chris01-byte/HomeMy/hardware/power-management-unit/REV_A_ASSUMPTIONS.md

# PMU Revision A assumptions and adjustable settings

`rev_a_engineering_prototype: true`  
`rev_b_production: false`  
Date: 2026-09-10. Values below are prototype choices and analytical limits. No assembled-board measurements, completed CAD checks or unrestricted power rating are asserted.

[requirements.yaml](requirements.yaml) controls scope and status. [Traceability](REQUIREMENTS_TRACEABILITY.md) maps all IDs; [bring-up](DESIGN_REVIEW_AND_BRINGUP.md) separates initial low-energy fixtures from later tests; [Revision-B validation](REV_B_VALIDATION.md) identifies production decisions. Numerical details and primary sources remain in the [power](rev-a/design/POWER_STAGE.md), [wake](rev-a/design/WAKE_IO.md) and [chopper](rev-a/design/CHOPPER_MECHANICS.md) design records.

## Settings, adjustment and probe access

| ID / requirements | Initial choice and explicit limitation | Adjustment / probe access / follow-up |
| --- | --- | --- |
| A01 — BAT-001/002, SW-001 | Source contract 27.5–42 V, 50 A maximum continuous; 45 A normal software ceiling. Advertised 150 A/1–3 s is a survival case. Initial main fixture is ≤1 A, 20–30 °C, ≤42 V and ≤100 µF directly switched SYS capacitance, motion OFF. | Probe BATT_SENSED_P, SYS_BUS_P and both true Kelvin pairs. Raise limits only after lower-energy captures are reviewed; B01/B07. |
| A02 — MAIN-003 | Main UV is native **fast** protection, not the requested provisional 0.5 s UV delay. Falling 29.03 V nominal, 27.97–30.41 V calculation; rising 31.67 V nominal, 30.71–33.42 V. New button action still required. | Replace U1 UV divider values only after recalculating reference/leakage corners; probe MAIN_FAULT_N, AON_WAKE_EN and SYS_BUS_P. Add precision/timed UV circuitry in a later revision if the complete requested interval/delay is necessary. |
| A03 — MAIN-003, MOT-001 | Main OV is 44.52 V nominal, 43.17–46.98 V calculated, **not guaranteed 44–45 V**. Motion native OV is unused because it auto-recovers; independent chopper ~46 V comparator latches motion. U5 independent SYS UV uses 226 kΩ / 10 kΩ: 29.311 V nominal and 27.891–30.734 V static engineering envelope. It captures sustained SYS dips missed by native fault flags. | Replace voltage-divider resistors and retest edges. Probe MAIN_FAULT_N, MOTION_FLT_N, CHOP_FAULT_N and motion latch Q. U5 shallow/short pulse capture needs measurement; no universal pulse-width guarantee is claimed. |
| A04 — MAIN-003, MOT-004 | Main OC 65.09 A nominal equation has no justified guaranteed error interval; its 32.5 mV shunt level exceeds the published 6–30 mV CSA accuracy table. Motion OC 59.95 A, 57.13–64.41 A calculation. Main/motion SCP ~120/~100 A with broad corners. Two 33 µF film timers with 100 kΩ latch resistors give FLT-controlled disconnect windows 0.330–0.769 s main and 0.350–0.675 s motion, conditional on 0–60 °C and ≤1 µA combined leakage. | Replace programming resistors/film capacitors; never infer long delay by linear scaling a short example. Probe both TMR pins and controller FLTs. Verify leakage, actual delays and overlap before load escalation; B07. |
| A05 — MAIN-002, MOT-002, TOP-004 | Q1–Q10 PSMN1R0-100ASFJ hot table requires 10 V gate. Main DGATE can be only 9.2 V; 3.2 mΩ/die is a sizing assumption, not a manufacturer maximum. **Final initial motion R34 is 180 kΩ**, superseding 10 kΩ and the interim 100 kΩ; each motion gate bleed is 10 MΩ. Gate-charge slew arithmetic is not a guaranteed inrush bound. | R34 is replaceable; lower resistance requires fresh current/SOA analysis, not an assumed benefit. Probe PU, gate-to-source, BST−SRC, VDS and shunt current. D3 must disposition hot-drive proof; B01 determines final slew/no-precharge decision. |
| A06 — CHOP-002 | Two RH10010R00FE01 on separate 305 × 305 × 3.2 mm aluminum plates; 5 Ω bank. Manufacturer five-times-power/five-second overload evidence supports a bounded cold starting case, not a repetitive braking curve. After lower-energy stages pass, maximum initial test is **500 J total**, ≥60 s between pulses and both cases <40 °C before each pulse. | Integrate measured resistor voltage × current; monitor both cases and analog sensor. Increase energy/duty only with new thermal/pulse evidence; B03. The 8.6 A/370 W value at 43 V is instantaneous. |
| A07 — CHOP-003/004 | Analog 43.000 V on / 42.402 V off; independent 46.000 V motion fault. Corner ranges are 42.683–43.316, 42.072–42.733 and 45.663–46.339 V. Analog NTC trips near 84 °C with ~±4 °C electrical uncertainty plus mounting lag; open/short faults. Local board limit 70 °C; reference qualification 12–28 ms. | Replace R303 initially 1.40 kΩ within reviewed 0–3 kΩ range; feedback R305/R306/R331 initially 2.69 MΩ within 2.32–3.01 MΩ; R308 OV correction. Probe CHOP_GATE, CHOP_NTC, CHOP_FAULT_N/ACTIVE_N. Recalculate correlated hysteresis after each change. |
| A08 — CHOP-002/003, TOP-004 | C312/C313 each EKYC101ELL471MK35S, 470 µF/100 V; **940 µF populated**, initial tolerance 752–1128 µF. At 42 V, 0.829 J nominal / 0.995 J maximum stored energy. Minimum-C/minimum-hysteresis model gives ~5.36 kHz, not an imposed frequency limit. Each capacitor's 2.805 A rating after 1 kHz factor exceeds the modeled balanced 2.323 A share; real sharing/ESR remain unknown. | Do not include this bulk in the ≤100 µF main fixture: keep motion OFF. Charge the isolated motion bus from a separate current-limited fixture for first analog tests. Measure capacitance, ripple, ESR, frequency and motion inrush before joined testing. R332 22 kΩ bleed predicts ≤53.35 s from 42 to 5 V initially; always measure residual voltage. |
| A09 — PC-001/004, LOGIC-002, LIFT-003 | Exact external PC, 5 V and lift converters remain unspecified. PMU interfaces: J9 PC input, J10 logic input, J11 **regulated 5 V output back to board**, J8 lift input, J13 DNP 24 V output sample. PC planned 12 V/claimed 8–55 V input; logic 5 V/≥5 A; lift preferred 20–60 V to 24 V, 10 A label target but 4–5 A output planned. | Mechanically label and verify the actual module's terminals, polarity, voltage and isolation before connection. J8 expected input current is not its 24 V output current. Require local module documentation/bench records; B04/B05. A vendor label is not a datasheet proof. |
| A10 — PC-003, LOGIC-001 | U3 2.980 A nominal ILIM (6.04 kΩ), U4 1.980 A (9.09 kΩ), latch-off MODE, 22 nF slew. Conservative ±10% sizing envelope, but TPS26631 overload pulses can approach twice ILIM. No precise 65 W or rigid 3 A clamp is claimed. | Adjust ILIM and dVdT only after converter/harness captures. Probe PC_BUCK_IN_P and LOGIC_BUCK_IN_P with input current. Verify 65 W separately in Linux/BIOS; B05/B09. |
| A11 — CTRL-002/003 | AON nominal 3.343 V, modeled 3.193–3.499 V. 0.60 mA AON allowance is not measured OFF current. ONT ~174 ms; fixed startup grant 4.80–5.27 s model, firmware hold by 4.7 s / no-hold off by 5.4 s. Long press ~6.48 s nominal, provisional measured acceptance 4.1–9.5 s. Main FLT mask ~1–5.5 ms; native protection remains active. | Replace ONT/PDT/SET parts and repeat full button/state matrix. Probe PB, WAKE_RAW_EN, STARTUP_GRANT, WAKE_KILL, AON_WAKE_EN, SW_RESET_N. Capacitor effective value and propagation races require measurement; B10. |
| A12 — PCB-001/002/004 | Bench outline 360 × 300 mm; H1–H4 at (8, 8), (352, 8), (292, 292), (8, 292) mm, with H3 moved away from the antenna. Final CAD controls coordinates. Minimum finished copper is 70/35/35/70 µm; finished board thickness is 1.60–1.70 mm between outer copper faces, excluding masks. Exact 2 mm Cu-ETP BB1–BB7 contours, 15 BC contacts, NB1–NB8 star bridges and insulation/clamp stack are defined in [the mechanical interface](rev-a/manufacturing/busbar-pcb-interface.json) and [build drawing](rev-a/manufacturing/MECHANICAL_BUILD.md), superseding the generic 15 × 2 mm / ≤100 mm segment assumption. BB7 spans 348 mm with cutouts. | D4 compares actual layout, holes, bar contours and stackup. Split copper at shunts, opposing FET banks and bus boundaries. [via-field-counts.json](rev-a/design/via-field-counts.json) controls the generated field counts; the [filled-copper review](rev-a/evidence/filled-power-copper-review.md) uses those counts for ideal parallel-barrel calculations. Neither field totals nor the earlier 160-via example establish sharing at a local transfer. Local necks, hole constrictions, sharing, clamp coupons, temperature and resistance still require their defined acceptance; bar resistance alone does not rate the board. Final enclosure, airflow and guards remain B12. |
| A13 — PCB-003/005/006 | Würth 7461103 right-angle M5 threaded terminals for battery/arms: body 14 mm above PCB, with horizontal M5 screw/lug access. Battery 6 mm², arms 4 mm²; 25 A per arm planning envelope. Chopper J12 uses 12 A Phoenix 1776508/1777989 and 1.5 mm² wire. Bulk capacitors reach 36.5 mm maximum and film timers 24 mm. Reserve at least 42 mm from PCB top to the provisional cover and keep capacitor vents clear. | Fabricator must qualify press-fit holes/plating; use the approved insertion method, ≤2.2 Nm tightening and covers. Exact ring lugs/crimps, strain relief and final mating/keying remain assembly review. Measure terminal/wire temperatures; B06/B12. |
| A14 — CTRL-005 | J22 commissioning input is 3.3 V logic or a deenergized-open relay contact between pins 1/2, ground pin 3. Open/low/unpowered clears motion. It is a single-channel prototype permission, not an accepted final emergency stop. J20/J22 pin-header prototype connectors require retained, labelled bench harnesses. | Do not apply 24 V or fit a permanent bypass jumper for actuator operation. Probe MOTION_PERMIT and MOTION_CLEAR_N. Final fail-safe/stop architecture B14; reachable disconnect remains mandatory for authorized actuator tests. |
| A15 — CTRL-001, LOGIC-002 | U10 ESP32-S3-WROOM-1-N8; UART through U65, no supply pin. U12 3.3 V LDO: 0.5 A allowance dissipates ~0.85 W and ~53.5 °C reference-board rise. 1 A IC rating is not an assembled continuous rating. | J11 supply 4.75–5.25 V; maximum recommended LDO input 5.5 V. Measure regulator/module voltage and temperature; update copper/architecture if insufficient. |
| A16 — SW-001/002/003, CTRL-004 | Current/voltage policy remains as requirements; Linux boot deadline 120 s, shutdown grace 90 s, heartbeat 100 ms / stale 500 ms are suggested firmware parameters. TPS3431 independently removes motion on absent ESP feed in 1.36–1.84 s. LED patterns follow lifecycle contract. | These are interface settings, not deployed firmware. Feed watchdog only from supervised main loop after valid heartbeat. T7/B09 fault-injection and versioned configuration; retain development boot-target rollback. |
| A17 — MON-003/004 | INA ±163.84 mV, independent 10 Ω filters. ADC voltage divider full loaded gain 1/23; motion IMON complete-network sensitivity ~10.465 mV/A. NTC beta approximation is not high-temperature calibration. | Probe Kelvin and ADC nets; calibrate voltage/current/temperature with final loading. Shared-shunt failure independence requires D3 review, not just zero ERC errors; B02. |
| A18 — COM-001/002/003 | 1 Mbit/s classical CAN, two ends only. Local split 120.8 Ω termination DNP unless PMU is an end. TCAN1042HGVDRQ1 plus 24 V ESD TVS; continuous 42 V miswire survival is not claimed. Analytic traffic estimate does not prove ≤50% bus use. | Populate both 60.4 Ω halves and midpoint capacitor together only at an end. Measure errors, utilization, unpowered bus leakage and shield behavior; B11. |
| A19 — LOGIC-003, CHOP-005 | LED 330 Ω data / 1000 µF, 10 V bulk; no brightness-based protection. Local 24 V lift clamp remains DNP. | Full physical LED load test and 24 V lift overshoot measurement determine changes; B04/B05. |
| A20 — BAT-004 and transient coordination | External fuse/BMS curves, exact pack impedance and installed wiring inductance are not established. TVS selection uses manufacturer pulse values plus a provisional wiring model; the model does not certify all transients. | E0 before battery; B07/B08 selectivity/interrupt/transient evidence. Do not use avalanche or TVS as routine braking-energy disposal. |

## Review disposition

The configurable deviations concern provisional values, not authorization to alter locked topology. All unknown manufacturer guarantees remain explicitly unknown: main hot resistance at 9.2 V, full installed-capacitance hot SOA, shared-sense failure independence, capacitor effective/ripple sharing and repetitive resistor duty need review or evidence appropriate to the intended test. A bounded measurement fixture can proceed only within its reviewed envelope; its success does not authorize the whole battery system.

No real hardware order, assembly, battery connection or actuator test is performed by these documents. CAD completion and its own ERC/DRC reports are separate deliverables.
