chris01-byte/HomeMy/hardware/power-management-unit/rev-a/evidence/filled-power-copper-review.md

# Filled power copper review — Rev A engineering prototype

This is a read-only review of the actual saved native KiCad board, including the effects of signal routing on the filled copper. It does **not** establish a 50 A continuous rating, a 60 A pulse rating, thermal qualification or manufacturing release.

- Input PCB SHA-256: `70bb8eb588f2fc7200f718df0e11659aad3c40c7e9d5652228eb7a58d232065f`.
- PCB unchanged during the native geometry analysis: `True`.
- Evidence: `filled-power-copper-review.json`, `filled-power-polygons.json` and the PNG views generated by `render_power_review.py`.
- Reproduction: run `review_filled_power.py` with the bundled KiCad Python through `scripts/run_tool.py`, then run `render_power_review.py` and `write_power_review.py` with the workspace Python. The native script does not refill or save the PCB.

## Method and limits

The measurement unions saved filled polygons with actual same-net pad, via and track copper on each layer. It removes circular drill interiors and samples defined transects at no more than 0.02 mm intervals. Outer layers use the specified 70 µm copper; inner layers use 35 µm. Width sums can contain several separate intervals around holes and are **not** global minimum cuts. A cross-section with copper does not prove end-to-end continuity: this was demonstrated by the isolated RSH2 force-pad island found in the first routed board.

Native per-layer connection flags record local contact with copper. They do not independently prove connection to the whole net. In addition, the JSON checks whether selected endpoint pads share the same continuous copper outline on a layer. The current snapshot has 18 successful checks out of 18 tested paths. External busbars, clamp contacts, component internal conductors and the resistance of footprint net-tie bridges are not incorporated into this polygon resistance model. No finite-element current-density or thermal solution was performed.

## Measured paths

All 48 pressfit pads on J1–J6 contact copper on both outer layers in the inspected snapshot. These are solid zone connections; there is no four-spoke thermal connection credited for their current path. This verifies local PCB attachment of all eight pins per terminal. It does not replace the manufacturer's bore, plating, pressfit-force or tightening requirements.

| Transect | Board coordinates, mm | F.Cu total width, mm | B.Cu total width, mm |
|---|---|---:|---:|
| RSH1 input approach | [22, 42.9] → [22, 49] | 6.10 | 6.10 |
| RSH1 output approach | [35.5, 42.9] → [35.5, 49] | 6.10 | 6.10 |
| RSH2 input approach | [112, 42.9] → [112, 49] | 6.10 | 6.10 |
| RSH2 output approach | [126, 42.9] → [126, 49] | 6.10 | 6.10 |
| Arm positive top rail | [260, 10] → [260, 34] | 13.00 | 13.00 |
| Right positive rail at junction | [330, 17] → [330, 23] | 6.00 | 6.00 |
| Star crossed by SYS feed | [110, 108] → [110, 134] | 0.00 | 24.00 |
| Left arm return approaching NT1 | [207, 109] → [207, 132] | 12.50 | 12.50 |
| Right arm return approaching NT2 | [237, 109] → [237, 132] | 12.50 | 12.50 |
| Q40 source below bank | [290, 40] → [302, 40] | 5.00 | 8.00 |
| Q40 drain exit | [311, 29] → [311, 41] | 11.28 | 0.00 |
| Chopper drain connector neck | [345, 27] → [345, 33] | 3.00 | 0.00 |

The scan endpoints deliberately limit several widths, so a full-width result is a lower bound within that window. The two arm-return samples are 12.5 mm rather than the earlier generic 20 mm strip assumption. At 100 °C, a hypothetical 20 mm long, 12.5 mm wide pair of 70 µm copper strips would have approximately 259 µΩ resistance and dissipate 0.162 W at 25 A. That strip calculation omits the diagonal taper, holes and spreading resistance. Actual arm paths must be checked by four-wire voltage drop and temperature in the assembled board.

RSH1 and RSH2 are SMD four-terminal shunts: force pads 1 and 4 touch F.Cu; Kelvin pads 2 and 3 have separate sense nets. A wide B.Cu polygon beneath a shunt pad is not a direct second pad connection. Current must first spread in F.Cu to plated transfers. Preserve the force/sense separation at the component and include local force-pad heating in qualification. Q1–Q10 likewise enter their source and drain lands from F.Cu only. The JSON samples every source and drain bank when regenerated with the current script; bank width alone does not prove equal current sharing among the five source leads or among parallel MOSFETs.

At x = 110 mm the SYS feed completely interrupts BATT_N on F.Cu. B.Cu remains 24 mm wide there. Near J4/J6 the return copper splits around the arm-return regions and holes. The complete design therefore uses the specified BB7 bar and NB branch bridges with the documented contact shims, film and spring clamps. It must not be assessed as a uniform pair of unbroken 24 mm outer-layer strips. The local 10 × 10 mm PTH star lands and top net-tie bridges are genuine power attachment points; signal net ties NT9/NT10 are not substitutes for them.

Q40's source joins the local CHOPPER_N F.Cu area, transfers through **10 observed 0.4 mm vias** to B.Cu, and reaches the capacitor-negative trunk and the return spine. C312/C313 negative pins contact the B.Cu trunk. The approximately 9.3 A worst initial chopper-bank current gives an ideal local-array loss of 0.0100 W at 100 °C, before spreading and unequal sharing. The B.Cu return is 8 mm wide, and the sampled F.Cu drain exit is 11.28 mm wide; the drain narrows to 3 mm at J12. These geometries do not establish loop inductance, switching overshoot or closed-loop stability. Record Q40 VDS, gate voltage, bus ripple and resistor energy during staged pulse commissioning. NT10 must preserve the short source reference connection without carrying resistor current.

Connected F.Cu copper associated with Q40's drain measures **689.22 mm² (6.892 cm²)** after removing holes. The 600 mm² prototype target is geometrically met: **True**. The first routed snapshot had approximately 452 mm² and the CAD owner enlarged the pour to address that mismatch. Infineon's published 40 K/W value belongs to its separate 40 × 40 × 1.5 mm vertical still-air test board with one 70 µm, 6 cm² drain-copper layer; it is not automatically transferable to this assembly. See `chopper/ipt015n10n5-primary-source.json`.

DRIVE_N uses an 8 mm F.Cu corridor. LIFT_N uses an 8 mm corridor on each inner layer, with 3 mm terminal approaches. The first routed snapshot severed inner LIFT_N pours with signal traces; protected centerline paths and rerouting were requested. Both inner endpoint paths are restored in the current geometric check: **True**. The lower V5V and LOGIC_5V_N samples retain broad B.Cu paths, and the LED return reaches its dedicated power star rather than NT9.

## Actual via-field arithmetic

The authoritative counts are copied from `design/via-field-counts.json`, not from the earlier 160-via example. Use finished hole diameter d = 0.4 mm, minimum plating t = 0.025 mm, barrel length L = 1.6 mm and rho20 = 1.724 × 10⁻⁸ Ω·m with temperature coefficient 0.00393/K. The thin-wall conservative expression is `R = rho(T) × L / (N × pi × d × t)`. One such barrel is approximately 878 µΩ at 20 °C or 1154 µΩ at 100 °C.

Each table cell gives **20 °C / 100 °C** values. The 50 A and 60 A columns apply that entire current to an ideal parallel field solely for arithmetic comparison.

| Net field | Count | R, µΩ | Loss at 50 A, W | Loss at 60 A, W |
|---|---:|---:|---:|---:|
| BATT_SENSED_P | 116 | 7.569 / 9.949 | 0.0189 / 0.0249 | 0.0272 / 0.0358 |
| MAIN_COMMON | 104 | 8.443 / 11.097 | 0.0211 / 0.0277 | 0.0304 / 0.0399 |
| SYS_BUS_P | 189 | 4.646 / 6.106 | 0.0116 / 0.0153 | 0.0167 / 0.0220 |
| MOTION_SENSED_P | 148 | 5.933 / 7.798 | 0.0148 / 0.0195 | 0.0214 / 0.0281 |
| MOTION_COMMON | 117 | 7.504 / 9.864 | 0.0188 / 0.0247 | 0.0270 / 0.0355 |
| MOTION_BUS_P | 215 | 4.084 / 5.368 | 0.0102 / 0.0134 | 0.0147 / 0.0193 |
| BATT_N | 723 | 1.214 / 1.596 | 0.0030 / 0.0040 | 0.0044 / 0.0057 |

The smallest main positive/common field is 104 vias. These low ideal totals do not prove that all barrels participate near one SMD force pad. Contact and spreading resistance can dominate; a single nearest via can carry disproportionate current. A 1.70 mm finished board would increase barrel resistance and these losses by 6.25% with the other assumptions unchanged. Plating coupons, local thermal imaging and four-wire voltage measurements remain release gates.

## Findings and report status

The first routed board, SHA-256 `a5fda347cb9910f0fb1f6774115fe7ddc8b8b0febc5a2a40d5e64ee023662d6b`, contained an isolated RSH2.4 F.Cu force-pad island. Its x = 126 mm sample still showed 3.29 mm of copper, illustrating why width alone was misleading. This was reported to the CAD owner, who protected the force link and the LIFT_N corridors. RSH2.4 and the Q7 drain now share one continuous F.Cu outline: **True**. The endpoint checks and cross-sections must be refreshed after subsequent routing changes.

Observed `reports/drc-final.json` at `2026-09-10T20:15:43` contains 0 geometric entries, 0 unconnected entries and 0 parity entries. Its SHA-256 is `47e6f417dffc642f963677115169a3e8a9aa61b2465ca48b8aff4c284a52e4e1`.

Matching process manifest: `reports/native-checks-both.json`; its recorded board hash matches this review: **True**. Process exit code: **124**; process passed: **False**; JSON report complete: **True**.

A complete JSON report and a clean process exit are separate results. The filename alone is not a release declaration. This reviewer did not run ERC/DRC or modify the board. Final native checks, the resolved geometry review, mechanical coupon acceptance and current/temperature qualification are distinct requirements.
