chris01-byte/HomeMy/hardware/power-management-unit/rev-a/design/CHOPPER_PROCUREMENT.md

# Chopper and connector procurement review

Checked 2026-09-10. These are manufacturer lifecycle observations and substitution constraints, not stock reservations. `supplier_stock_verified: false` applies to every row below; obtain dated authorized-distributor quotations before ordering. Exact passive order codes were checked against the manufacturer's family coding/range rules, but individual passive stock was not established.

| Reference | Selected manufacturer order code | Manufacturer lifecycle evidence | Compatible candidate / restriction |
| --- | --- | --- | --- |
| U30 | TI TPS7A4001DGNR | Active / Production in current [orderable addendum](https://www.ti.com/lit/ds/symlink/tps7a4001.pdf) | TPS7A4001DGNT is the same silicon/package in a smaller reel; preserve DGN0008B footprint. No second-source silicon qualified. |
| U31 | TI REF5025IDR | Active in [family ordering table](https://www.ti.com/lit/ds/symlink/ref50.pdf) | REF5025ID is the tube-packaged high-grade SOIC part. REF5025AIDR has worse accuracy/drift and invalidates the current corner budget. |
| U32 | TI LM339BIPWR | [Exact part Active](https://www.ti.com/product/LM339B/part-details/LM339BIPWR) | LM2901BIPWR is a candidate after comparing full-temperature offset/bias/low-output bounds. Legacy LM339PW is not substituted without checking lifecycle and bounds. |
| U33 | TI UCC27511DBVR | [Family Active](https://www.ti.com/product/UCC27511) | UCC27511DBVT is the same silicon/smaller reel. UCC27511ADBVR is a newer same-pin candidate; compare UVLO, delay and negative-input protection before substitution. Its [datasheet](https://www.ti.com/lit/ds/symlink/ucc27511a.pdf) permits the10V input level, but the alternate has not been exercised in this prototype. |
| U36 | TI TPS3808G01DBVR | [Exact part Active](https://www.ti.com/product/TPS3808/part-details/TPS3808G01DBVR) | TPS3808G01DBVT is same silicon/package/smaller reel. Fixed-threshold variants do not retain the divider/timing design automatically. |
| Q40 | Infineon IPT015N10N5ATMA1 | [Exact OPN Active and preferred](https://www.infineon.com/part/IPT015N10N5) | No second-source device qualified. Match 100 V rating, hot resistance, total/Miller charge, SOA and logical1G/2S/3D footprint map before substitution. |
| U34/U35 | Vishay VOS618A-3T | Present in [current family ordering data](https://www.vishay.com/docs/83465/vos618a.pdf); exact formal lifecycle flag not established | Other CTR ranks require LED-current, saturation and propagation review. No approved second source. |
| External bank | Vishay RH10010R00FE01, quantity2 | Exact code follows current [RH100 family ordering table](https://www.vishay.com/docs/30201/rhnh.pdf); formal lifecycle flag not established | NH10010R00FE01 is the corresponding non-inductive-family candidate, requiring confirmation of exact availability and pulse/mounting equivalence. A generic100W resistor is not an approved alternate. |
| C312/C313 | Chemi-Con EKYC101ELL471MK35S | [Exact part In Production](https://www.chemi-con.co.jp/en/products/detail-condenser.php?part_number=EKYC101ELL471MK35S) | No alternate qualified. Retain100V, pair minimum752µF initial, adequate ripple at actual frequency, and5mm lead pitch. Do not replace the pair with one generic470µF capacitor. |
| J1–J6 | Würth7461103 | [Current drawing Valid](https://www.we-online.com/components/products/datasheet/7461103.pdf); exact active flag not separately established | Arm-only candidate PhoenixKDSP4/1,1714029, requires a different verified footprint and41A/4mm² derating. Not a ≥70A battery substitute. |
| J7–J15 | Phoenix1776508 / mate1777989 | Current manufacturer product listings; exact lifecycle flag not established | Same-family fixed terminals are not drop-in replacements. Preserve threaded flange, wire range and12A system rating. |
| J18 | Phoenix1776511 / mate1777992 | Current manufacturer product listings; exact lifecycle flag not established | Alternate requires a verified three-pin5.08mm flanged geometry and at least5A harness envelope. |
| J16/J17 | JST BM04B-GHS-TBT(LF)(SN) | Present in [current GH catalogue](https://www.jst-mfg.com/product/pdf/eng/eGH.pdf); formal lifecycle flag not established | Mating GHR-04V-S / SSHL-002T-P0.2. A horizontal header changes the mechanical interface. |

The exact ring lugs, qualified crimp tools, cable insulation, ferrules, strain relief and heat-spreader attachment remain assembly BOM selections. The press-fit terminal requires a qualified board-hole/plating/insertion process. These open items must remain visible in the order review; neither clean CAD checks nor a general supplier name substitutes for their evidence.
