chris01-byte/HomeMy/docs/archive/README.md

# Archive

Move superseded plans, long-form evidence, and historical transfer notes here after their current conclusion is summarized elsewhere.

Archive material remains versioned but is never part of the default agent context. Keep any sensitive raw sensor or home data outside the repository even when archiving a decision.
