chris01-byte/HomeMy/hardware/power-management-unit/rev-a/assembly/main-schematic-review.png

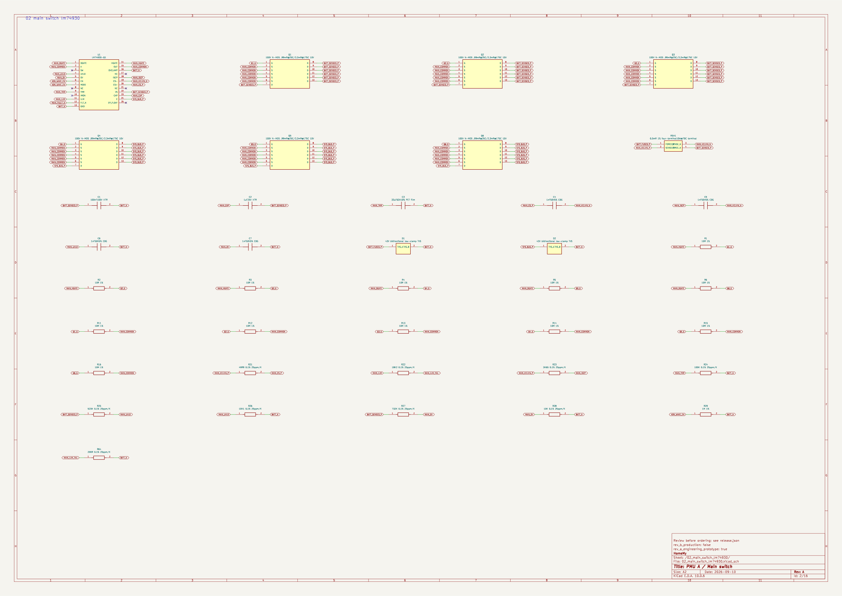
hardware/power-management-unit/rev-a/assembly/main-schematic-review.png
