chris01-byte/HomeMy/hardware/power-management-unit/rev-a/evidence/chopper/kyc-dimensions.png

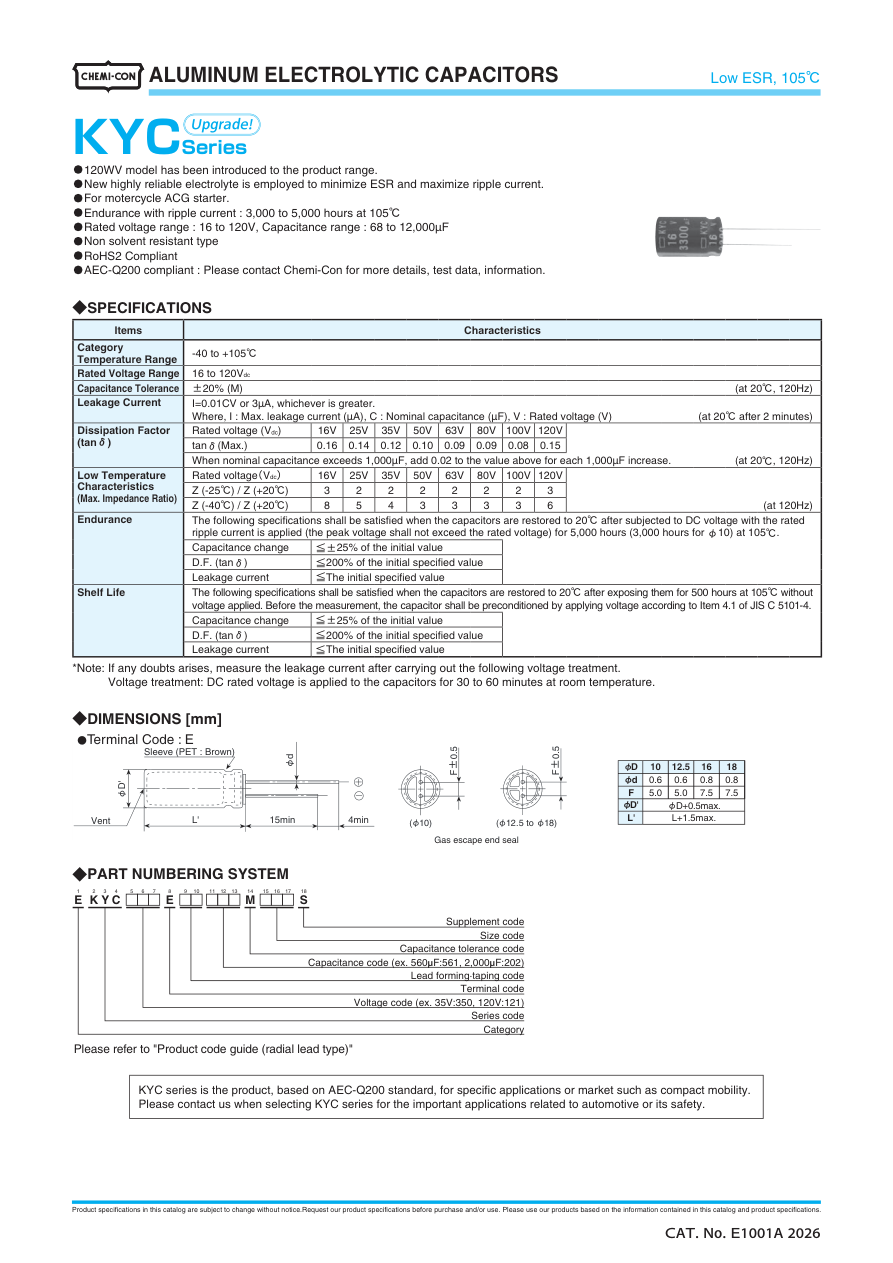
hardware/power-management-unit/rev-a/evidence/chopper/kyc-dimensions.png
