chris01-byte/HomeMy/hardware/power-management-unit/rev-a/evidence/chopper/mbr-pinout-detail.png

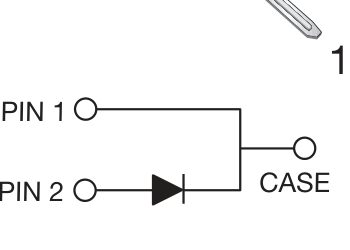
hardware/power-management-unit/rev-a/evidence/chopper/mbr-pinout-detail.png
