chris01-byte/HomeMy/hardware/power-management-unit/rev-a/evidence/chopper/mbr-pinout.png

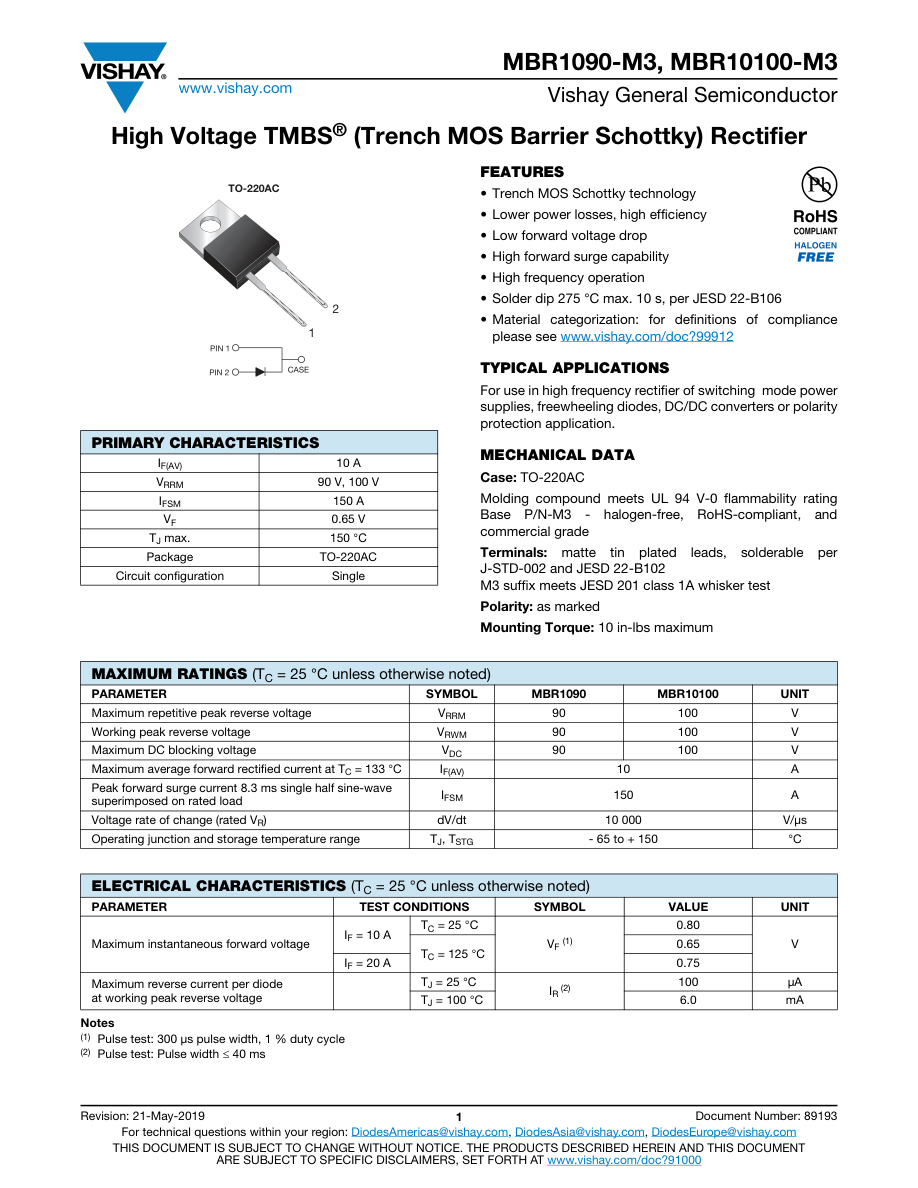
hardware/power-management-unit/rev-a/evidence/chopper/mbr-pinout.png
