chris01-byte/HomeMy/hardware/power-management-unit/rev-a/evidence/chopper/ntc-table.png

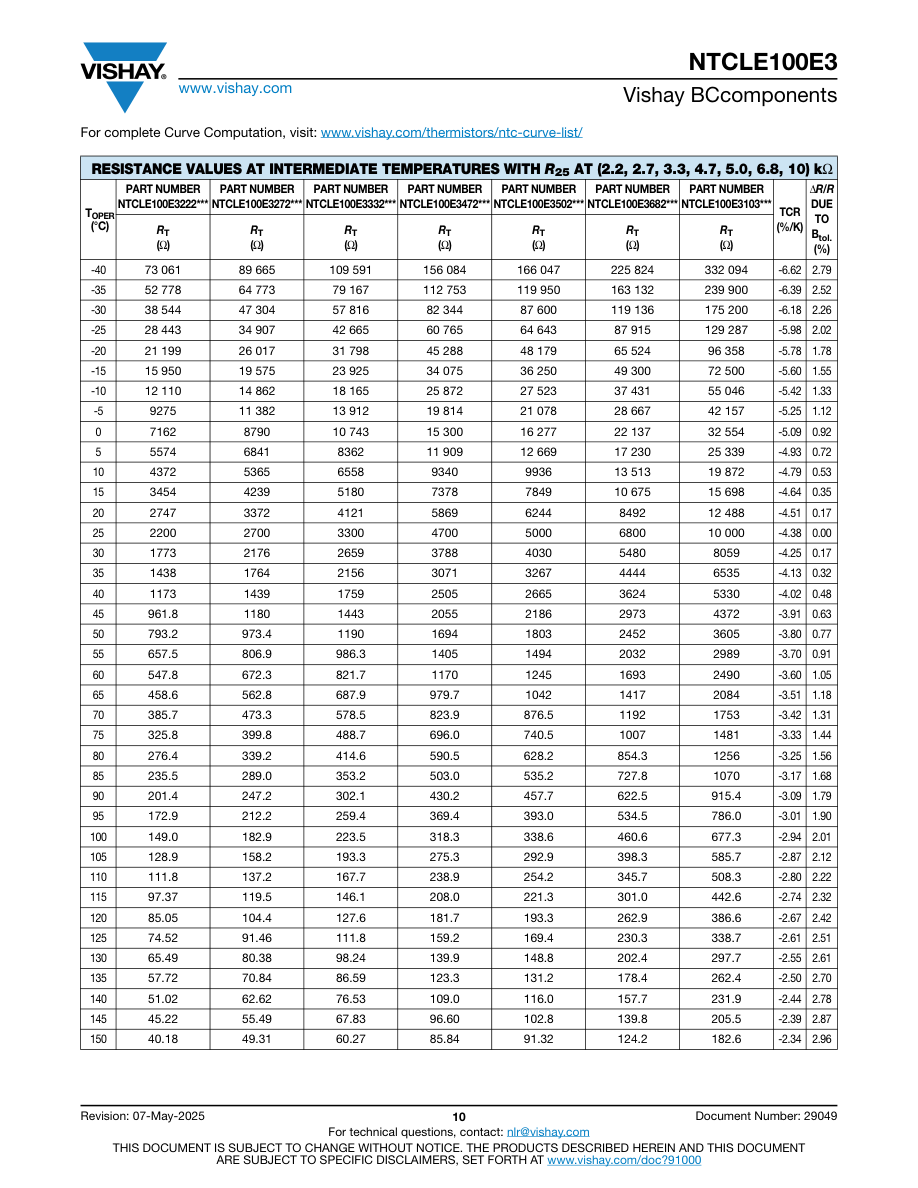
hardware/power-management-unit/rev-a/evidence/chopper/ntc-table.png
