chris01-byte/HomeMy/hardware/power-management-unit/rev-a/evidence/chopper/redcube-drill.png

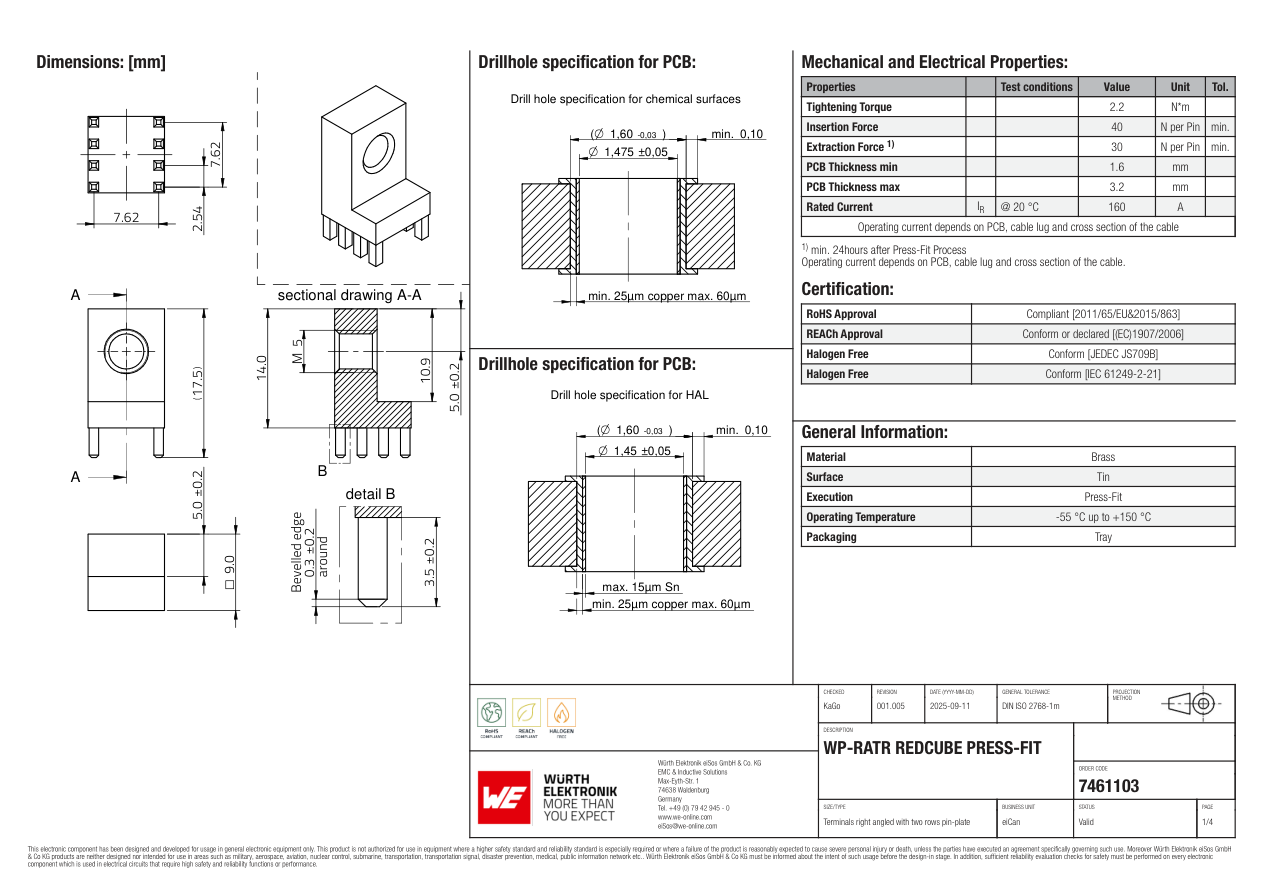
hardware/power-management-unit/rev-a/evidence/chopper/redcube-drill.png
