chris01-byte/HomeMy/hardware/power-management-unit/rev-a/evidence/ina228-land.png

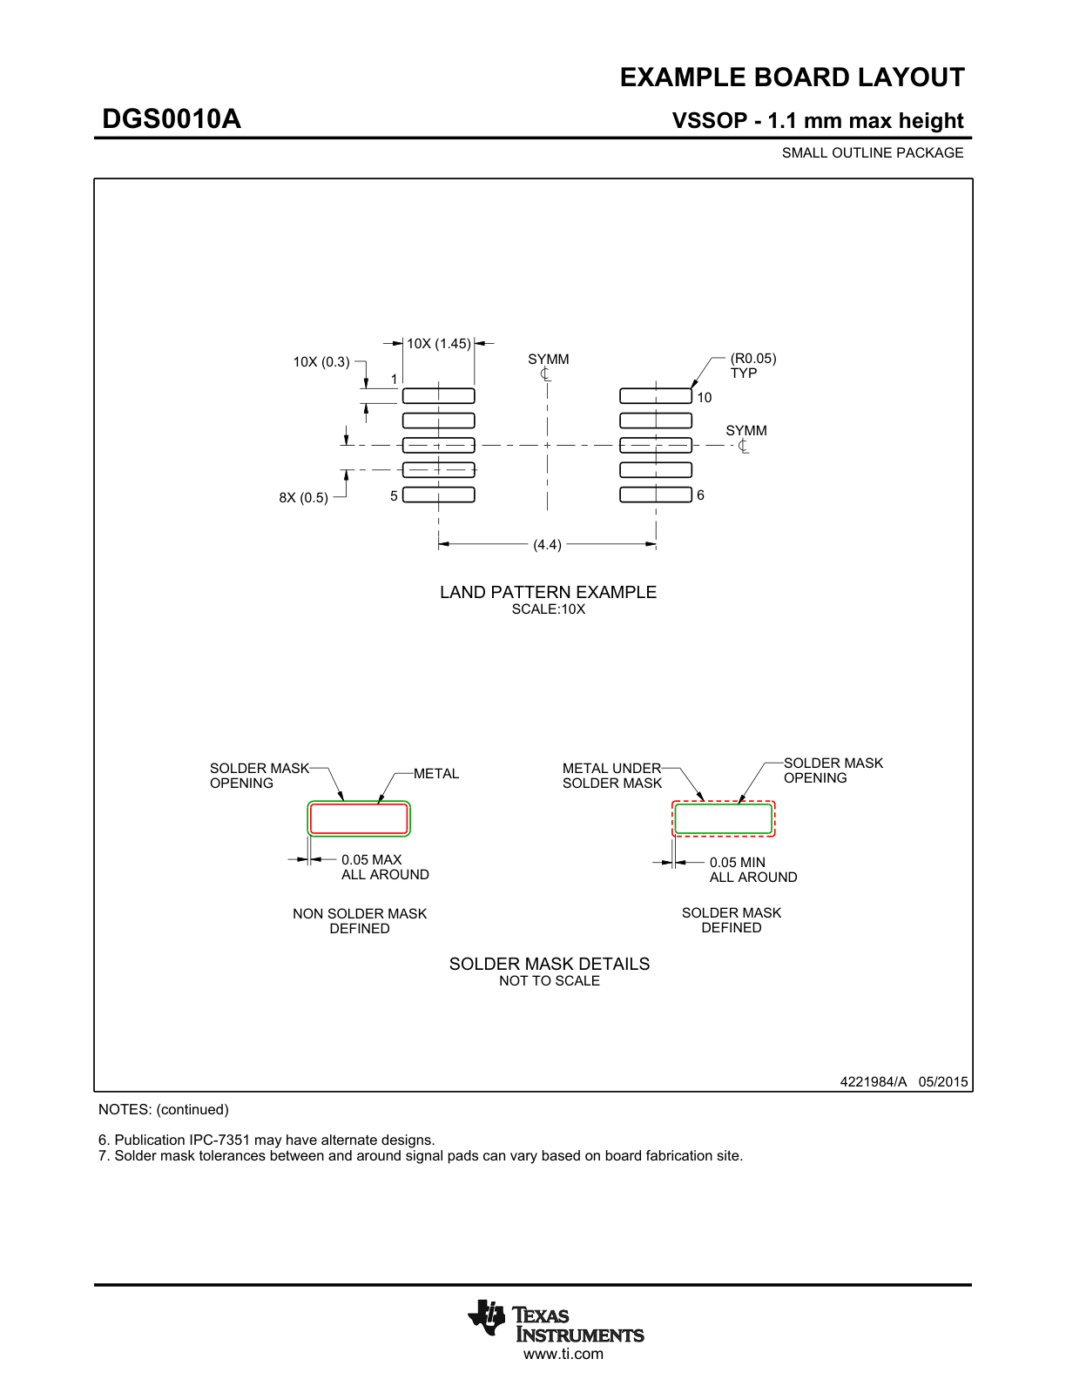
hardware/power-management-unit/rev-a/evidence/ina228-land.png
