chris01-byte/HomeMy/hardware/power-management-unit/rev-a/evidence/power-chopper-review.png

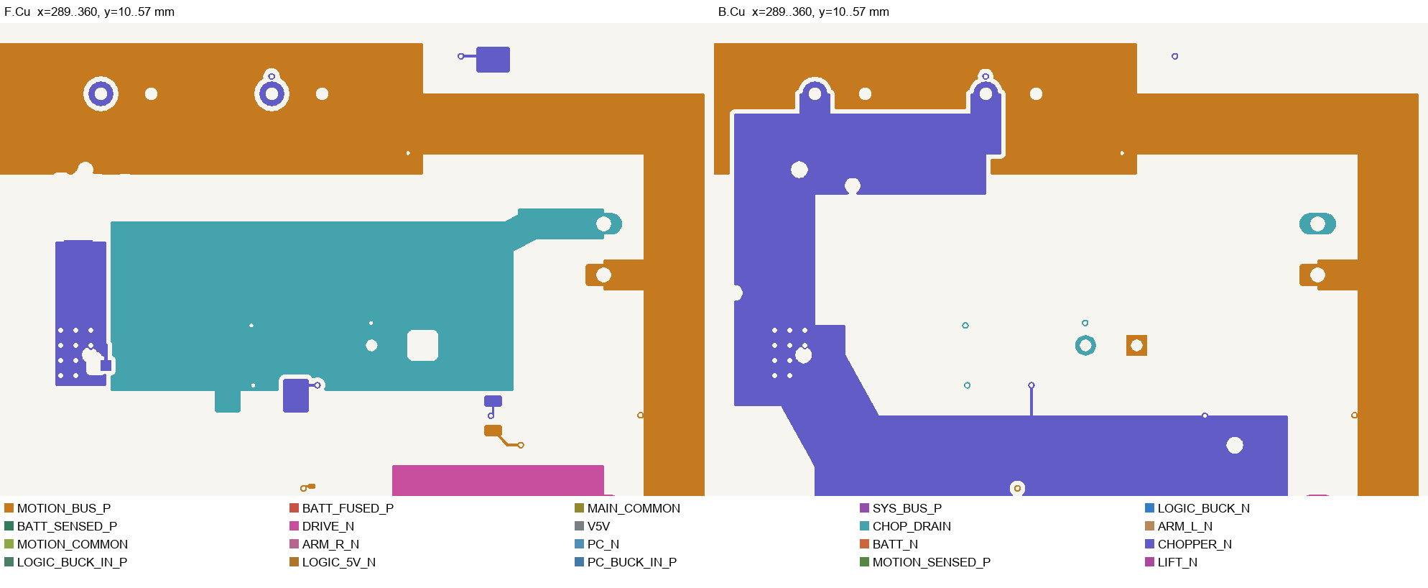
hardware/power-management-unit/rev-a/evidence/power-chopper-review.png
