chris01-byte/HomeMy/hardware/power-management-unit/rev-a/evidence/power-shunt2-review.png

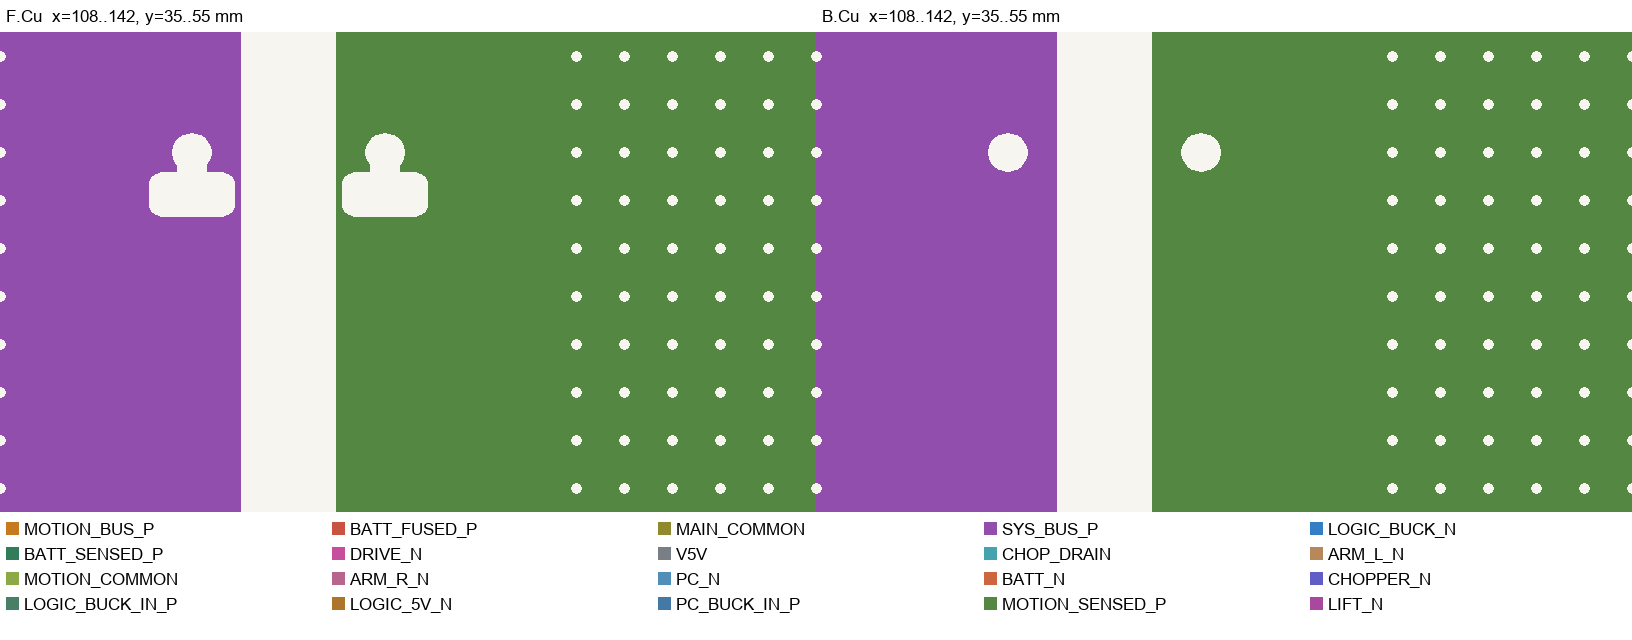
hardware/power-management-unit/rev-a/evidence/power-shunt2-review.png
