chris01-byte/HomeMy/hardware/power-management-unit/rev-a/evidence/power/C1206C475K3RACTU-2.png

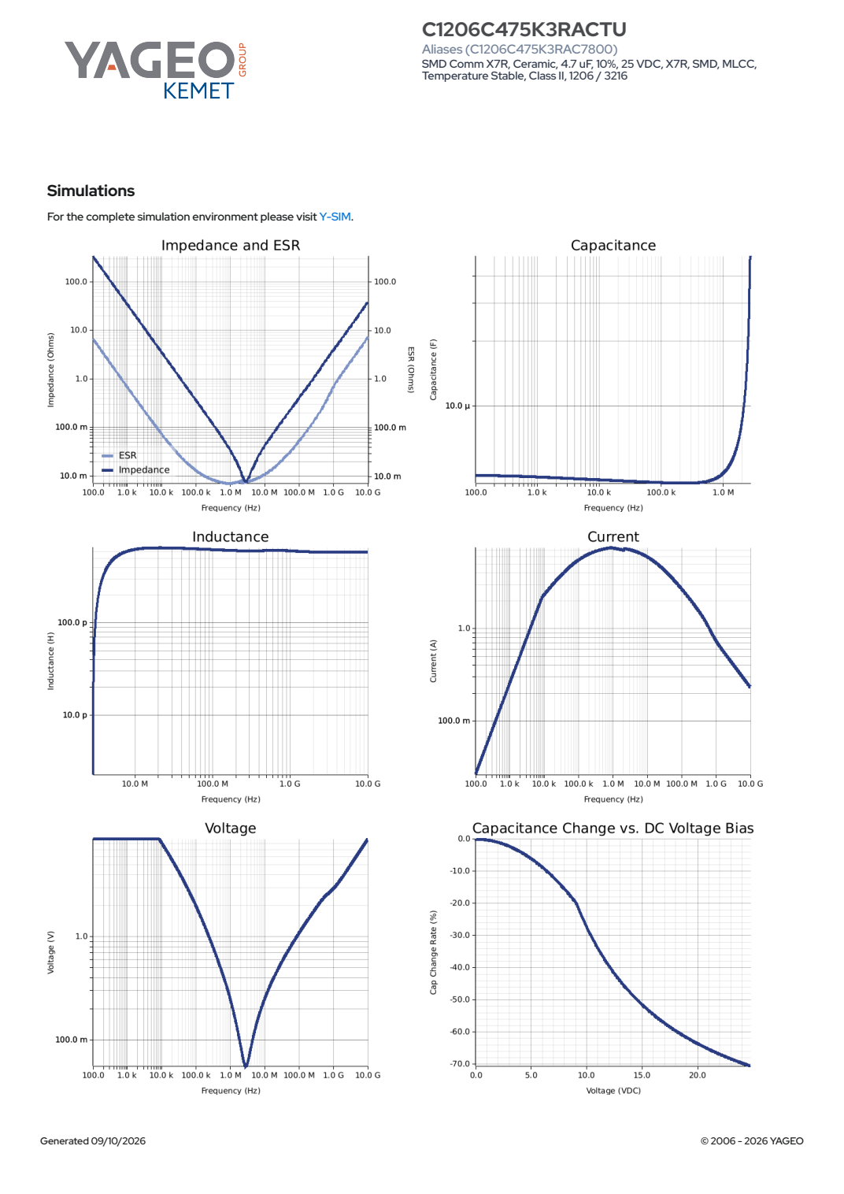
hardware/power-management-unit/rev-a/evidence/power/C1206C475K3RACTU-2.png
