chris01-byte/HomeMy/hardware/power-management-unit/rev-a/evidence/power/css4j-4026-2.png

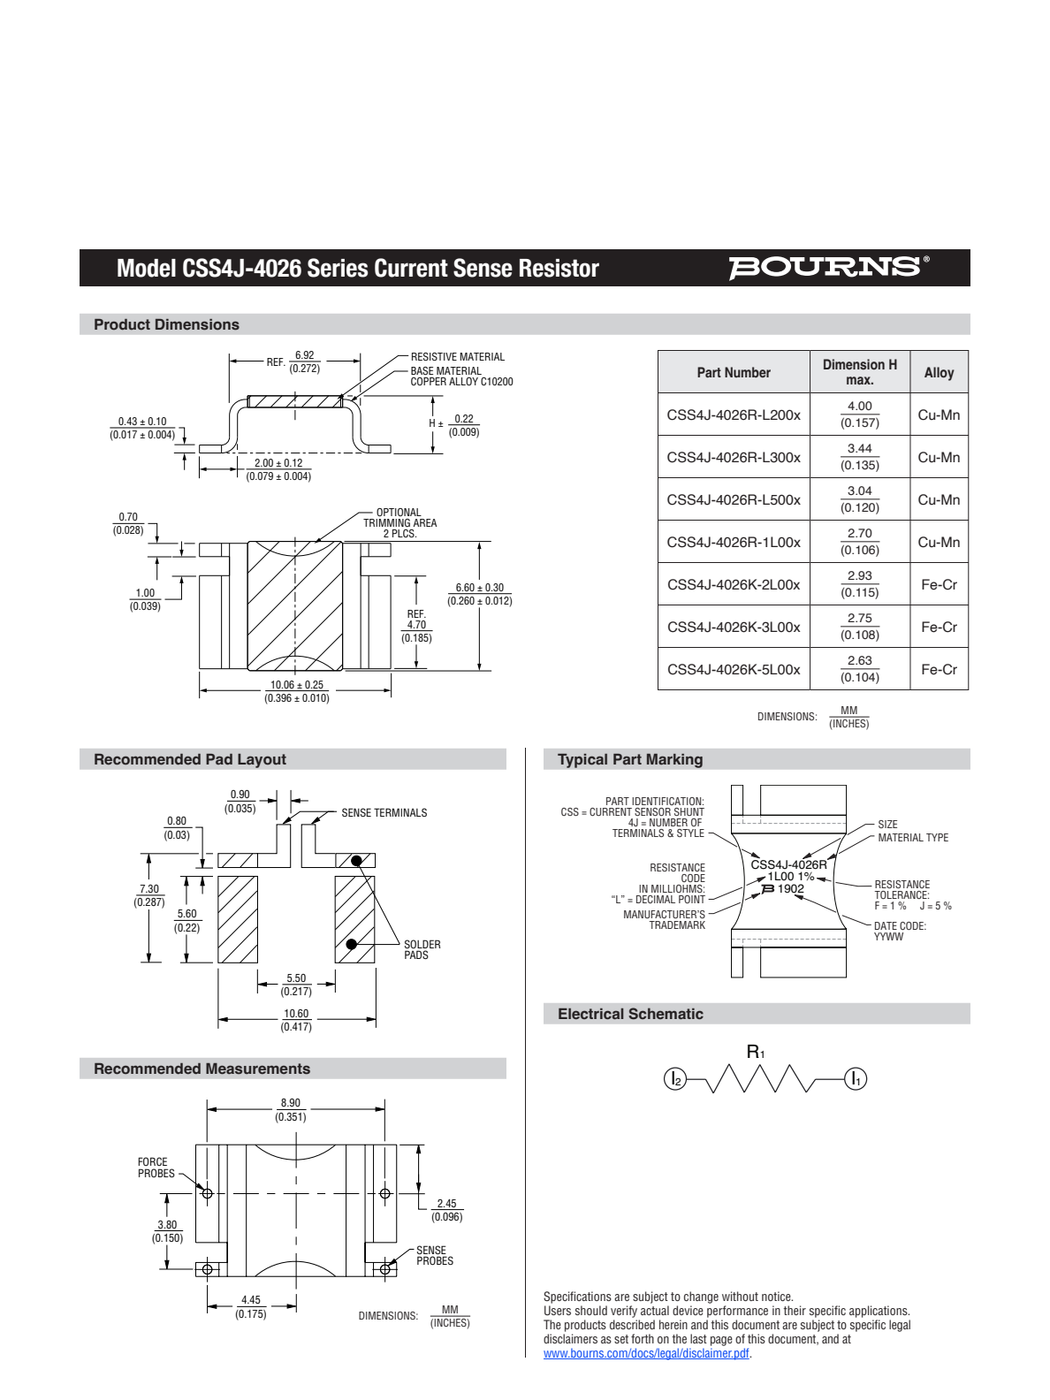
hardware/power-management-unit/rev-a/evidence/power/css4j-4026-2.png
