chris01-byte/HomeMy/hardware/power-management-unit/rev-a/evidence/power/lm74930-block.png

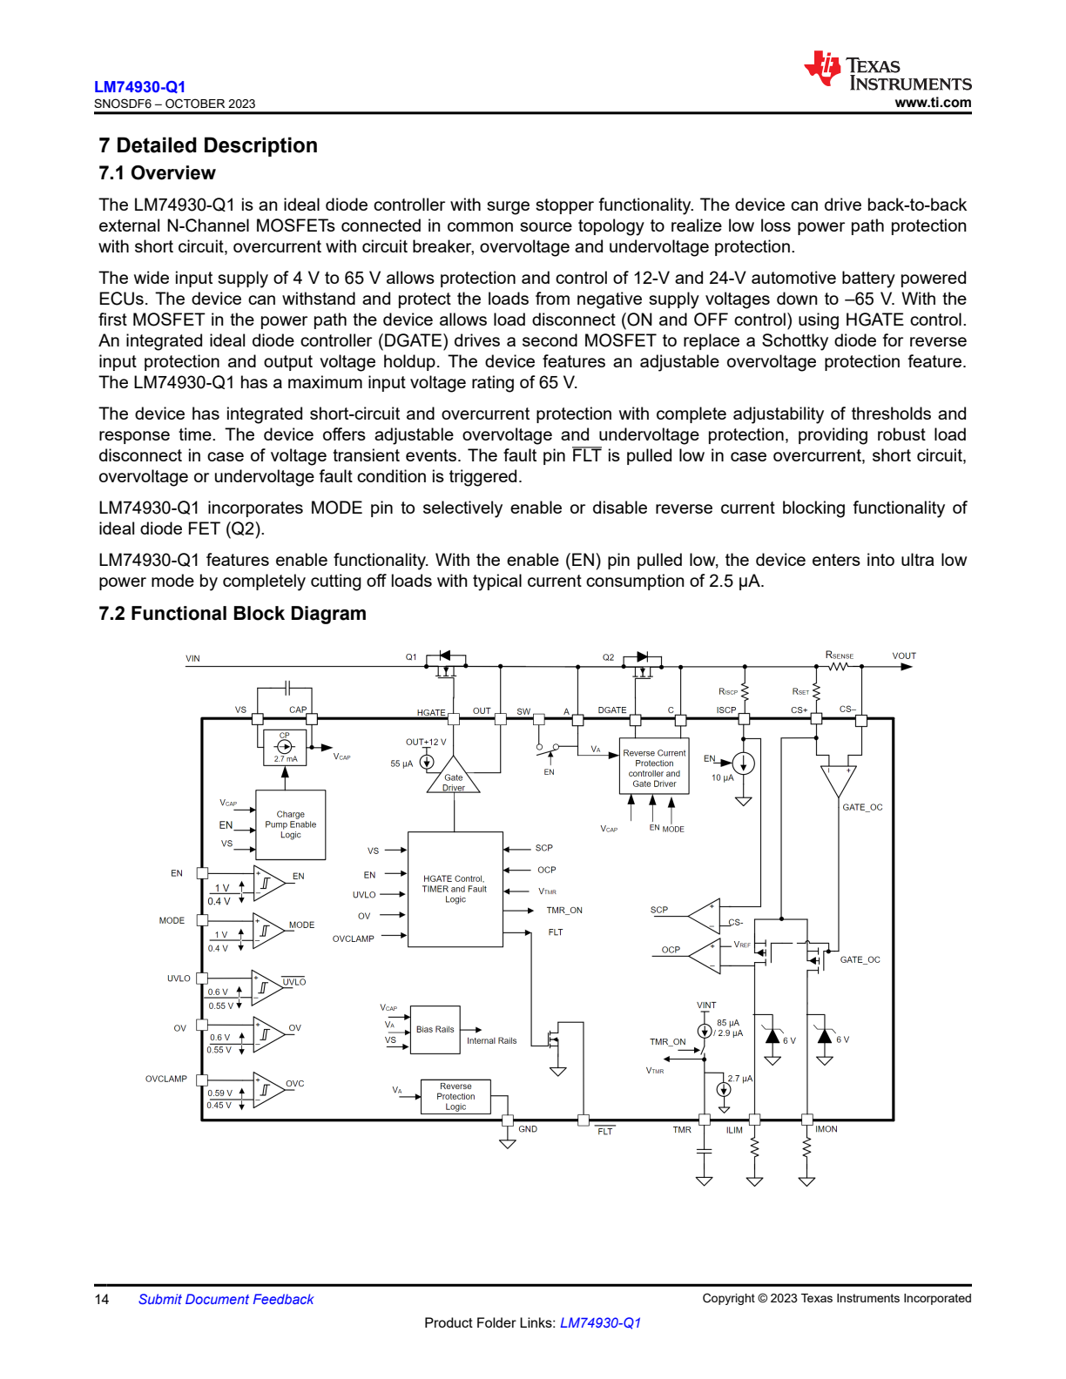
hardware/power-management-unit/rev-a/evidence/power/lm74930-block.png
