chris01-byte/HomeMy/hardware/power-management-unit/rev-a/evidence/power/lm74930-q1-26.png

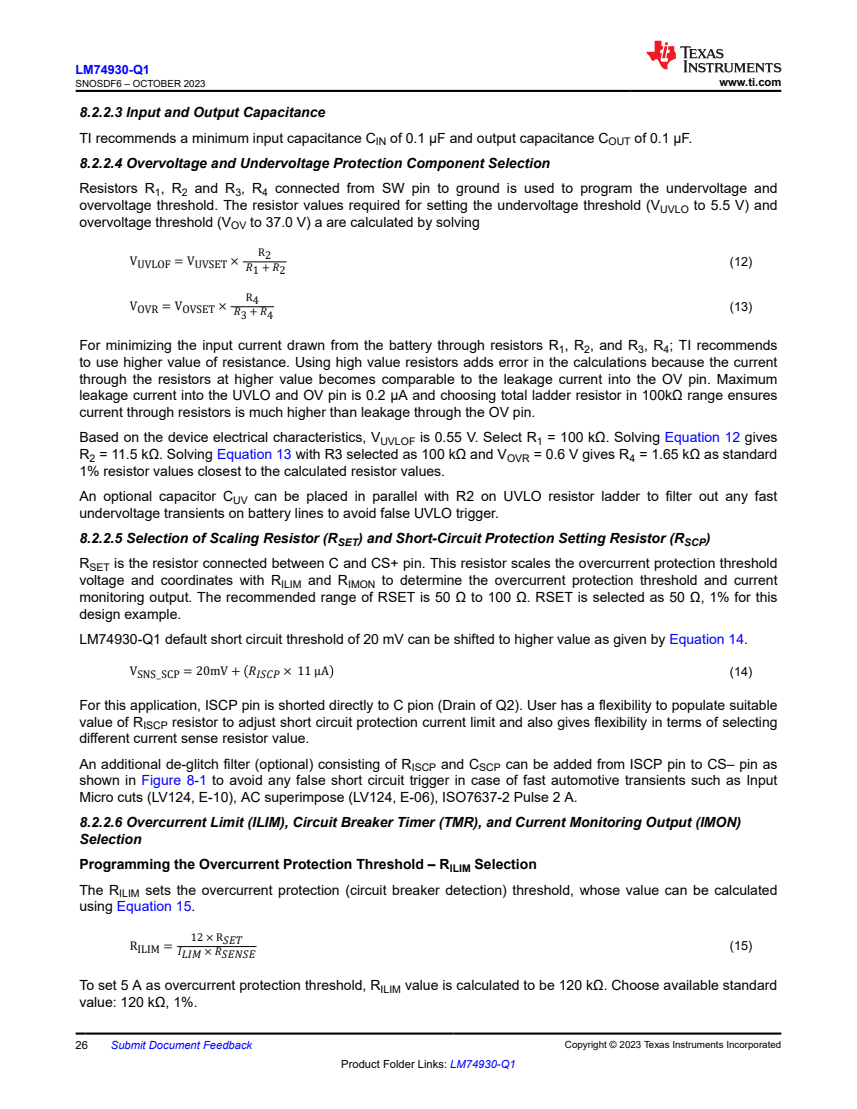
hardware/power-management-unit/rev-a/evidence/power/lm74930-q1-26.png
