chris01-byte/HomeMy/hardware/power-management-unit/rev-a/evidence/power/psmn1r0-100asf-5.png

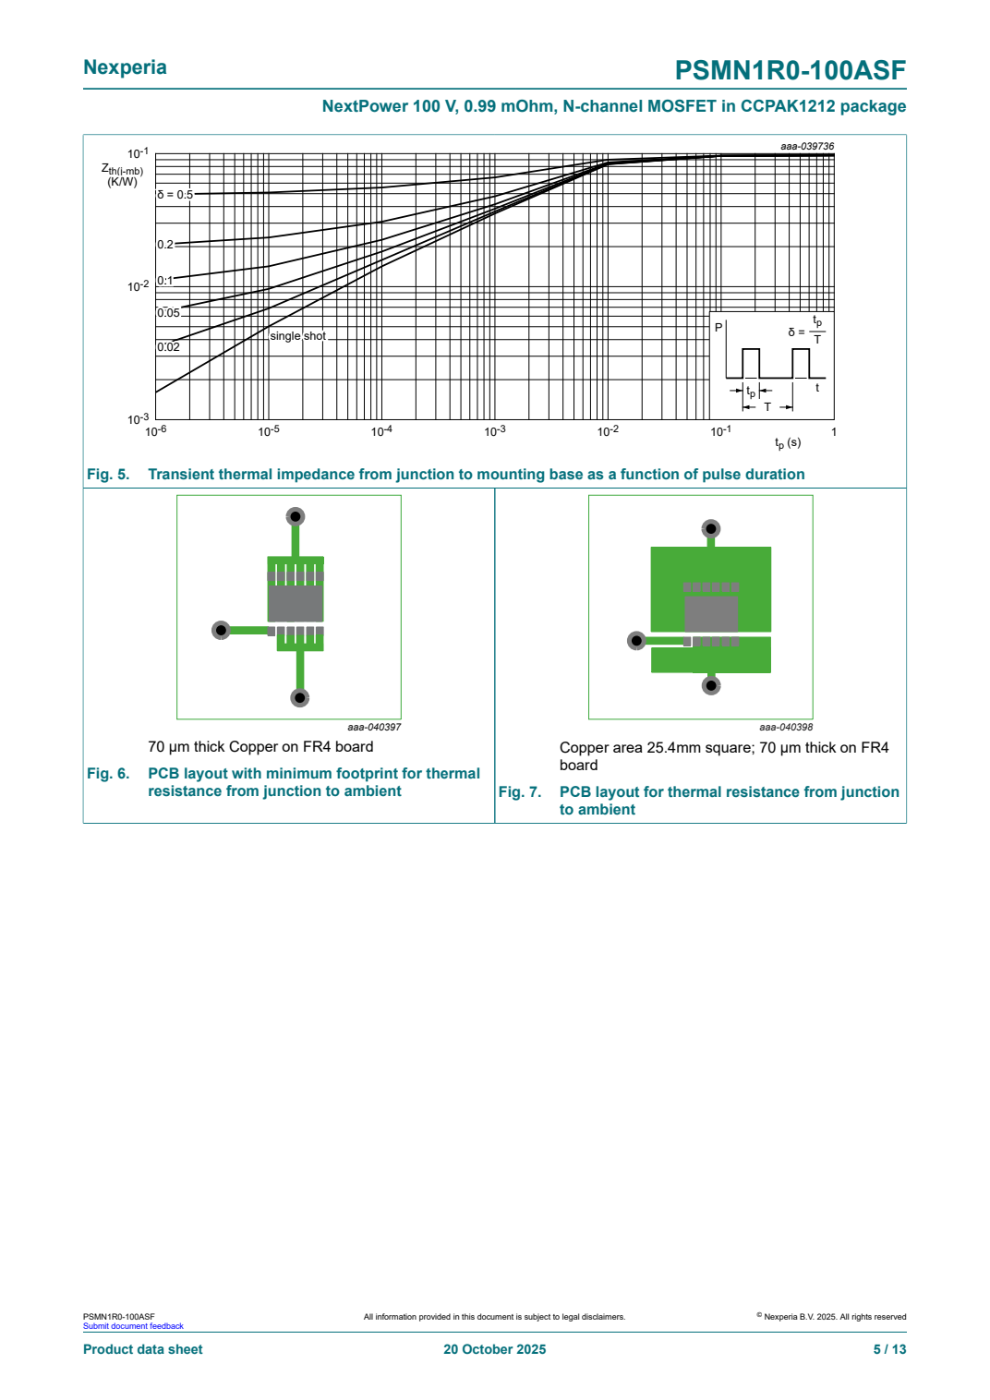
hardware/power-management-unit/rev-a/evidence/power/psmn1r0-100asf-5.png
