chris01-byte/HomeMy/hardware/power-management-unit/rev-a/evidence/power/psmn1r0-100asf-10.png

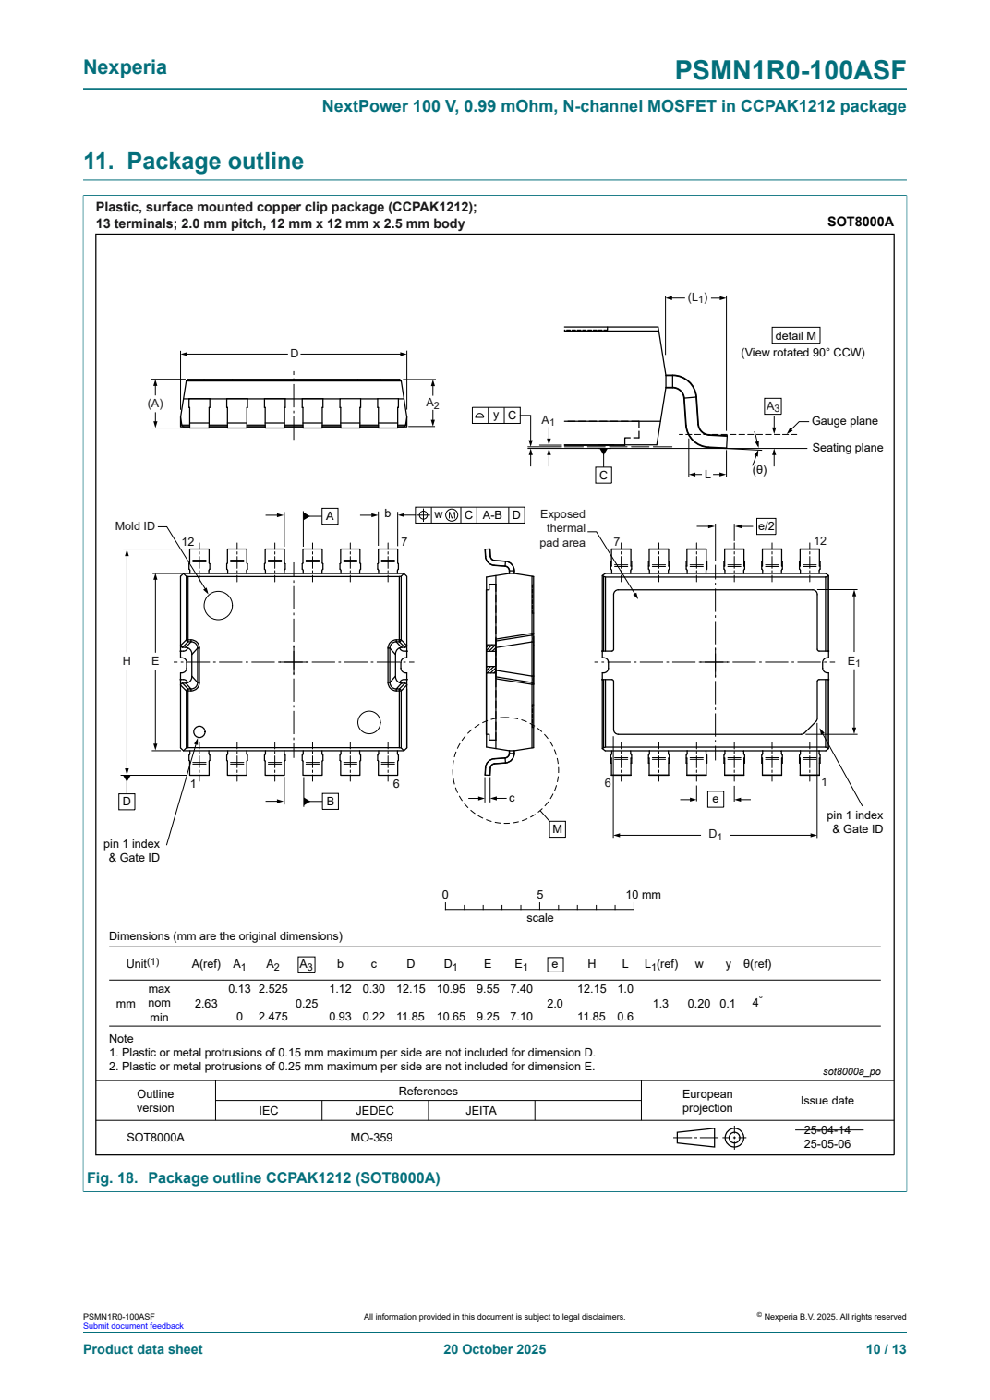
hardware/power-management-unit/rev-a/evidence/power/psmn1r0-100asf-10.png
