chris01-byte/HomeMy/hardware/power-management-unit/rev-a/evidence/power/ptvs1-4.png

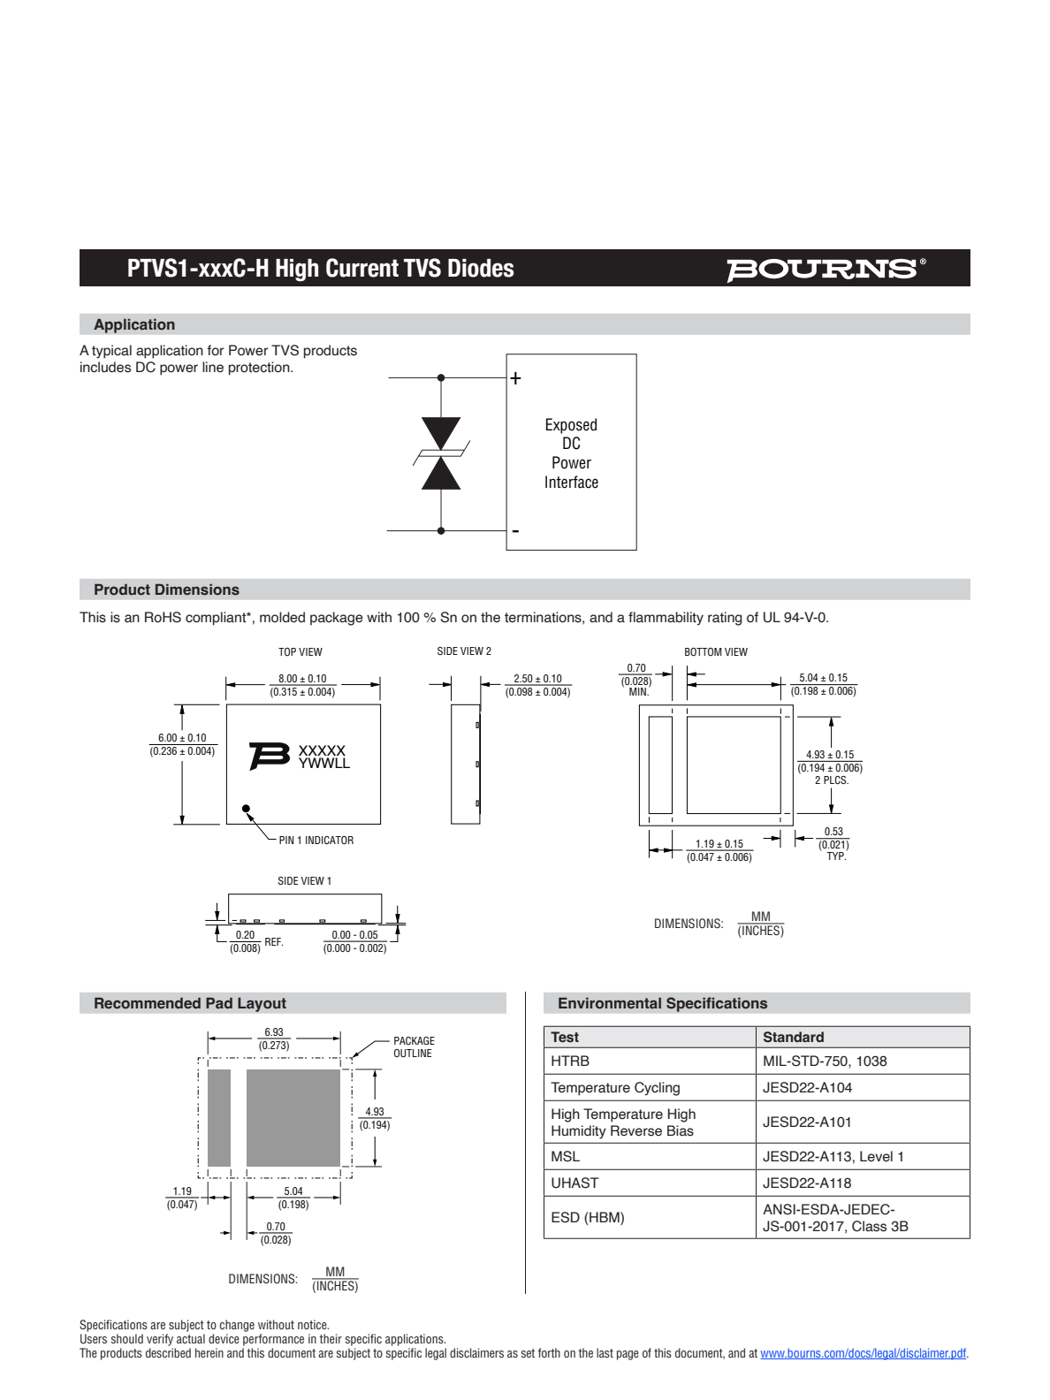
hardware/power-management-unit/rev-a/evidence/power/ptvs1-4.png
