chris01-byte/HomeMy/hardware/power-management-unit/rev-a/evidence/power/tps4811-q1-25.png

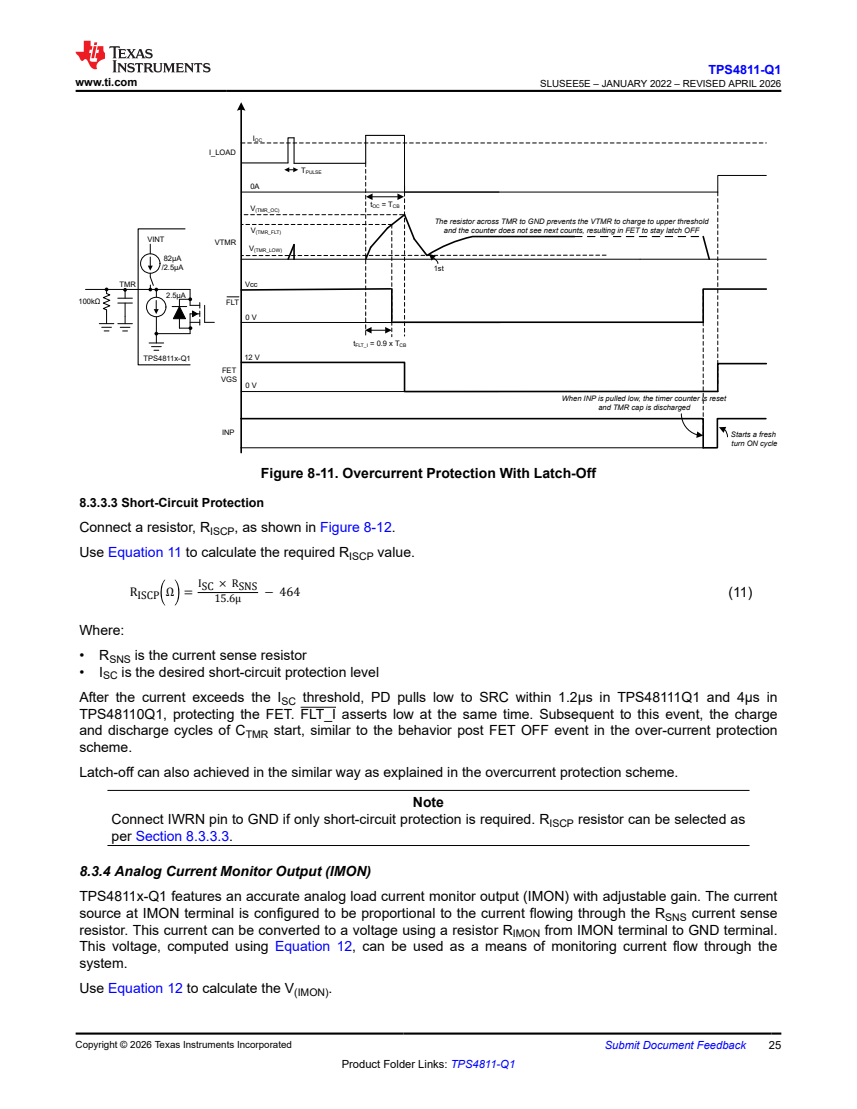
hardware/power-management-unit/rev-a/evidence/power/tps4811-q1-25.png
