chris01-byte/HomeMy/hardware/power-management-unit/rev-a/evidence/schematic-after/HomeMy_PMU_RevA-06a_aon_wake_p2-detail.png

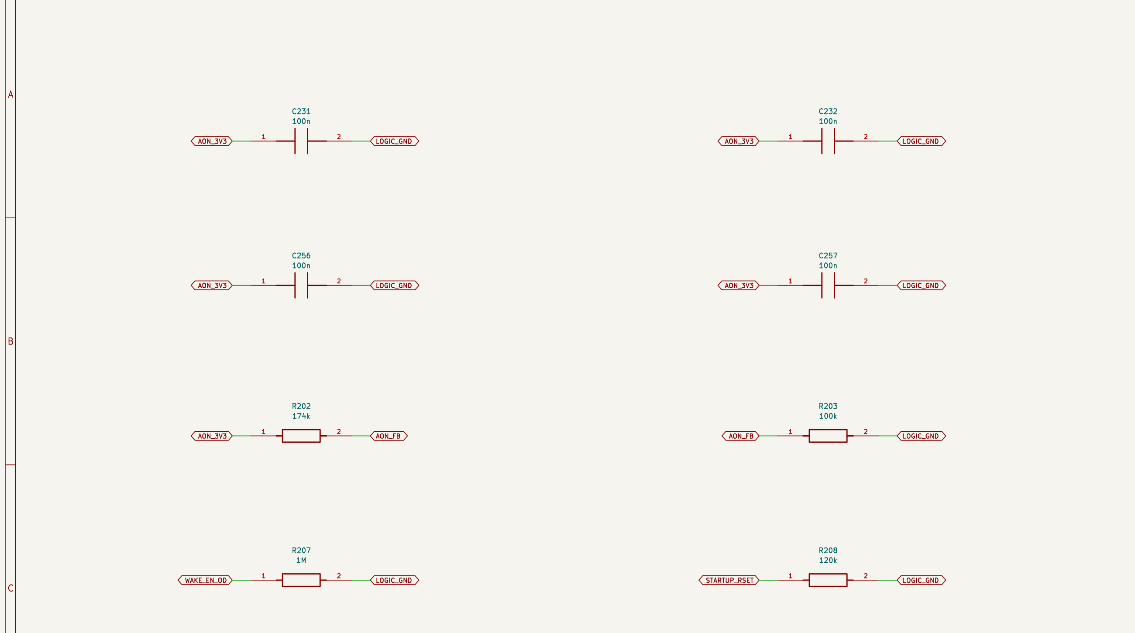
hardware/power-management-unit/rev-a/evidence/schematic-after/HomeMy_PMU_RevA-06a_aon_wake_p2-detail.png
