chris01-byte/HomeMy/hardware/power-management-unit/rev-a/evidence/schematic-after/HomeMy_PMU_RevA-06c_esp32_p1-detail.png

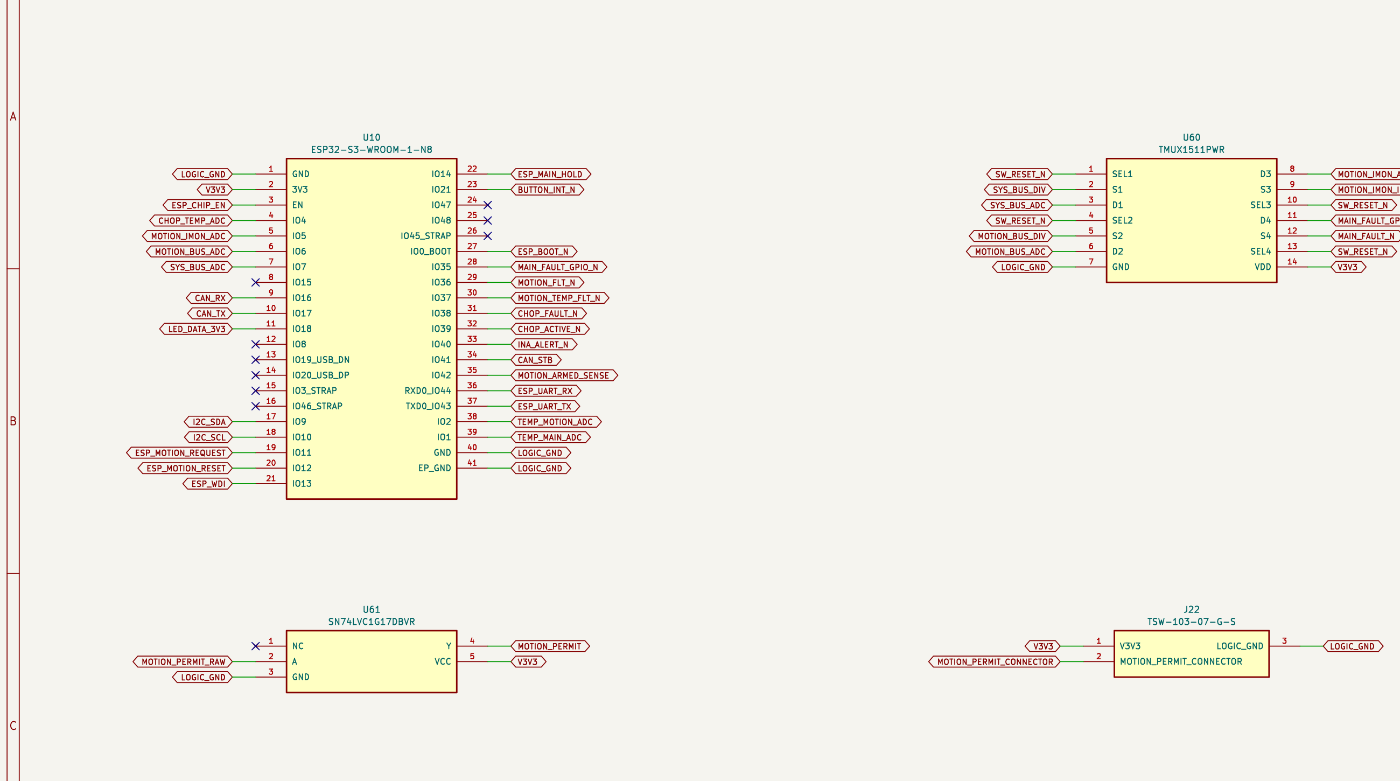
hardware/power-management-unit/rev-a/evidence/schematic-after/HomeMy_PMU_RevA-06c_esp32_p1-detail.png
