chris01-byte/HomeMy/hardware/power-management-unit/rev-a/evidence/tps3431-land.png

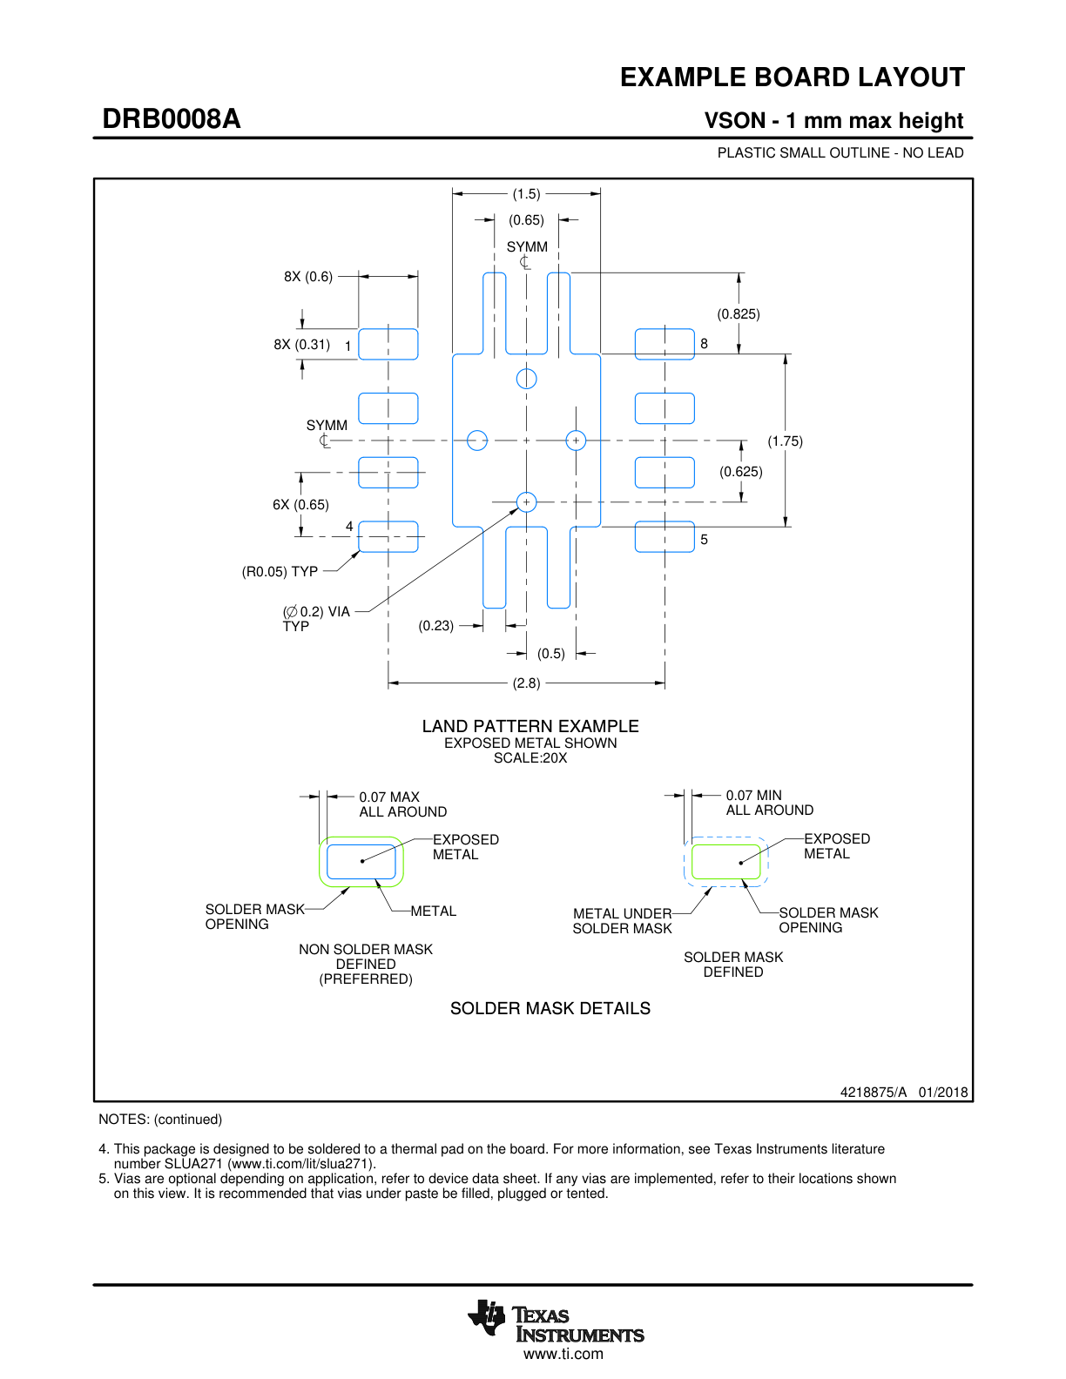
hardware/power-management-unit/rev-a/evidence/tps3431-land.png
