chris01-byte/HomeMy/hardware/power-management-unit/rev-a/reports/bb7-release-review.png

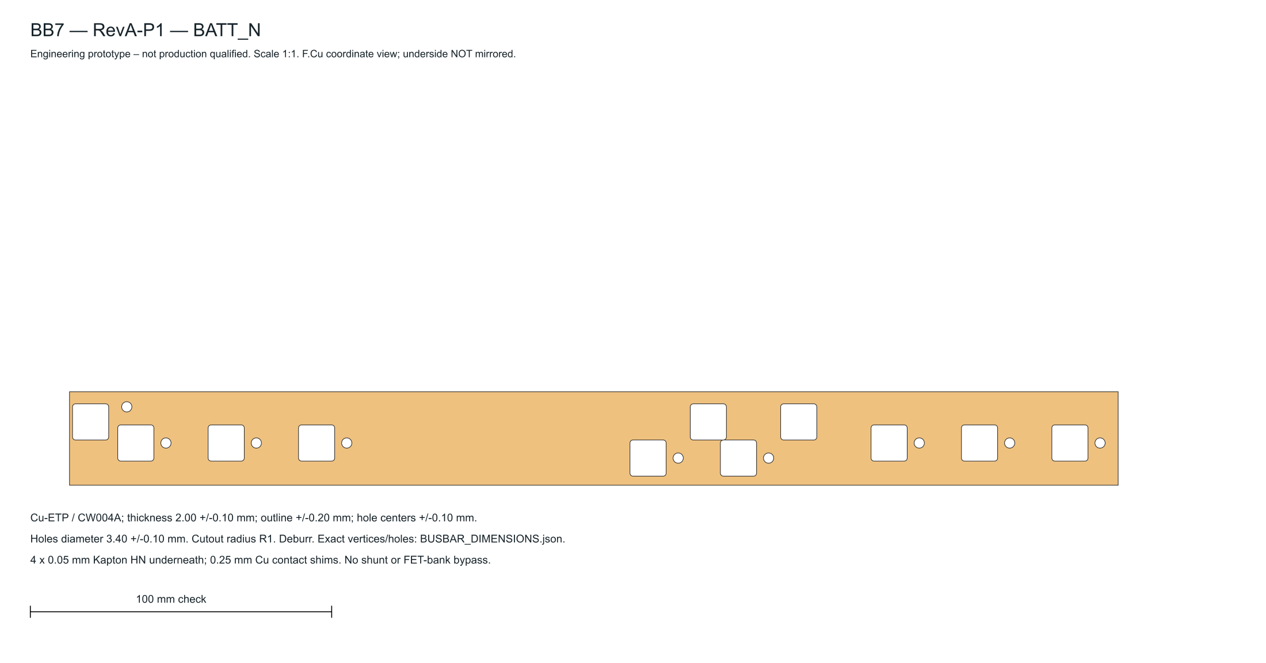
hardware/power-management-unit/rev-a/reports/bb7-release-review.png
