chris01-byte/HomeMy/hardware/power-management-unit/rev-a/reports/bottom-copper-review.png

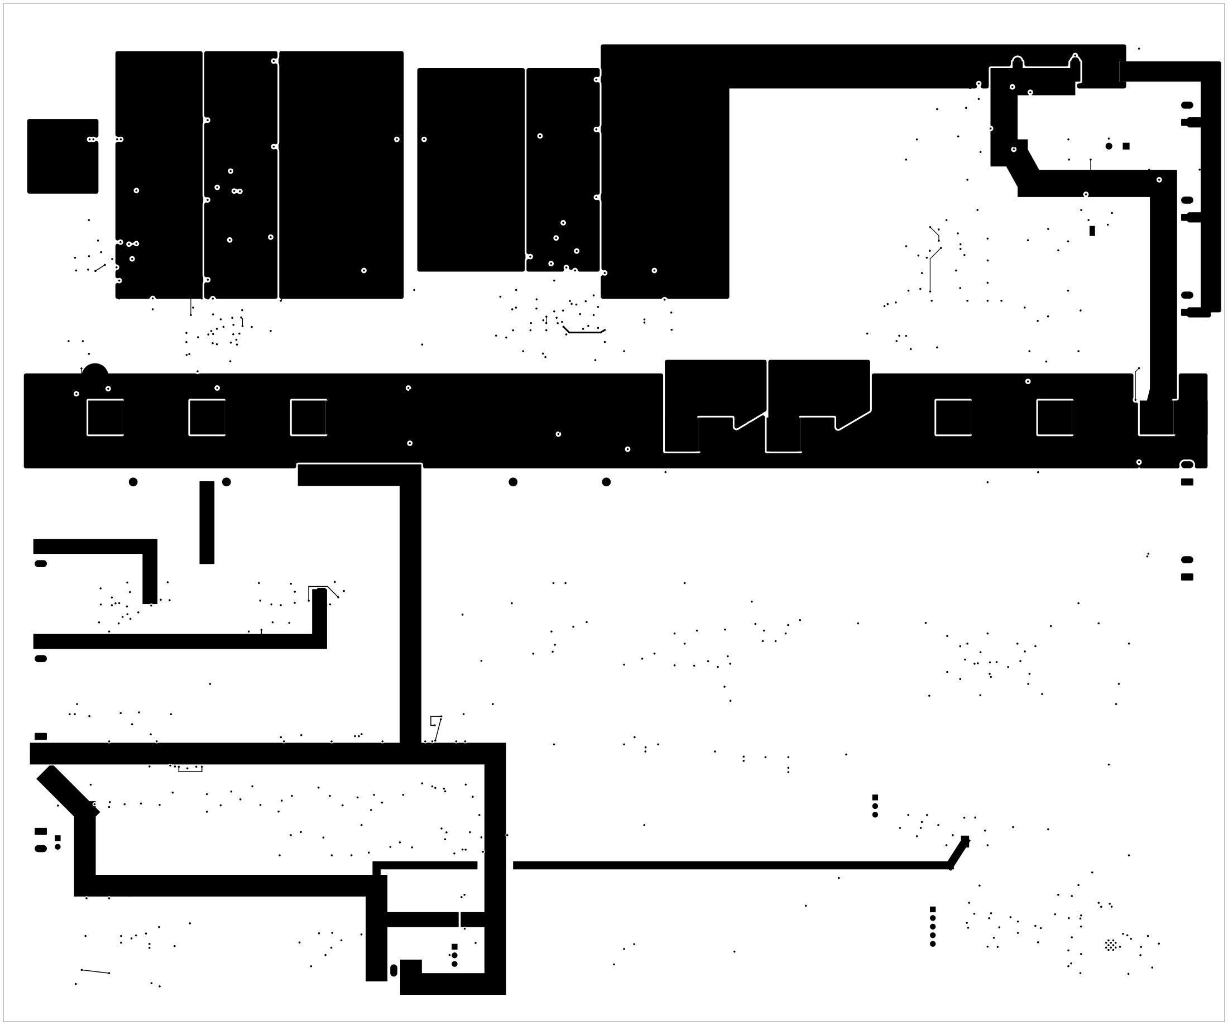
hardware/power-management-unit/rev-a/reports/bottom-copper-review.png
