chris01-byte/HomeMy/hardware/power-management-unit/rev-a/reports/busbar-mechanical-review.png

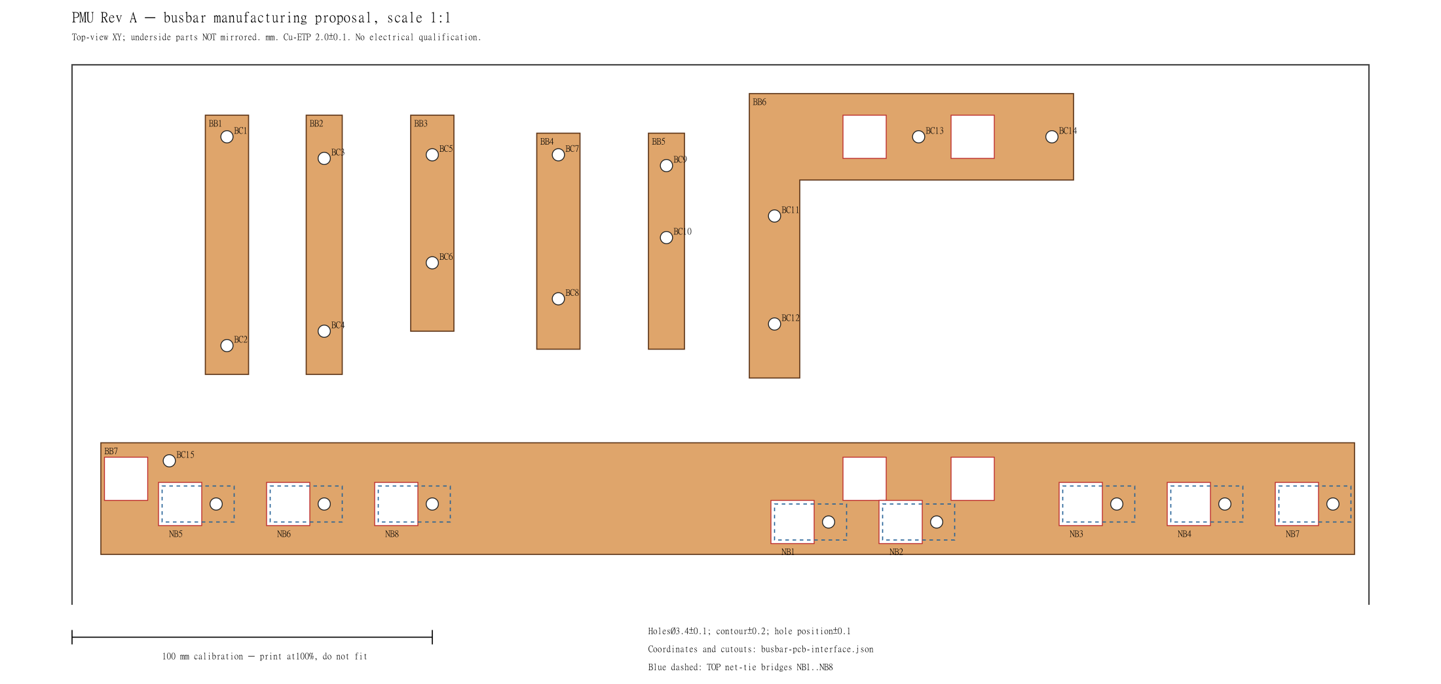
hardware/power-management-unit/rev-a/reports/busbar-mechanical-review.png
