chris01-byte/HomeMy/hardware/power-management-unit/rev-a/reports/drill-PTH-review.png

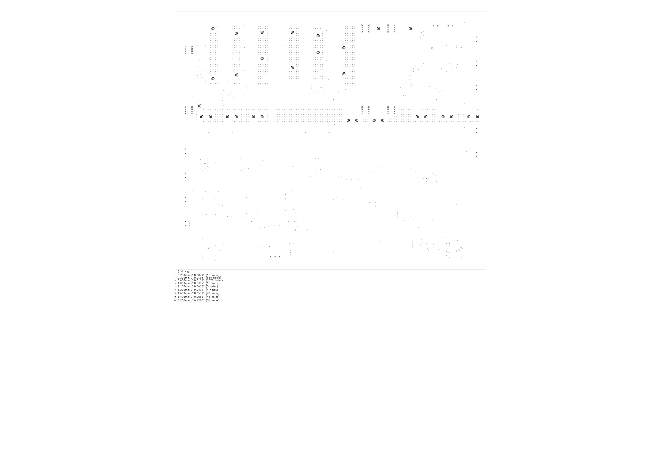
hardware/power-management-unit/rev-a/reports/drill-PTH-review.png
