chris01-byte/HomeMy/hardware/power-management-unit/rev-a/reports/inner2-copper-review.png

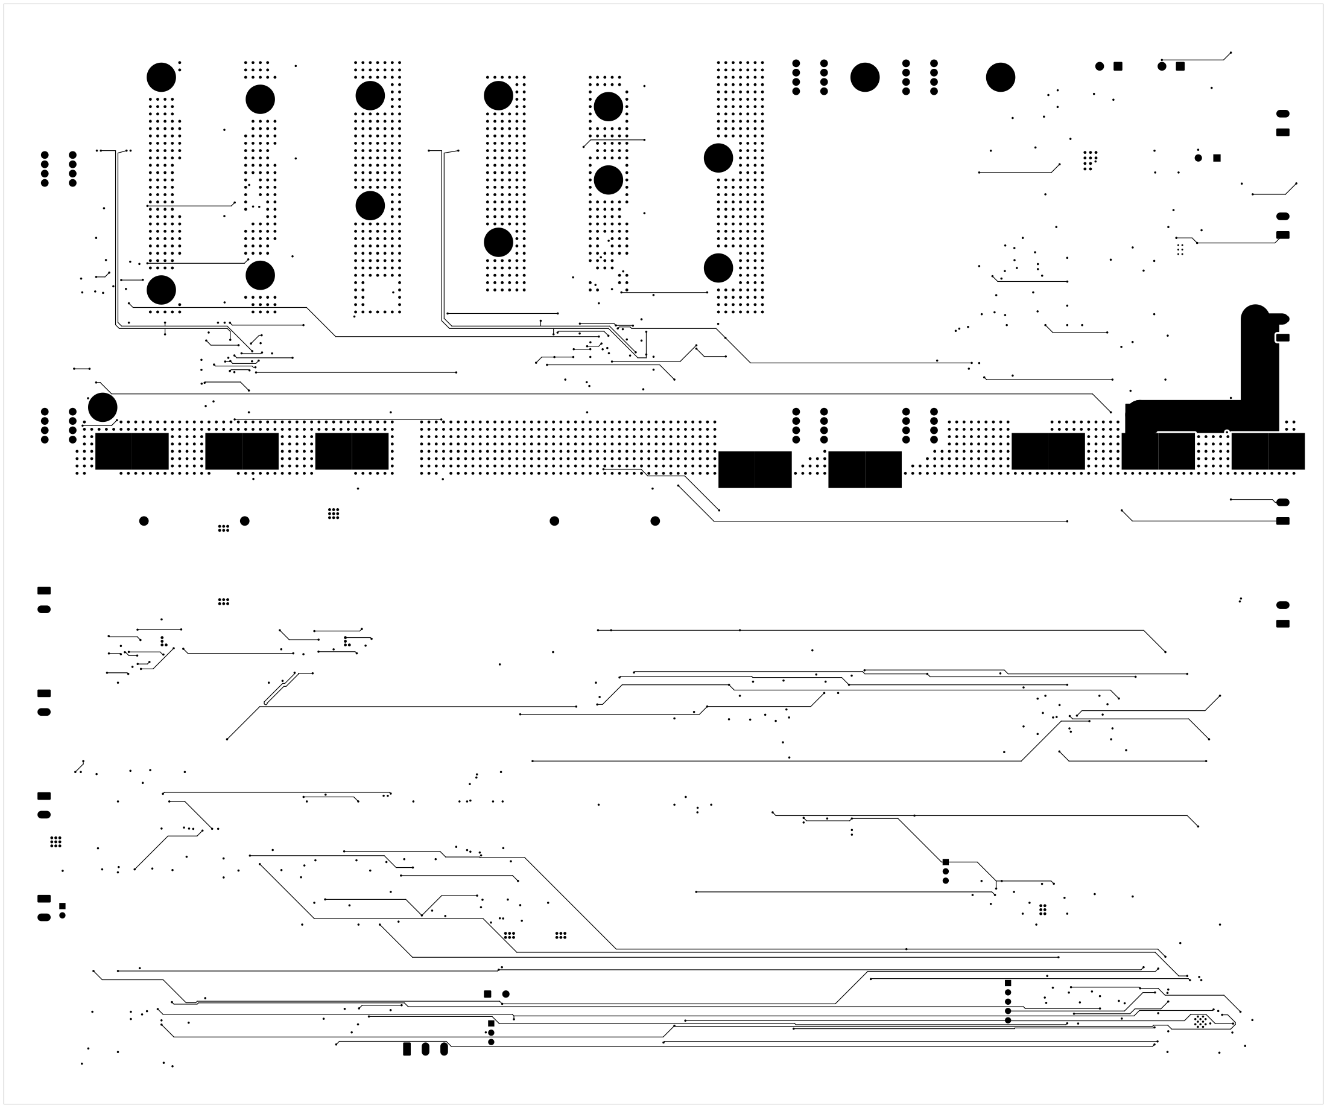
hardware/power-management-unit/rev-a/reports/inner2-copper-review.png
