chris01-byte/HomeMy/hardware/power-management-unit/rev-a/reports/polarity-review.png

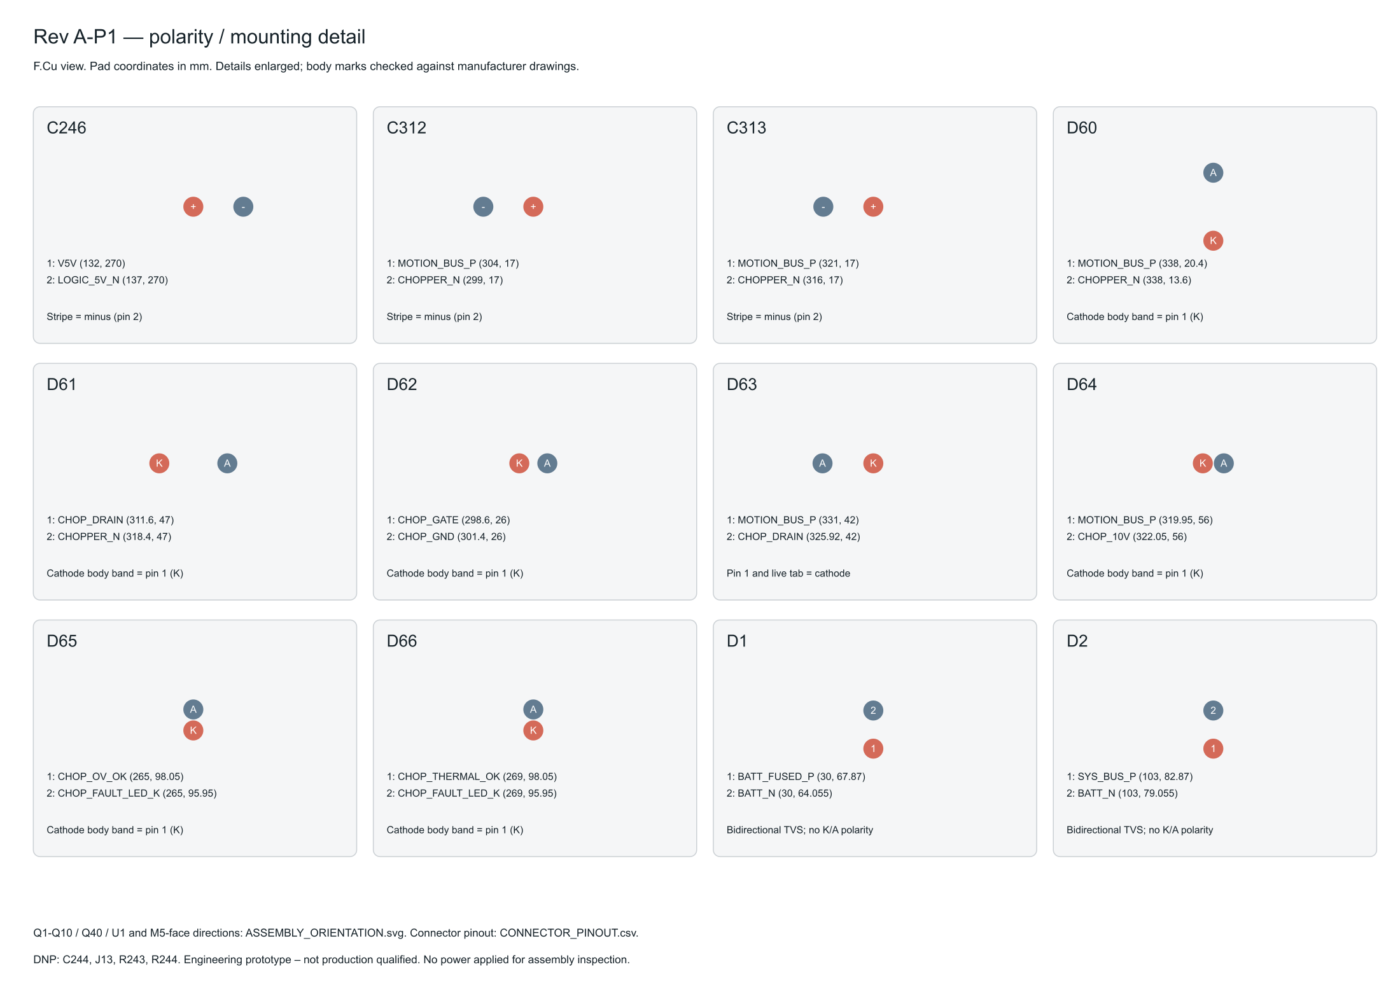
hardware/power-management-unit/rev-a/reports/polarity-review.png
