chris01-byte/HomeMy/hardware/power-management-unit/rev-a/reports/top-copper-review.png

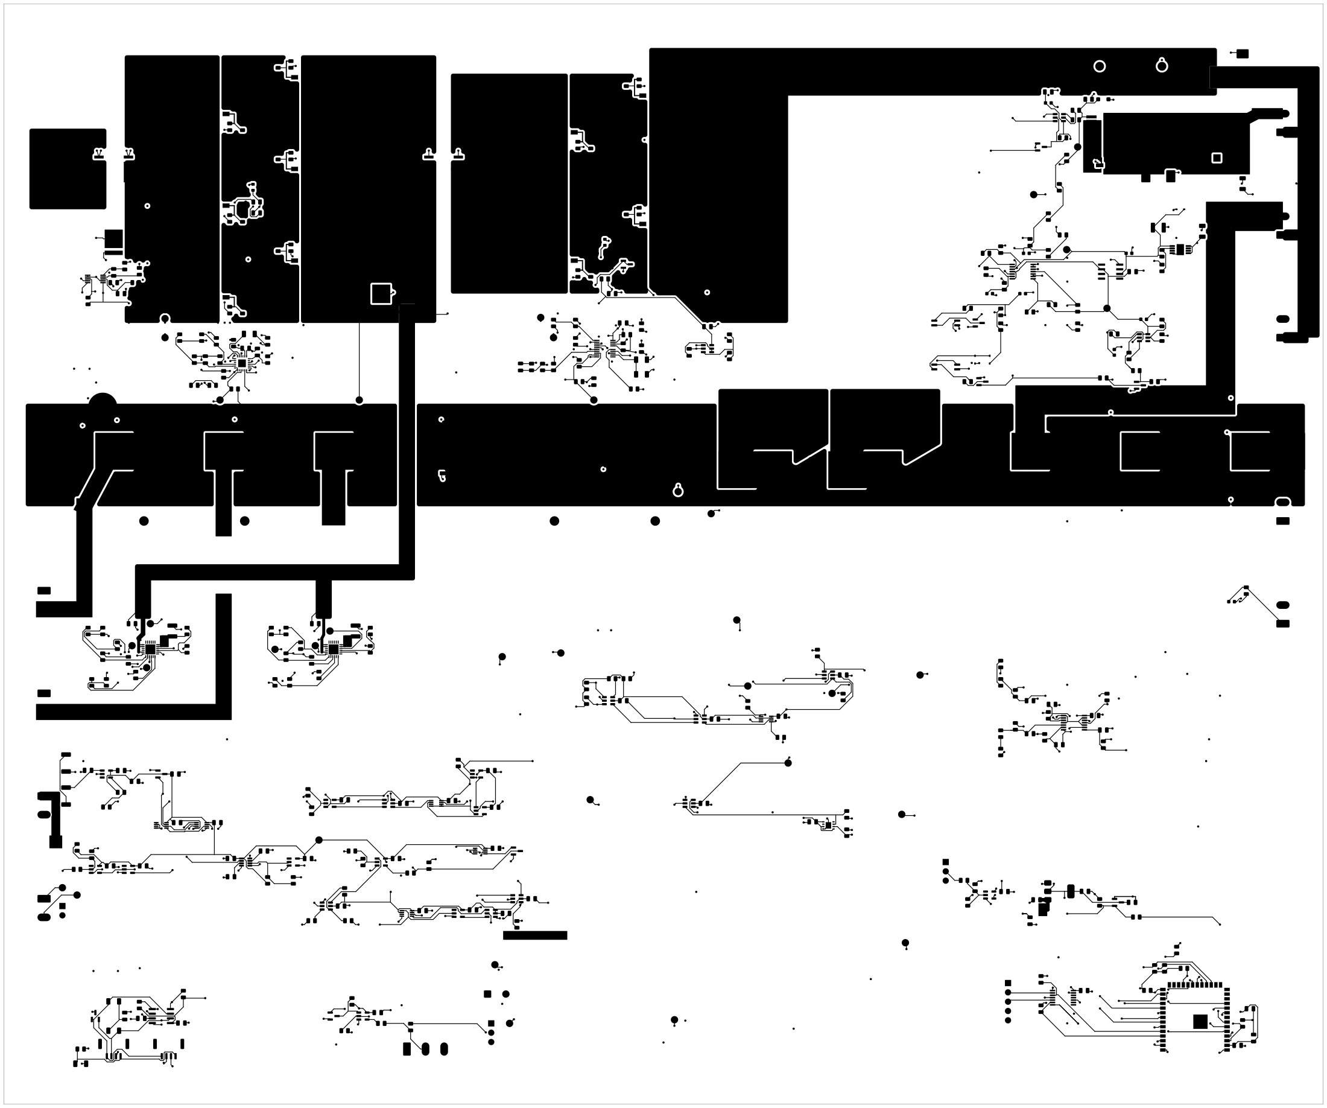
hardware/power-management-unit/rev-a/reports/top-copper-review.png
