chris01-byte/HomeMy/hardware/power-management-unit/rev-a/manufacturing/HomeMy_PMU_RevA-P1_2026-09-10/assembly/DNP.md

# Rev A-P1 DNP list

Do not populate these four positions in the default prototype.

| Ref | MPN | Description |
|---|---|---|
| C244 | GRM21BR71H103KA01L | 10n |
| J13 | 1776508 | 24V lift clamp DNP |
| R243 | RC1206FR-0760R4L | 60.4 |
| R244 | RC1206FR-0760R4L | 60.4 |

DNP placements have zero required quantity. The separate position file preserves their coordinates for review. No optional population without a new assembly variant.
