chris01-byte/HomeMy/hardware/power-management-unit/rev-a/manufacturing/HomeMy_PMU_RevA-P1_2026-09-10/evidence/filled-power-copper-review.md

# Filled power copper review — Rev A engineering prototype

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

- Input PCB SHA-256: `13fcae0f58c9a6ac5f85eb721c24b44169a65f628baad6586bcd6002f4c17cfe`.
- PCB unchanged during the native geometry analysis: `True`.
- Evidence: `filled-power-copper-review.json`, `filled-power-polygons.json` and the PNG views generated by `render_power_review.py`.
- Reproduction: run `review_filled_power.py` with the bundled KiCad Python through `scripts/run_tool.py`, then run `render_power_review.py` and `write_power_review.py` with the workspace Python. The native script does not refill or save the PCB.

## Method and limits

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

Native per-layer connection flags record local contact with copper. They do not independently prove connection to the whole net. In addition, the JSON checks whether selected endpoint pads share the same continuous copper outline on a layer. The current snapshot has 247 successful checks out of 247 tested paths. External busbars, clamp contacts, component internal conductors and the resistance of footprint net-tie bridges are not incorporated into this polygon resistance model. No finite-element current-density or thermal solution was performed.

## Measured paths

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

| Transect | Board coordinates, mm | F.Cu total width, mm | B.Cu total width, mm |
|---|---|---:|---:|
| RSH1 input approach | [22, 42.9] → [22, 49] | 6.10 | 6.10 |
| RSH1 output approach | [35.5, 42.9] → [35.5, 49] | 6.10 | 6.10 |
| RSH2 input approach | [112, 42.9] → [112, 49] | 6.10 | 6.10 |
| RSH2 output approach | [126, 42.9] → [126, 49] | 6.10 | 6.10 |
| Arm positive top rail | [260, 10] → [260, 34] | 13.00 | 13.00 |
| Right positive rail at junction | [330, 17] → [330, 23] | 6.00 | 6.00 |
| Star crossed by SYS feed | [110, 108] → [110, 134] | 0.00 | 24.98 |
| Left arm return approaching NT1 | [207, 109] → [207, 132] | 12.50 | 12.50 |
| Right arm return approaching NT2 | [237, 109] → [237, 132] | 12.50 | 12.50 |
| Q40 source below bank | [290, 40] → [302, 40] | 5.00 | 8.00 |
| Q40 drain exit | [311, 29] → [311, 41] | 11.28 | 0.00 |
| Chopper drain connector neck | [345, 27] → [345, 33] | 3.00 | 0.00 |

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

At x = 110 mm the SYS feed interrupts BATT_N on F.Cu. B.Cu has 24.98 mm of copper within the limited sampling window. Rev A-P1 extends the return's lower edge to y=137 mm and restores a broad route below NT1/NT2 after sliver filtering. Near J4/J6 the return copper still splits around separate branch regions and holes. The specified BB7 bar and NB branch bridges, contact shims, film and spring clamps remain mandatory. This is not a uniform pair of unbroken strips. The 10 × 10 mm PTH star lands are power attachment points; signal net ties NT9/NT10 are not substitutes.

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

## Actual via-field arithmetic

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

## Findings and report status

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

Observed `reports/drc-final.json` at `2026-09-10T23:10:04` contains 0 geometric entries, 0 unconnected entries and 0 parity entries. Its SHA-256 is `41209f2f29faef8b89e8dab513edf4540d547d1aa666cb81b91bd1e35df13c75`.

Matching process manifest: `reports/native-checks-both.json`; its recorded board hash matches this review: **True**. Process exit code: **0**; process passed: **True**; JSON report complete: **True**.

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
