chris01-byte/HomeMy/hardware/power-management-unit/rev-a/evidence/assembly-annotation-fab.png

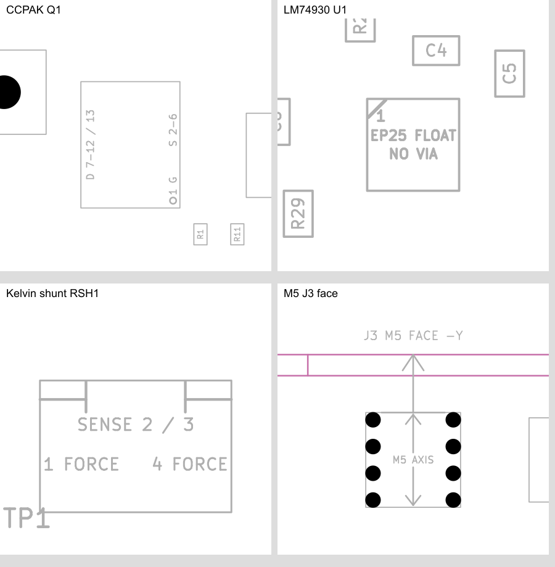
hardware/power-management-unit/rev-a/evidence/assembly-annotation-fab.png
