chris01-byte/HomeMy/hardware/power-management-unit/rev-a/manufacturing/ASSEMBLY_ORIENTATION.png

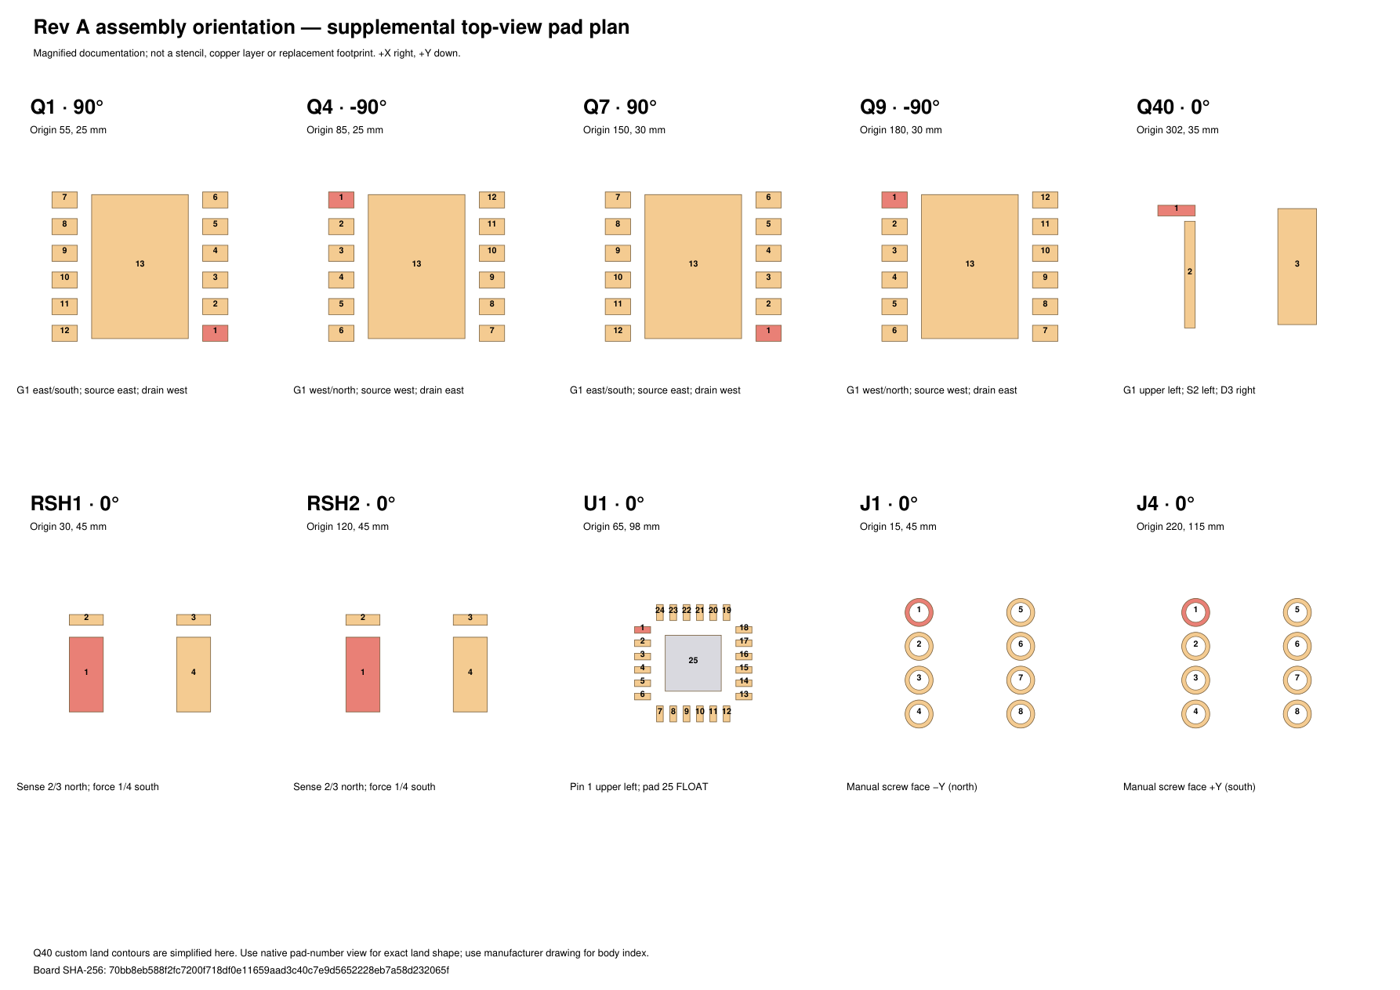
hardware/power-management-unit/rev-a/manufacturing/ASSEMBLY_ORIENTATION.png
