chris01-byte/HomeMy/hardware/power-management-unit/rev-a/reports/assembly-back-review.png

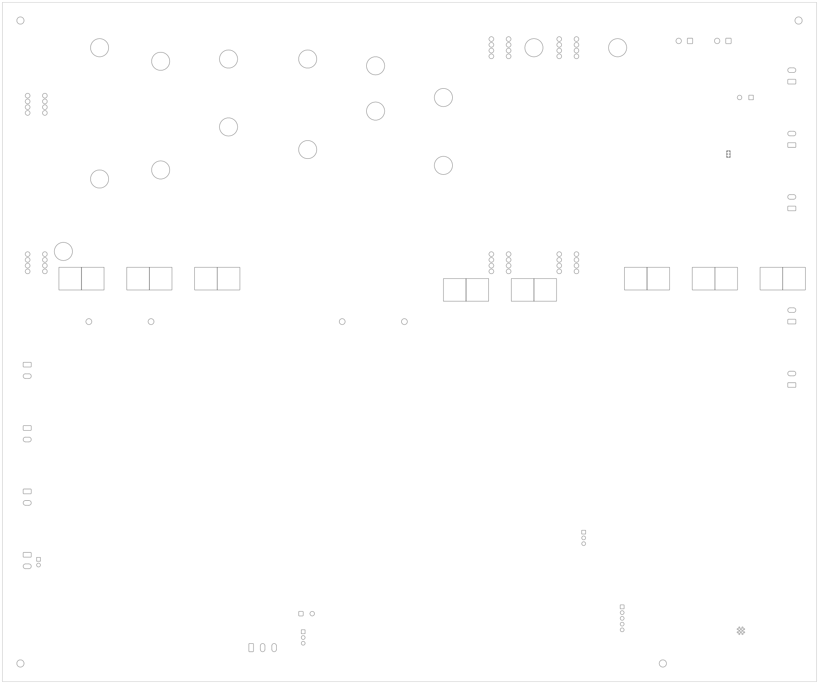
hardware/power-management-unit/rev-a/reports/assembly-back-review.png
