chris01-byte/HomeMy/hardware/power-management-unit/rev-a/reports/assembly-front-review.png

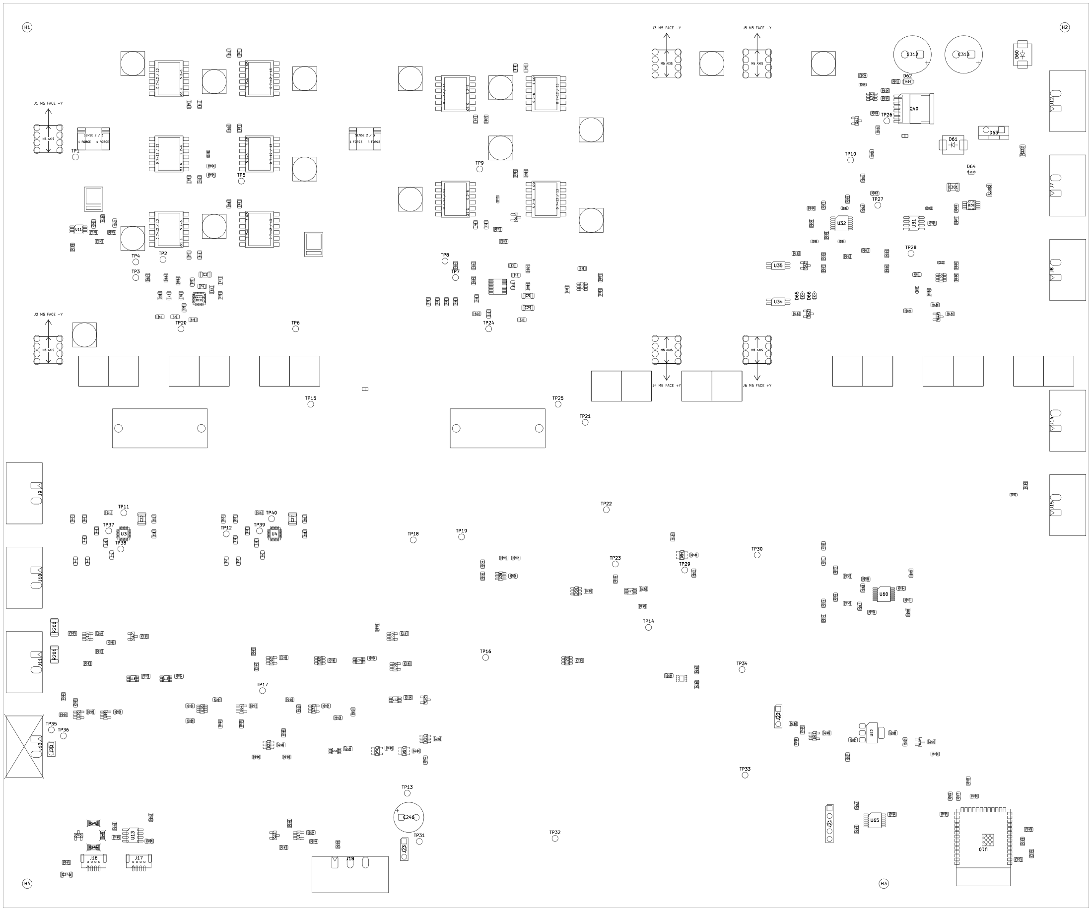
hardware/power-management-unit/rev-a/reports/assembly-front-review.png
