chris01-byte/HomeMy/hardware/power-management-unit/rev-a/manufacturing/HomeMy_PMU_RevA-P1_2026-09-10/integration/REV_B_VALIDATION.md

# PMU Revision B validation register

`rev_a_engineering_prototype: true`  
`rev_b_production: false`  
Date: 2026-09-10. All measurement gates below are **open**. The design, source-data calculations and any later CAD reports are not physical validation results.

Revision A supplies the measurement platform. Missing post-build data does not by itself stop schematic/layout work. Before energizing any fixture, close its applicable [design-review and energization gates](DESIGN_REVIEW_AND_BRINGUP.md). Unresolved manufacturer proof gaps must receive an explicit engineering disposition for that fixture; they cannot be called measurements that merely await paperwork.

Every record must identify PCB/BOM revision, fitted options, firmware/Linux versions, calibration, instruments, source/current/energy limits, ambient and initial temperatures, harness geometry, actual load, raw data, acceptance criterion, result and reviewer. Preserve failed results and the change needed to repeat the test. No actuator motion is authorized by this register.

| Gate / requirement links | Measurements and acceptance basis | Revision-B decision affected |
| --- | --- | --- |
| B01 — MAIN-002, MOT-002, TOP-004, BAT-002 | At27.5/36/42 V with the final converters and actual downstream capacitance, capture current, both gate/source voltages, VDS, BST−SRC, rail sag, start/stop time and each FET temperature. Include cold/hot starts, repeated starts and fitted940 µF motion bulk. Compare every captured stress with applicable manufacturer SOA/transient thermal limits with temperature derating; do not assume parallel linear sharing. Resolve main hot RDS(on) at the actual minimum drive. | Retain or revise no-precharge, R34/gate drive, bulk capacitance, FETs, cooling, startup sequencing and current limits. The1 A/≤100 µF main fixture is not this validation. |
| B02 — MON-001..004, MOT-003 | Calibrate signed current, voltage, power, charge and energy against traceable references at zero, about1/5/25/45 A and higher approved points. Record temperature drift and post-pulse drift. Review/safely inject sense-open/short and shared-sense IC failure cases; verify protection remains acceptable or change architecture. | INA calibration/filtering, shunt rating/layout and whether shared RSH1 remains acceptable. Manufacturer overload qualification does not establish arbitrary hot pulses. |
| B03 — CHOP-001..004, PCB-006, BAT-003 | Start with an electronic regeneration emulator. Measure source energy, resistor energy/current sharing, switching frequency/edges, TVS activity, both resistor temperatures, NTC response/lag and chopper-FET temperature. Measure bulk capacitance, ESR and each capacitor's ripple current at working frequency/temperature. Verify ~46 V fault latches motion while chopper keeps dissipating, and thermal/open/short faults. Later capture actual worst approved axes/payload/deceleration combinations. | Resistor technology/energy/duty curve, number/size of heat spreaders, sensor mount, chopper/bulk/ripple ratings, voltage thresholds, connector derating and regeneration-control policy. Production duty cannot be inferred from the500 J/60 s cold-test starting limit. |
| B04 — LIFT-001..003, CHOP-005 | Characterize the exact24 V converter with two representative ESS17 loads, then separately authorized lowering/deceleration and forced-stop scenarios. Measure input/output current and overshoot, reverse-output behavior, OCP/recovery, efficiency and heat. | Whether J13's DNP local24 V clamp must be populated/redesigned; converter, lift limits and output wiring. The main chopper may not absorb isolated24 V output regeneration. |
| B05 — PC-001..004, LOGIC-001..003, LOGIC-002, LIFT-003 | Verify exact module models/pinouts and characterize startup, inrush, current limiting/short response, ripple, efficiency, thermal equilibrium, low battery, transients and recovery at27.5/36/42 V. Demonstrate5 V/5 A continuous with actual logic/LED load and4–5 A total24 V continuous use. Measure U12/ESP rail temperature and droop. | Approved external-module BOM, input/output connector/keying, eFuse ILIM/slew, 3.3 V regulator/thermal design, capacitor values and harness limits. Vendor claims remain unverified until these records exist. |
| B06 — PCB-002/003/005/006, MOT-005, BAT-002 | Measure each arm, drive, lift and combined-system current under enforced commands. Four-wire measure every joint/bar/shunt/terminal; thermally survey FET pads, copper necks, vias, terminals, contacts, cables and enclosure. Test exact crimp/lug retention and mating hardware at approved ambient/duty. | Enforceable per-arm limit (initial25 A), contact/housing/wire selection, reinforcement geometry, plating, torque and accessible temperature limits. A160 A terminal class does not certify a45–60 A PCB. |
| B07 — BAT-004, MAIN-003, MOT-004, SW-001/002 | Obtain exact fuse DC time-current/interrupt data and BMS curves. Measure main/motion current thresholds, TMR leakage/delays, UV/OV rising/falling edges and response at temperature. Overlay distributions with motor transients and fuse/BMS curves, including TPS branch overload pulses. Verify every recovery/reset policy. | Main/motion/fuse selectivity and production thresholds/timing. Main/motion nominal65/60 A ordering currently overlaps; selective operation is not established. |
| B08 — BAT-003, MAIN-002, MOT-002, COM-003 | Capture worst installed wiring/connector and source-disconnect transients, including cable inductance and actual TVS current/voltage at temperature. Measure below controller/FET voltage limits with margin; verify no normal regenerative energy is assigned to TVS/avalanche. Test reverse-current blocking without charging the pack. | TVS technology, placement, ratings, snubbers, wiring limits and fault containment. CAN ESD and continuous battery miswire are distinct cases; the current24 V CAN TVS does not claim42 V continuous survival. |
| B09 — SW-001..003, PC-002, CTRL-003/004, COM-004 | Validate the eventual ESP/Linux implementation: versioned45/50 A and low-voltage policy, ~25 W baseline repeat,65 W computer budget, ROS/services/USB load, no-GUI boot, all LED states, local logging, heartbeat/lost-CAN/frozen-user-space and shutdown acknowledgement. Verify motion closes before restart/recovery. | Firmware/timeouts, CPU power configuration, telemetry rates and customer lifecycle. Circuit GPIO assignments alone are not implementation evidence; keep development boot-target rollback until validated. |
| B10 — CTRL-002/003/005 | At supply/temperature corners, measure OFF current with CAN/UART connected and SYS/MOTION charged; held-button battery attach, valid press, failed hold, short press, forced-off with stuck-high hold, ESP reset, switched rail loss within/after grant, main FLT mask and AON collapse. Remove permission and watchdog feed at every transition. Include SYS-only UV while3.3 V survives and shallow/short dips. | Wake rail/RC values, latch sequencing, effective capacitor substitutions, startup deadlines, button timing and service-interface design. No recovery may itself grant motion or restart main power. |
| B11 — COM-001..003 | Run actual12-joint command/feedback traffic at100 Hz and1 Mbit/s plus PMU messages. Measure utilization≤50% target with error/retry margin, latency, drops and termination/stub effects. Verify shield/ground currents, unpowered nodes and representative EMC/ESD behavior. | CAN protocol rates, topology, termination, TVS/shield/filtering and final isolated-adapter integration. The~40% arithmetic estimate is not a measured utilization result. |
| B12 — PCB-001/002/004, CHOP-002, MAIN-002 | Confirm final board outline, holes, height, cable exit/bend radii, connector access, antenna clearance, press-fit process, busbar forms/segmentation, cover, standoffs and chassis heat-spreader contact. Run enclosure thermal/airflow measurements at approved combined duty and ambient. | Production mechanics, mounting, stackup/copper, thermal paths, assembly instructions and RF placement. Prototype360 ×300 mm dimensions do not constrain final enclosure design. |
| B13 — PCB-003/005/006, PC-004, LOGIC-002, LIFT-003 | Qualify complete harness BOM: exact housings/contacts/ring lugs, wire insulation/gauge/temperature, ferrules, crimps, torque, strain relief, mating retention/keying and service labels. Confirm component lifecycle and purchasability again before release. | Approved assembly/procurement alternatives and harness current/temperature ratings. Family pages and dated stock observations do not constitute a released harness BOM. |
| B14 — CTRL-005, SW-003, MOT-001 | Define and validate final motion-safety/stop architecture, reachable disconnect, single-fault response, permission signaling and absence of unintended restart. Test only with an attending person's authorization, physical restraints and a written bounded test. | Product emergency stop, redundancy/diagnostics, hardware interfaces and controlled-stop/energy strategy. J22's single low-voltage commissioning contact is not an accepted final architecture. |

## Closing a gate

Close a row only when its raw evidence, reproducible analysis and accepted resulting design/settings are linked. If a measurement changes a part, threshold, connector or layout, update the calculations and repeat affected lower-level tests. A temperature/scope trace that exceeded a limit remains a failed case even if a later revision passes.

Production release requires all rows applicable to the final system, the nine production-gate categories in `requirements.yaml`, finalized harness/mechanics and accepted fault behavior. Revision A remains an engineering prototype until that separate release record exists.
