chris01-byte/HomeMy/(list of files, drawings)

Other design files:
hardware/power-management-unit/rev-a/evidence/schematic-readability-review.json
hardware/power-management-unit/rev-a/reports/HomeMy_PMU_RevA.dsn
hardware/power-management-unit/rev-a/reports/routing-run-001/best-incomplete-count.dsn
hardware/power-management-unit/rev-a/reports/routing-run-001/input.kicad.dsn
hardware/power-management-unit/rev-a/reports/routing-run-001/latest.dsn
hardware/power-management-unit/rev-a/reports/routing-run-002/best-incomplete-count.dsn
hardware/power-management-unit/rev-a/reports/routing-run-002/input.kicad.dsn
hardware/power-management-unit/rev-a/reports/routing-run-002/latest.dsn
