chris01-byte/HomeMy/hardware/power-management-unit/rev-a2-layout-280x260/kicad/HomeMy_PMU_RevA.kicad_pcb

## KiCad design hardware/power-management-unit/rev-a2-layout-280x260/kicad/HomeMy_PMU_RevA.kicad_pcb (2026-09-13)

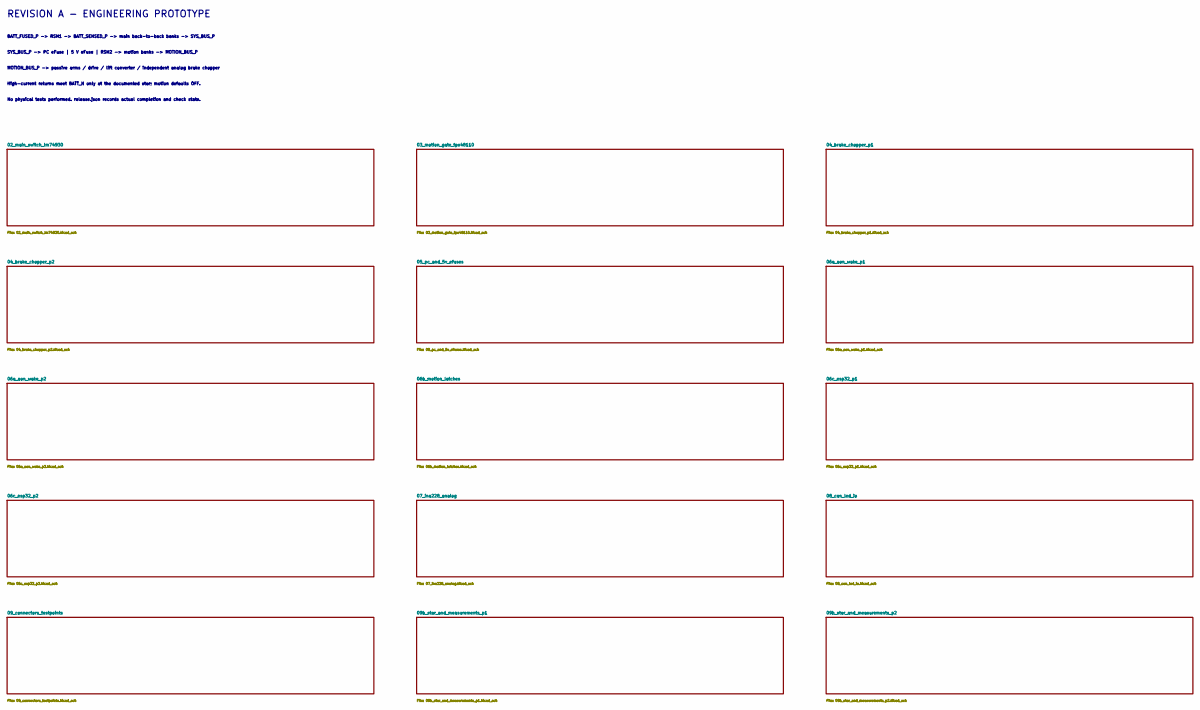
[picture p42: schematic HomeMy_PMU_RevA.kicad_sch, PMU A / Power tree]

Notes on the sheet:
REVISION A - ENGINEERING PROTOTYPE
BATT_FUSED_P -> RSH1 -> BATT_SENSED_P -> main back-to-back banks -> SYS_BUS_P
SYS_BUS_P -> PC eFuse | 5 V eFuse | RSH2 -> motion banks -> MOTION_BUS_P
MOTION_BUS_P -> passive arms / drive / lift converter / independent analog brake chopper
High-current returns meet BATT_N only at the documented star; motion defaults OFF.
No physical tests performed. release.json records actual completion and check state.

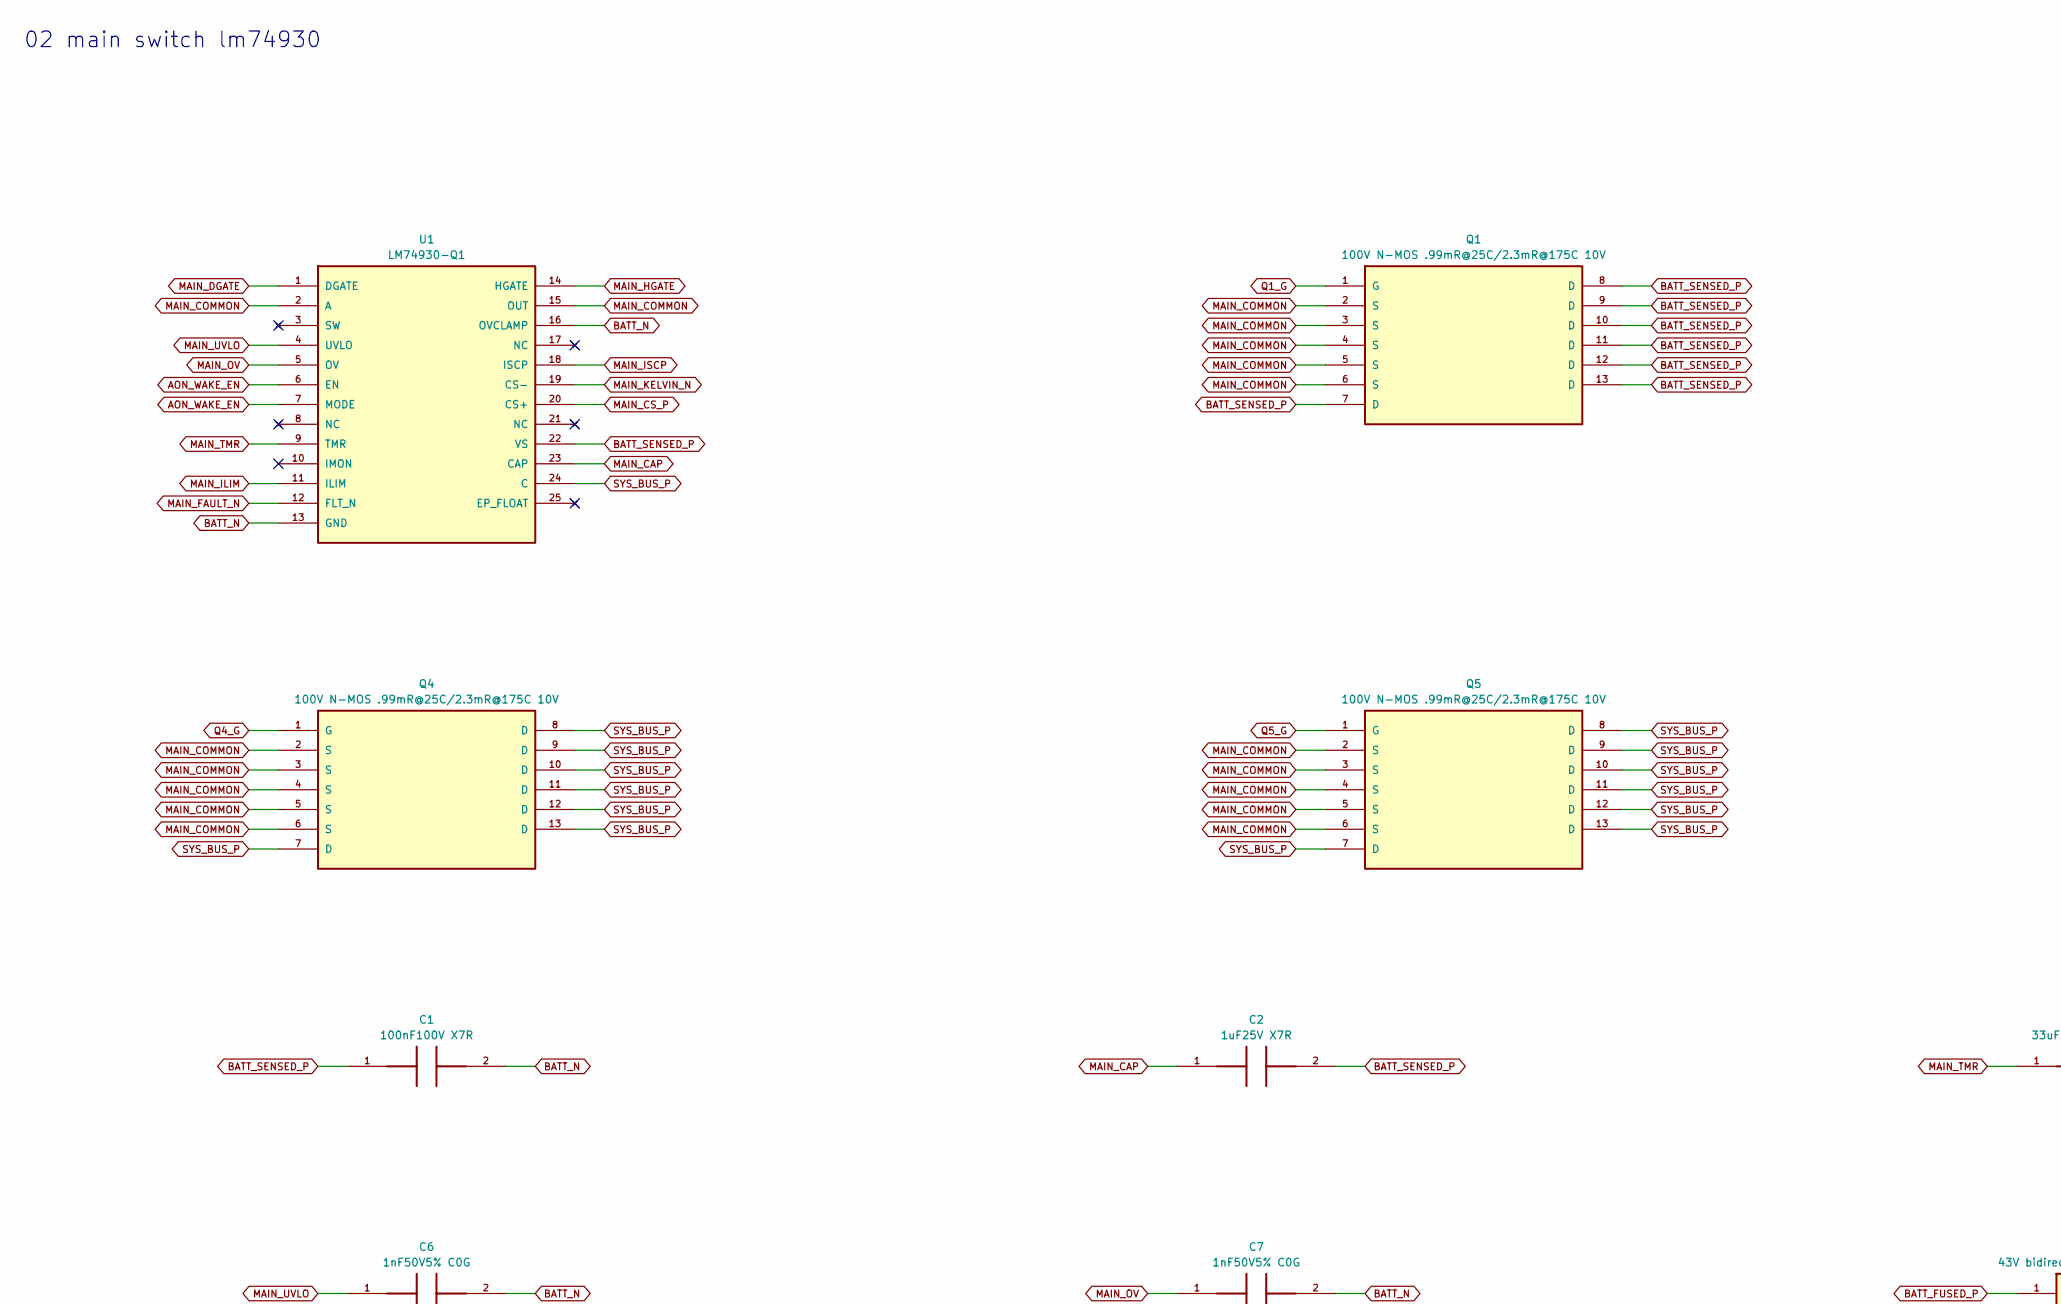
[picture p43: schematic 02_main_switch_lm74930.kicad_sch, PMU A / Main switch, part in row 1, column 1]

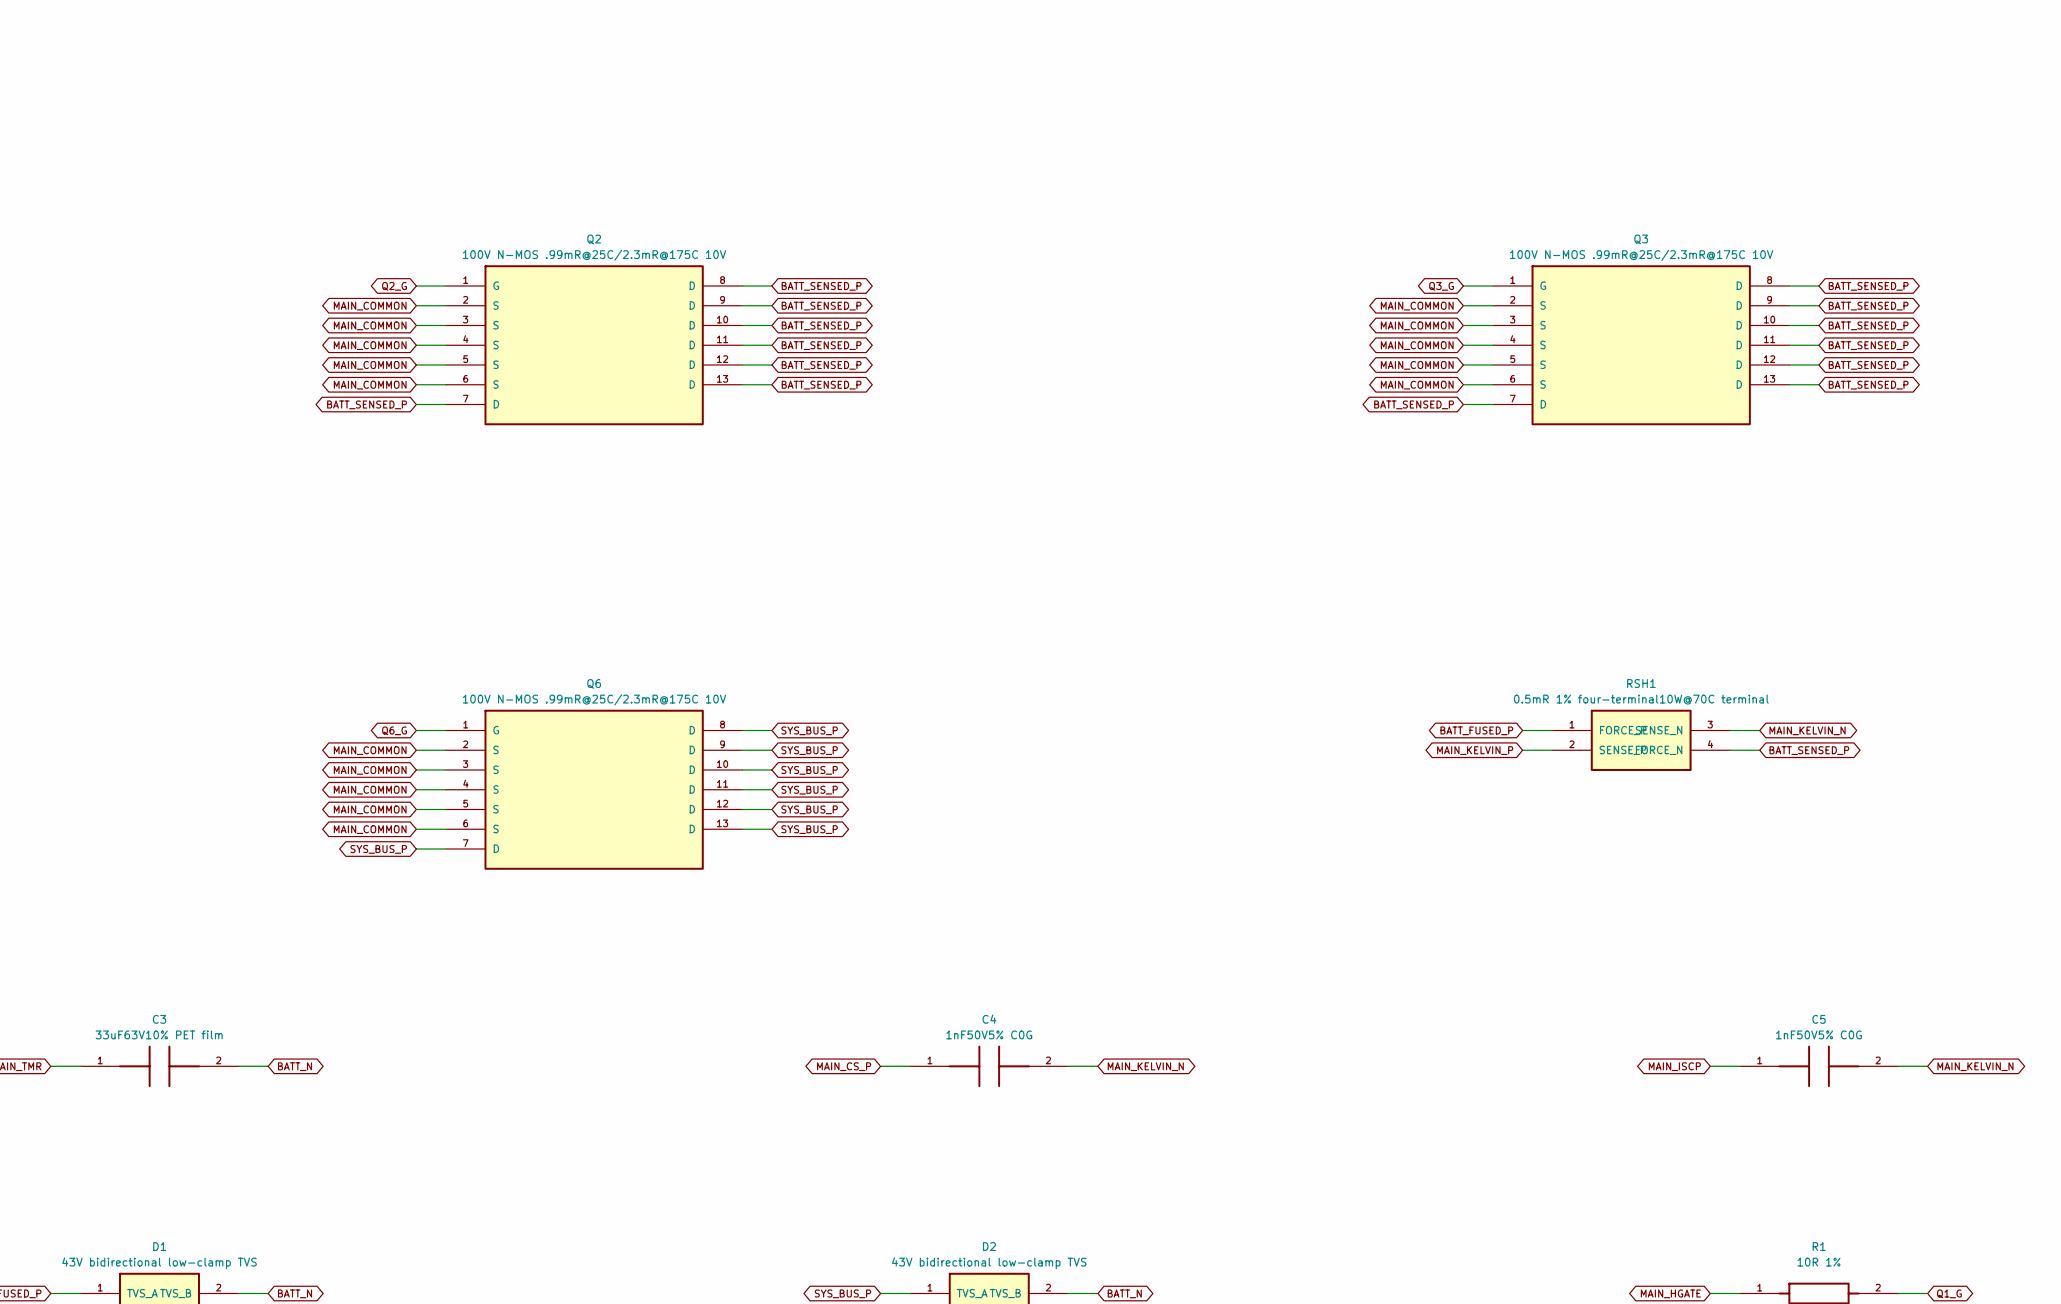
[picture p44: schematic 02_main_switch_lm74930.kicad_sch, PMU A / Main switch, part in row 1, column 2]

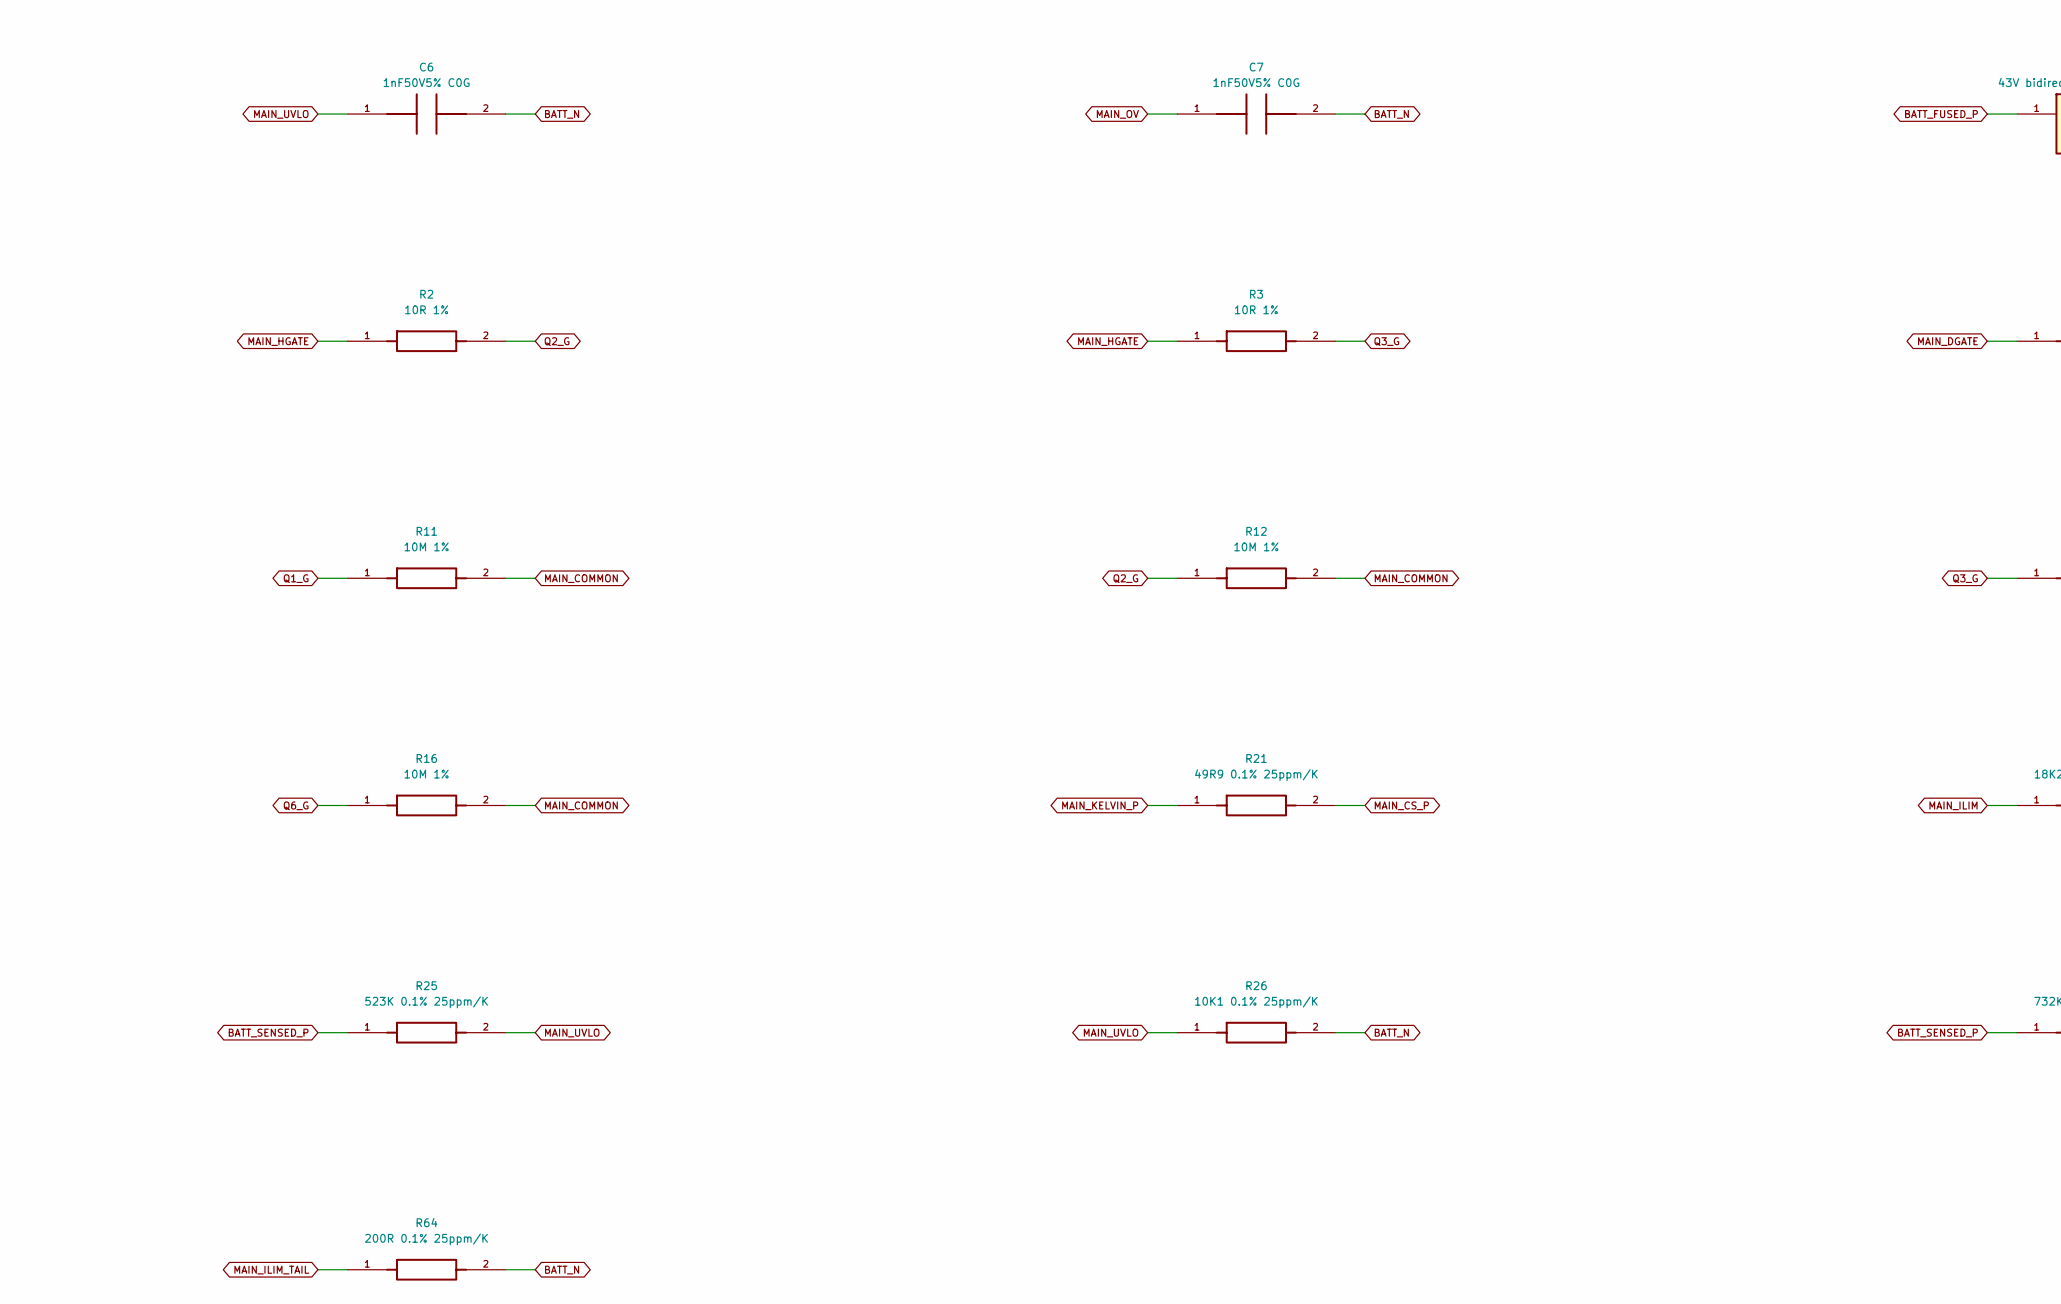
[picture p45: schematic 02_main_switch_lm74930.kicad_sch, PMU A / Main switch, part in row 2, column 1]

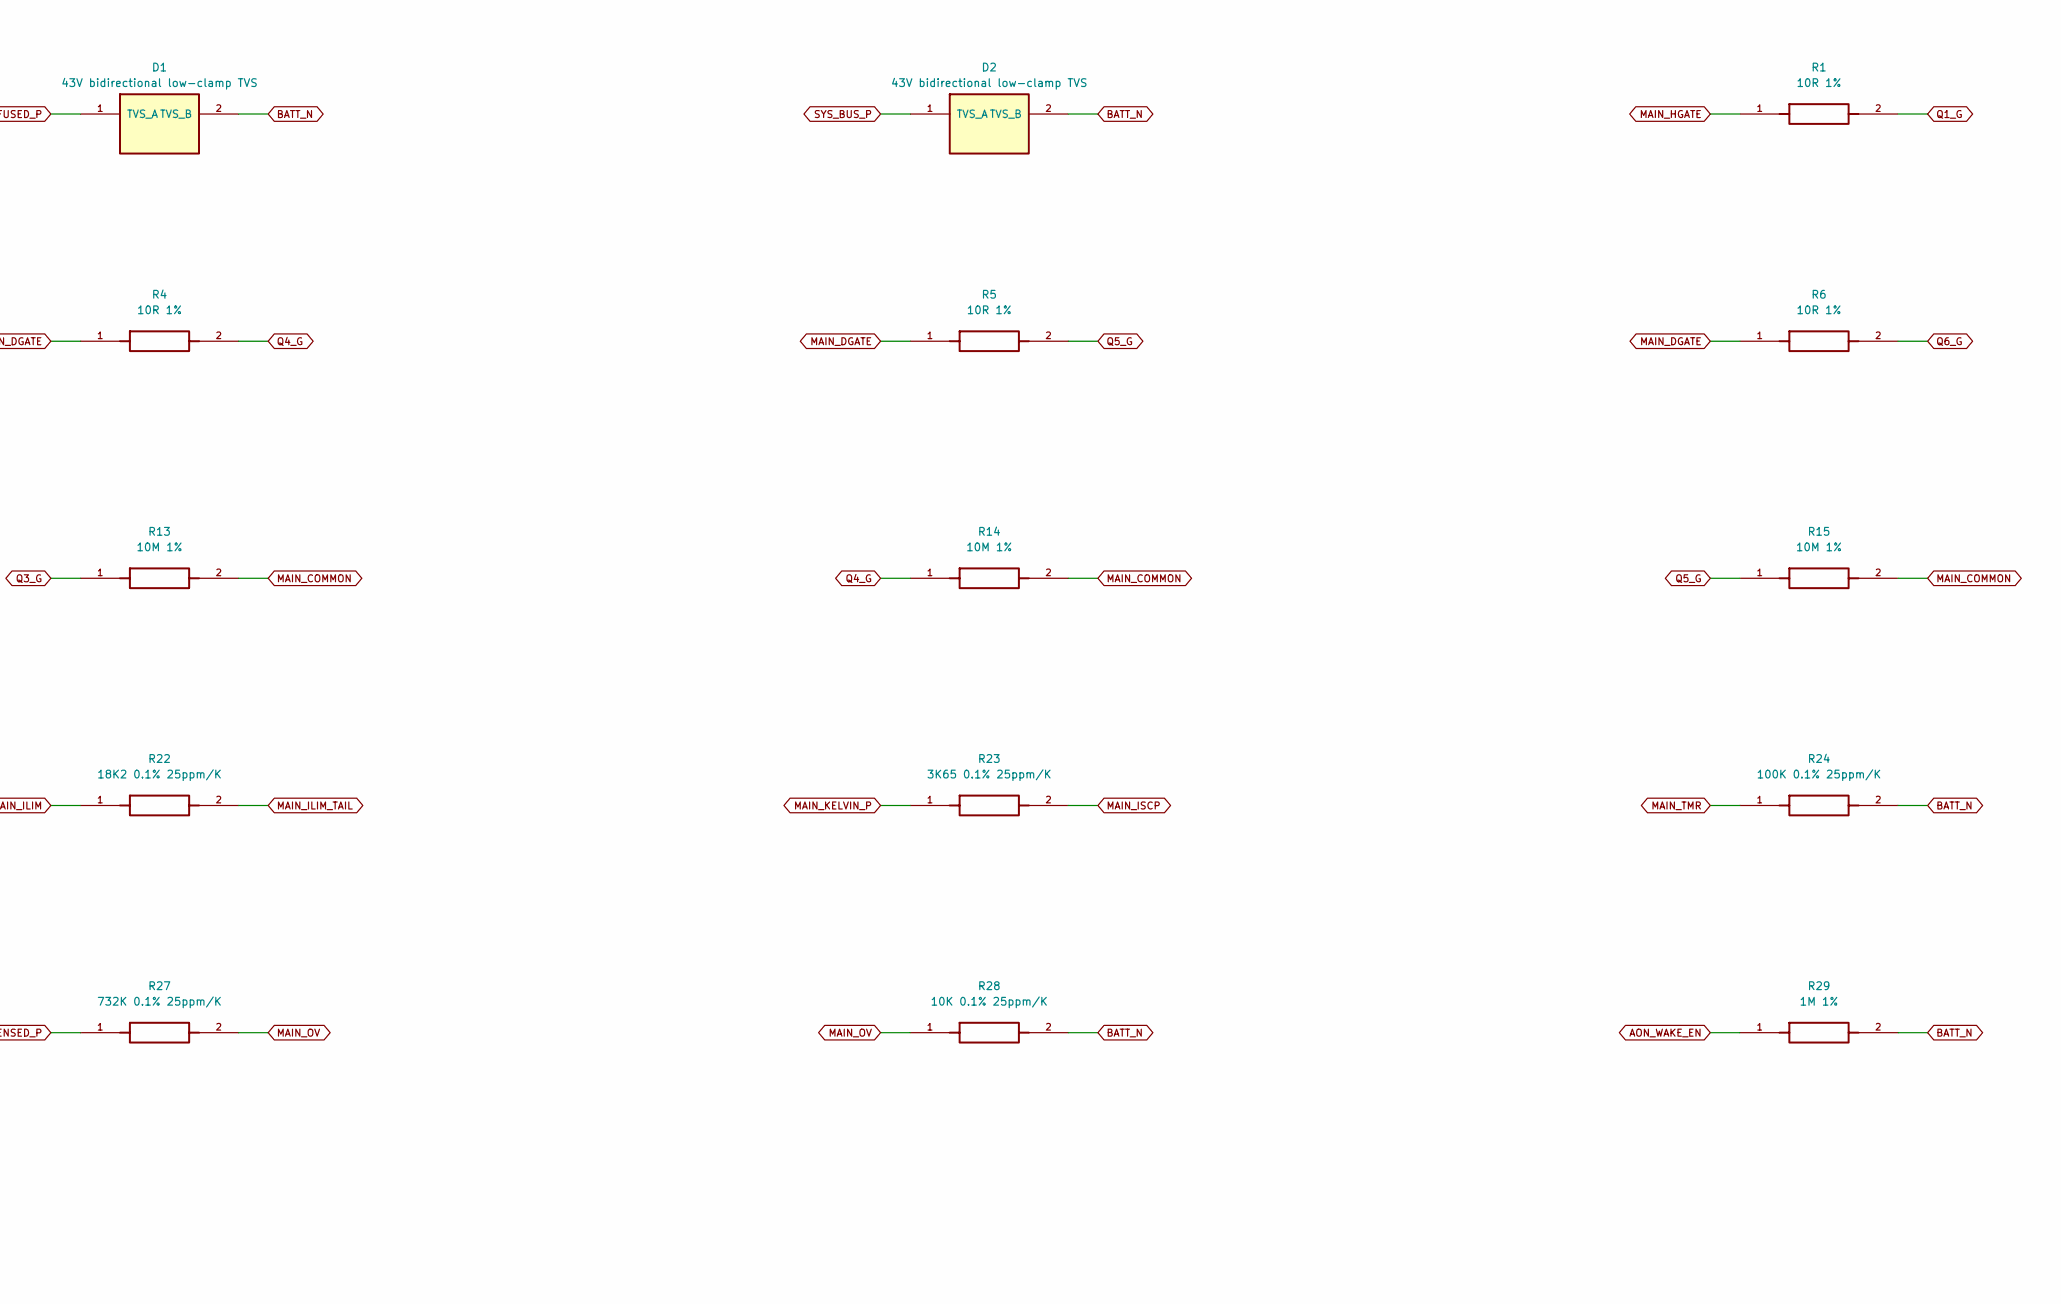
[picture p46: schematic 02_main_switch_lm74930.kicad_sch, PMU A / Main switch, part in row 2, column 2]

Parts:
C1: 100nF100V X7R; C_0805_2012Metric; MPN GRM21BR72A104KA01L
C2: 1uF25V X7R; C_1206_3216Metric; MPN C1206C105K3RACTU
C3: 33uF63V10% PET film; C_Rect_L31.5mm_W13mm_P27.5mm; MPN MKS4C053306D00KSSD
C4, C5, C6, C7: 1nF50V5% C0G; C_0805_2012Metric; MPN C0805C102J5GACTU
D1, D2: 43V bidirectional low-clamp TVS; PTVS1_DFN8x6; MPN PTVS1-043C-H
Q1, Q2, Q3, Q4, Q5, Q6: 100V N-MOS .99mR@25C/2.3mR@175C 10V; CCPAK1212_SOT8000A; MPN PSMN1R0-100ASFJ
R1, R2, R3, R4, R5, R6: 10R 1%; R_0805_2012Metric; MPN RC0805FR-0710RL
R11, R12, R13, R14, R15, R16: 10M 1%; R_0805_2012Metric; MPN RC0805FR-0710ML
R21: 49R9 0.1% 25ppm/K; R_0805_2012Metric; MPN RT0805BRD0749R9L
R22: 18K2 0.1% 25ppm/K; R_0805_2012Metric; MPN RT0805BRD0718K2L
R23: 3K65 0.1% 25ppm/K; R_0805_2012Metric; MPN RT0805BRD073K65L
R24: 100K 0.1% 25ppm/K; R_0805_2012Metric; MPN RT0805BRD07100KL
R25: 523K 0.1% 25ppm/K; R_0805_2012Metric; MPN RT0805BRD07523KL
R26: 10K1 0.1% 25ppm/K; R_0805_2012Metric; MPN RT0805BRD0710K1L
R27: 732K 0.1% 25ppm/K; R_0805_2012Metric; MPN RT0805BRD07732KL
R28: 10K 0.1% 25ppm/K; R_0805_2012Metric; MPN RT0805BRD0710KL
R29: 1M 1%; R_0805_2012Metric; MPN RC0805FR-071ML
R64: 200R 0.1% 25ppm/K; R_0805_2012Metric; MPN RT0805BRD07200RL
RSH1: 0.5mR 1% four-terminal10W@70C terminal; CSS4J_4026_Kelvin; MPN CSS4J-4026R-L500F
U1: LM74930-Q1; VQFN_RGE24_4x4_P0.5_EP_FLOAT; MPN LM74930QRGERQ1

Connections:
AON_WAKE_EN: R29.1, U1.6 (EN), U1.7 (MODE); also elsewhere on the board
BATT_FUSED_P: D1.1 (TVS_A), RSH1.1 (FORCE_P); also elsewhere on the board
BATT_N: C1.2, C3.2, C6.2, C7.2, D1.2 (TVS_B), D2.2 (TVS_B), R24.2, R26.2, R28.2, R29.2, R64.2, U1.13 (GND), U1.16 (OVCLAMP); also elsewhere on the board
BATT_SENSED_P: C1.1, C2.2, Q1.7 (D), Q1.8 (D), Q1.9 (D), Q1.10 (D), Q1.11 (D), Q1.12 (D), Q1.13 (D), Q2.7 (D), Q2.8 (D), Q2.9 (D), Q2.10 (D), Q2.11 (D), Q2.12 (D), Q2.13 (D), Q3.7 (D), Q3.8 (D), Q3.9 (D), Q3.10 (D), Q3.11 (D), Q3.12 (D), Q3.13 (D), R25.1, R27.1, RSH1.4 (FORCE_N), U1.22 (VS); also elsewhere on the board
MAIN_CAP: C2.1, U1.23 (CAP)
MAIN_COMMON: Q1.2 (S), Q1.3 (S), Q1.4 (S), Q1.5 (S), Q1.6 (S), Q2.2 (S), Q2.3 (S), Q2.4 (S), Q2.5 (S), Q2.6 (S), Q3.2 (S), Q3.3 (S), Q3.4 (S), Q3.5 (S), Q3.6 (S), Q4.2 (S), Q4.3 (S), Q4.4 (S), Q4.5 (S), Q4.6 (S), Q5.2 (S), Q5.3 (S), Q5.4 (S), Q5.5 (S), Q5.6 (S), Q6.2 (S), Q6.3 (S), Q6.4 (S), Q6.5 (S), Q6.6 (S), R11.2, R12.2, R13.2, R14.2, R15.2, R16.2, U1.2 (A), U1.15 (OUT); also elsewhere on the board
MAIN_CS_P: C4.1, R21.2, U1.20 (CS+)
MAIN_DGATE: R4.1, R5.1, R6.1, U1.1 (DGATE)
MAIN_FAULT_N: U1.12 (FLT_N); also elsewhere on the board
MAIN_HGATE: R1.1, R2.1, R3.1, U1.14 (HGATE)
MAIN_ILIM: R22.1, U1.11 (ILIM)
MAIN_ILIM_TAIL: R22.2, R64.1
MAIN_ISCP: C5.1, R23.2, U1.18 (ISCP)
MAIN_KELVIN_N: C4.2, C5.2, RSH1.3 (SENSE_N), U1.19 (CS-); also elsewhere on the board
MAIN_KELVIN_P: R21.1, R23.1, RSH1.2 (SENSE_P); also elsewhere on the board
MAIN_OV: C7.1, R27.2, R28.1, U1.5 (OV)
MAIN_TMR: C3.1, R24.1, U1.9 (TMR); also elsewhere on the board
MAIN_UVLO: C6.1, R25.2, R26.1, U1.4 (UVLO)
Q1_G: Q1.1 (G), R1.2, R11.1
Q2_G: Q2.1 (G), R2.2, R12.1
Q3_G: Q3.1 (G), R3.2, R13.1
Q4_G: Q4.1 (G), R4.2, R14.1
Q5_G: Q5.1 (G), R5.2, R15.1
Q6_G: Q6.1 (G), R6.2, R16.1
SYS_BUS_P: D2.1 (TVS_A), Q4.7 (D), Q4.8 (D), Q4.9 (D), Q4.10 (D), Q4.11 (D), Q4.12 (D), Q4.13 (D), Q5.7 (D), Q5.8 (D), Q5.9 (D), Q5.10 (D), Q5.11 (D), Q5.12 (D), Q5.13 (D), Q6.7 (D), Q6.8 (D), Q6.9 (D), Q6.10 (D), Q6.11 (D), Q6.12 (D), Q6.13 (D), U1.24 (C); also elsewhere on the board

Notes on the sheet:
02 main switch lm74930
