chris01-byte/HomeMy/hardware/power-management-unit/rev-a2-layout-280x260/kicad/HomeMy_PMU_RevA.kicad_pcb

## KiCad design hardware/power-management-unit/rev-a2-layout-280x260/kicad/HomeMy_PMU_RevA.kicad_pcb (continued)

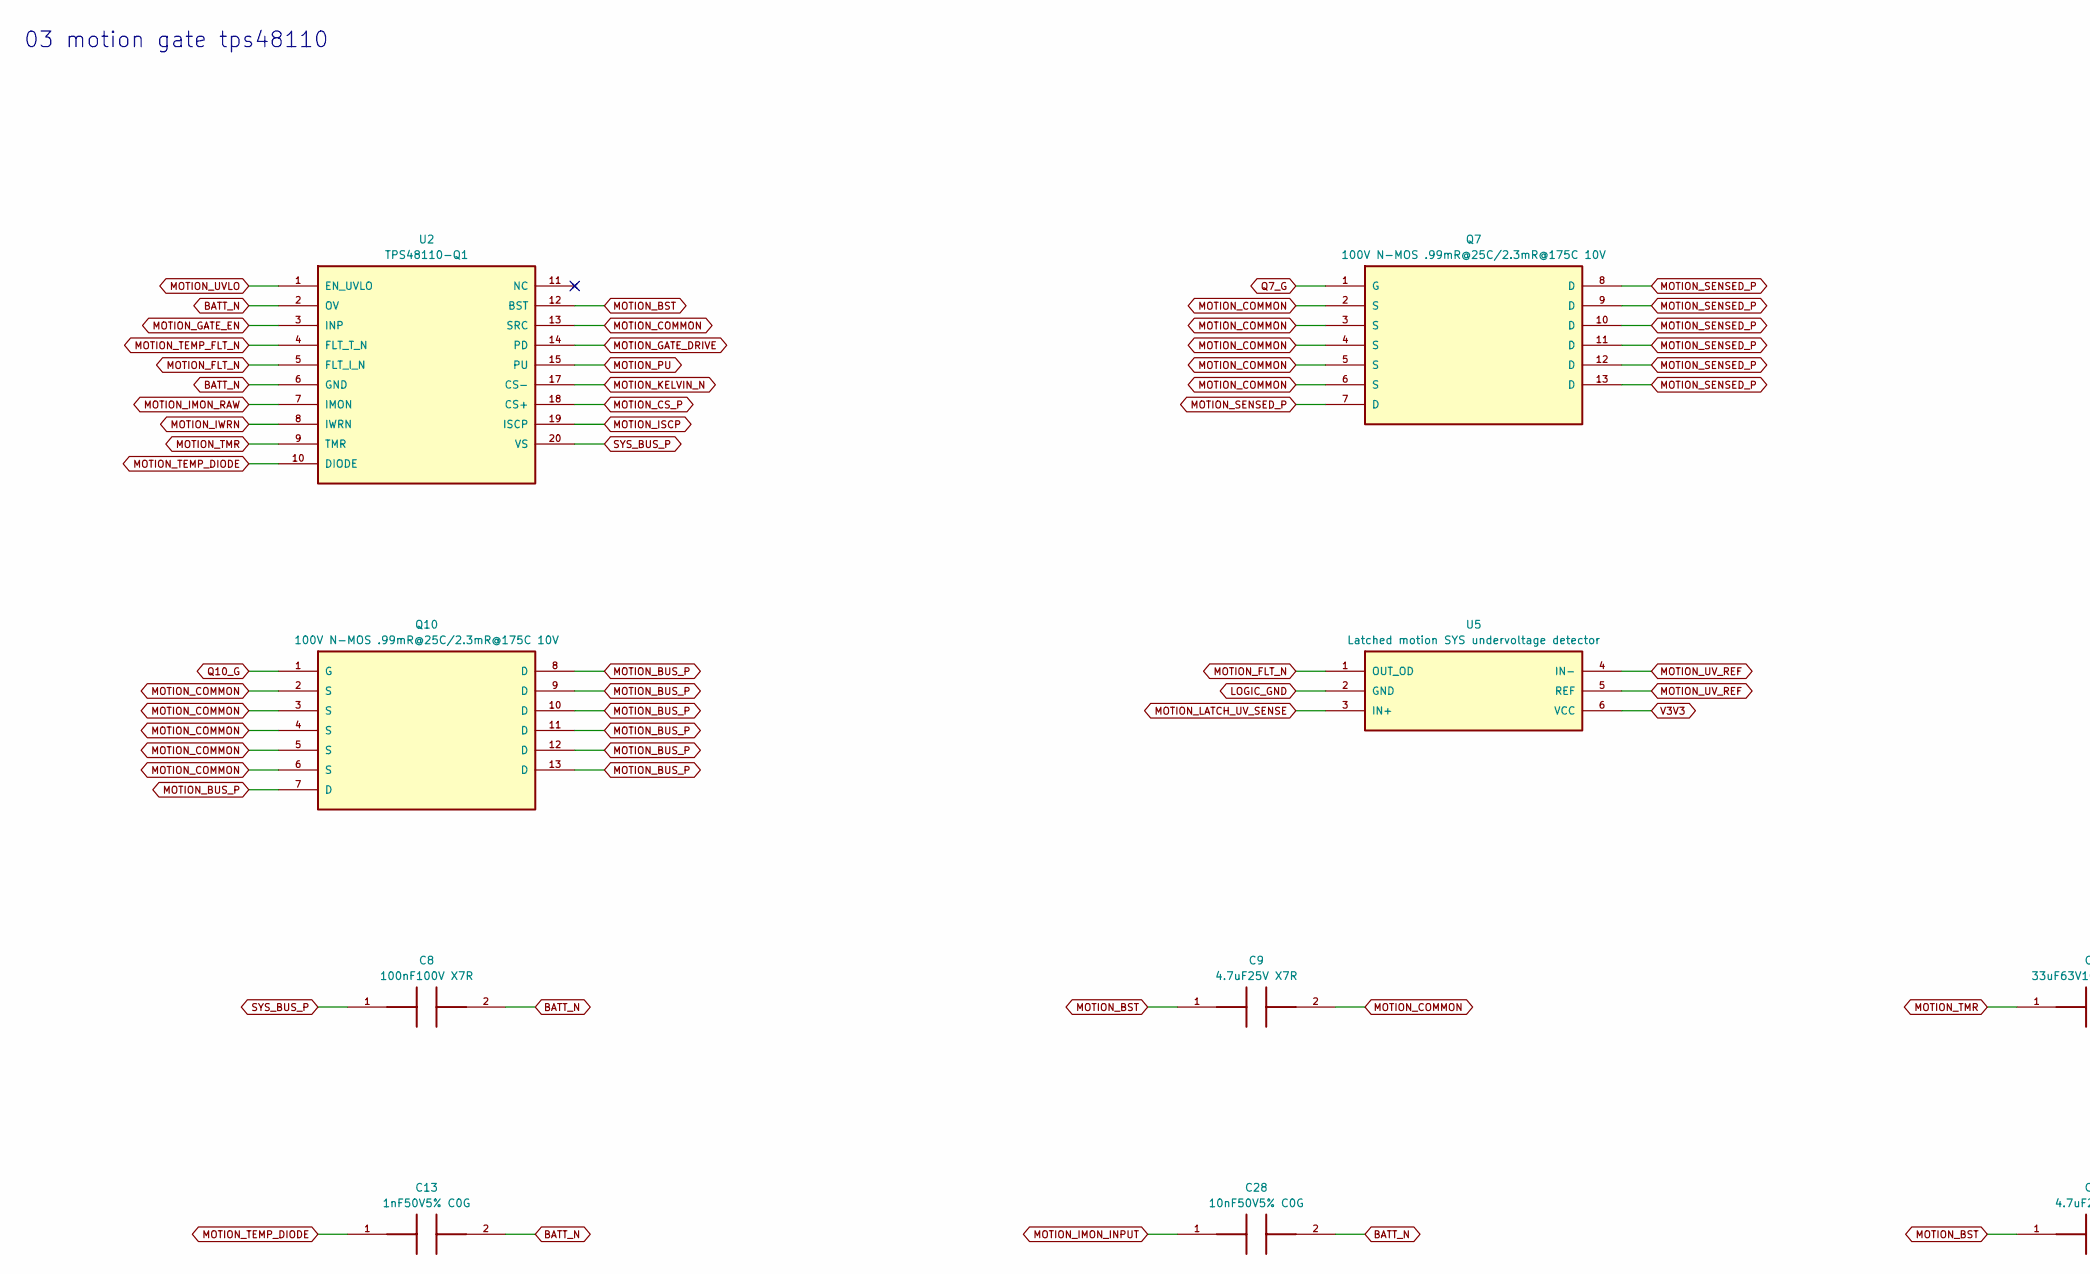
[picture p47: schematic 03_motion_gate_tps48110.kicad_sch, PMU A / Motion gate, part in row 1, column 1]

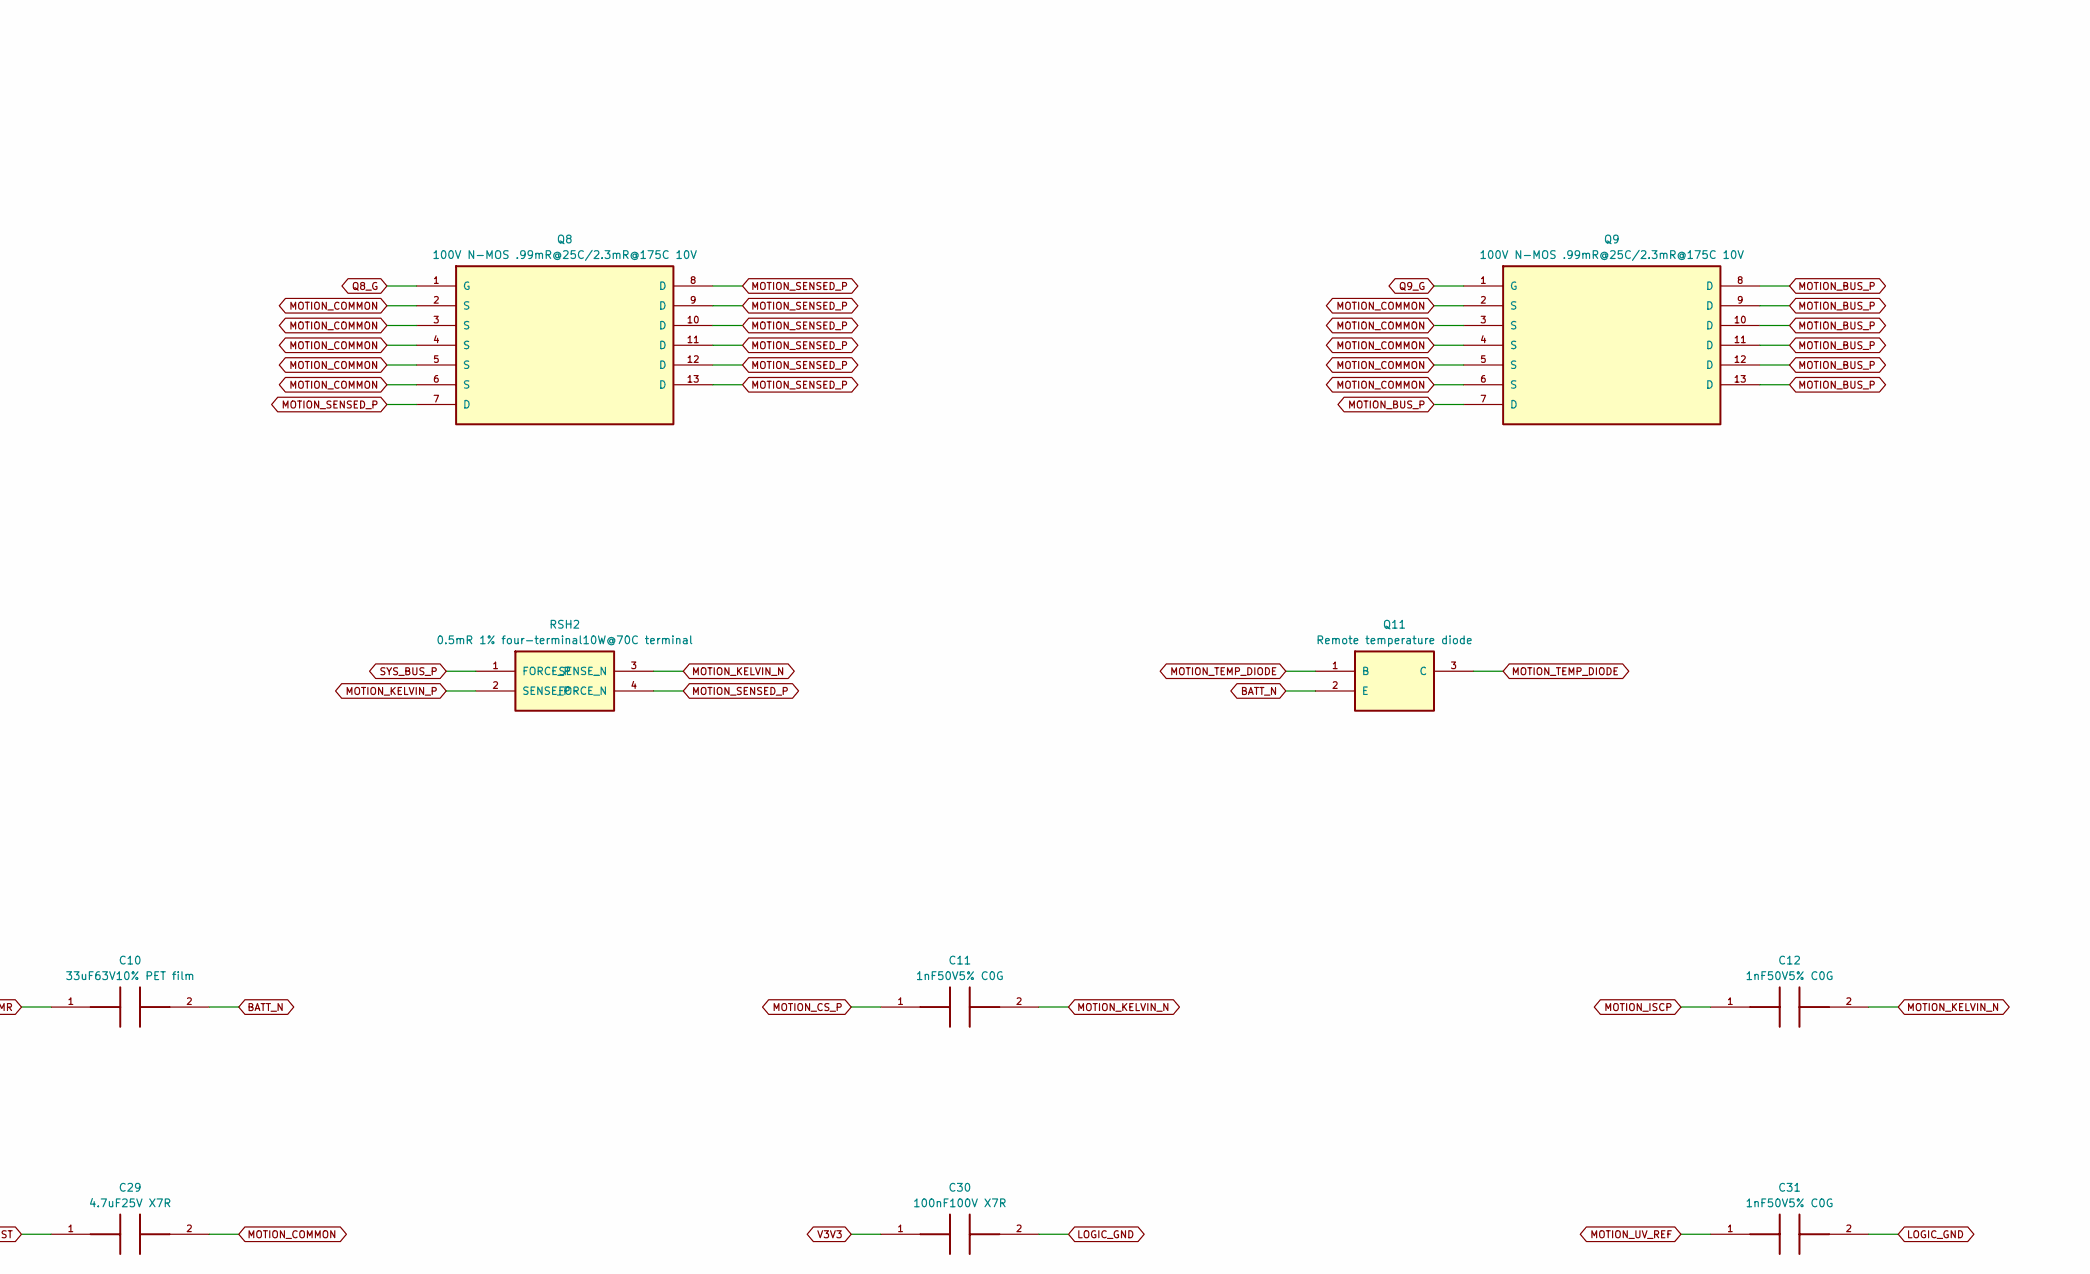
[picture p48: schematic 03_motion_gate_tps48110.kicad_sch, PMU A / Motion gate, part in row 1, column 2]

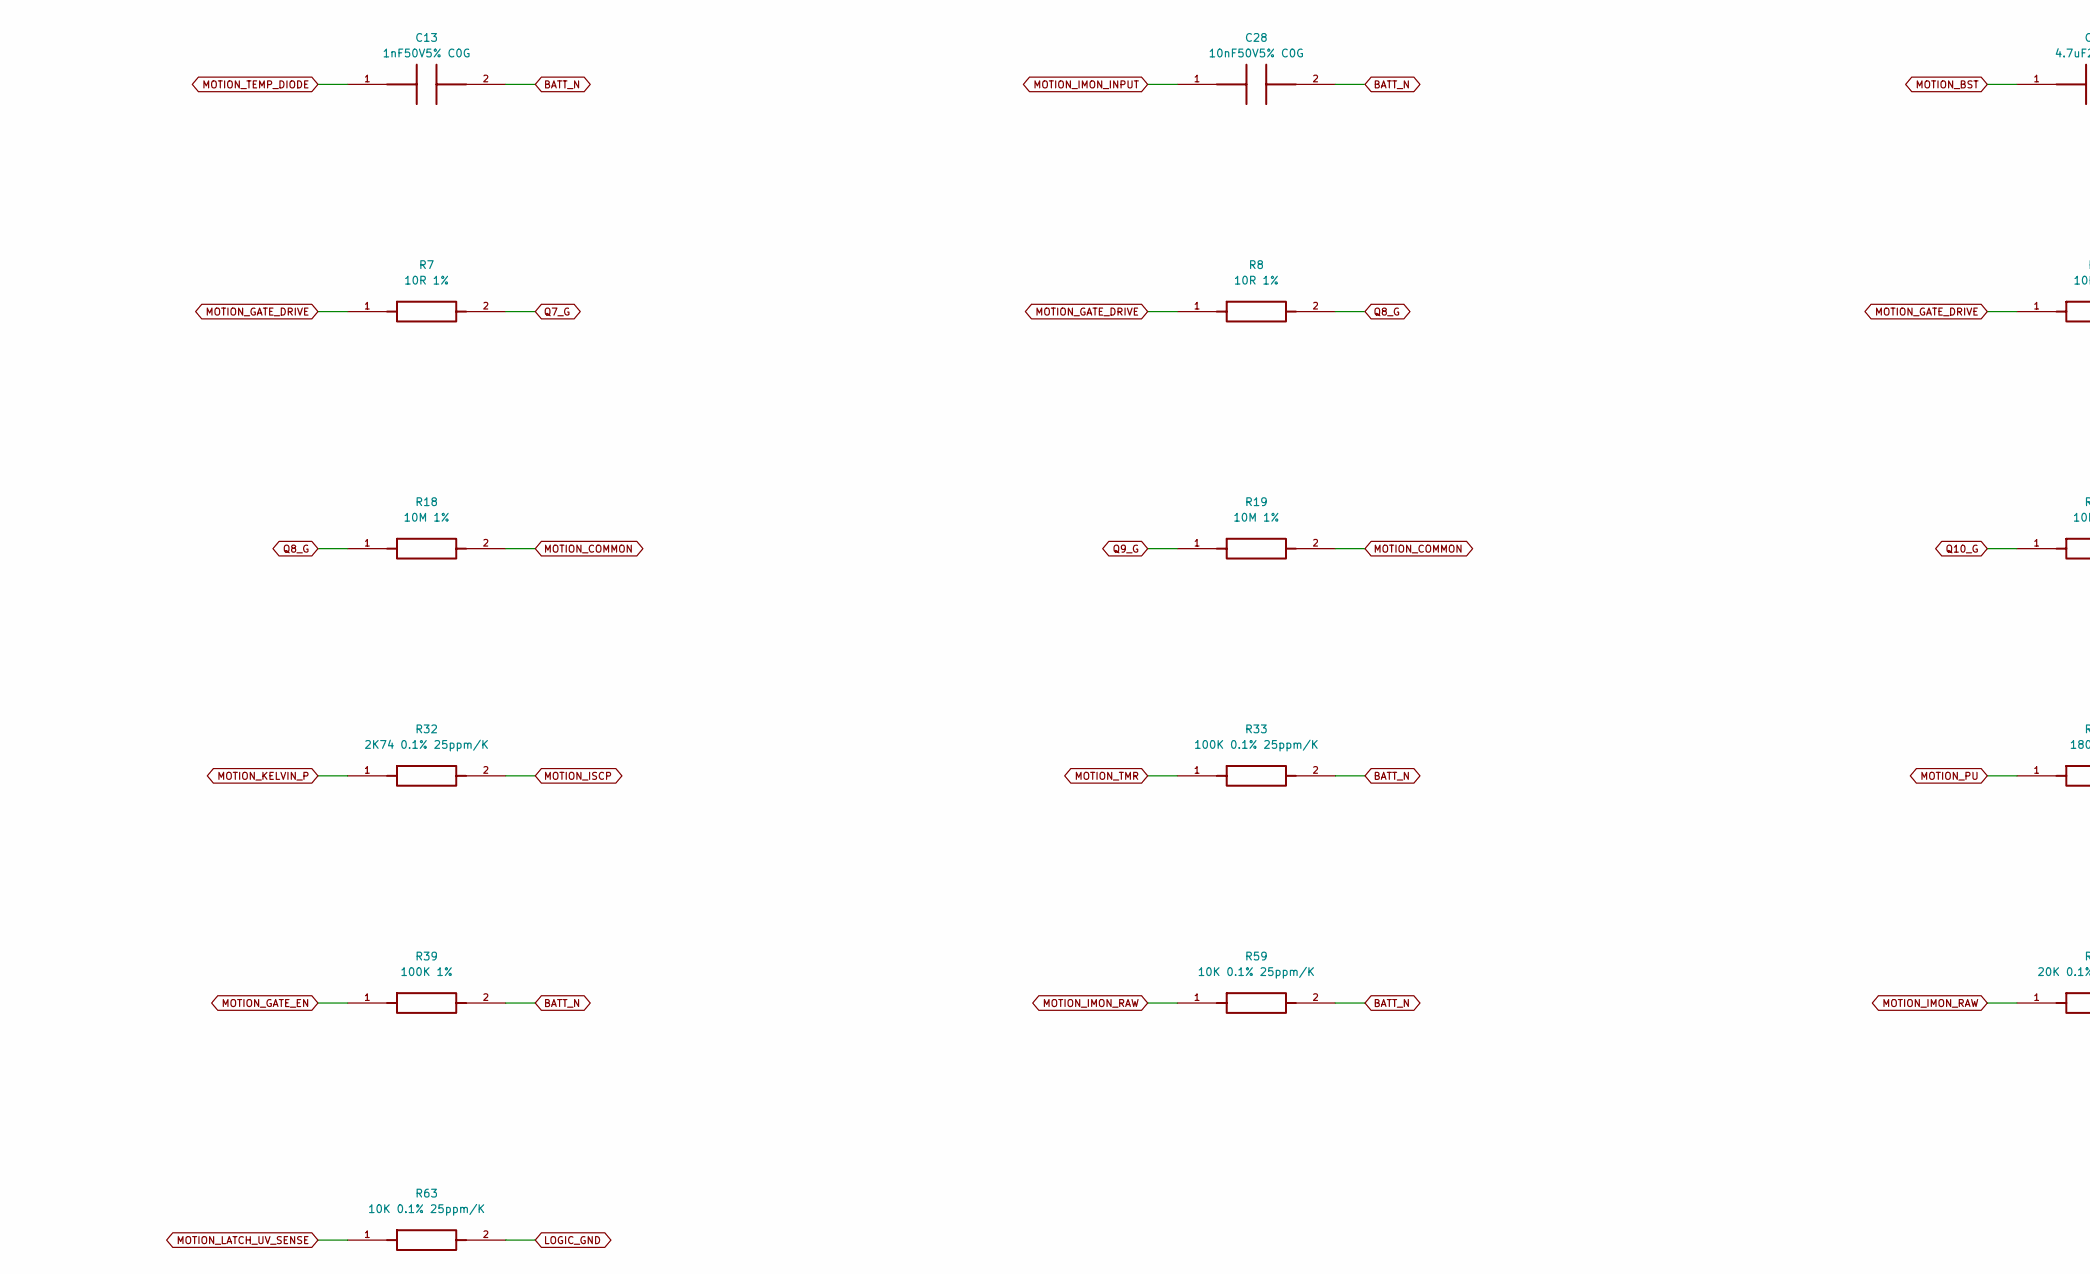
[picture p49: schematic 03_motion_gate_tps48110.kicad_sch, PMU A / Motion gate, part in row 2, column 1]

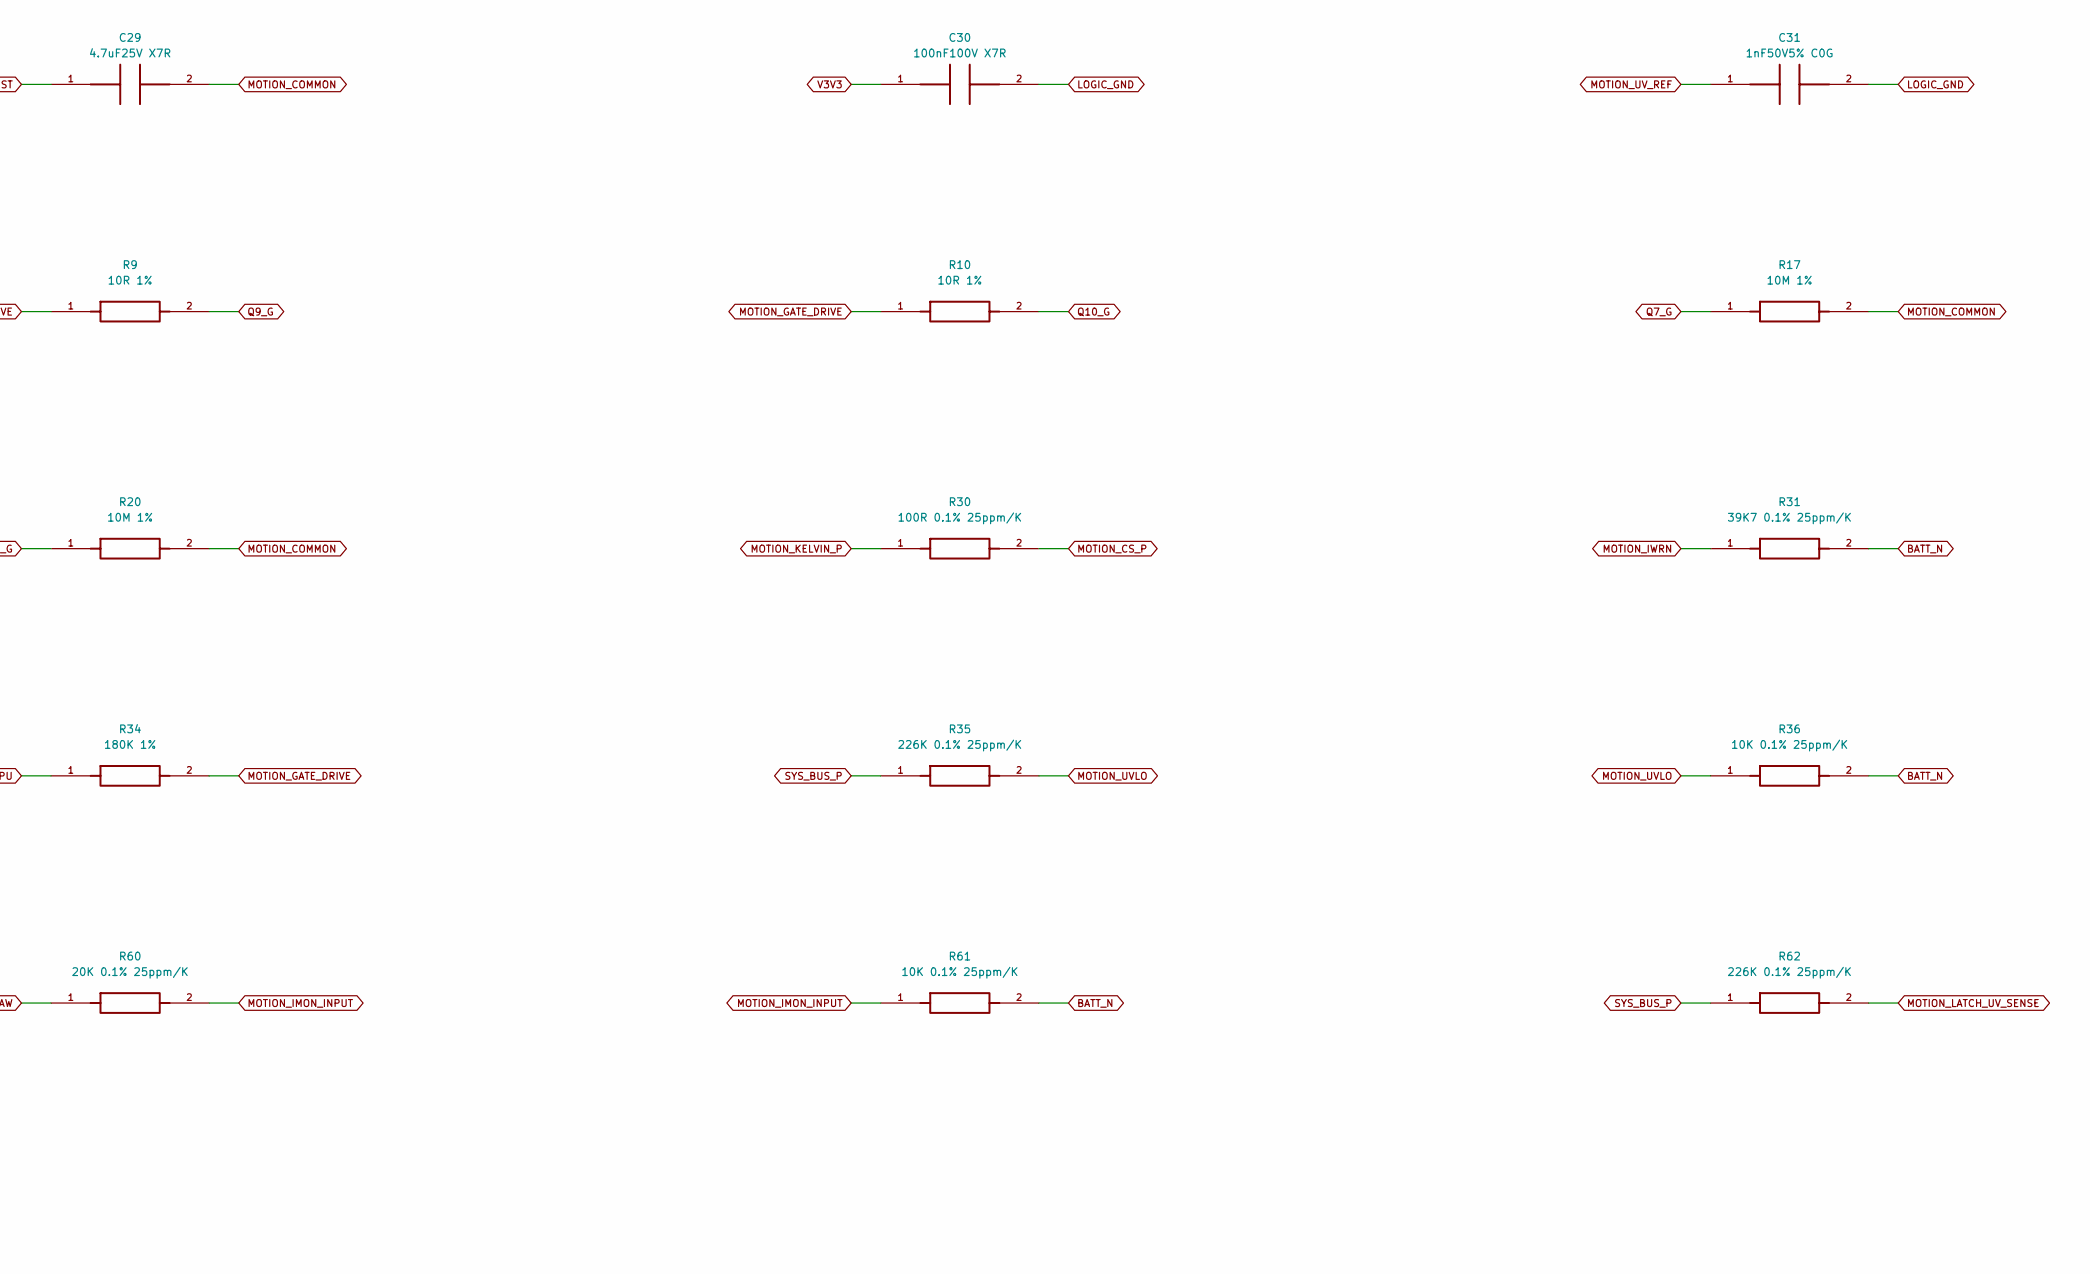
[picture p50: schematic 03_motion_gate_tps48110.kicad_sch, PMU A / Motion gate, part in row 2, column 2]

Parts:
C8, C30: 100nF100V X7R; C_0805_2012Metric; MPN GRM21BR72A104KA01L
C9, C29: 4.7uF25V X7R; C_1206_3216Metric; MPN C1206C475K3RACTU
C10: 33uF63V10% PET film; C_Rect_L31.5mm_W13mm_P27.5mm; MPN MKS4C053306D00KSSD
C11, C12, C13, C31: 1nF50V5% C0G; C_0805_2012Metric; MPN C0805C102J5GACTU
C28: 10nF50V5% C0G; C_0805_2012Metric; MPN C0805C103J5GACTU
Q7, Q8, Q9, Q10: 100V N-MOS .99mR@25C/2.3mR@175C 10V; CCPAK1212_SOT8000A; MPN PSMN1R0-100ASFJ
Q11: Remote temperature diode; SOT-23; MPN MMBT3904,215
R7, R8, R9, R10: 10R 1%; R_0805_2012Metric; MPN RC0805FR-0710RL
R17, R18, R19, R20: 10M 1%; R_0805_2012Metric; MPN RC0805FR-0710ML
R30: 100R 0.1% 25ppm/K; R_0805_2012Metric; MPN RT0805BRD07100RL
R31: 39K7 0.1% 25ppm/K; R_0805_2012Metric; MPN RT0805BRD0739K7L
R32: 2K74 0.1% 25ppm/K; R_0805_2012Metric; MPN RT0805BRD072K74L
R33: 100K 0.1% 25ppm/K; R_0805_2012Metric; MPN RT0805BRD07100KL
R34: 180K 1%; R_0805_2012Metric; MPN RC0805FR-07180KL
R35, R62: 226K 0.1% 25ppm/K; R_0805_2012Metric; MPN RT0805BRD07226KL
R36, R59, R61, R63: 10K 0.1% 25ppm/K; R_0805_2012Metric; MPN RT0805BRD0710KL
R39: 100K 1%; R_0805_2012Metric; MPN RC0805FR-07100KL
R60: 20K 0.1% 25ppm/K; R_0805_2012Metric; MPN RT0805BRD0720KL
RSH2: 0.5mR 1% four-terminal10W@70C terminal; CSS4J_4026_Kelvin; MPN CSS4J-4026R-L500F
U2: TPS48110-Q1; VSSOP_DGX19_3x5.1_P0.5_Missing16; MPN TPS48110AQDGXRQ1
U5: Latched motion SYS undervoltage detector; SOT-23-6; MPN TLV3011BIDBVR

Connections:
BATT_N: C8.2, C10.2, C13.2, C28.2, Q11.2 (E), R31.2, R33.2, R36.2, R39.2, R59.2, R61.2, U2.2 (OV), U2.6 (GND); also elsewhere on the board
LOGIC_GND: C30.2, C31.2, R63.2, U5.2 (GND); also elsewhere on the board
MOTION_BST: C9.1, C29.1, U2.12 (BST)
MOTION_BUS_P: Q9.7 (D), Q9.8 (D), Q9.9 (D), Q9.10 (D), Q9.11 (D), Q9.12 (D), Q9.13 (D), Q10.7 (D), Q10.8 (D), Q10.9 (D), Q10.10 (D), Q10.11 (D), Q10.12 (D), Q10.13 (D); also elsewhere on the board
MOTION_COMMON: C9.2, C29.2, Q7.2 (S), Q7.3 (S), Q7.4 (S), Q7.5 (S), Q7.6 (S), Q8.2 (S), Q8.3 (S), Q8.4 (S), Q8.5 (S), Q8.6 (S), Q9.2 (S), Q9.3 (S), Q9.4 (S), Q9.5 (S), Q9.6 (S), Q10.2 (S), Q10.3 (S), Q10.4 (S), Q10.5 (S), Q10.6 (S), R17.2, R18.2, R19.2, R20.2, U2.13 (SRC); also elsewhere on the board
MOTION_CS_P: C11.1, R30.2, U2.18 (CS+)
MOTION_FLT_N: U2.5 (FLT_I_N), U5.1 (OUT_OD); also elsewhere on the board
MOTION_GATE_DRIVE: R7.1, R8.1, R9.1, R10.1, R34.2, U2.14 (PD)
MOTION_GATE_EN: R39.1, U2.3 (INP); also elsewhere on the board
MOTION_IMON_INPUT: C28.1, R60.2, R61.1; also elsewhere on the board
MOTION_IMON_RAW: R59.1, R60.1, U2.7 (IMON)
MOTION_ISCP: C12.1, R32.2, U2.19 (ISCP)
MOTION_IWRN: R31.1, U2.8 (IWRN)
MOTION_KELVIN_N: C11.2, C12.2, RSH2.3 (SENSE_N), U2.17 (CS-); also elsewhere on the board
MOTION_KELVIN_P: R30.1, R32.1, RSH2.2 (SENSE_P); also elsewhere on the board
MOTION_LATCH_UV_SENSE: R62.2, R63.1, U5.3 (IN+)
MOTION_PU: R34.1, U2.15 (PU)
MOTION_SENSED_P: Q7.7 (D), Q7.8 (D), Q7.9 (D), Q7.10 (D), Q7.11 (D), Q7.12 (D), Q7.13 (D), Q8.7 (D), Q8.8 (D), Q8.9 (D), Q8.10 (D), Q8.11 (D), Q8.12 (D), Q8.13 (D), RSH2.4 (FORCE_N); also elsewhere on the board
MOTION_TEMP_DIODE: C13.1, Q11.1 (B), Q11.3 (C), U2.10 (DIODE)
MOTION_TEMP_FLT_N: U2.4 (FLT_T_N); also elsewhere on the board
MOTION_TMR: C10.1, R33.1, U2.9 (TMR); also elsewhere on the board
MOTION_UVLO: R35.2, R36.1, U2.1 (EN_UVLO)
MOTION_UV_REF: C31.1, U5.4 (IN-), U5.5 (REF)
Q7_G: Q7.1 (G), R7.2, R17.1
Q8_G: Q8.1 (G), R8.2, R18.1
Q9_G: Q9.1 (G), R9.2, R19.1
Q10_G: Q10.1 (G), R10.2, R20.1
SYS_BUS_P: C8.1, R35.1, R62.1, RSH2.1 (FORCE_P), U2.20 (VS); also elsewhere on the board
V3V3: C30.1, U5.6 (VCC); also elsewhere on the board

Notes on the sheet:
03 motion gate tps48110
