chris01-byte/HomeMy/hardware/power-management-unit/rev-a2-layout-280x260/kicad/HomeMy_PMU_RevA.kicad_pcb

## KiCad design hardware/power-management-unit/rev-a2-layout-280x260/kicad/HomeMy_PMU_RevA.kicad_pcb (continued)

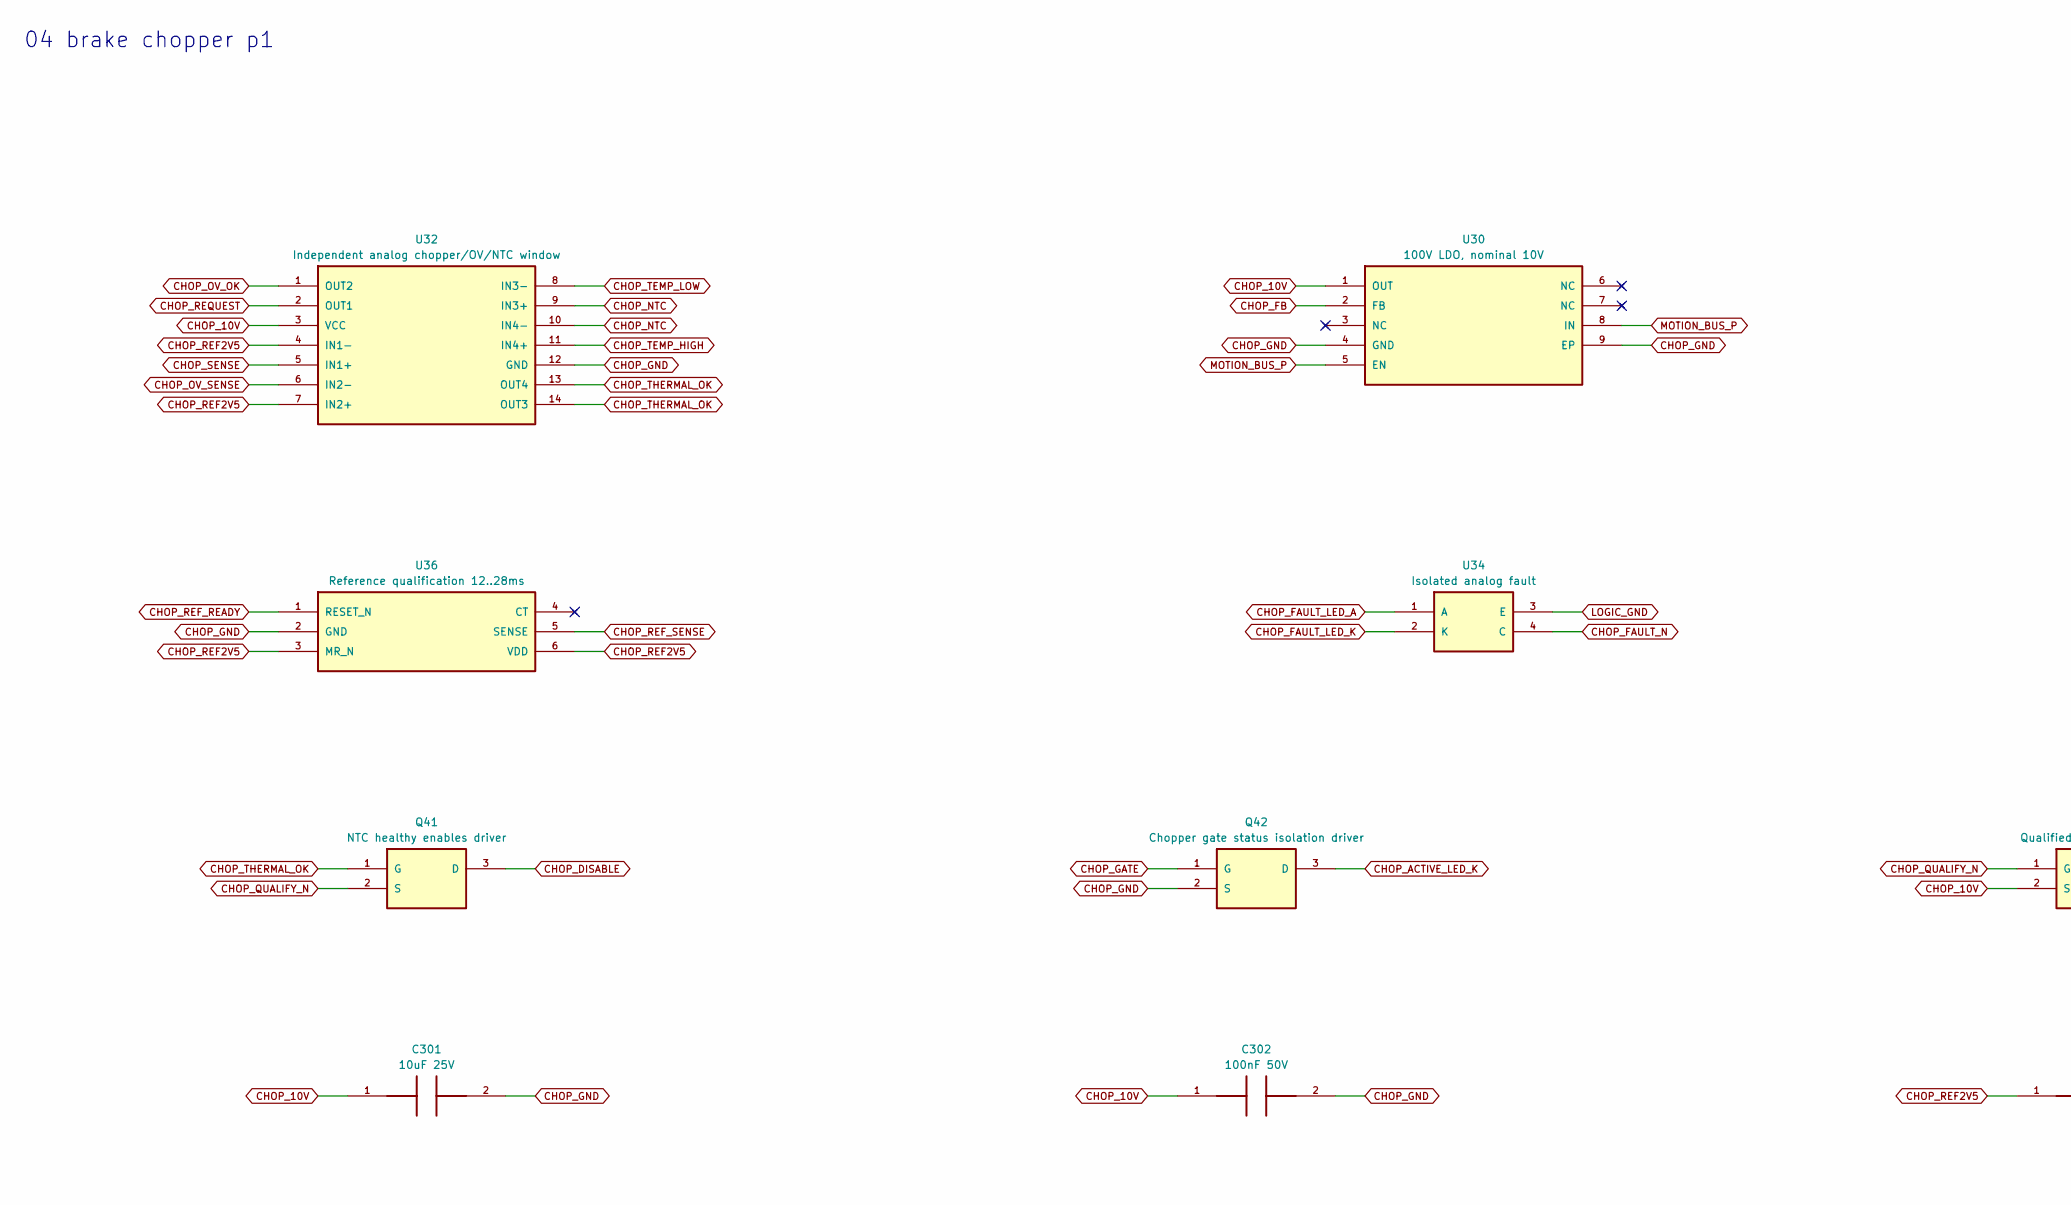
[picture p51: schematic 04_brake_chopper_p1.kicad_sch, PMU A / Brake chopper / 1, part in row 1, column 1]

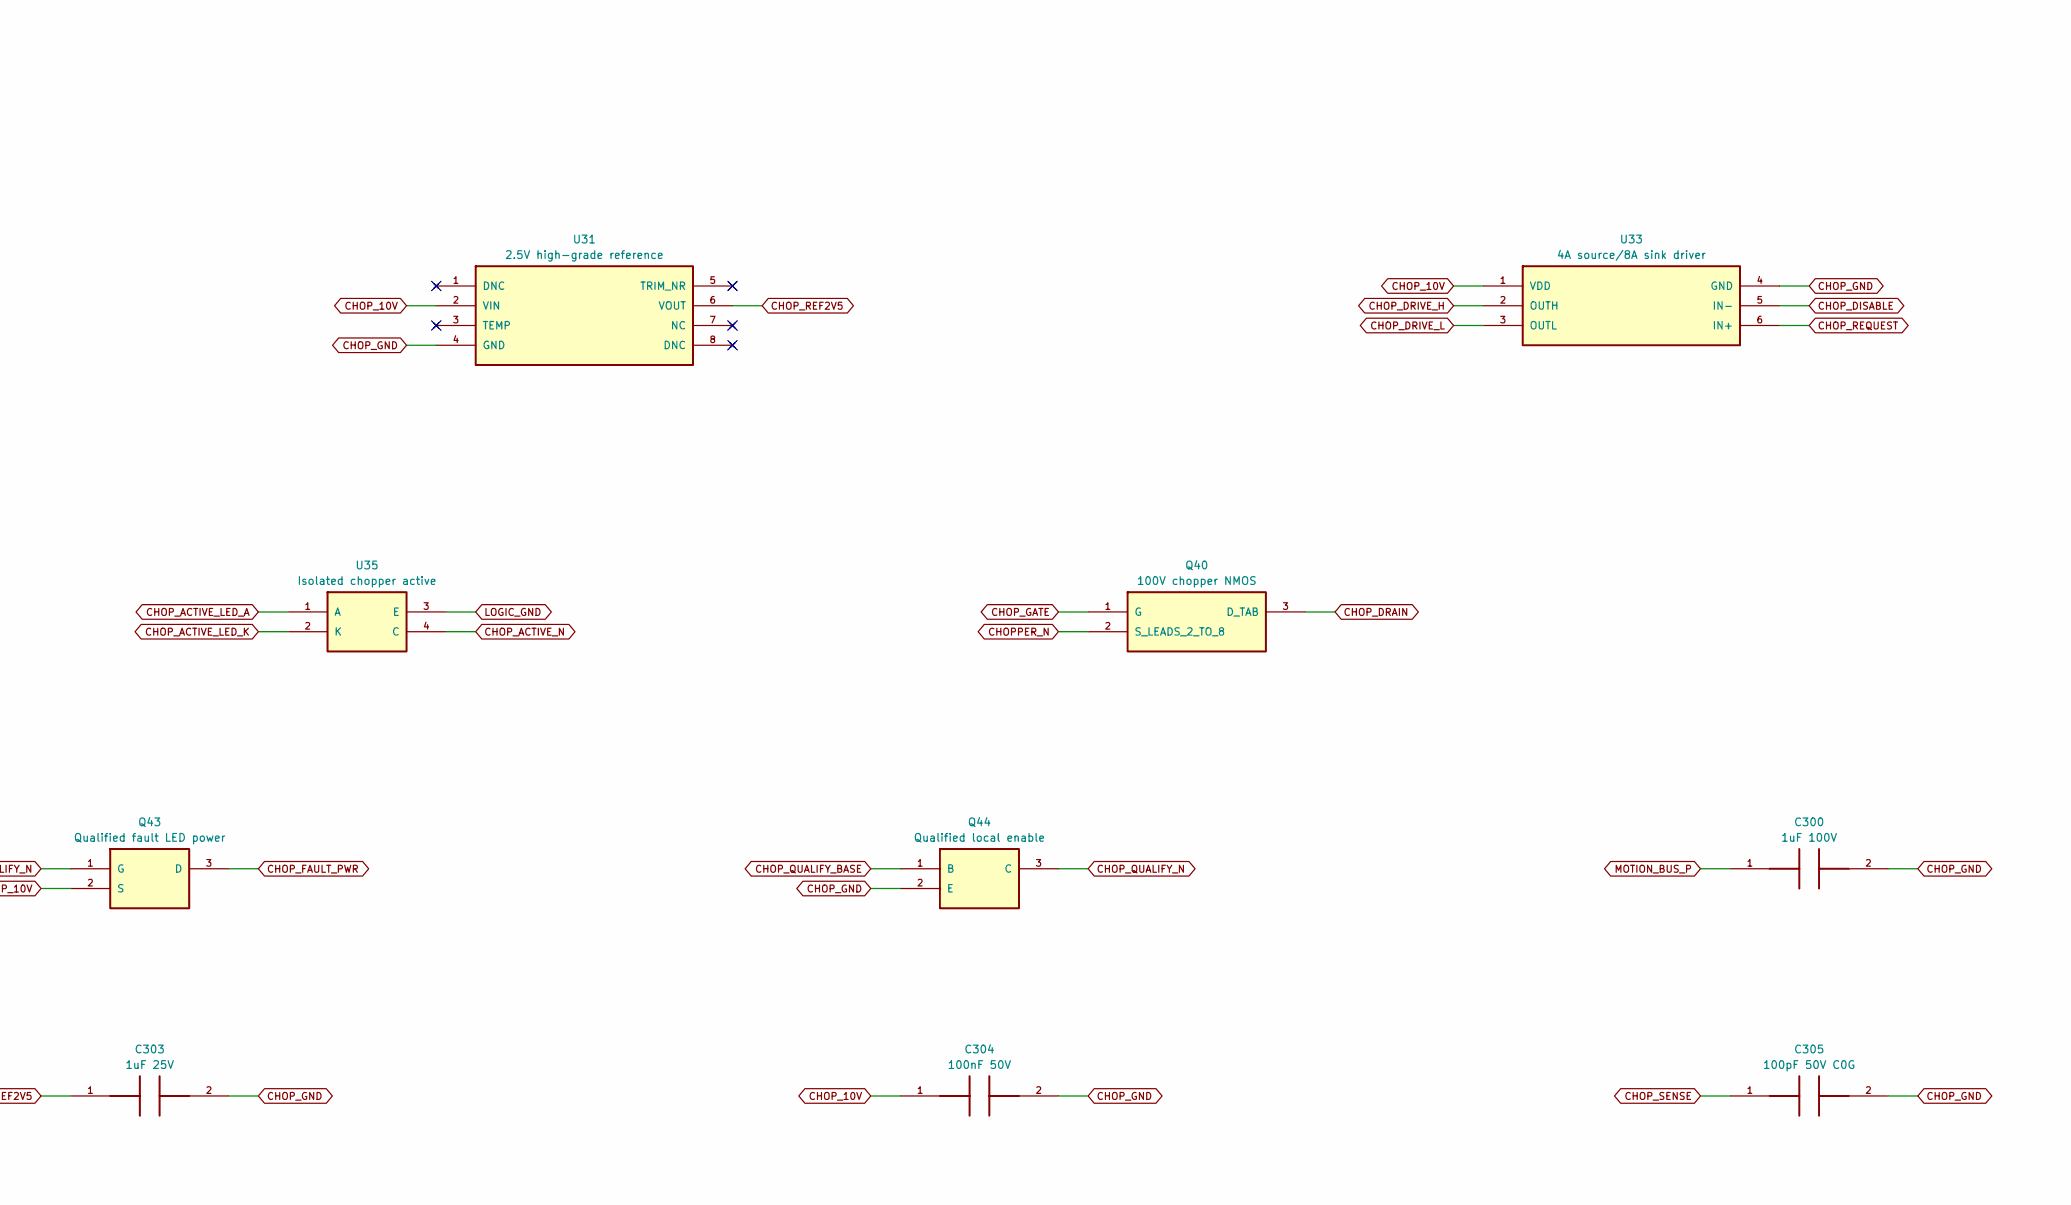
[picture p52: schematic 04_brake_chopper_p1.kicad_sch, PMU A / Brake chopper / 1, part in row 1, column 2]

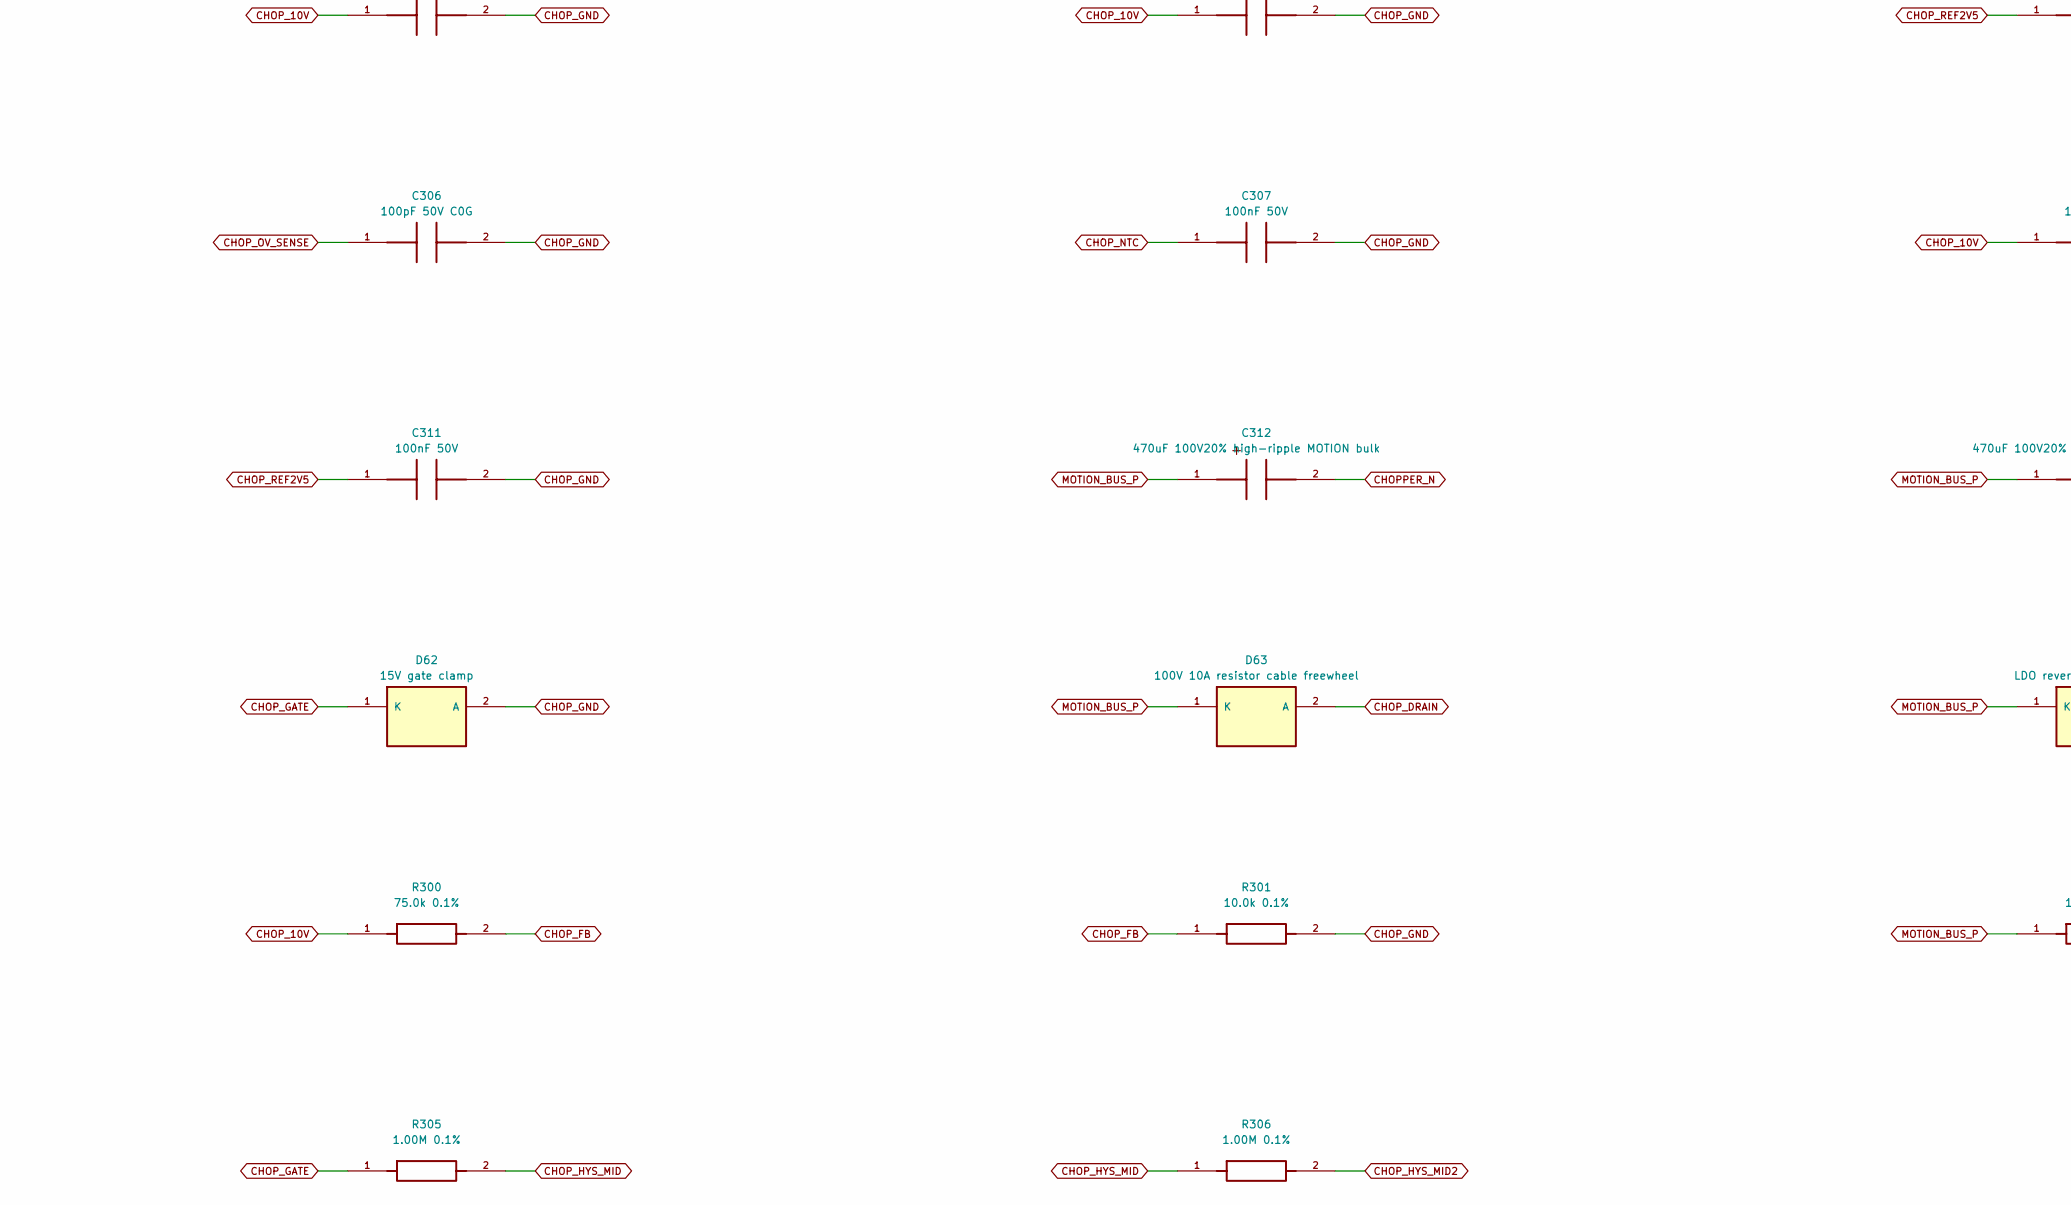
[picture p53: schematic 04_brake_chopper_p1.kicad_sch, PMU A / Brake chopper / 1, part in row 2, column 1]

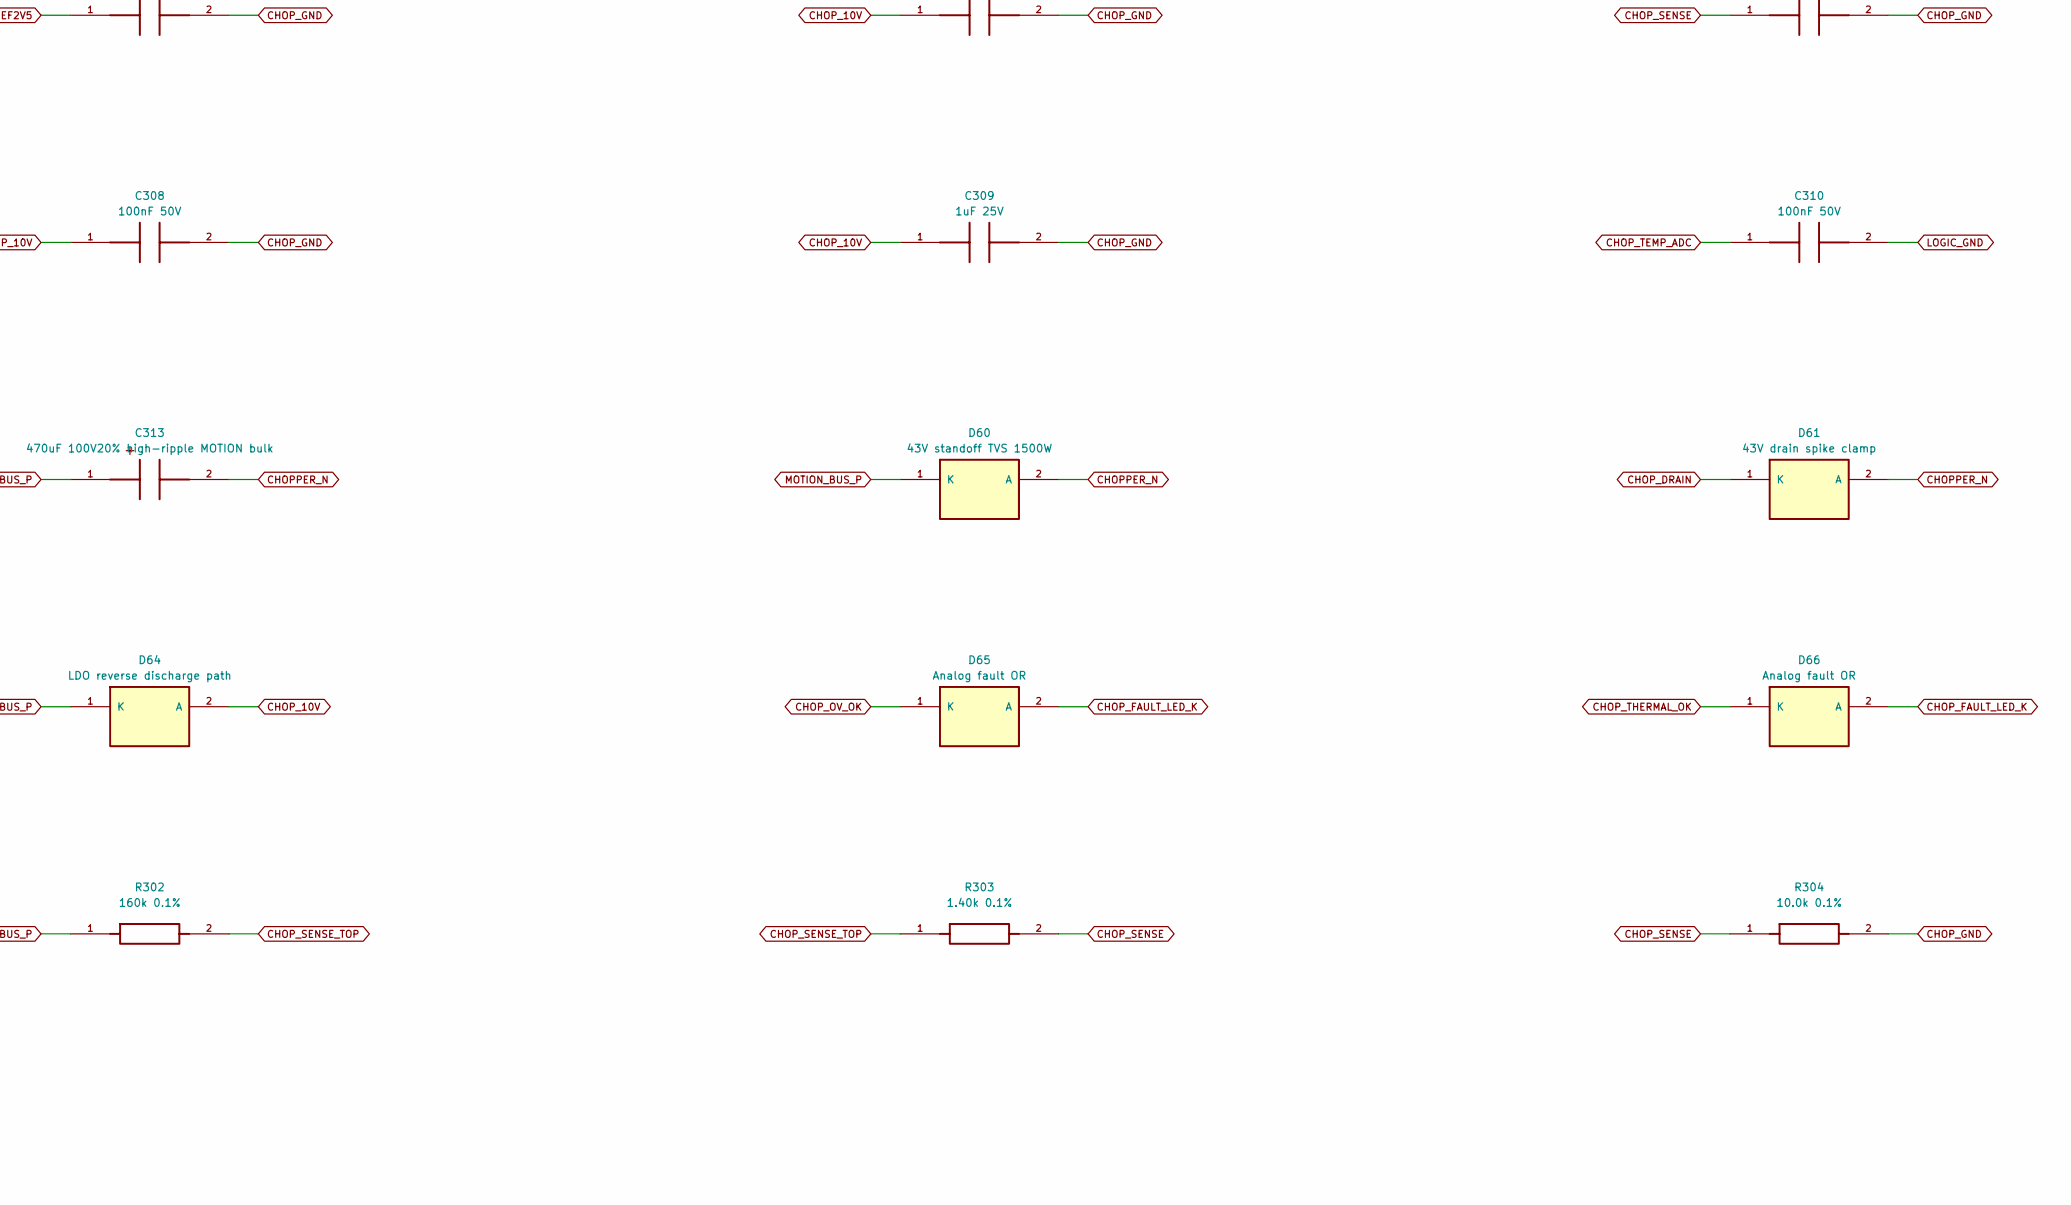
[picture p54: schematic 04_brake_chopper_p1.kicad_sch, PMU A / Brake chopper / 1, part in row 2, column 2]

Parts:
C300: 1uF 100V; C_1206_3216Metric; MPN C3216X7R2A105K160AB
C301: 10uF 25V; C_1210_3225Metric; MPN GRM32ER71E106KA12L
C302, C304, C307, C308, C310, C311: 100nF 50V; C_0603_1608Metric; MPN GRM188R71H104KA93D
C303, C309: 1uF 25V; C_0805_2012Metric; MPN GRM21BR71E105KA99L
C305, C306: 100pF 50V C0G; C_0603_1608Metric; MPN GRM1885C1H101JA01D
C312, C313: 470uF 100V20% high-ripple MOTION bulk; CP_Radial_D12.5mm_P5.00mm; MPN EKYC101ELL471MK35S
D60: 43V standoff TVS 1500W; D_SMC; MPN SMCJ43A
D61: 43V drain spike clamp; D_SMC; MPN SMCJ43A
D62: 15V gate clamp; D_SOD-123F; MPN BZT52H-C15,115
D63: 100V 10A resistor cable freewheel; TO-220-2_Vertical; MPN MBR10100-M3/4W
D64: LDO reverse discharge path; D_SOD-323; MPN 1N4148WS-E3-08
D65, D66: Analog fault OR; D_SOD-323; MPN 1N4148WS-E3-08
Q40: 100V chopper NMOS; Infineon_PG-HSOF-8-1; MPN IPT015N10N5ATMA1
Q41: NTC healthy enables driver; SOT-23; MPN 2N7002,215
Q42: Chopper gate status isolation driver; SOT-23; MPN 2N7002,215
Q43: Qualified fault LED power; SOT-23; MPN BSS84,215
Q44: Qualified local enable; SOT-23; MPN MMBT3904,215
R300: 75.0k 0.1%; R_0805_2012Metric; MPN TNPW080575K0BEEA
R301, R304: 10.0k 0.1%; R_0805_2012Metric; MPN TNPW080510K0BEEA
R302: 160k 0.1%; R_0805_2012Metric; MPN TNPW0805160KBEEA
R303: 1.40k 0.1%; R_0805_2012Metric; MPN TNPW08051K40BEEA
R305, R306: 1.00M 0.1%; R_0805_2012Metric; MPN TNPW08051M00BEEA
U30: 100V LDO, nominal 10V; Texas_DGN0008B_VSSOP-8-1EP_3x3mm_P0.65mm_EP2x3mm_Mask1.88x1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; MPN TPS7A4001DGNR
U31: 2.5V high-grade reference; SOIC-8_3.9x4.9mm_P1.27mm; MPN REF5025IDR
U32: Independent analog chopper/OV/NTC window; TSSOP-14_4.4x5mm_P0.65mm; MPN LM339BIPWR
U33: 4A source/8A sink driver; SOT-23-6; MPN UCC27511DBVR
U34: Isolated analog fault; SSOP-4_4.4x2.6mm_P1.27mm; MPN VOS618A-3T
U35: Isolated chopper active; SSOP-4_4.4x2.6mm_P1.27mm; MPN VOS618A-3T
U36: Reference qualification 12..28ms; SOT-23-6; MPN TPS3808G01DBVR

Connections:
CHOPPER_N: C312.2 (CHOPPER_N), C313.2 (CHOPPER_N), D60.2 (A), D61.2 (A), Q40.2 (S_LEADS_2_TO_8); also elsewhere on the board
CHOP_10V: C301.1 (CHOP_10V), C302.1 (CHOP_10V), C304.1 (CHOP_10V), C308.1 (CHOP_10V), C309.1 (CHOP_10V), D64.2 (A), Q43.2 (S), R300.1 (CHOP_10V), U30.1 (OUT), U31.2 (VIN), U32.3 (VCC), U33.1 (VDD); also elsewhere on the board
CHOP_ACTIVE_LED_A: U35.1 (A); also elsewhere on the board
CHOP_ACTIVE_LED_K: Q42.3 (D), U35.2 (K)
CHOP_ACTIVE_N: U35.4 (C); also elsewhere on the board
CHOP_DISABLE: Q41.3 (D), U33.5 (IN-); also elsewhere on the board
CHOP_DRAIN: D61.1 (K), D63.2 (A), Q40.3 (D_TAB); also elsewhere on the board
CHOP_DRIVE_H: U33.2 (OUTH); also elsewhere on the board
CHOP_DRIVE_L: U33.3 (OUTL); also elsewhere on the board
CHOP_FAULT_LED_A: U34.1 (A); also elsewhere on the board
CHOP_FAULT_LED_K: D65.2 (A), D66.2 (A), U34.2 (K)
CHOP_FAULT_N: U34.4 (C); also elsewhere on the board
CHOP_FAULT_PWR: Q43.3 (D); also elsewhere on the board
CHOP_FB: R300.2 (CHOP_FB), R301.1 (CHOP_FB), U30.2 (FB)
CHOP_GATE: D62.1 (K), Q40.1 (G), Q42.1 (G), R305.1 (CHOP_GATE); also elsewhere on the board
CHOP_GND: C300.2 (CHOP_GND), C301.2 (CHOP_GND), C302.2 (CHOP_GND), C303.2 (CHOP_GND), C304.2 (CHOP_GND), C305.2 (CHOP_GND), C306.2 (CHOP_GND), C307.2 (CHOP_GND), C308.2 (CHOP_GND), C309.2 (CHOP_GND), C311.2 (CHOP_GND), D62.2 (A), Q42.2 (S), Q44.2 (E), R301.2 (CHOP_GND), R304.2 (CHOP_GND), U30.4 (GND), U30.9 (EP), U31.4 (GND), U32.12 (GND), U33.4 (GND), U36.2 (GND); also elsewhere on the board
CHOP_HYS_MID: R305.2 (CHOP_HYS_MID), R306.1 (CHOP_HYS_MID)
CHOP_HYS_MID2: R306.2 (CHOP_HYS_MID2); also elsewhere on the board
CHOP_NTC: C307.1 (CHOP_NTC), U32.9 (IN3+), U32.10 (IN4-); also elsewhere on the board
CHOP_OV_OK: D65.1 (K), U32.1 (OUT2); also elsewhere on the board
CHOP_OV_SENSE: C306.1 (CHOP_OV_SENSE), U32.6 (IN2-); also elsewhere on the board
CHOP_QUALIFY_BASE: Q44.1 (B); also elsewhere on the board
CHOP_QUALIFY_N: Q41.2 (S), Q43.1 (G), Q44.3 (C); also elsewhere on the board
CHOP_REF2V5: C303.1 (CHOP_REF2V5), C311.1 (CHOP_REF2V5), U31.6 (VOUT), U32.4 (IN1-), U32.7 (IN2+), U36.3 (MR_N), U36.6 (VDD); also elsewhere on the board
CHOP_REF_READY: U36.1 (RESET_N); also elsewhere on the board
CHOP_REF_SENSE: U36.5 (SENSE); also elsewhere on the board
CHOP_REQUEST: U32.2 (OUT1), U33.6 (IN+); also elsewhere on the board
CHOP_SENSE: C305.1 (CHOP_SENSE), R303.2 (CHOP_SENSE), R304.1 (CHOP_SENSE), U32.5 (IN1+); also elsewhere on the board
CHOP_SENSE_TOP: R302.2 (CHOP_SENSE_TOP), R303.1 (CHOP_SENSE_TOP)
CHOP_TEMP_ADC: C310.1 (CHOP_TEMP_ADC); also elsewhere on the board
CHOP_TEMP_HIGH: U32.11 (IN4+); also elsewhere on the board
CHOP_TEMP_LOW: U32.8 (IN3-); also elsewhere on the board
CHOP_THERMAL_OK: D66.1 (K), Q41.1 (G), U32.13 (OUT4), U32.14 (OUT3); also elsewhere on the board
LOGIC_GND: C310.2 (LOGIC_GND), U34.3 (E), U35.3 (E); also elsewhere on the board
MOTION_BUS_P: C300.1 (MOTION_BUS_P), C312.1 (MOTION_BUS_P), C313.1 (MOTION_BUS_P), D60.1 (K), D63.1 (K), D64.1 (K), R302.1 (MOTION_BUS_P), U30.5 (EN), U30.8 (IN); also elsewhere on the board

Notes on the sheet:
04 brake chopper p1

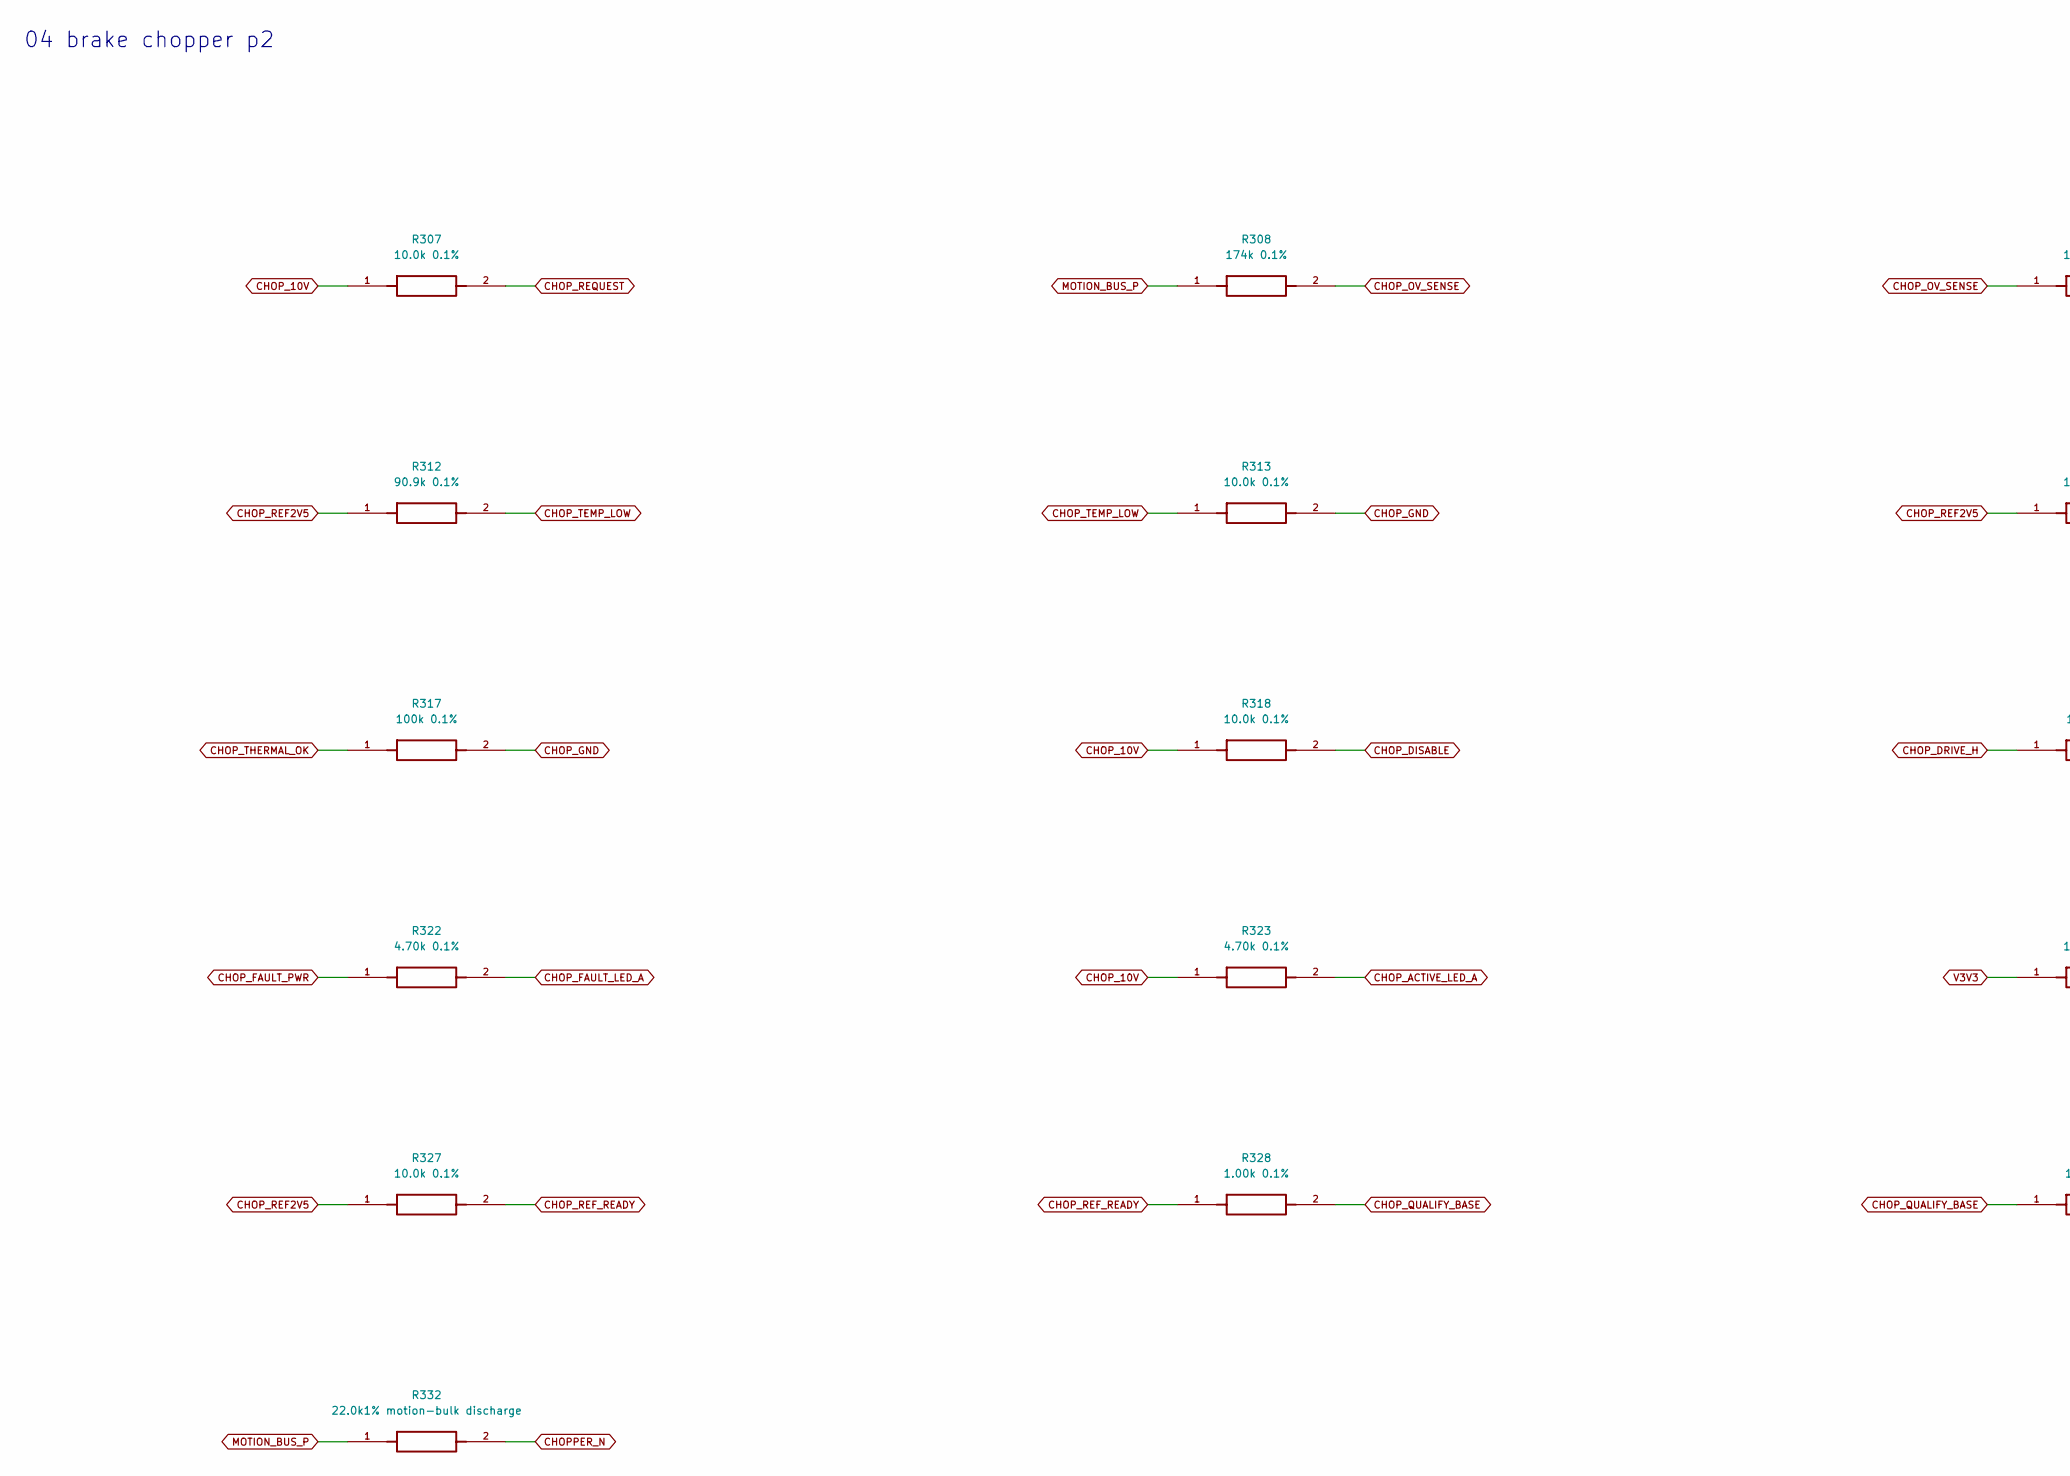
[picture p55: schematic 04_brake_chopper_p2.kicad_sch, PMU A / Brake chopper / 2, part in row 1, column 1]

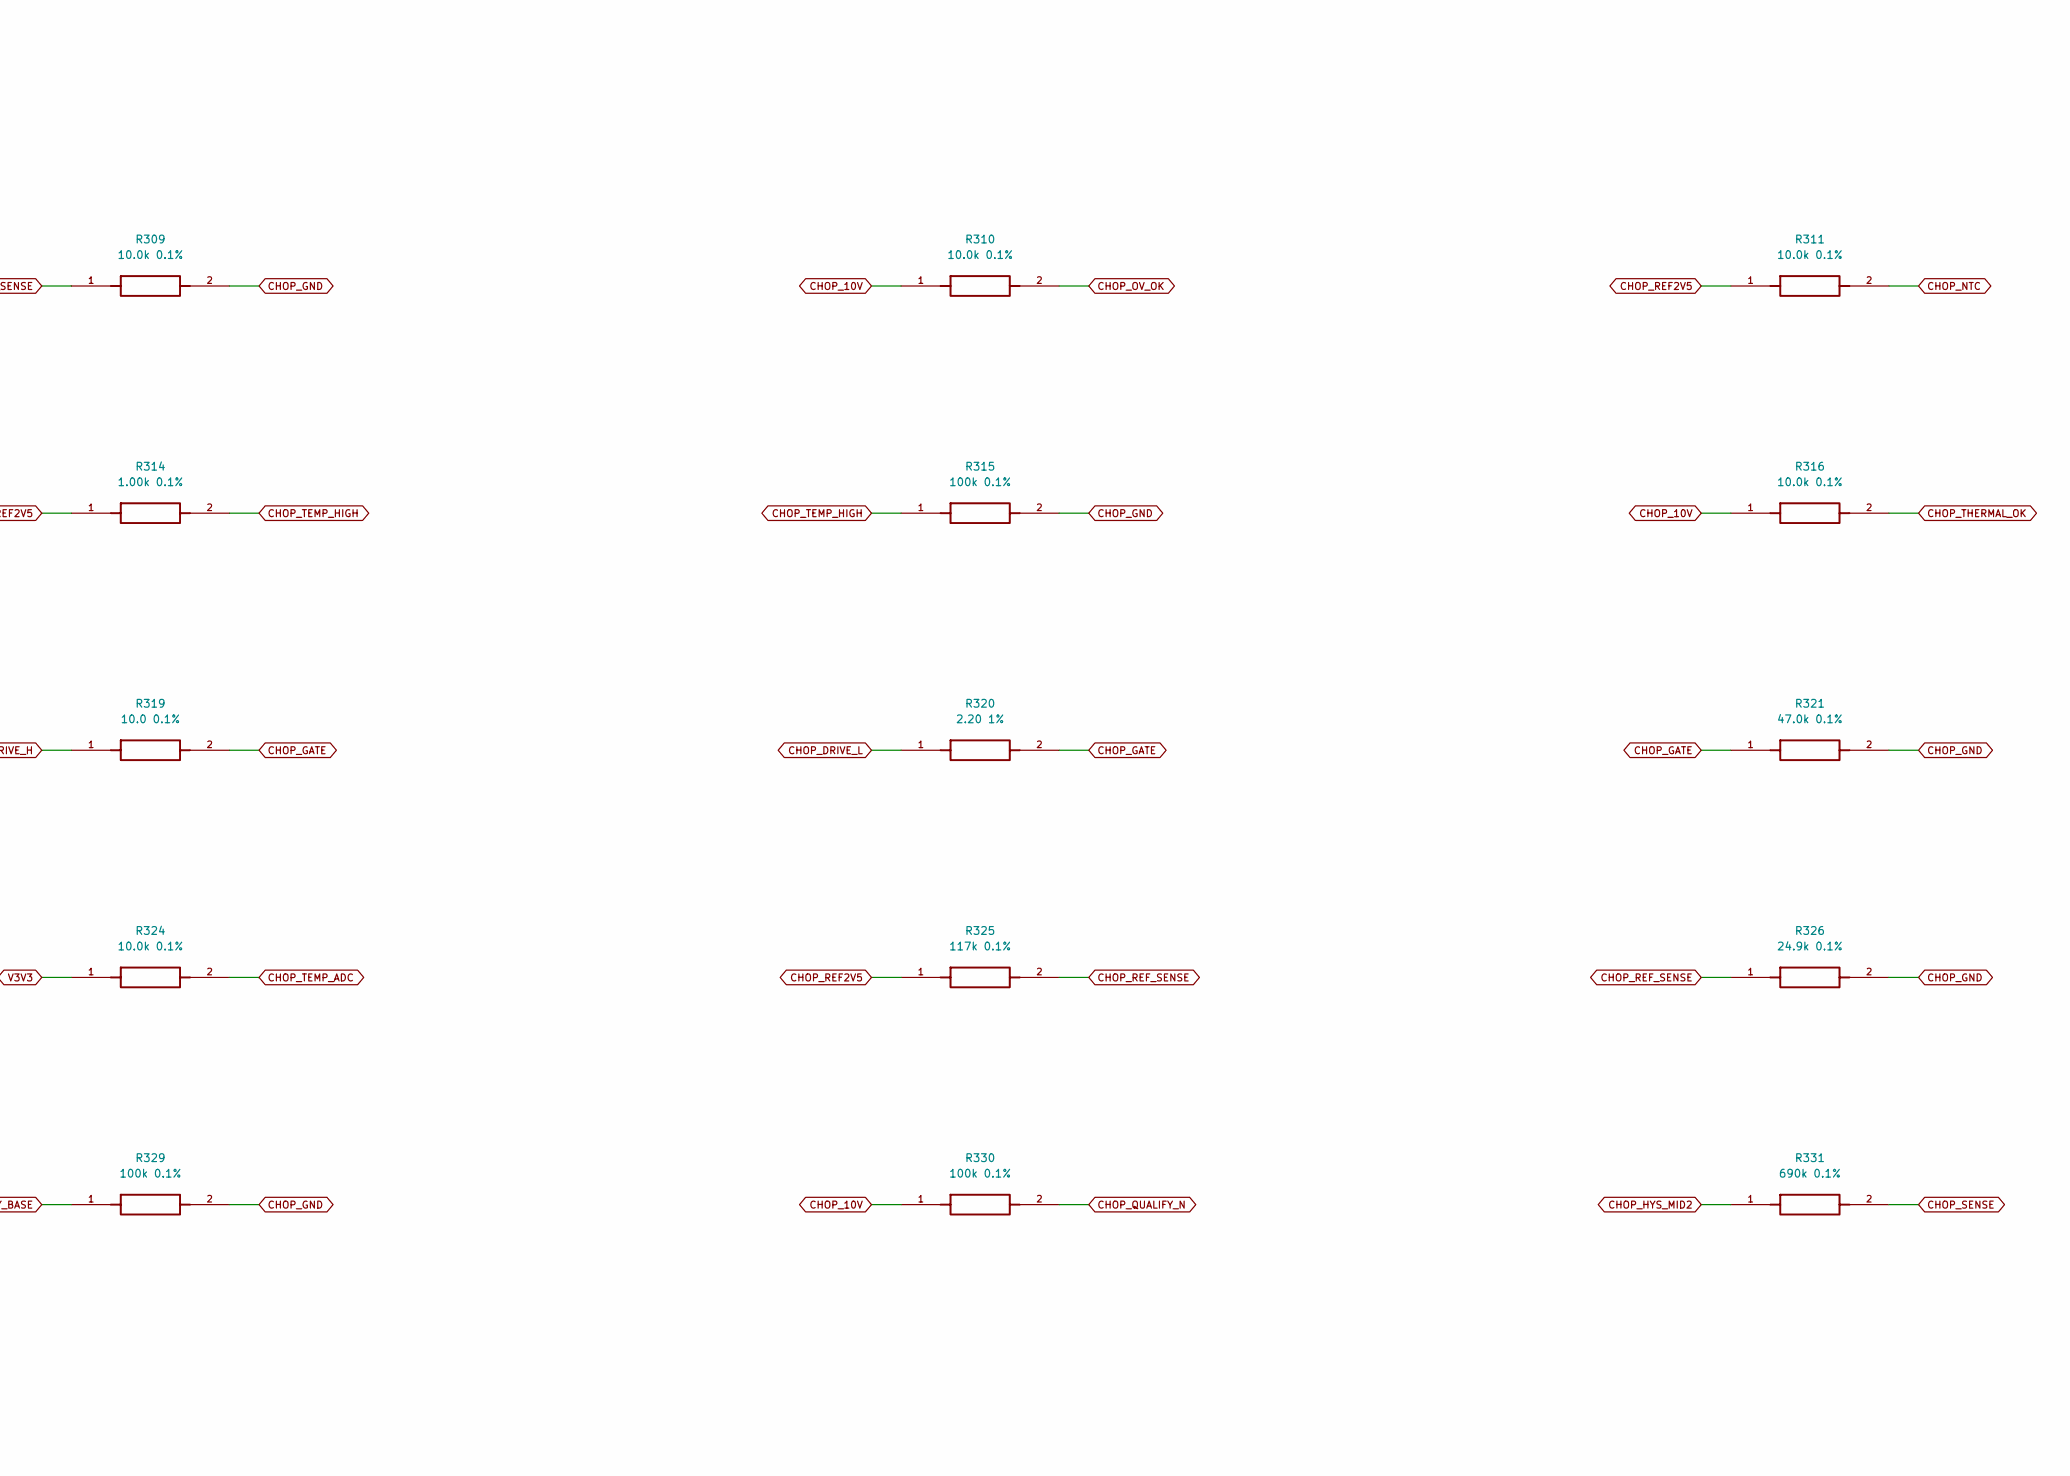
[picture p56: schematic 04_brake_chopper_p2.kicad_sch, PMU A / Brake chopper / 2, part in row 1, column 2]

Parts:
R307, R309, R310, R311, R313, R316, R318, R324, R327: 10.0k 0.1%; R_0805_2012Metric; MPN TNPW080510K0BEEA
R308: 174k 0.1%; R_0805_2012Metric; MPN TNPW0805174KBEEA
R312: 90.9k 0.1%; R_0805_2012Metric; MPN TNPW080590K9BEEA
R314, R328: 1.00k 0.1%; R_0805_2012Metric; MPN TNPW08051K00BEEA
R315, R317, R329, R330: 100k 0.1%; R_0805_2012Metric; MPN TNPW0805100KBEEA
R319: 10.0 0.1%; R_0805_2012Metric; MPN TNPW080510R0BEEA
R320: 2.20 1%; R_0805_2012Metric; MPN TNPW08052R20FEEA
R321: 47.0k 0.1%; R_0805_2012Metric; MPN TNPW080547K0BEEA
R322, R323: 4.70k 0.1%; R_0805_2012Metric; MPN TNPW08054K70BEEA
R325: 117k 0.1%; R_0805_2012Metric; MPN TNPW0805117KBEEA
R326: 24.9k 0.1%; R_0805_2012Metric; MPN TNPW080524K9BEEA
R331: 690k 0.1%; R_0805_2012Metric; MPN TNPW0805690KBEEA
R332: 22.0k1% motion-bulk discharge; R_1206_3216Metric; MPN TNPW120622K0FEEA

Connections:
CHOPPER_N: R332.2 (CHOPPER_N); also elsewhere on the board
CHOP_10V: R307.1 (CHOP_10V), R310.1 (CHOP_10V), R316.1 (CHOP_10V), R318.1 (CHOP_10V), R323.1 (CHOP_10V), R330.1 (CHOP_10V); also elsewhere on the board
CHOP_ACTIVE_LED_A: R323.2 (CHOP_ACTIVE_LED_A); also elsewhere on the board
CHOP_DISABLE: R318.2 (CHOP_DISABLE); also elsewhere on the board
CHOP_DRIVE_H: R319.1 (CHOP_DRIVE_H); also elsewhere on the board
CHOP_DRIVE_L: R320.1 (CHOP_DRIVE_L); also elsewhere on the board
CHOP_FAULT_LED_A: R322.2 (CHOP_FAULT_LED_A); also elsewhere on the board
CHOP_FAULT_PWR: R322.1 (CHOP_FAULT_PWR); also elsewhere on the board
CHOP_GATE: R319.2 (CHOP_GATE), R320.2 (CHOP_GATE), R321.1 (CHOP_GATE); also elsewhere on the board
CHOP_GND: R309.2 (CHOP_GND), R313.2 (CHOP_GND), R315.2 (CHOP_GND), R317.2 (CHOP_GND), R321.2 (CHOP_GND), R326.2 (CHOP_GND), R329.2 (CHOP_GND); also elsewhere on the board
CHOP_HYS_MID2: R331.1 (CHOP_HYS_MID2); also elsewhere on the board
CHOP_NTC: R311.2 (CHOP_NTC); also elsewhere on the board
CHOP_OV_OK: R310.2 (CHOP_OV_OK); also elsewhere on the board
CHOP_OV_SENSE: R308.2 (CHOP_OV_SENSE), R309.1 (CHOP_OV_SENSE); also elsewhere on the board
CHOP_QUALIFY_BASE: R328.2 (CHOP_QUALIFY_BASE), R329.1 (CHOP_QUALIFY_BASE); also elsewhere on the board
CHOP_QUALIFY_N: R330.2 (CHOP_QUALIFY_N); also elsewhere on the board
CHOP_REF2V5: R311.1 (CHOP_REF2V5), R312.1 (CHOP_REF2V5), R314.1 (CHOP_REF2V5), R325.1 (CHOP_REF2V5), R327.1 (CHOP_REF2V5); also elsewhere on the board
CHOP_REF_READY: R327.2 (CHOP_REF_READY), R328.1 (CHOP_REF_READY); also elsewhere on the board
CHOP_REF_SENSE: R325.2 (CHOP_REF_SENSE), R326.1 (CHOP_REF_SENSE); also elsewhere on the board
CHOP_REQUEST: R307.2 (CHOP_REQUEST); also elsewhere on the board
CHOP_SENSE: R331.2 (CHOP_SENSE); also elsewhere on the board
CHOP_TEMP_ADC: R324.2 (CHOP_TEMP_ADC); also elsewhere on the board
CHOP_TEMP_HIGH: R314.2 (CHOP_TEMP_HIGH), R315.1 (CHOP_TEMP_HIGH); also elsewhere on the board
CHOP_TEMP_LOW: R312.2 (CHOP_TEMP_LOW), R313.1 (CHOP_TEMP_LOW); also elsewhere on the board
CHOP_THERMAL_OK: R316.2 (CHOP_THERMAL_OK), R317.1 (CHOP_THERMAL_OK); also elsewhere on the board
MOTION_BUS_P: R308.1 (MOTION_BUS_P), R332.1 (MOTION_BUS_P); also elsewhere on the board
V3V3: R324.1 (+3V3); also elsewhere on the board

Notes on the sheet:
04 brake chopper p2
