chris01-byte/HomeMy/hardware/power-management-unit/rev-a2-layout-280x260/kicad/HomeMy_PMU_RevA.kicad_pcb

## KiCad design hardware/power-management-unit/rev-a2-layout-280x260/kicad/HomeMy_PMU_RevA.kicad_pcb (continued)

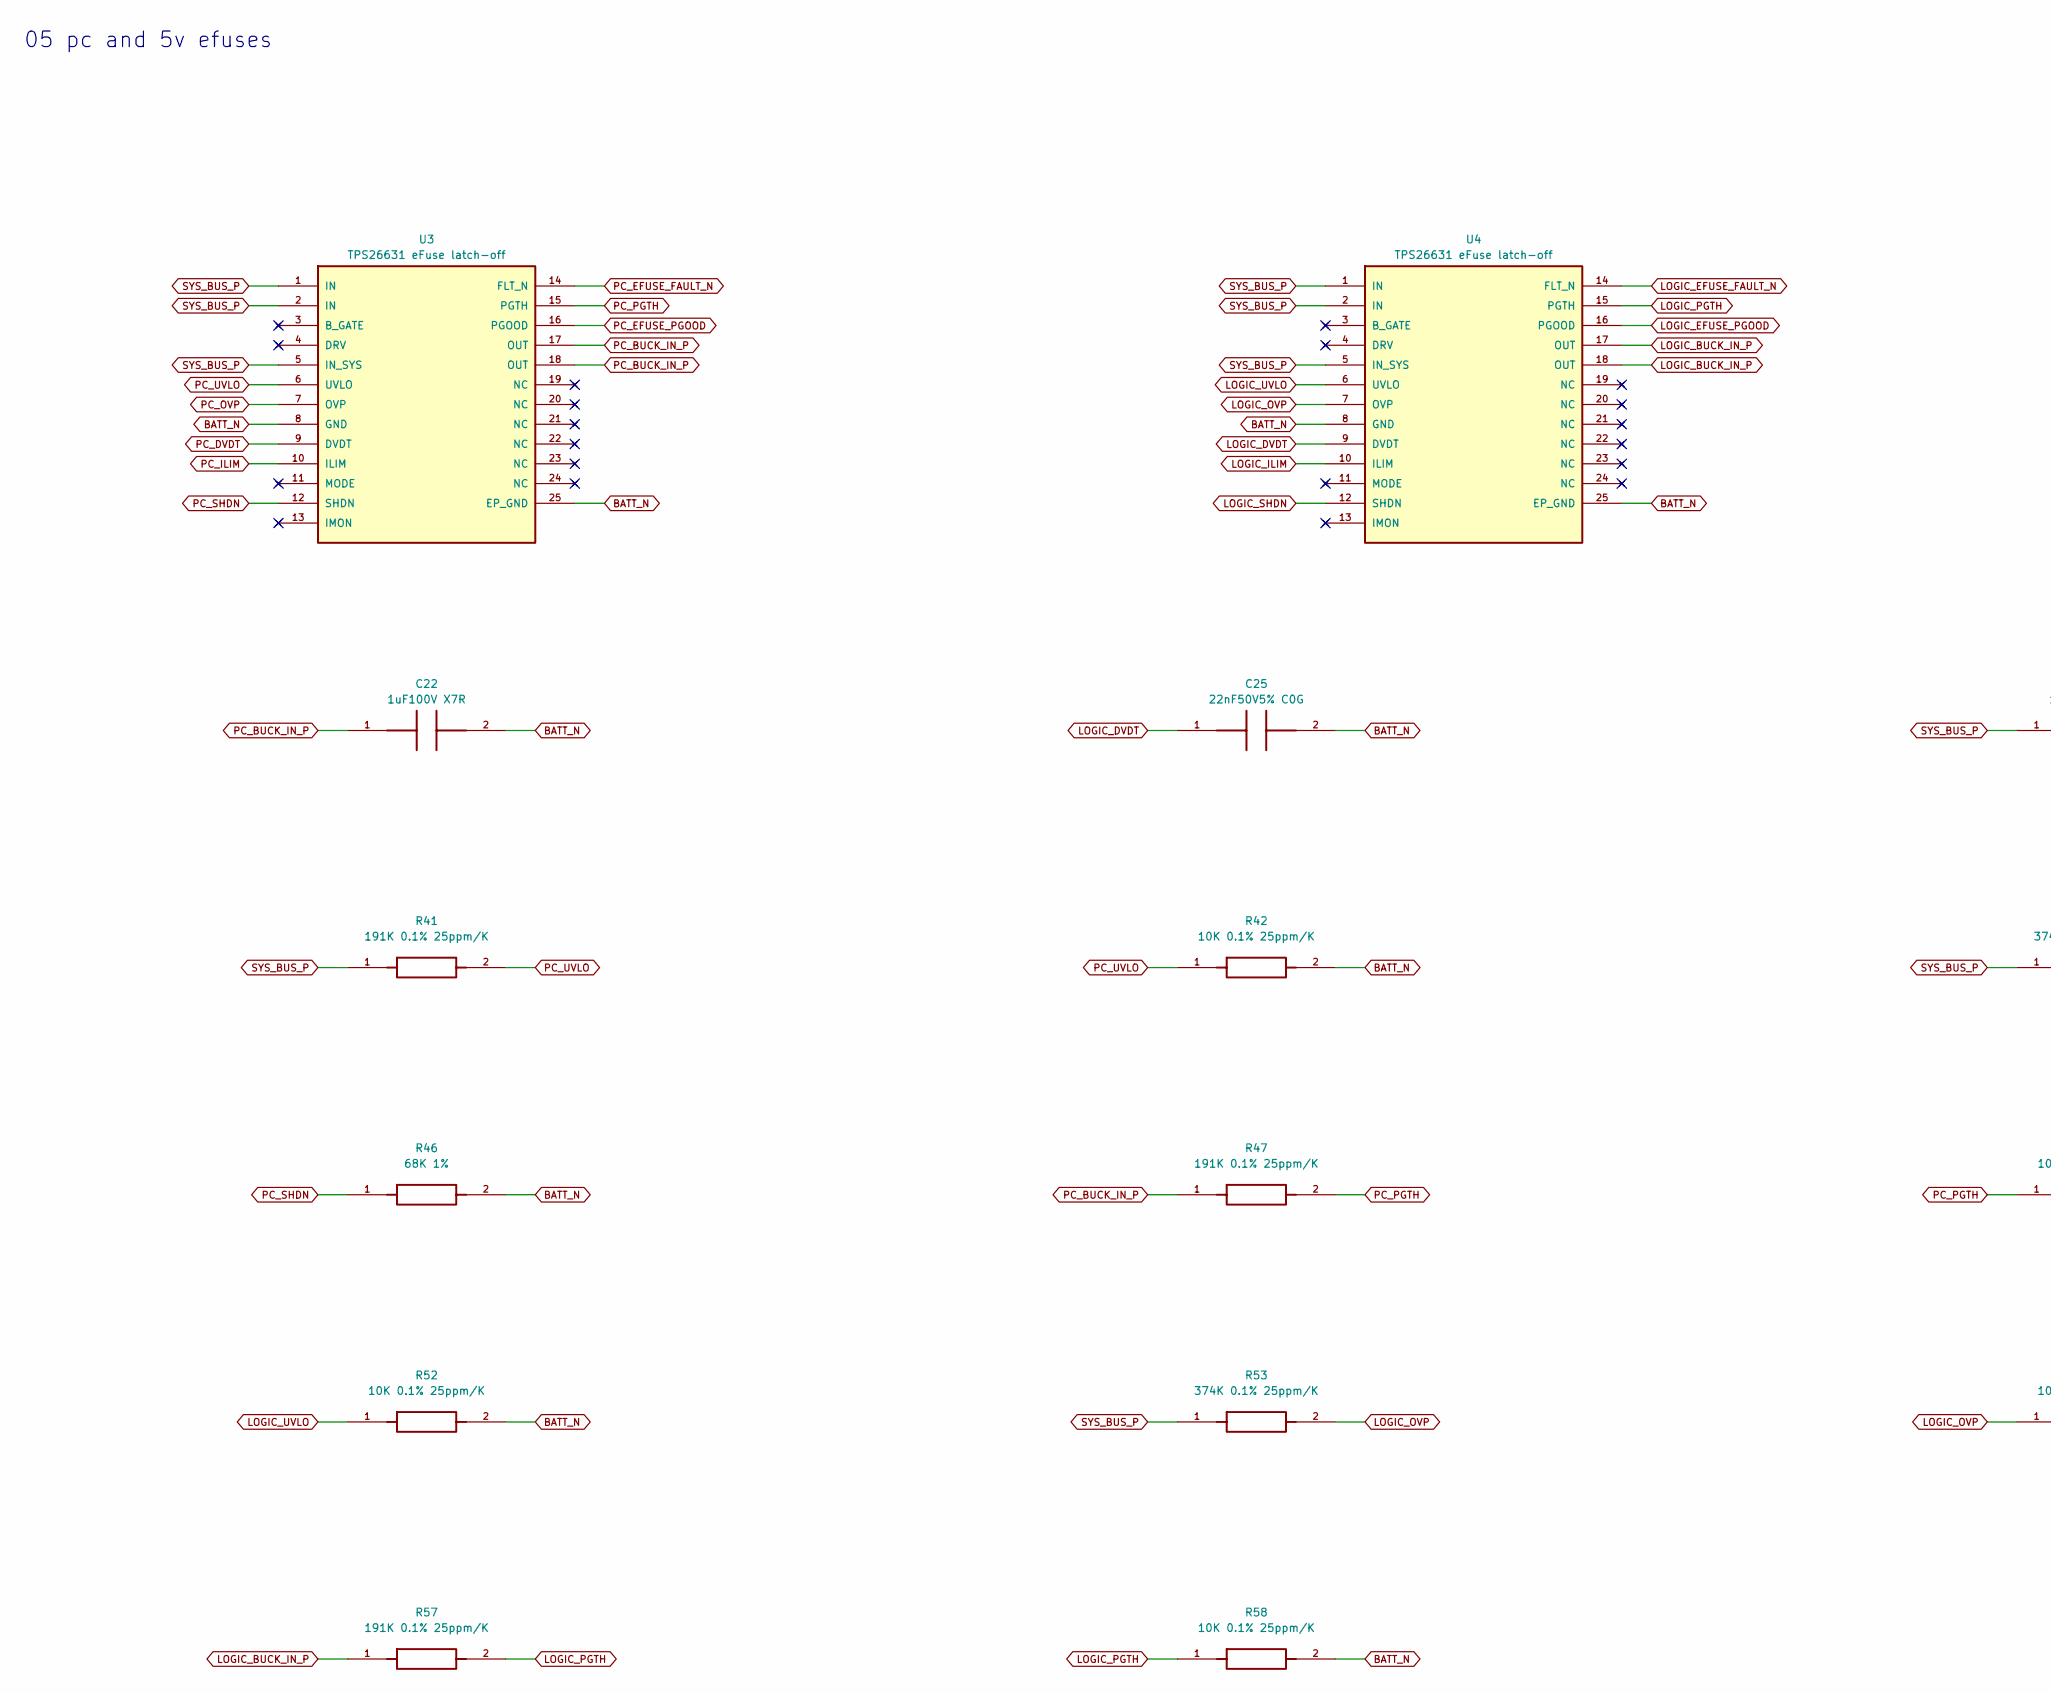
[picture p57: schematic 05_pc_and_5v_efuses.kicad_sch, PMU A / PC and 5V eFuses, part in row 1, column 1]

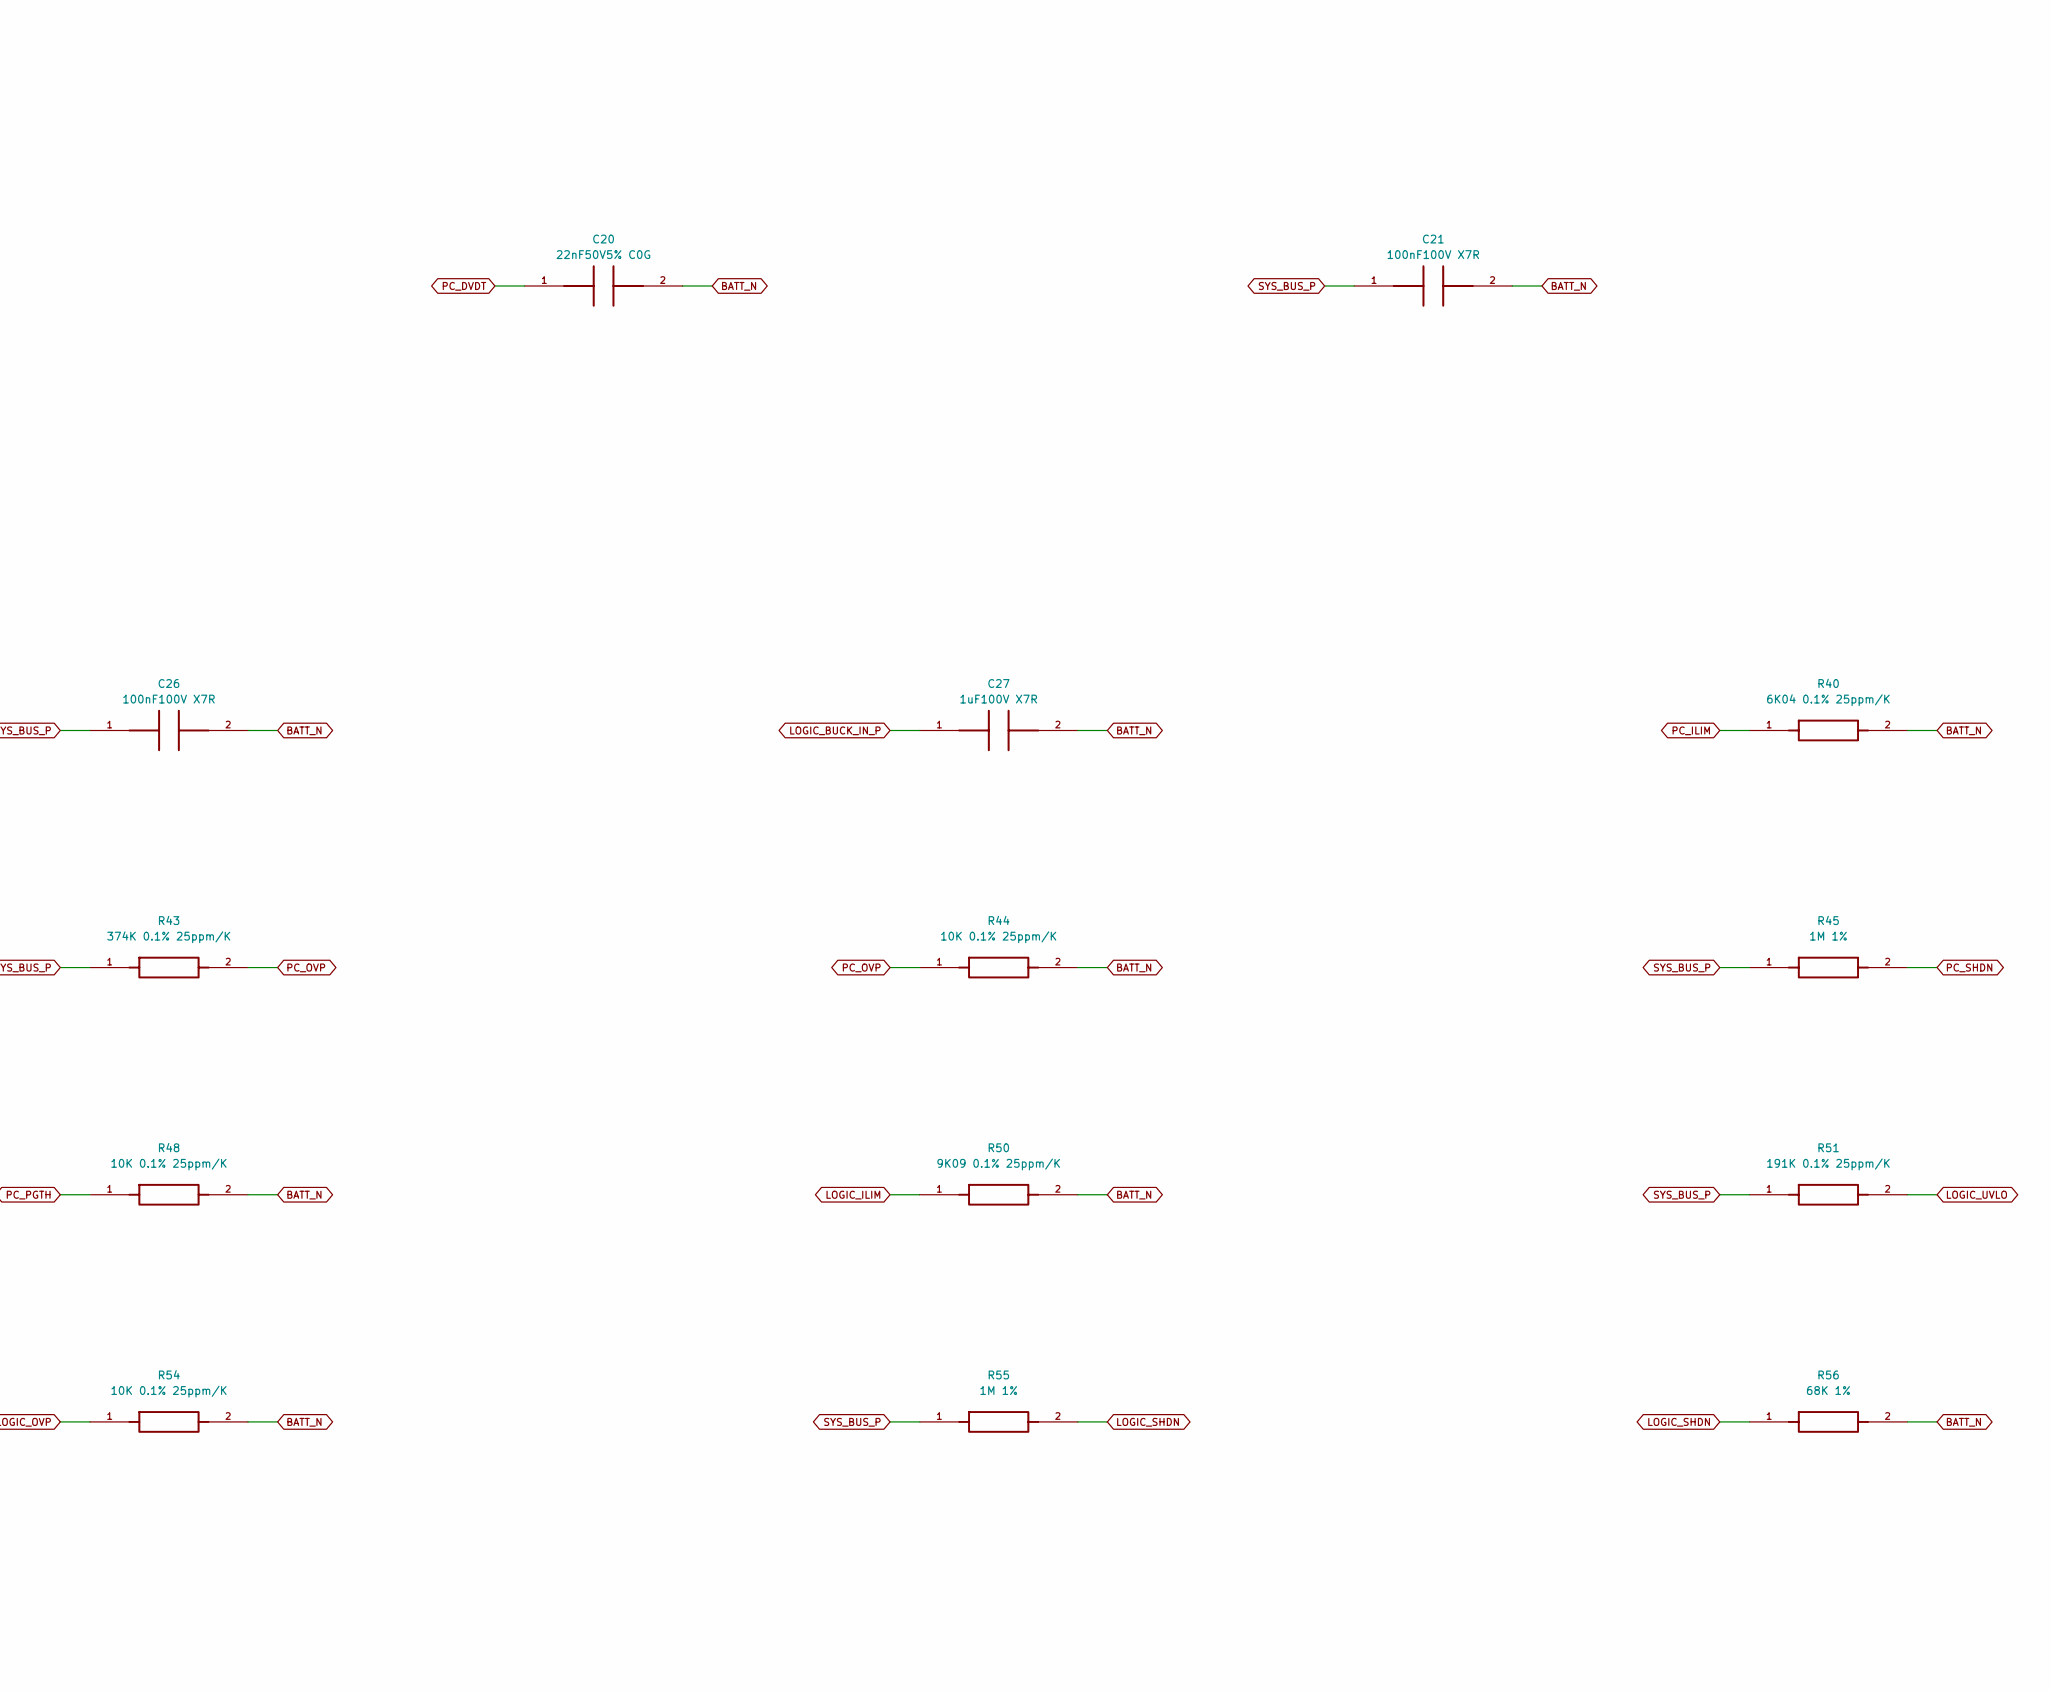
[picture p58: schematic 05_pc_and_5v_efuses.kicad_sch, PMU A / PC and 5V eFuses, part in row 1, column 2]

Parts:
C20, C25: 22nF50V5% C0G; C_0805_2012Metric; MPN C0805C223J5GACTU
C21, C26: 100nF100V X7R; C_0805_2012Metric; MPN GRM21BR72A104KA01L
C22, C27: 1uF100V X7R; C_1210_3225Metric; MPN C1210C105K1RACTU
R40: 6K04 0.1% 25ppm/K; R_0805_2012Metric; MPN RT0805BRD076K04L
R41, R47, R51, R57: 191K 0.1% 25ppm/K; R_0805_2012Metric; MPN RT0805BRD07191KL
R42, R44, R48, R52, R54, R58: 10K 0.1% 25ppm/K; R_0805_2012Metric; MPN RT0805BRD0710KL
R43, R53: 374K 0.1% 25ppm/K; R_0805_2012Metric; MPN RT0805BRD07374KL
R45, R55: 1M 1%; R_0805_2012Metric; MPN RC0805FR-071ML
R46, R56: 68K 1%; R_0805_2012Metric; MPN RC0805FR-0768KL
R50: 9K09 0.1% 25ppm/K; R_0805_2012Metric; MPN RT0805BRD079K09L
U3, U4: TPS26631 eFuse latch-off; Texas_RGE0024H_VQFN-24-1EP_4x4mm_P0.5mm_EP2.7x2.7mm; MPN TPS26631RGER

Connections:
BATT_N: C20.2, C21.2, C22.2, C25.2, C26.2, C27.2, R40.2, R42.2, R44.2, R46.2, R48.2, R50.2, R52.2, R54.2, R56.2, R58.2, U3.8 (GND), U3.25 (EP_GND), U4.8 (GND), U4.25 (EP_GND); also elsewhere on the board
LOGIC_BUCK_IN_P: C27.1, R57.1, U4.17 (OUT), U4.18 (OUT); also elsewhere on the board
LOGIC_DVDT: C25.1, U4.9 (DVDT)
LOGIC_EFUSE_FAULT_N: U4.14 (FLT_N); also elsewhere on the board
LOGIC_EFUSE_PGOOD: U4.16 (PGOOD); also elsewhere on the board
LOGIC_ILIM: R50.1, U4.10 (ILIM)
LOGIC_OVP: R53.2, R54.1, U4.7 (OVP)
LOGIC_PGTH: R57.2, R58.1, U4.15 (PGTH)
LOGIC_SHDN: R55.2, R56.1, U4.12 (SHDN)
LOGIC_UVLO: R51.2, R52.1, U4.6 (UVLO)
PC_BUCK_IN_P: C22.1, R47.1, U3.17 (OUT), U3.18 (OUT); also elsewhere on the board
PC_DVDT: C20.1, U3.9 (DVDT)
PC_EFUSE_FAULT_N: U3.14 (FLT_N); also elsewhere on the board
PC_EFUSE_PGOOD: U3.16 (PGOOD); also elsewhere on the board
PC_ILIM: R40.1, U3.10 (ILIM)
PC_OVP: R43.2, R44.1, U3.7 (OVP)
PC_PGTH: R47.2, R48.1, U3.15 (PGTH)
PC_SHDN: R45.2, R46.1, U3.12 (SHDN)
PC_UVLO: R41.2, R42.1, U3.6 (UVLO)
SYS_BUS_P: C21.1, C26.1, R41.1, R43.1, R45.1, R51.1, R53.1, R55.1, U3.1 (IN), U3.2 (IN), U3.5 (IN_SYS), U4.1 (IN), U4.2 (IN), U4.5 (IN_SYS); also elsewhere on the board

Notes on the sheet:
05 pc and 5v efuses

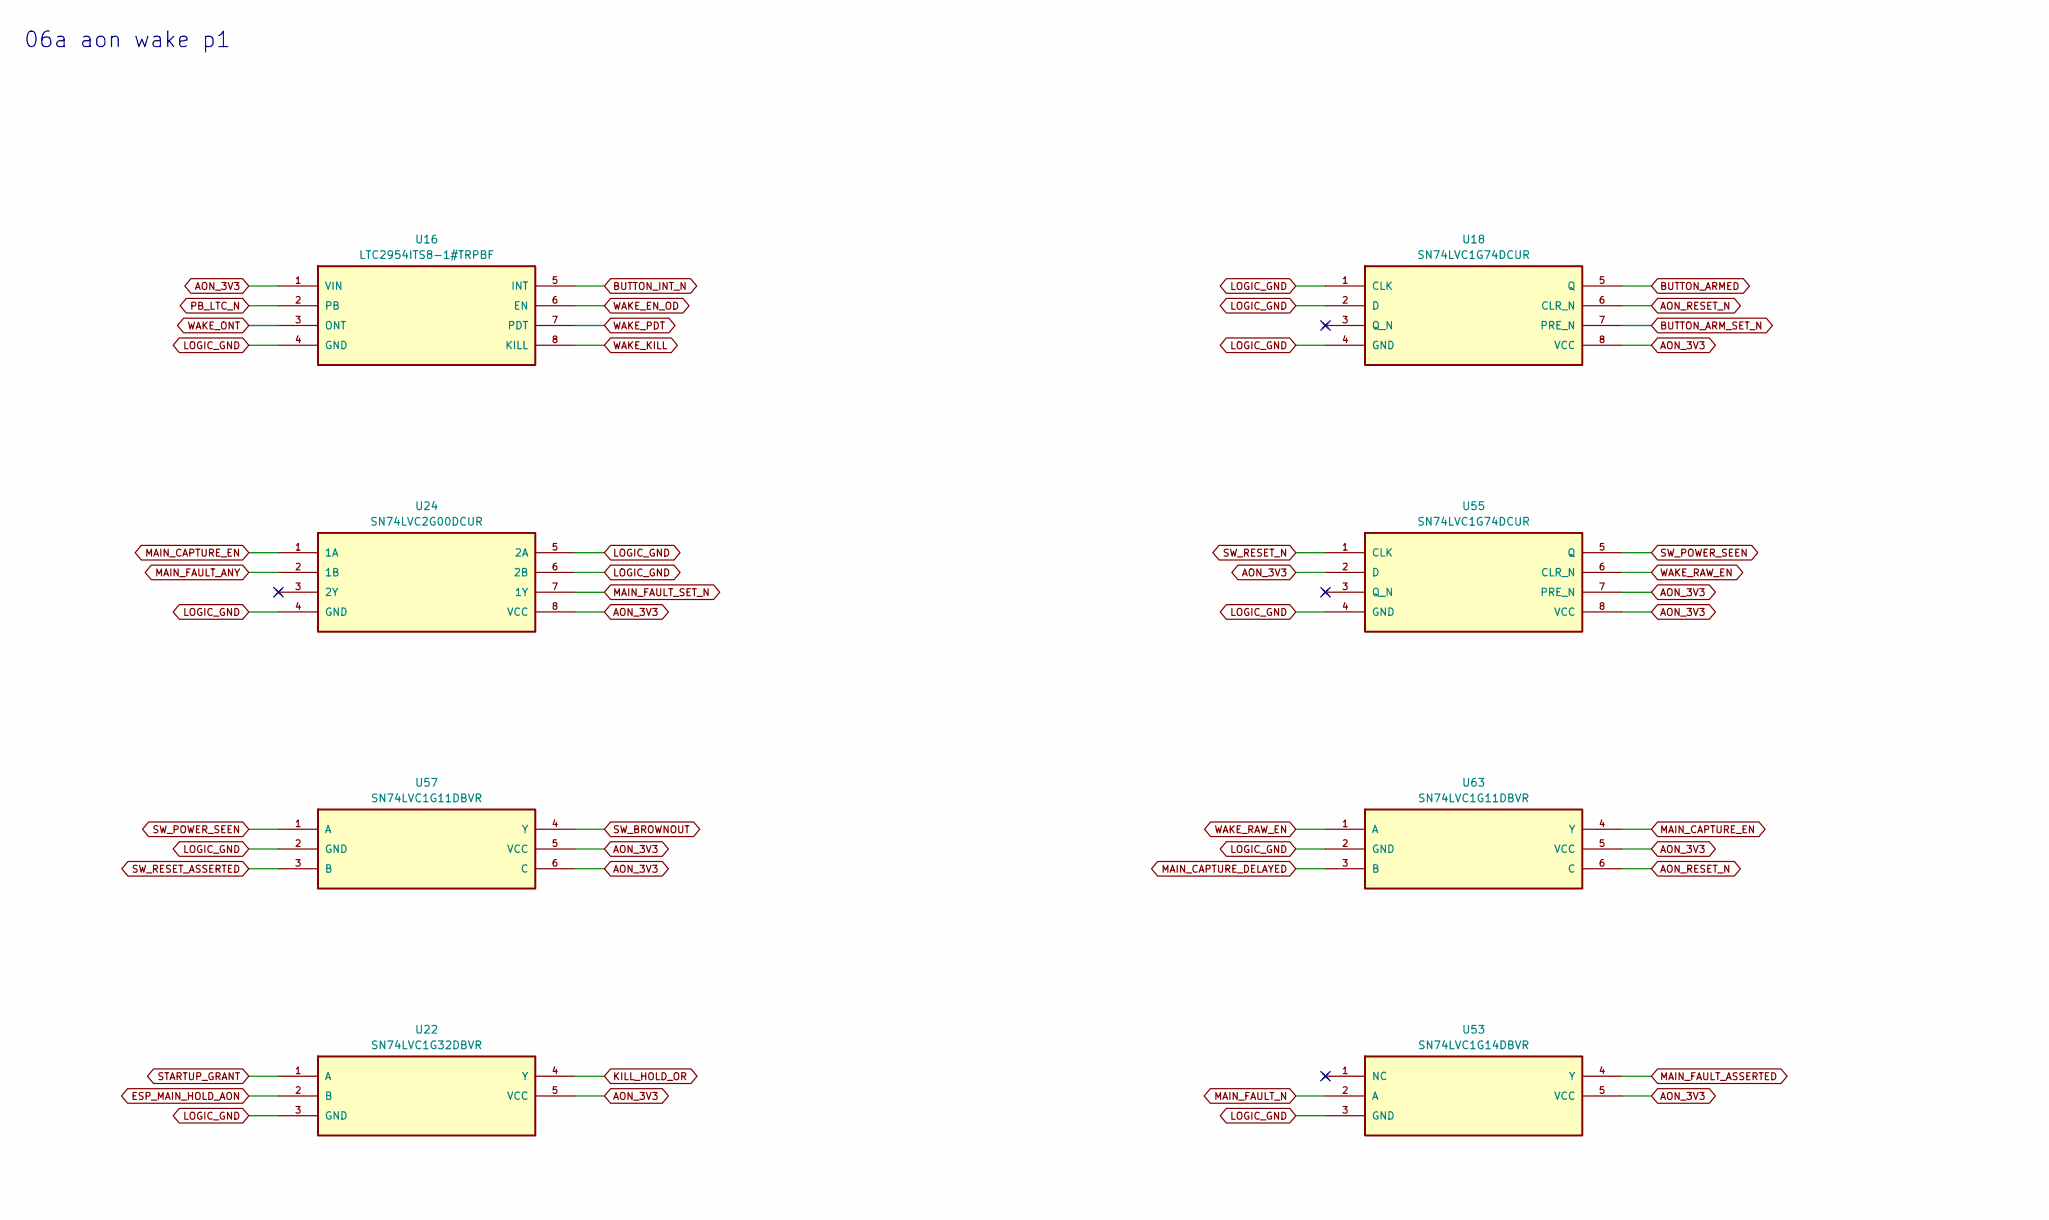
[picture p59: schematic 06a_aon_wake_p1.kicad_sch, PMU A / Wake and main latch / 1, part in row 1, column 1]

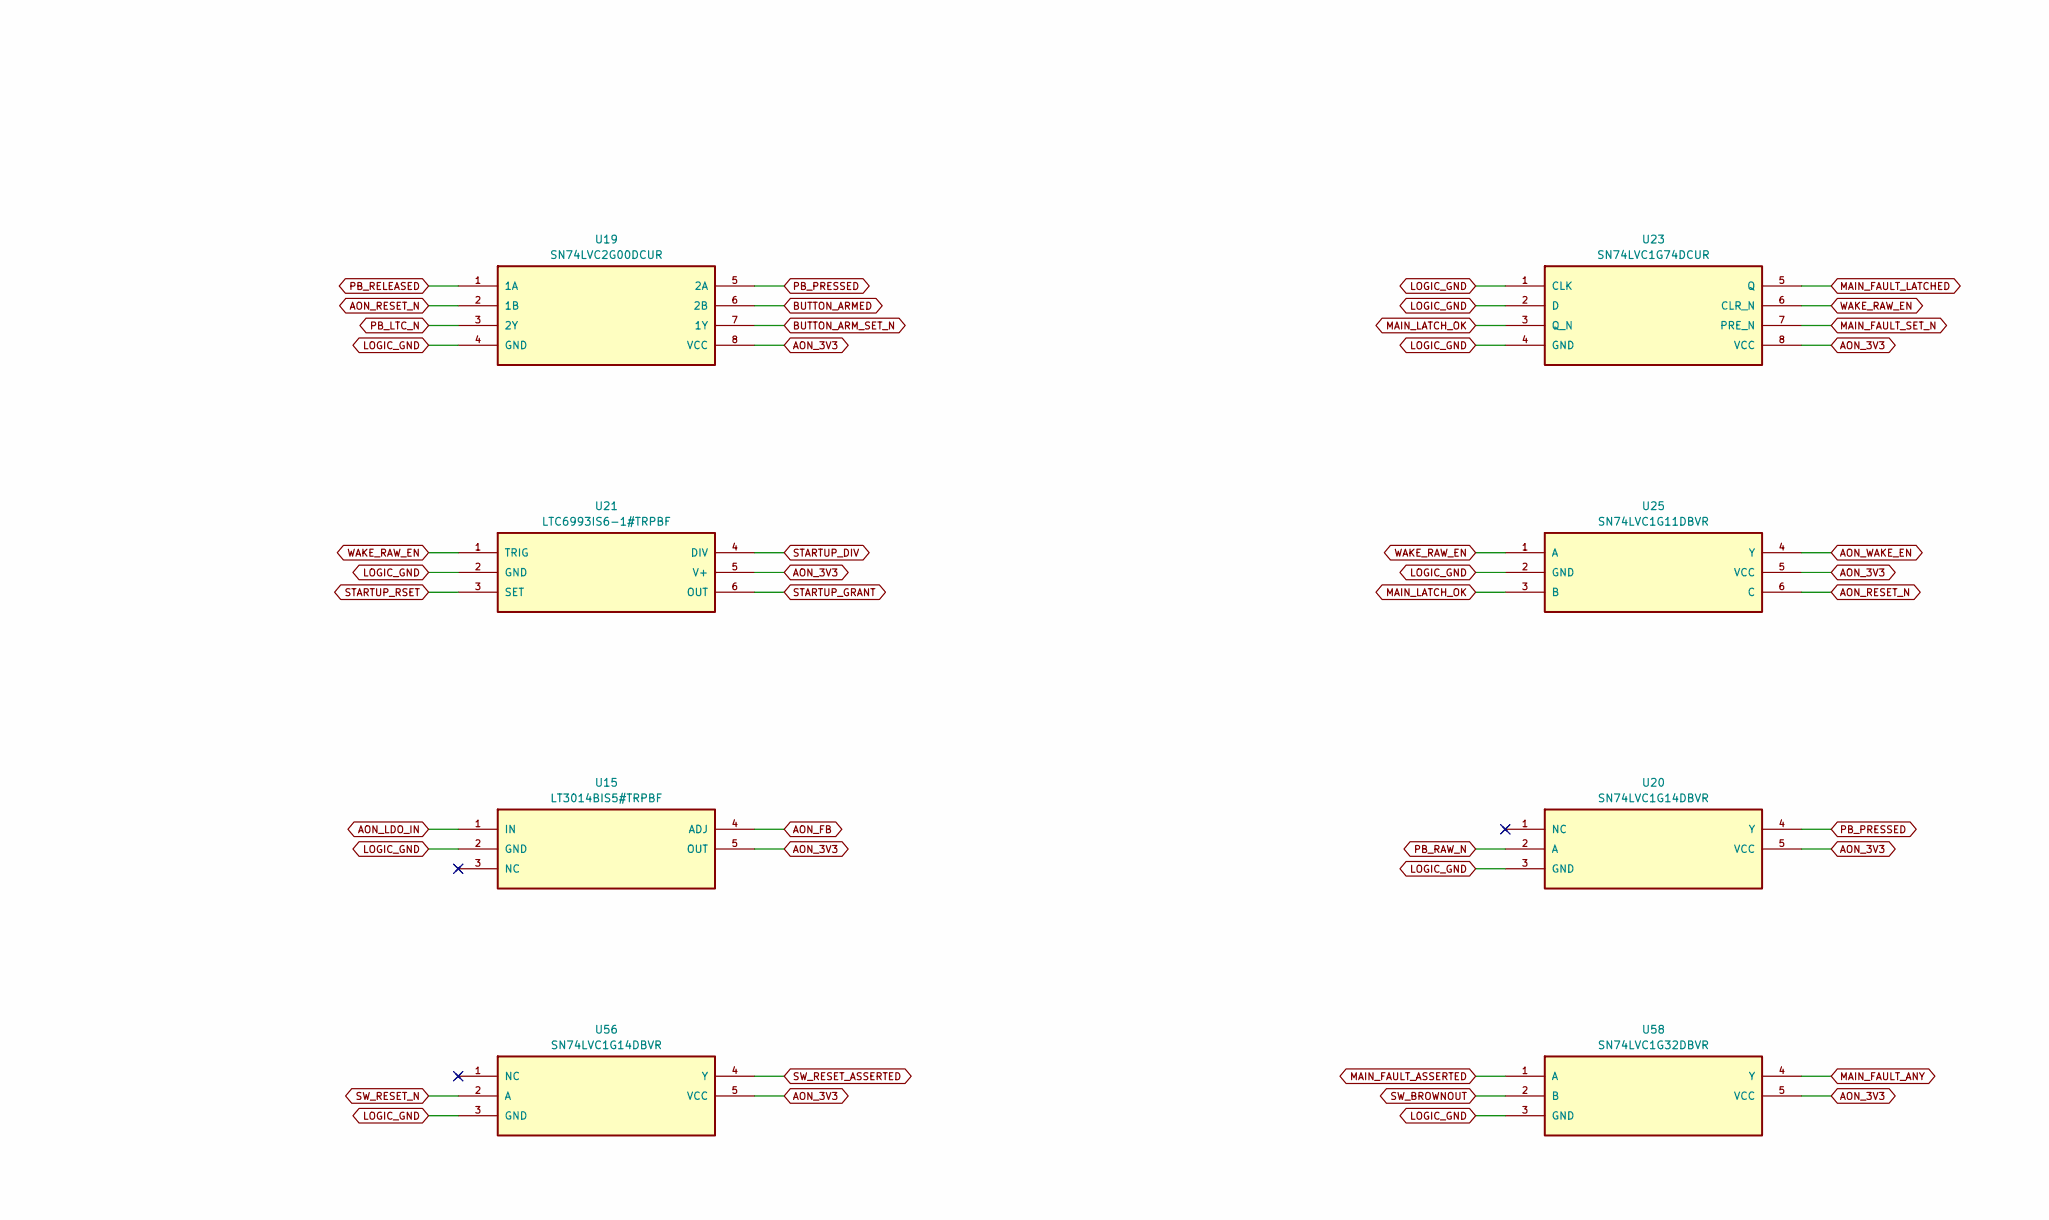
[picture p60: schematic 06a_aon_wake_p1.kicad_sch, PMU A / Wake and main latch / 1, part in row 1, column 2]

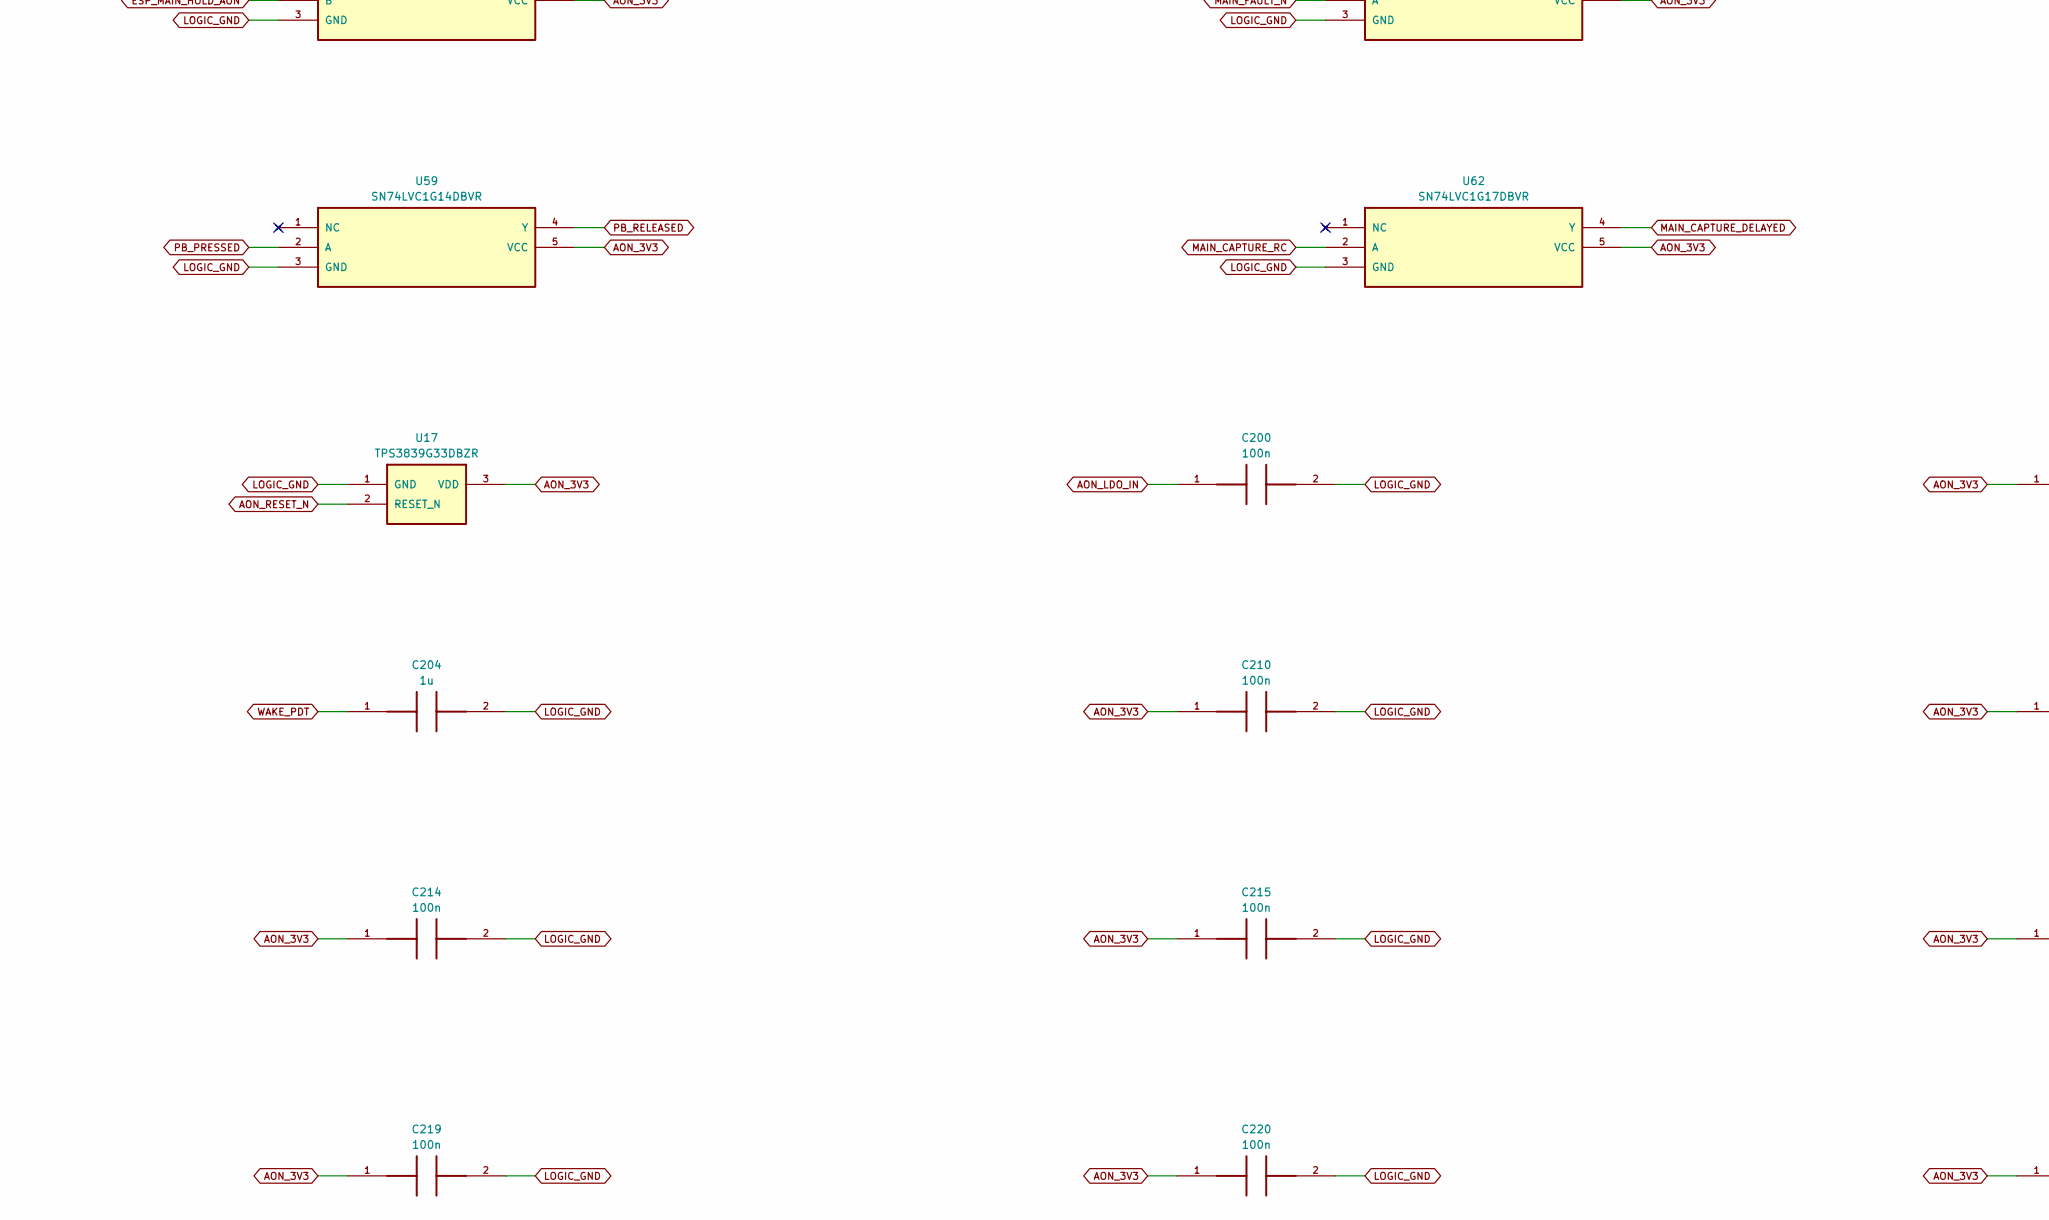
[picture p61: schematic 06a_aon_wake_p1.kicad_sch, PMU A / Wake and main latch / 1, part in row 2, column 1]

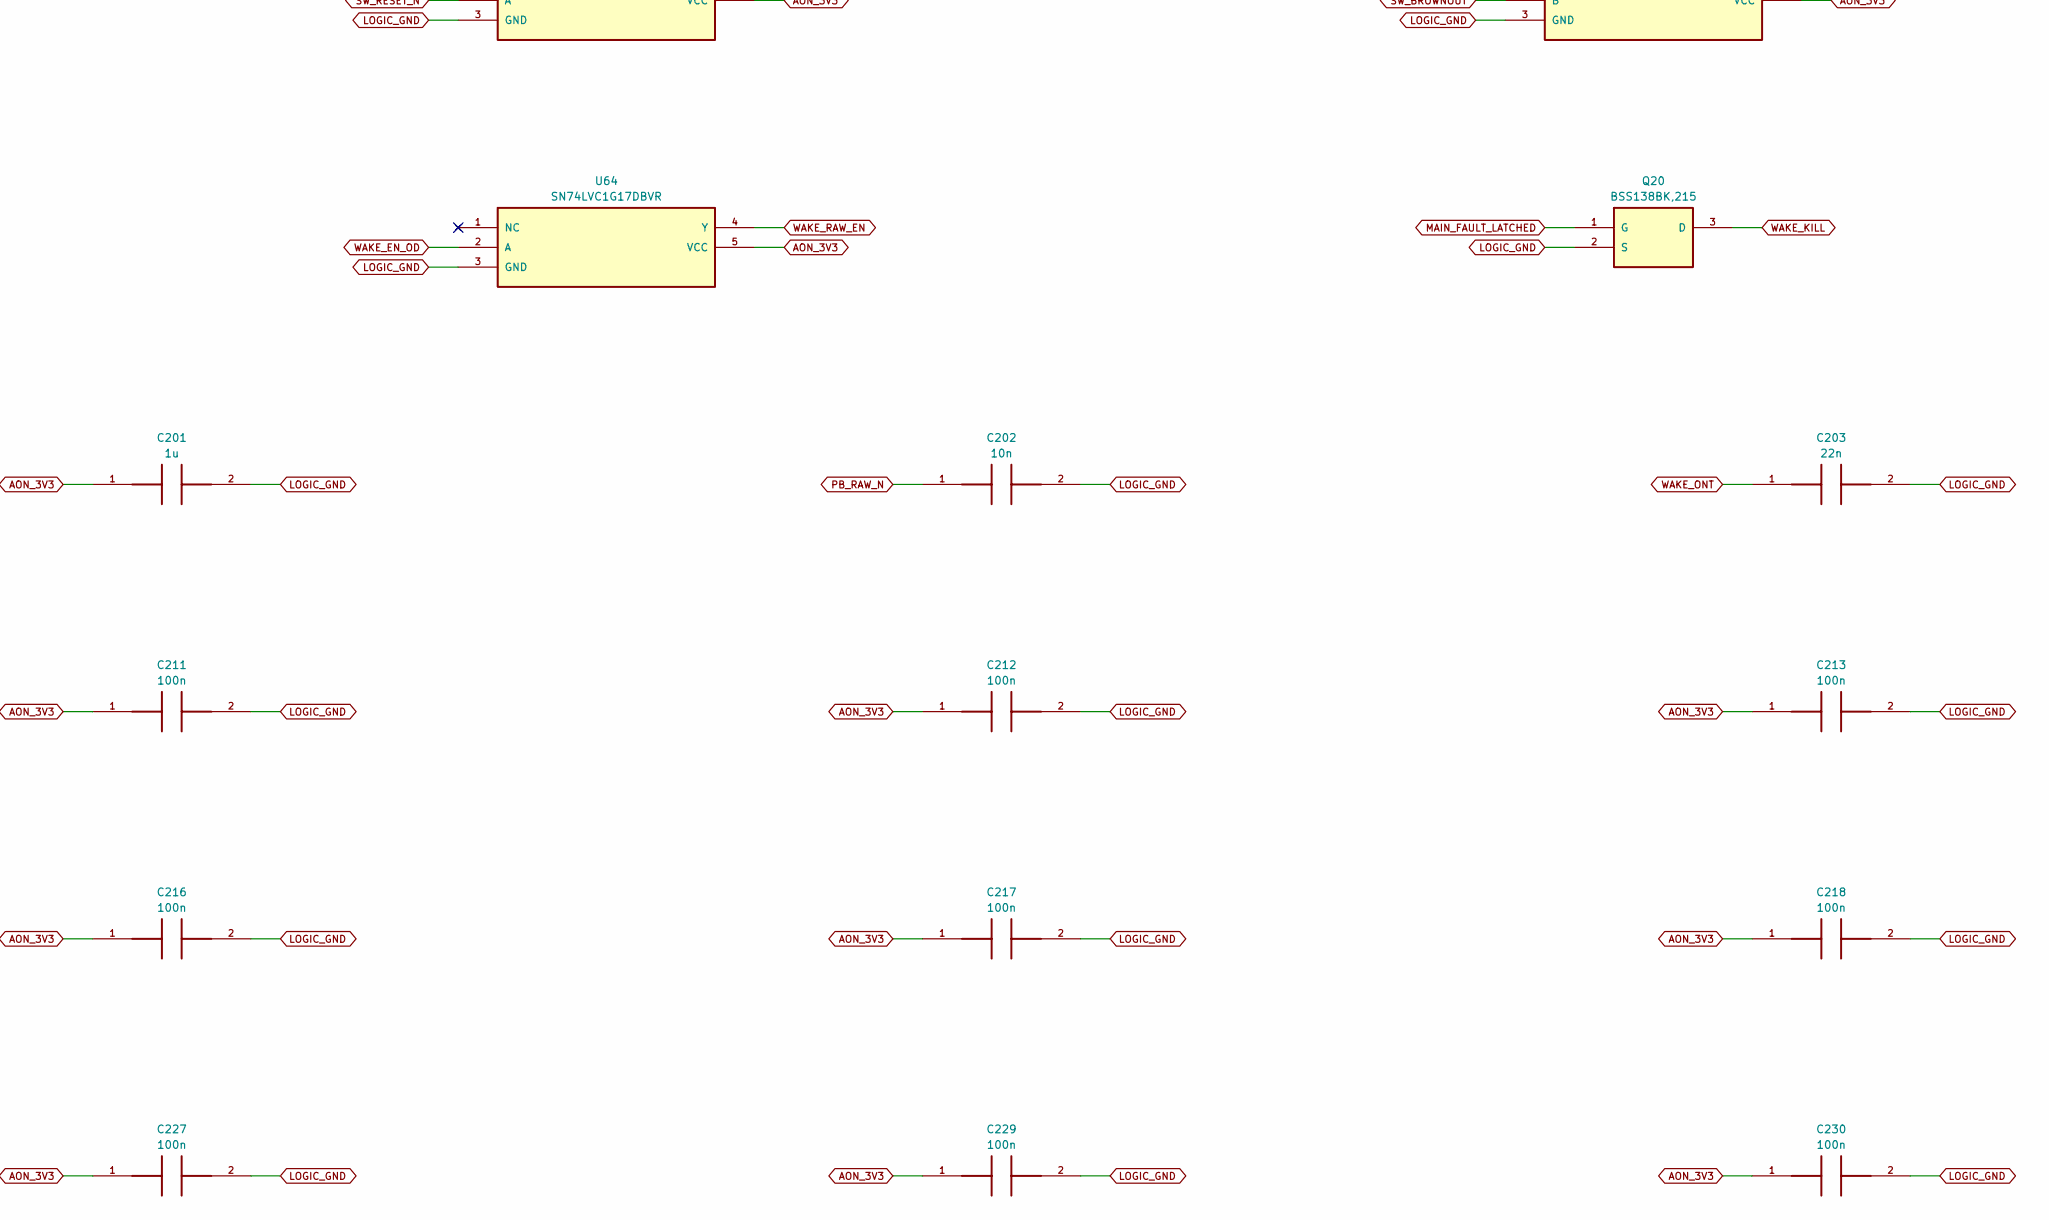
[picture p62: schematic 06a_aon_wake_p1.kicad_sch, PMU A / Wake and main latch / 1, part in row 2, column 2]

Parts:
C200: 100n; C_0805_2012Metric; MPN GRM21BR72A104KA01L
C201, C204: 1u; C_0805_2012Metric; MPN GRM21BR71C105KA01L
C202: 10n; C_0805_2012Metric; MPN GRM21BR71H103KA01L
C203: 22n; C_0805_2012Metric; MPN GRM21B5C1H223JA01L
C210, C211, C212, C213, C214, C215, C216, C217, C218, C219, C220, C227, C229, C230: 100n; C_0805_2012Metric; MPN GRM21BR71C104KA01L
Q20: BSS138BK,215; SOT-23; MPN BSS138BK,215
U15: LT3014BIS5#TRPBF; SOT-23-5; MPN LT3014BIS5#TRPBF
U16: LTC2954ITS8-1#TRPBF; TSOT-23-8; MPN LTC2954ITS8-1#TRPBF
U17: TPS3839G33DBZR; SOT-23; MPN TPS3839G33DBZR
U18, U23, U55: SN74LVC1G74DCUR; VSSOP-8_2.3x2mm_P0.5mm; MPN SN74LVC1G74DCUR
U19, U24: SN74LVC2G00DCUR; VSSOP-8_2.3x2mm_P0.5mm; MPN SN74LVC2G00DCUR
U20, U53, U56, U59: SN74LVC1G14DBVR; SOT-23-5; MPN SN74LVC1G14DBVR
U21: LTC6993IS6-1#TRPBF; TSOT-23-6; MPN LTC6993IS6-1#TRPBF
U22, U58: SN74LVC1G32DBVR; SOT-23-5; MPN SN74LVC1G32DBVR
U25, U57, U63: SN74LVC1G11DBVR; SOT-23-6; MPN SN74LVC1G11DBVR
U62, U64: SN74LVC1G17DBVR; SOT-23-5; MPN SN74LVC1G17DBVR

Connections:
AON_3V3: C201.1, C210.1, C211.1, C212.1, C213.1, C214.1, C215.1, C216.1, C217.1, C218.1, C219.1, C220.1, C227.1, C229.1, C230.1, U15.5 (OUT), U16.1 (VIN), U17.3 (VDD), U18.8 (VCC), U19.8 (VCC), U20.5 (VCC), U21.5 (V+), U22.5 (VCC), U23.8 (VCC), U24.8 (VCC), U25.5 (VCC), U53.5 (VCC), U55.2 (D), U55.7 (PRE_N), U55.8 (VCC), U56.5 (VCC), U57.5 (VCC), U57.6 (C), U58.5 (VCC), U59.5 (VCC), U62.5 (VCC), U63.5 (VCC), U64.5 (VCC); also elsewhere on the board
AON_FB: U15.4 (ADJ); also elsewhere on the board
AON_LDO_IN: C200.1, U15.1 (IN); also elsewhere on the board
AON_RESET_N: U17.2 (RESET_N), U18.6 (CLR_N), U19.2 (1B), U25.6 (C), U63.6 (C)
AON_WAKE_EN: U25.4 (Y); also elsewhere on the board
BUTTON_ARMED: U18.5 (Q), U19.6 (2B)
BUTTON_ARM_SET_N: U18.7 (PRE_N), U19.7 (1Y)
BUTTON_INT_N: U16.5 (INT); also elsewhere on the board
ESP_MAIN_HOLD_AON: U22.2 (B); also elsewhere on the board
KILL_HOLD_OR: U22.4 (Y); also elsewhere on the board
LOGIC_GND: C200.2, C201.2, C202.2, C203.2, C204.2, C210.2, C211.2, C212.2, C213.2, C214.2, C215.2, C216.2, C217.2, C218.2, C219.2, C220.2, C227.2, C229.2, C230.2, Q20.2 (S), U15.2 (GND), U16.4 (GND), U17.1 (GND), U18.1 (CLK), U18.2 (D), U18.4 (GND), U19.4 (GND), U20.3 (GND), U21.2 (GND), U22.3 (GND), U23.1 (CLK), U23.2 (D), U23.4 (GND), U24.4 (GND), U24.5 (2A), U24.6 (2B), U25.2 (GND), U53.3 (GND), U55.4 (GND), U56.3 (GND), U57.2 (GND), U58.3 (GND), U59.3 (GND), U62.3 (GND), U63.2 (GND), U64.3 (GND); also elsewhere on the board
MAIN_CAPTURE_DELAYED: U62.4 (Y), U63.3 (B)
MAIN_CAPTURE_EN: U24.1 (1A), U63.4 (Y)
MAIN_CAPTURE_RC: U62.2 (A); also elsewhere on the board
MAIN_FAULT_ANY: U24.2 (1B), U58.4 (Y)
MAIN_FAULT_ASSERTED: U53.4 (Y), U58.1 (A)
MAIN_FAULT_LATCHED: Q20.1 (G), U23.5 (Q)
MAIN_FAULT_N: U53.2 (A); also elsewhere on the board
MAIN_FAULT_SET_N: U23.7 (PRE_N), U24.7 (1Y)
MAIN_LATCH_OK: U23.3 (Q_N), U25.3 (B)
PB_LTC_N: U16.2 (PB), U19.3 (2Y)
PB_PRESSED: U19.5 (2A), U20.4 (Y), U59.2 (A)
PB_RAW_N: C202.1, U20.2 (A); also elsewhere on the board
PB_RELEASED: U19.1 (1A), U59.4 (Y)
STARTUP_DIV: U21.4 (DIV); also elsewhere on the board
STARTUP_GRANT: U21.6 (OUT), U22.1 (A)
STARTUP_RSET: U21.3 (SET); also elsewhere on the board
SW_BROWNOUT: U57.4 (Y), U58.2 (B)
SW_POWER_SEEN: U55.5 (Q), U57.1 (A)
SW_RESET_ASSERTED: U56.4 (Y), U57.3 (B)
SW_RESET_N: U55.1 (CLK), U56.2 (A); also elsewhere on the board
WAKE_EN_OD: U16.6 (EN), U64.2 (A); also elsewhere on the board
WAKE_KILL: Q20.3 (D), U16.8 (KILL); also elsewhere on the board
WAKE_ONT: C203.1, U16.3 (ONT)
WAKE_PDT: C204.1, U16.7 (PDT)
WAKE_RAW_EN: U21.1 (TRIG), U23.6 (CLR_N), U25.1 (A), U55.6 (CLR_N), U63.1 (A), U64.4 (Y); also elsewhere on the board

Notes on the sheet:
06a aon wake p1
