chris01-byte/HomeMy/hardware/power-management-unit/rev-a2-layout-280x260/kicad/HomeMy_PMU_RevA.kicad_pcb

## KiCad design hardware/power-management-unit/rev-a2-layout-280x260/kicad/HomeMy_PMU_RevA.kicad_pcb (continued)

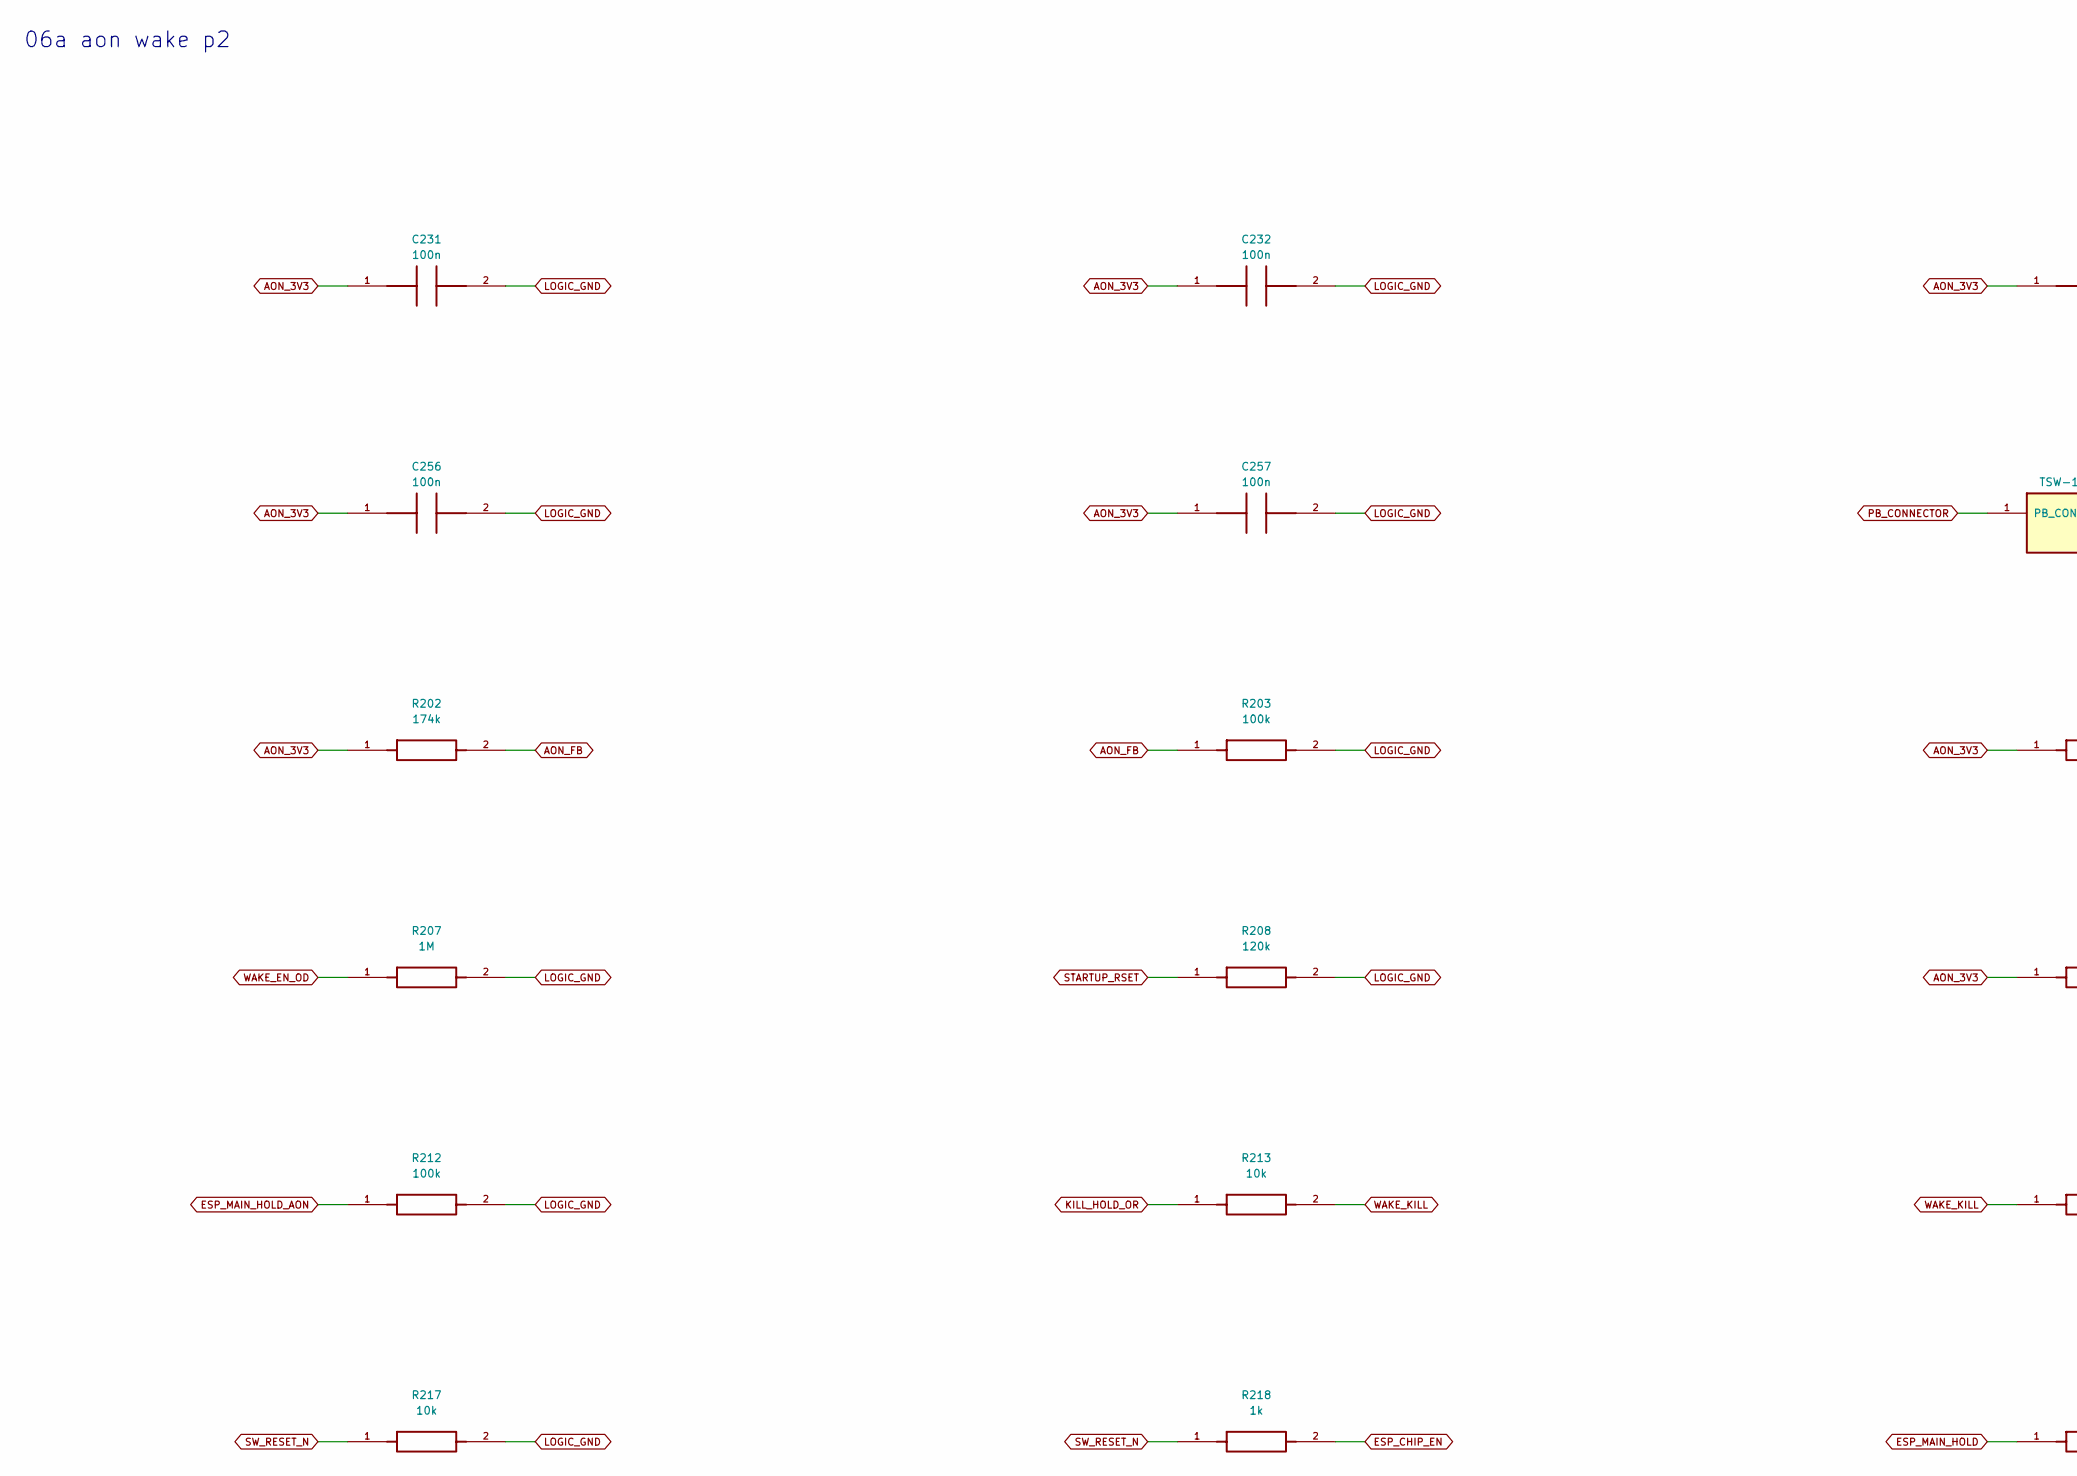
[picture p63: schematic 06a_aon_wake_p2.kicad_sch, PMU A / Wake and main latch / 2, part in row 1, column 1]

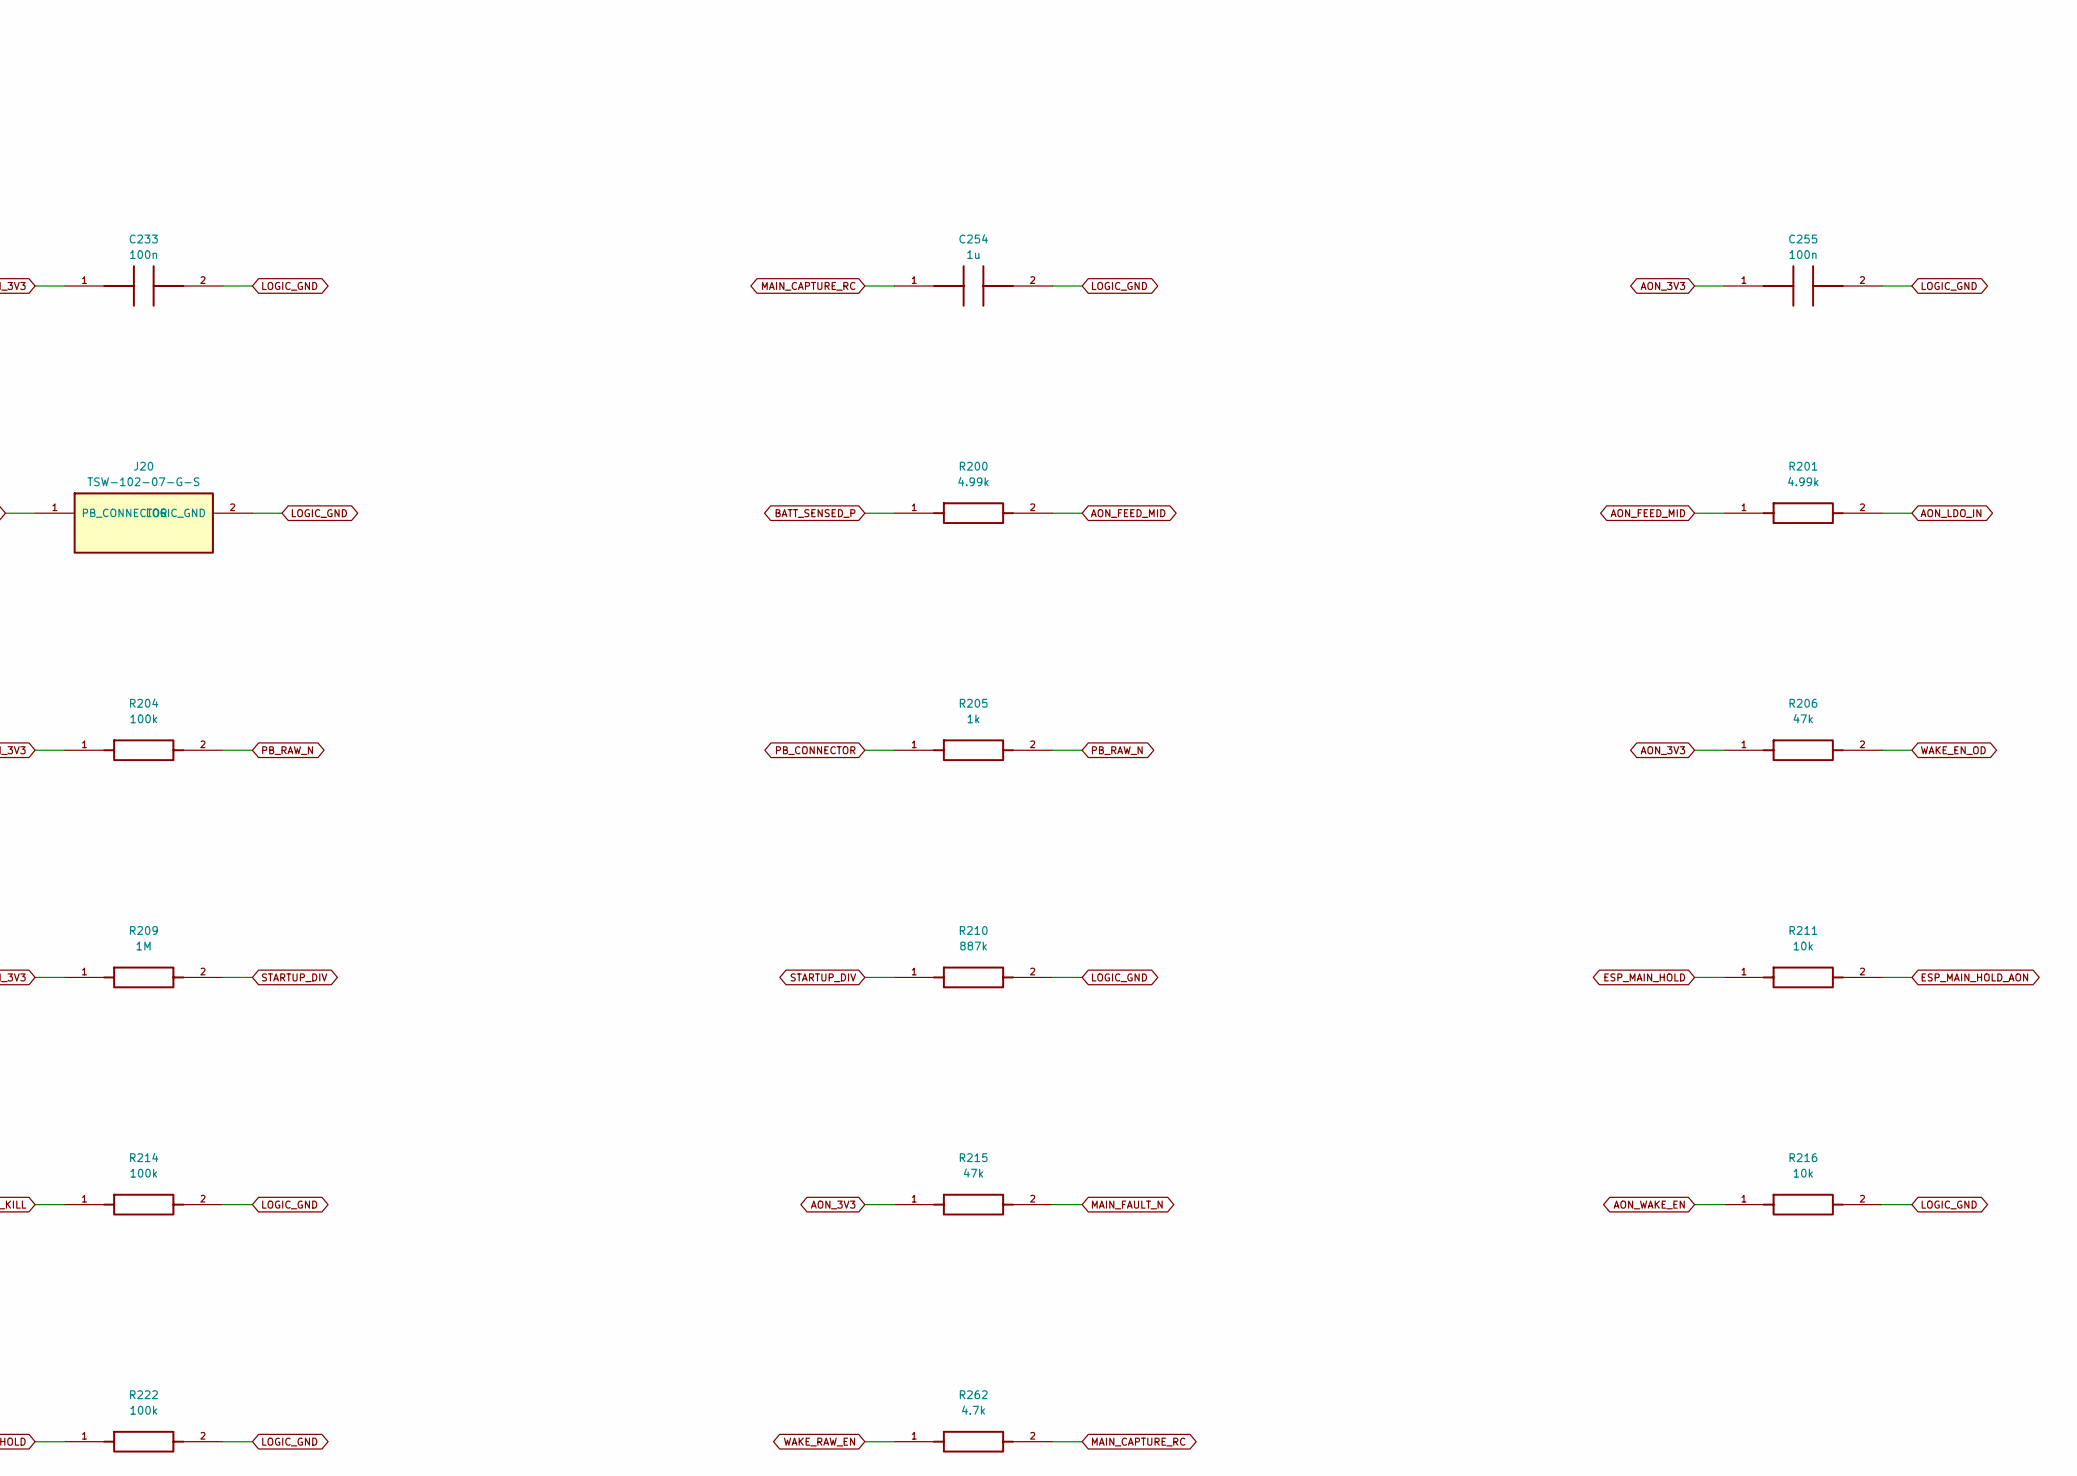
[picture p64: schematic 06a_aon_wake_p2.kicad_sch, PMU A / Wake and main latch / 2, part in row 1, column 2]

Parts:
C231, C232, C233, C255, C256, C257: 100n; C_0805_2012Metric; MPN GRM21BR71C104KA01L
C254: 1u; C_0805_2012Metric; MPN GRM21BR71C105KA01L
J20: TSW-102-07-G-S; PinHeader_1x02_P2.54mm_Vertical; MPN TSW-102-07-G-S
R200, R201: 4.99k; R_2010_5025Metric; MPN RC2010FK-074K99L
R202: 174k; R_0805_2012Metric; MPN RC0805FR-07174KL
R203, R204, R212, R214, R222: 100k; R_0805_2012Metric; MPN RC0805FR-07100KL
R205, R218: 1k; R_0805_2012Metric; MPN RC0805FR-071KL
R206, R215: 47k; R_0805_2012Metric; MPN RC0805FR-0747KL
R207, R209: 1M; R_0805_2012Metric; MPN RC0805FR-071ML
R208: 120k; R_0805_2012Metric; MPN RC0805FR-07120KL
R210: 887k; R_0805_2012Metric; MPN RC0805FR-07887KL
R211, R213, R216, R217: 10k; R_0805_2012Metric; MPN RC0805FR-0710KL
R262: 4.7k; R_0805_2012Metric; MPN RC0805FR-074K7L

Connections:
AON_3V3: C231.1, C232.1, C233.1, C255.1, C256.1, C257.1, R202.1, R204.1, R206.1, R209.1, R215.1; also elsewhere on the board
AON_FB: R202.2, R203.1; also elsewhere on the board
AON_FEED_MID: R200.2, R201.1
AON_LDO_IN: R201.2; also elsewhere on the board
AON_WAKE_EN: R216.1; also elsewhere on the board
BATT_SENSED_P: R200.1; also elsewhere on the board
ESP_CHIP_EN: R218.2; also elsewhere on the board
ESP_MAIN_HOLD: R211.1, R222.1; also elsewhere on the board
ESP_MAIN_HOLD_AON: R211.2, R212.1; also elsewhere on the board
KILL_HOLD_OR: R213.1; also elsewhere on the board
LOGIC_GND: C231.2, C232.2, C233.2, C254.2, C255.2, C256.2, C257.2, J20.2 (LOGIC_GND), R203.2, R207.2, R208.2, R210.2, R212.2, R214.2, R216.2, R217.2, R222.2; also elsewhere on the board
MAIN_CAPTURE_RC: C254.1, R262.2; also elsewhere on the board
MAIN_FAULT_N: R215.2; also elsewhere on the board
PB_CONNECTOR: J20.1 (PB_CONNECTOR), R205.1
PB_RAW_N: R204.2, R205.2; also elsewhere on the board
STARTUP_DIV: R209.2, R210.1; also elsewhere on the board
STARTUP_RSET: R208.1; also elsewhere on the board
SW_RESET_N: R217.1, R218.1; also elsewhere on the board
WAKE_EN_OD: R206.2, R207.1; also elsewhere on the board
WAKE_KILL: R213.2, R214.1; also elsewhere on the board
WAKE_RAW_EN: R262.1; also elsewhere on the board

Notes on the sheet:
06a aon wake p2

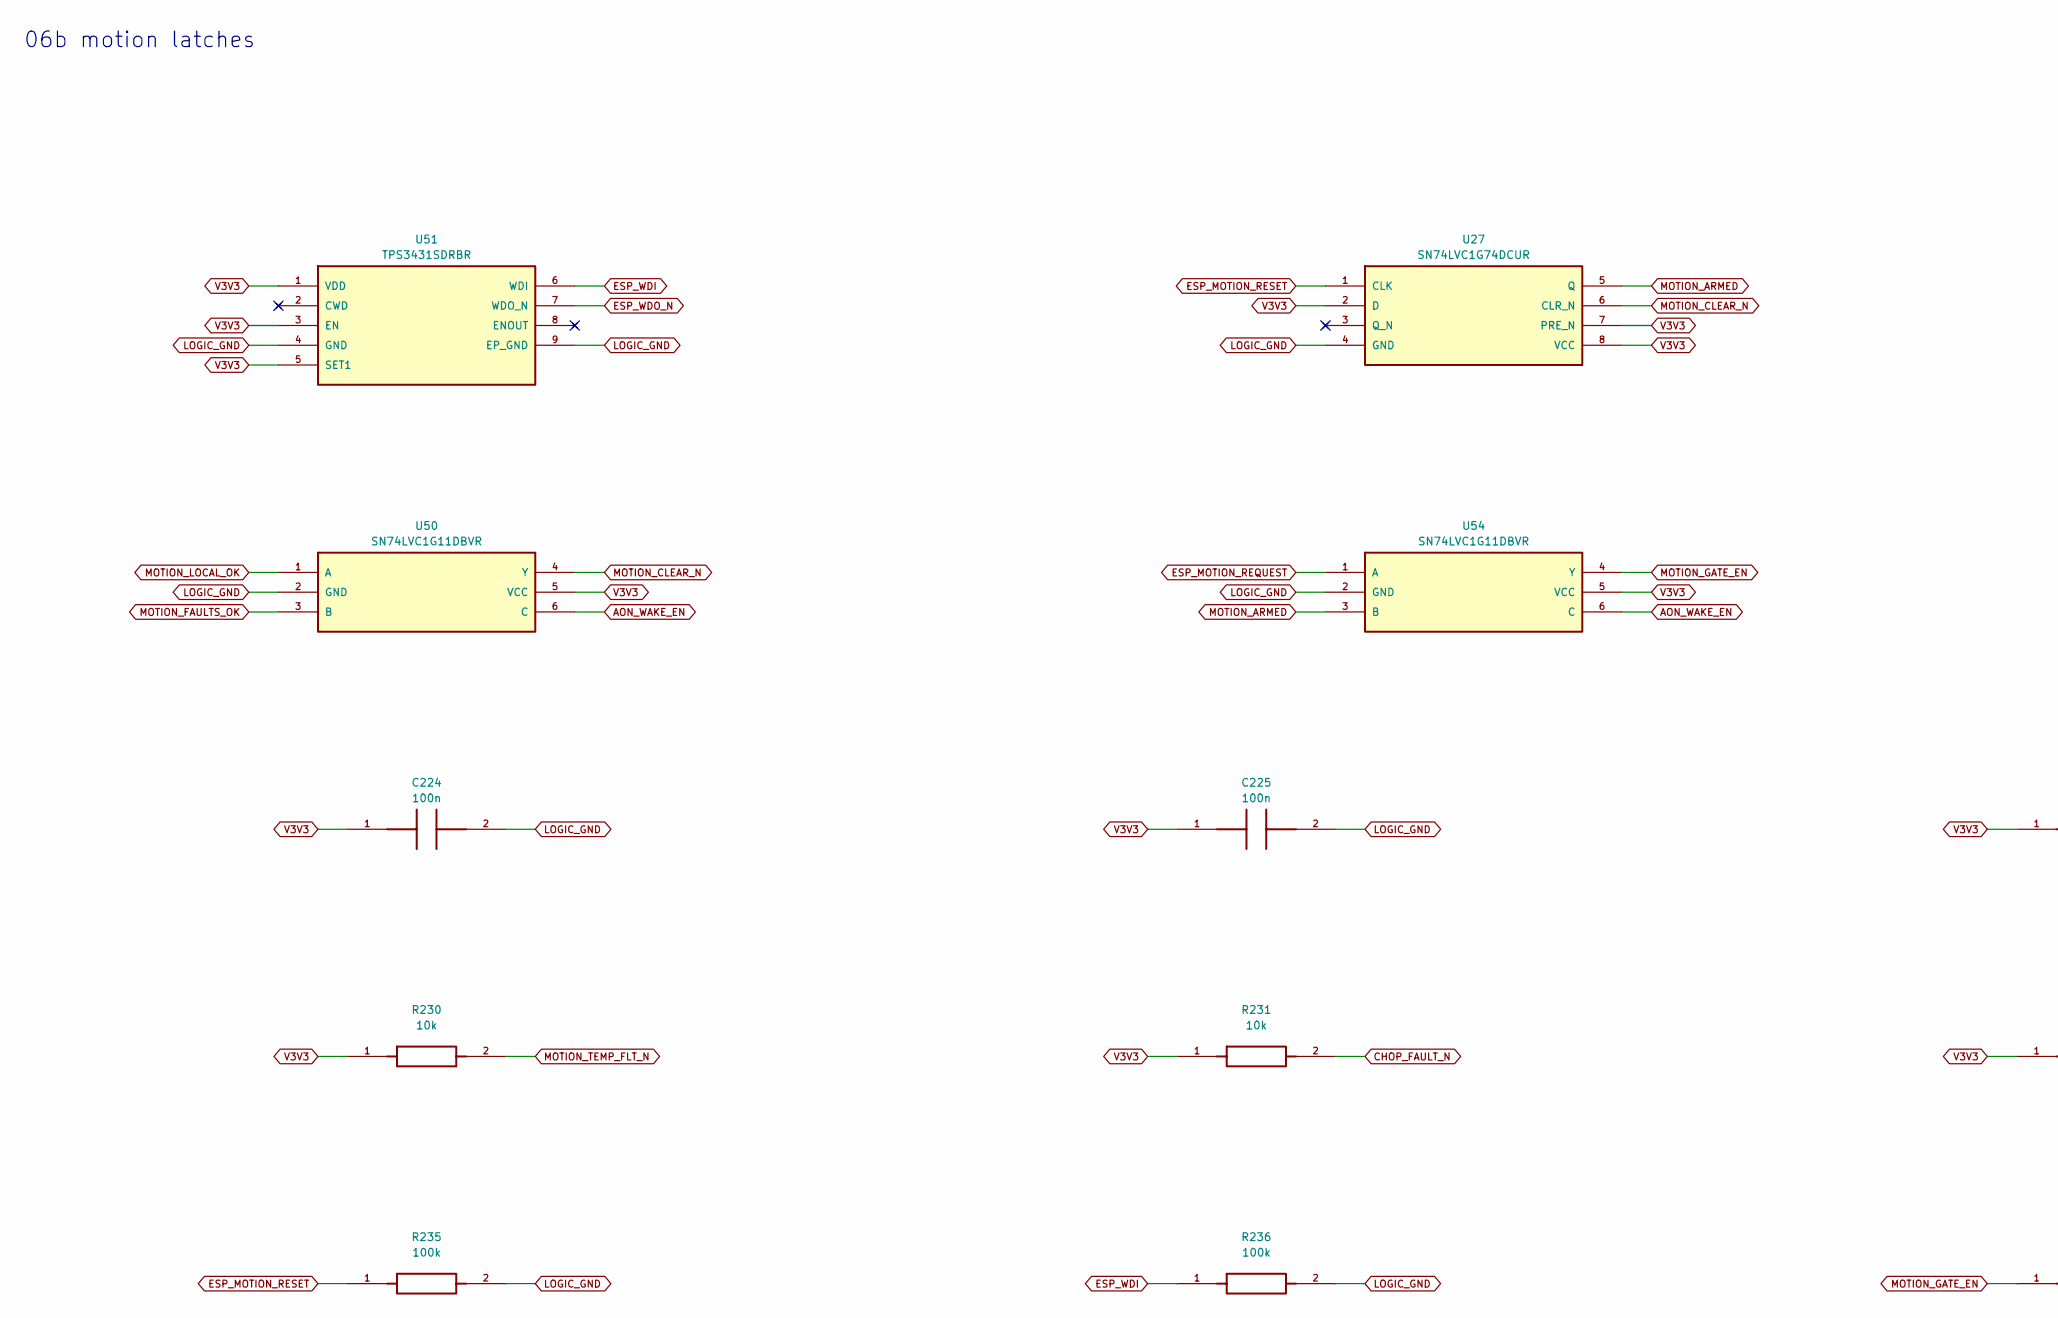
[picture p65: schematic 06b_motion_latches.kicad_sch, PMU A / Motion interlocks, part in row 1, column 1]

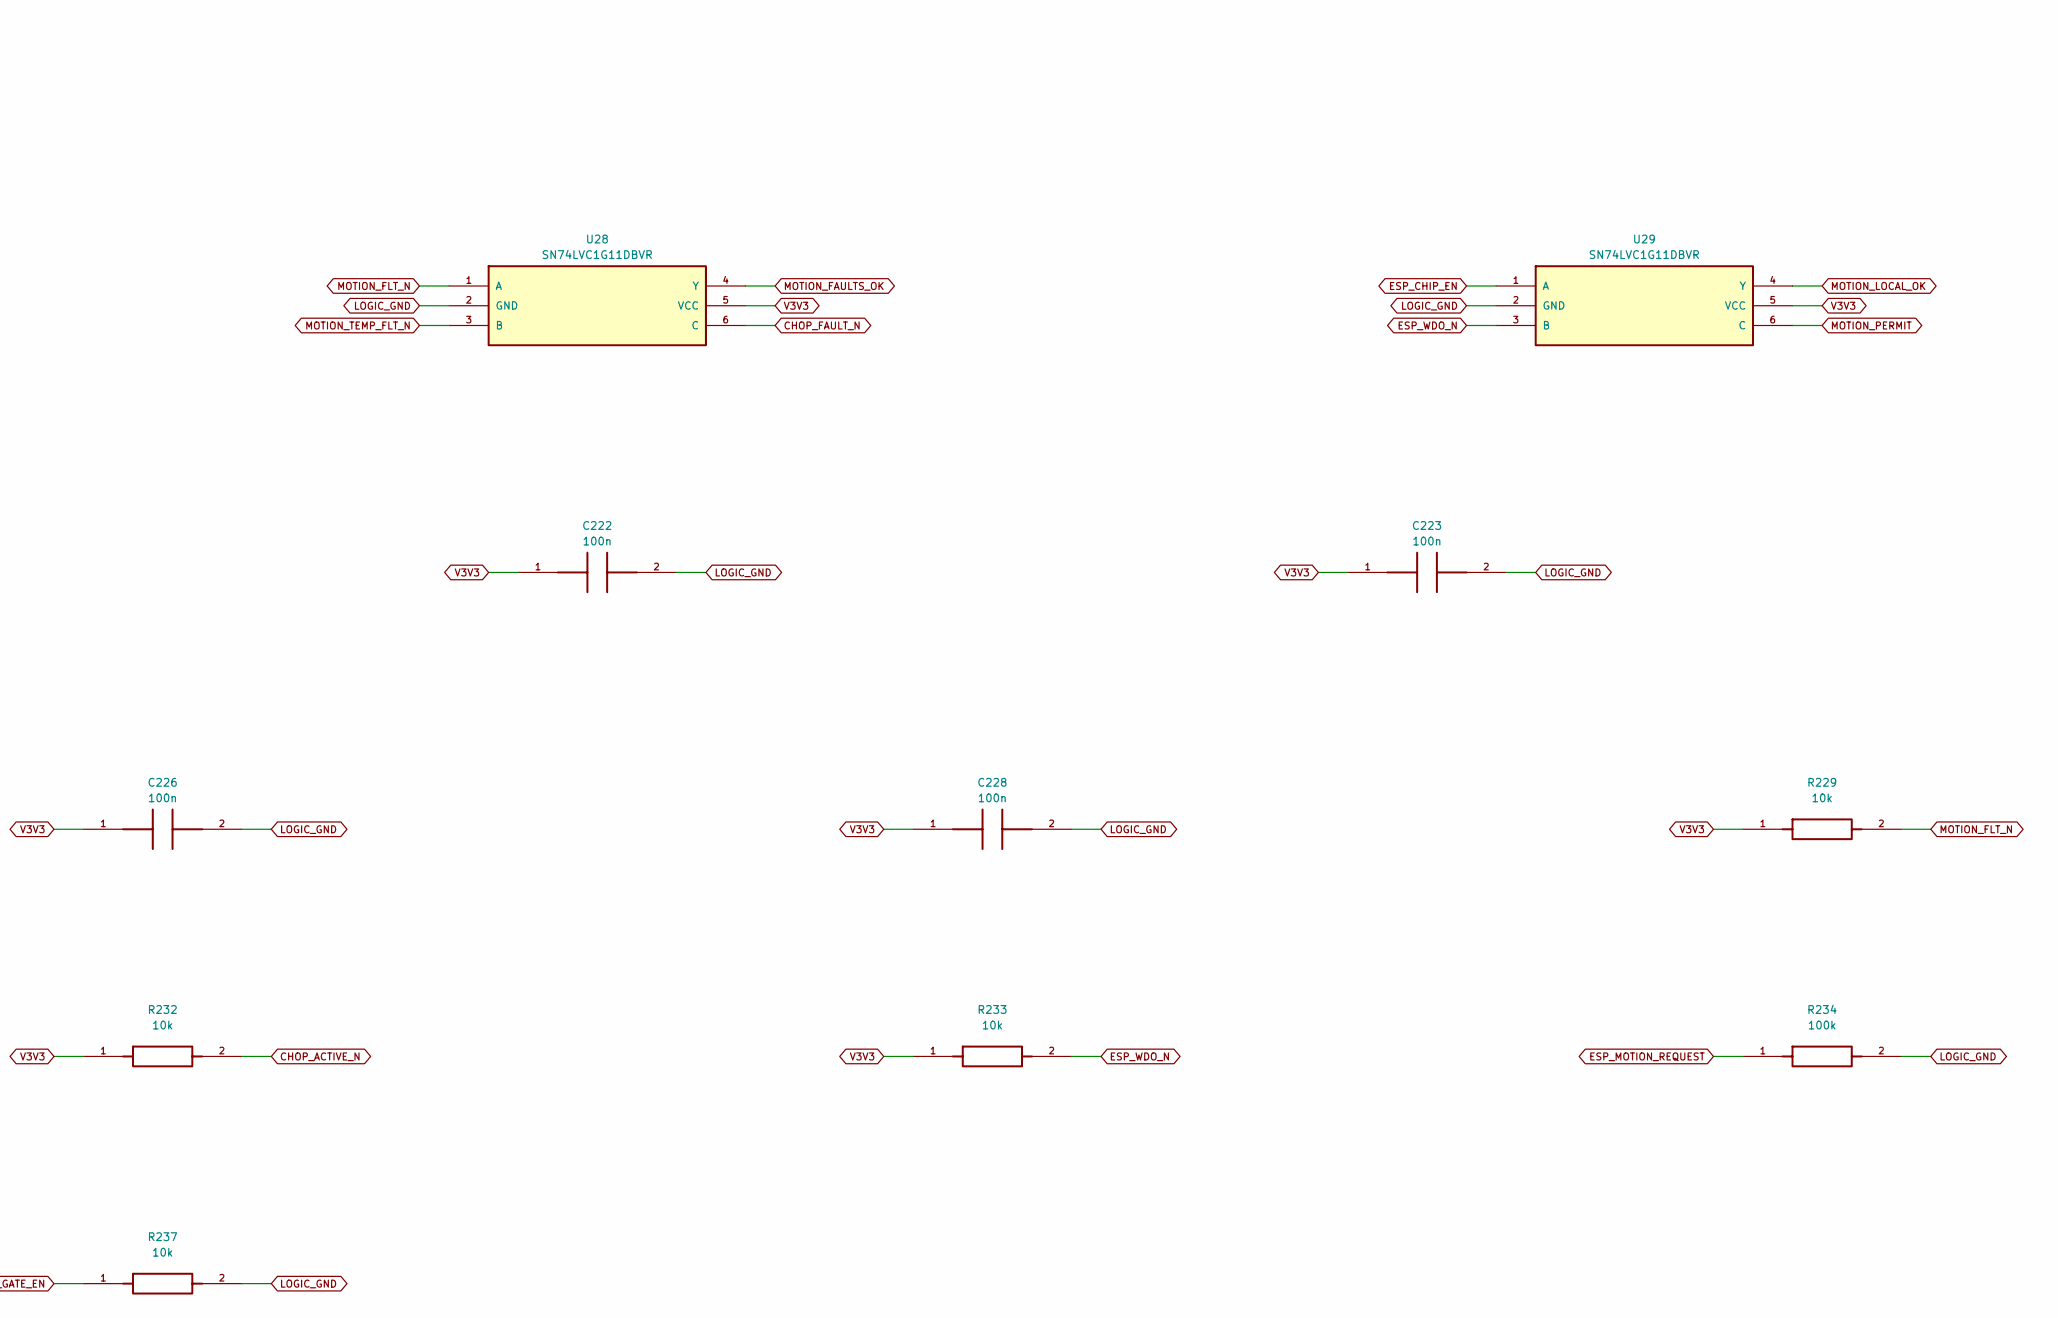
[picture p66: schematic 06b_motion_latches.kicad_sch, PMU A / Motion interlocks, part in row 1, column 2]

Parts:
C222, C223, C224, C225, C226, C228: 100n; C_0805_2012Metric; MPN GRM21BR71C104KA01L
R229, R230, R231, R232, R233, R237: 10k; R_0805_2012Metric; MPN RC0805FR-0710KL
R234, R235, R236: 100k; R_0805_2012Metric; MPN RC0805FR-07100KL
U27: SN74LVC1G74DCUR; VSSOP-8_2.3x2mm_P0.5mm; MPN SN74LVC1G74DCUR
U28, U29, U50, U54: SN74LVC1G11DBVR; SOT-23-6; MPN SN74LVC1G11DBVR
U51: TPS3431SDRBR; TI_DRB0008A_3x3mm_EP1.5x1.75; MPN TPS3431SDRBR

Connections:
AON_WAKE_EN: U50.6 (C), U54.6 (C); also elsewhere on the board
CHOP_ACTIVE_N: R232.2; also elsewhere on the board
CHOP_FAULT_N: R231.2, U28.6 (C); also elsewhere on the board
ESP_CHIP_EN: U29.1 (A); also elsewhere on the board
ESP_MOTION_REQUEST: R234.1, U54.1 (A); also elsewhere on the board
ESP_MOTION_RESET: R235.1, U27.1 (CLK); also elsewhere on the board
ESP_WDI: R236.1, U51.6 (WDI); also elsewhere on the board
ESP_WDO_N: R233.2, U29.3 (B), U51.7 (WDO_N)
LOGIC_GND: C222.2, C223.2, C224.2, C225.2, C226.2, C228.2, R234.2, R235.2, R236.2, R237.2, U27.4 (GND), U28.2 (GND), U29.2 (GND), U50.2 (GND), U51.4 (GND), U51.9 (EP_GND), U54.2 (GND); also elsewhere on the board
MOTION_ARMED: U27.5 (Q), U54.3 (B); also elsewhere on the board
MOTION_CLEAR_N: U27.6 (CLR_N), U50.4 (Y)
MOTION_FAULTS_OK: U28.4 (Y), U50.3 (B)
MOTION_FLT_N: R229.2, U28.1 (A); also elsewhere on the board
MOTION_GATE_EN: R237.1, U54.4 (Y); also elsewhere on the board
MOTION_LOCAL_OK: U29.4 (Y), U50.1 (A)
MOTION_PERMIT: U29.6 (C); also elsewhere on the board
MOTION_TEMP_FLT_N: R230.2, U28.3 (B); also elsewhere on the board
V3V3: C222.1, C223.1, C224.1, C225.1, C226.1, C228.1, R229.1, R230.1, R231.1, R232.1, R233.1, U27.2 (D), U27.7 (PRE_N), U27.8 (VCC), U28.5 (VCC), U29.5 (VCC), U50.5 (VCC), U51.1 (VDD), U51.3 (EN), U51.5 (SET1), U54.5 (VCC); also elsewhere on the board

Notes on the sheet:
06b motion latches
