chris01-byte/HomeMy/hardware/power-management-unit/rev-a2-layout-280x260/kicad/HomeMy_PMU_RevA.kicad_pcb

## KiCad design hardware/power-management-unit/rev-a2-layout-280x260/kicad/HomeMy_PMU_RevA.kicad_pcb (continued)

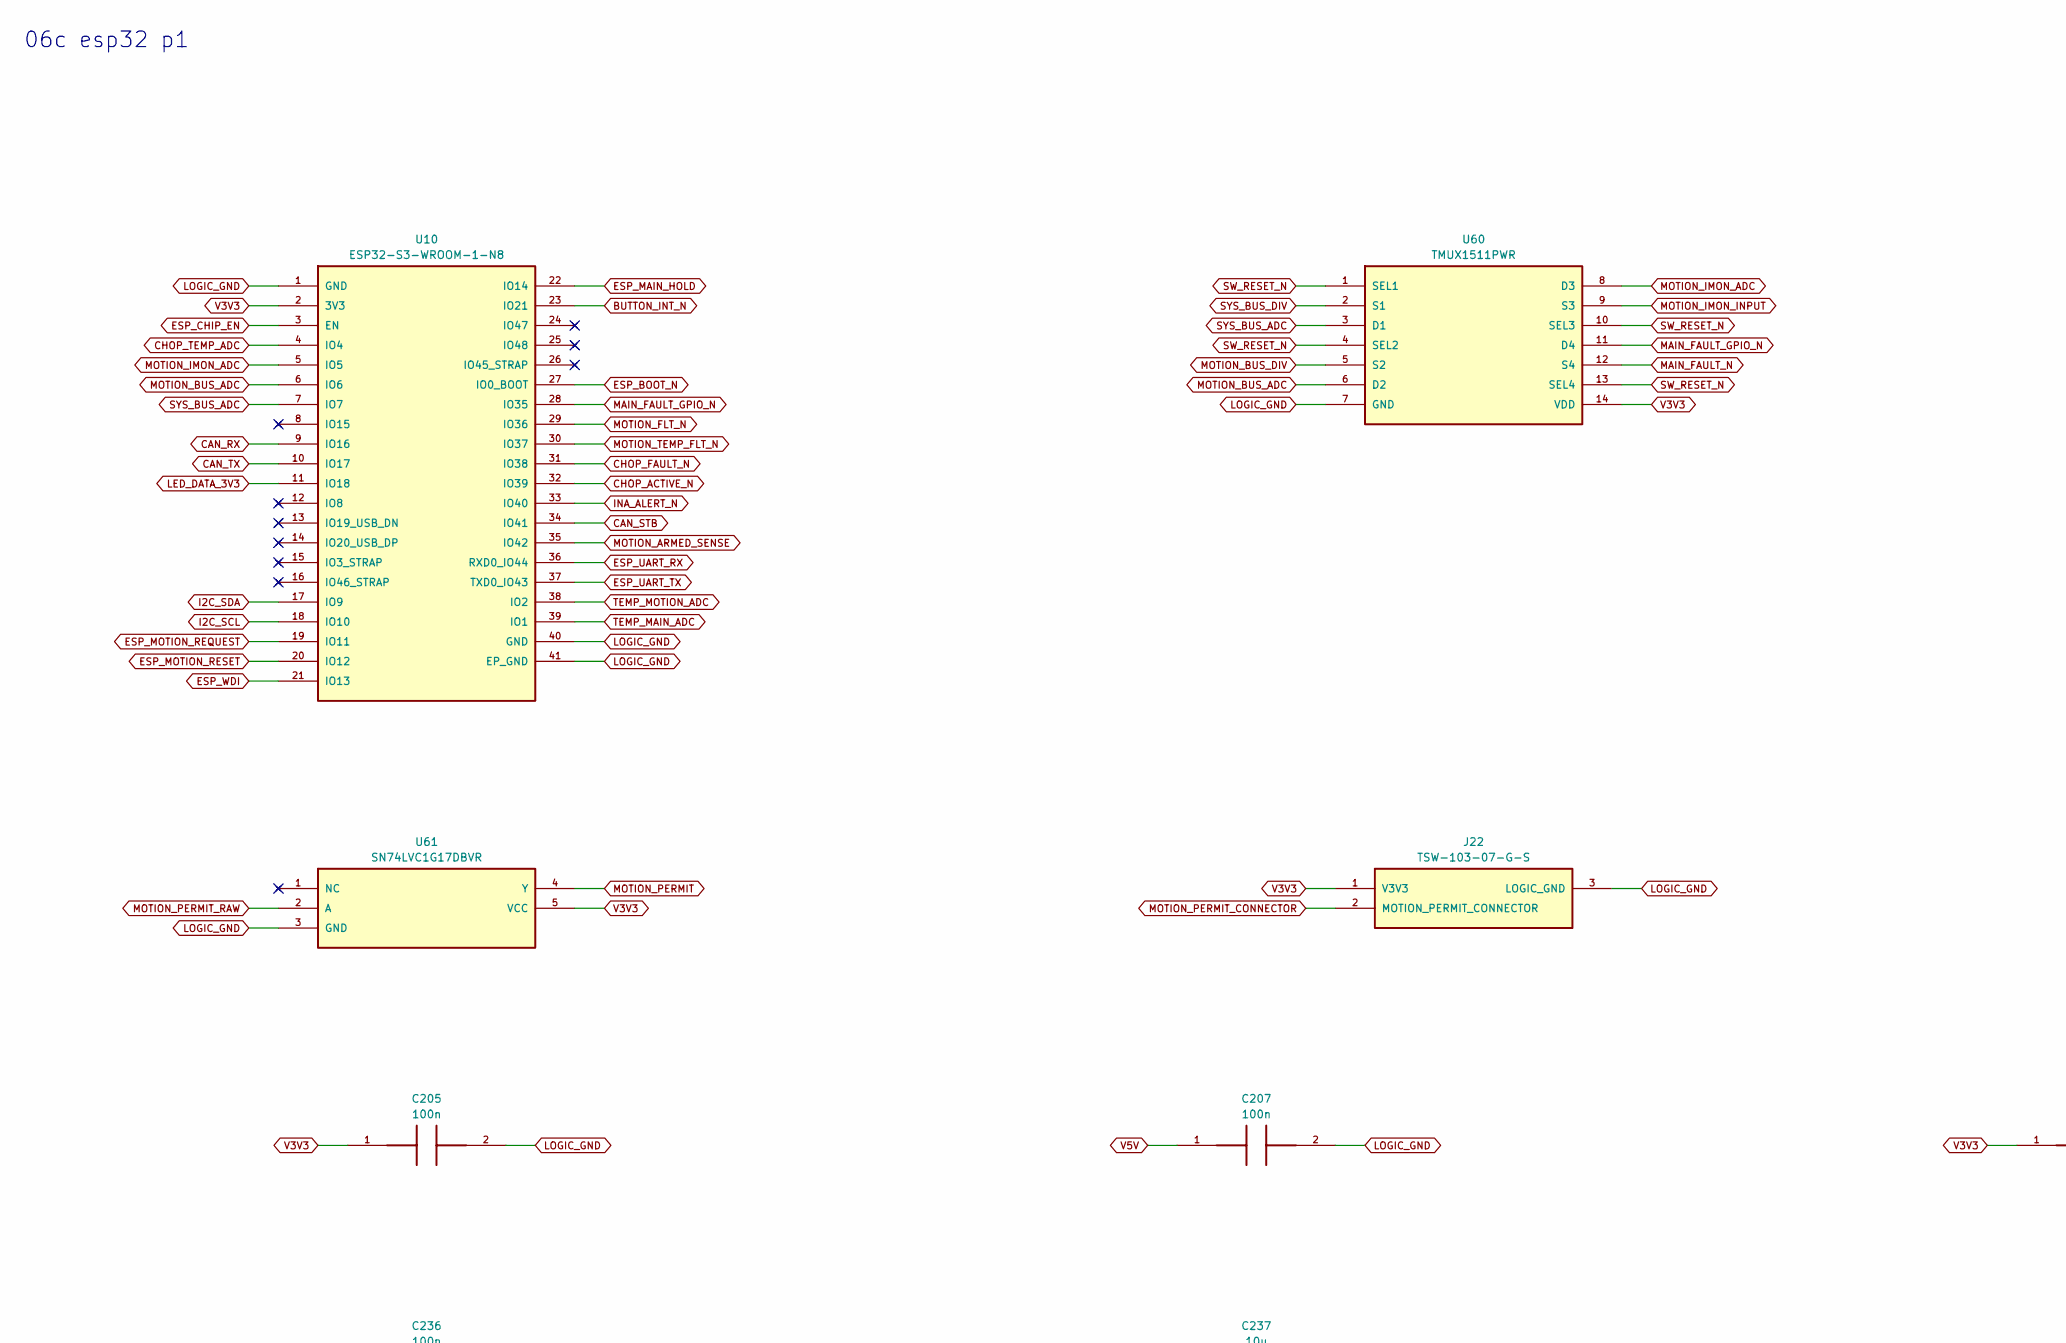
[picture p67: schematic 06c_esp32_p1.kicad_sch, PMU A / ESP32 and logic / 1, part in row 1, column 1]

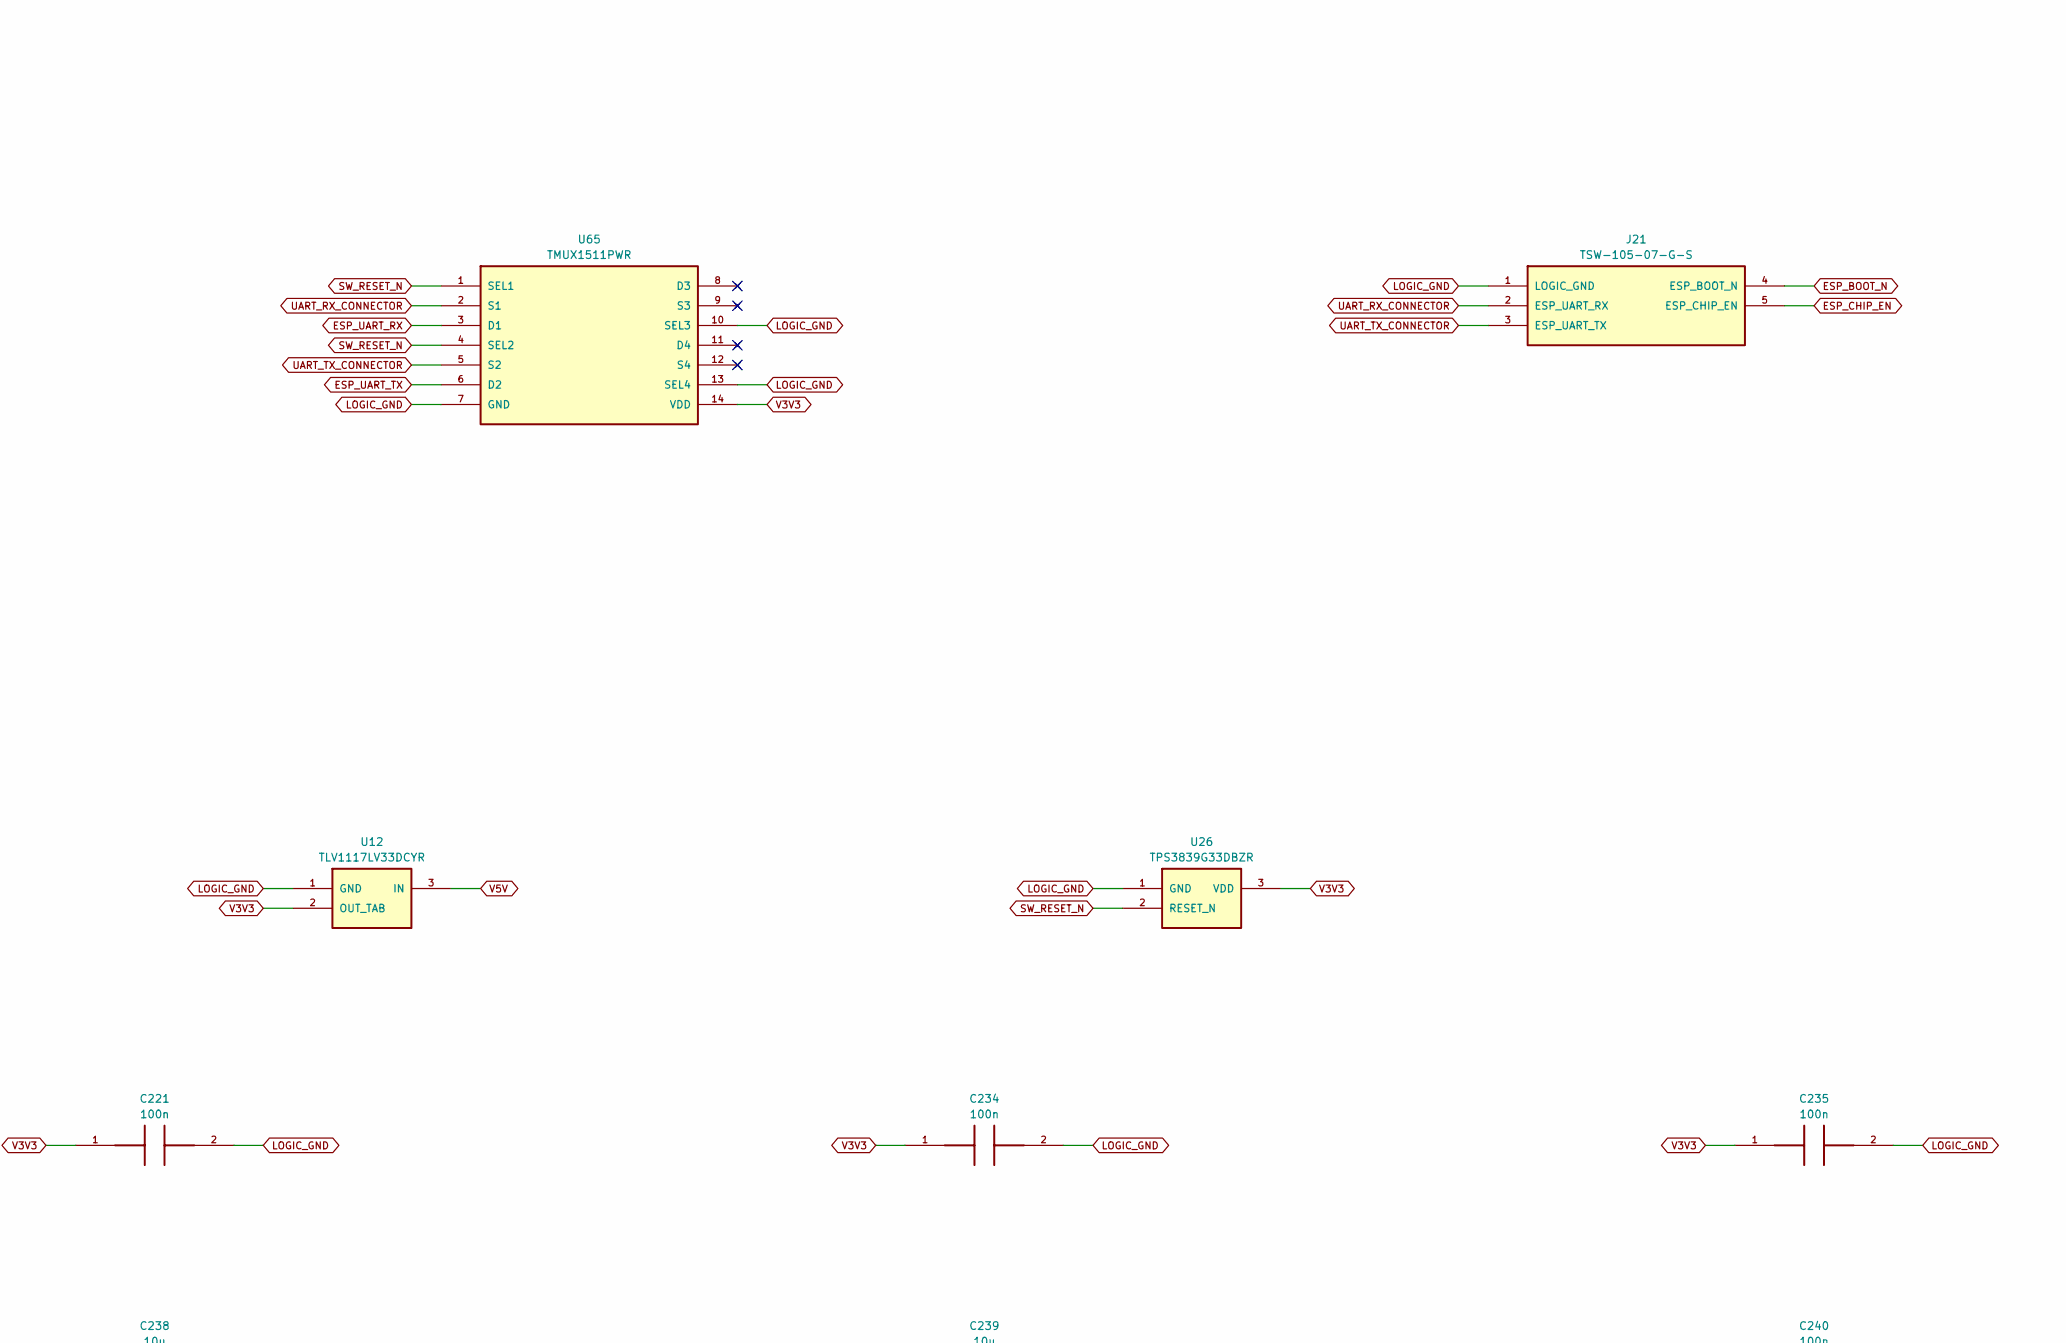
[picture p68: schematic 06c_esp32_p1.kicad_sch, PMU A / ESP32 and logic / 1, part in row 1, column 2]

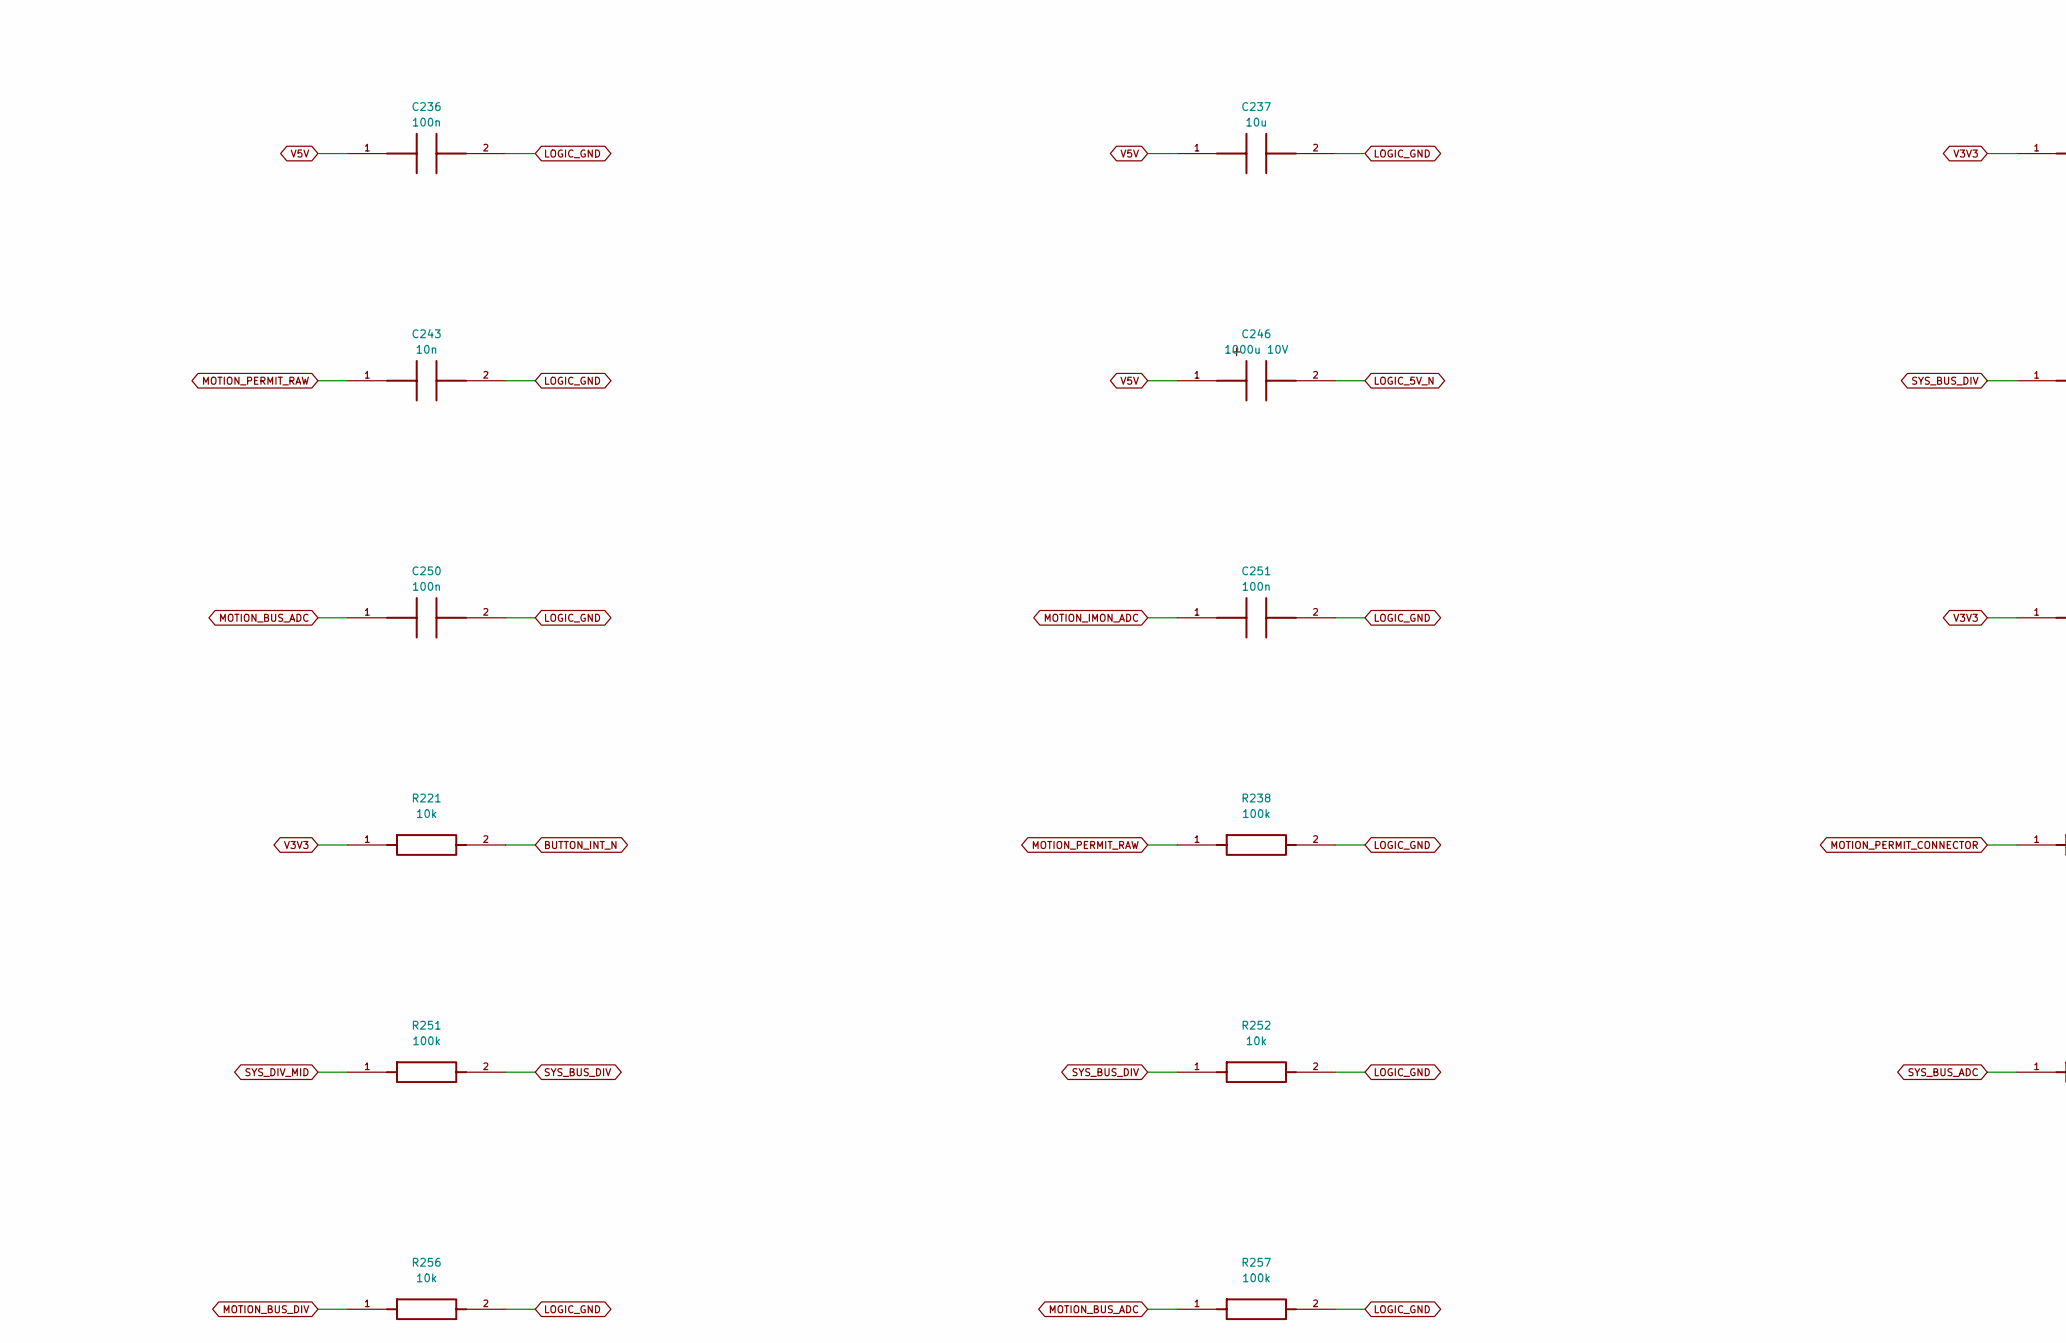
[picture p69: schematic 06c_esp32_p1.kicad_sch, PMU A / ESP32 and logic / 1, part in row 2, column 1]

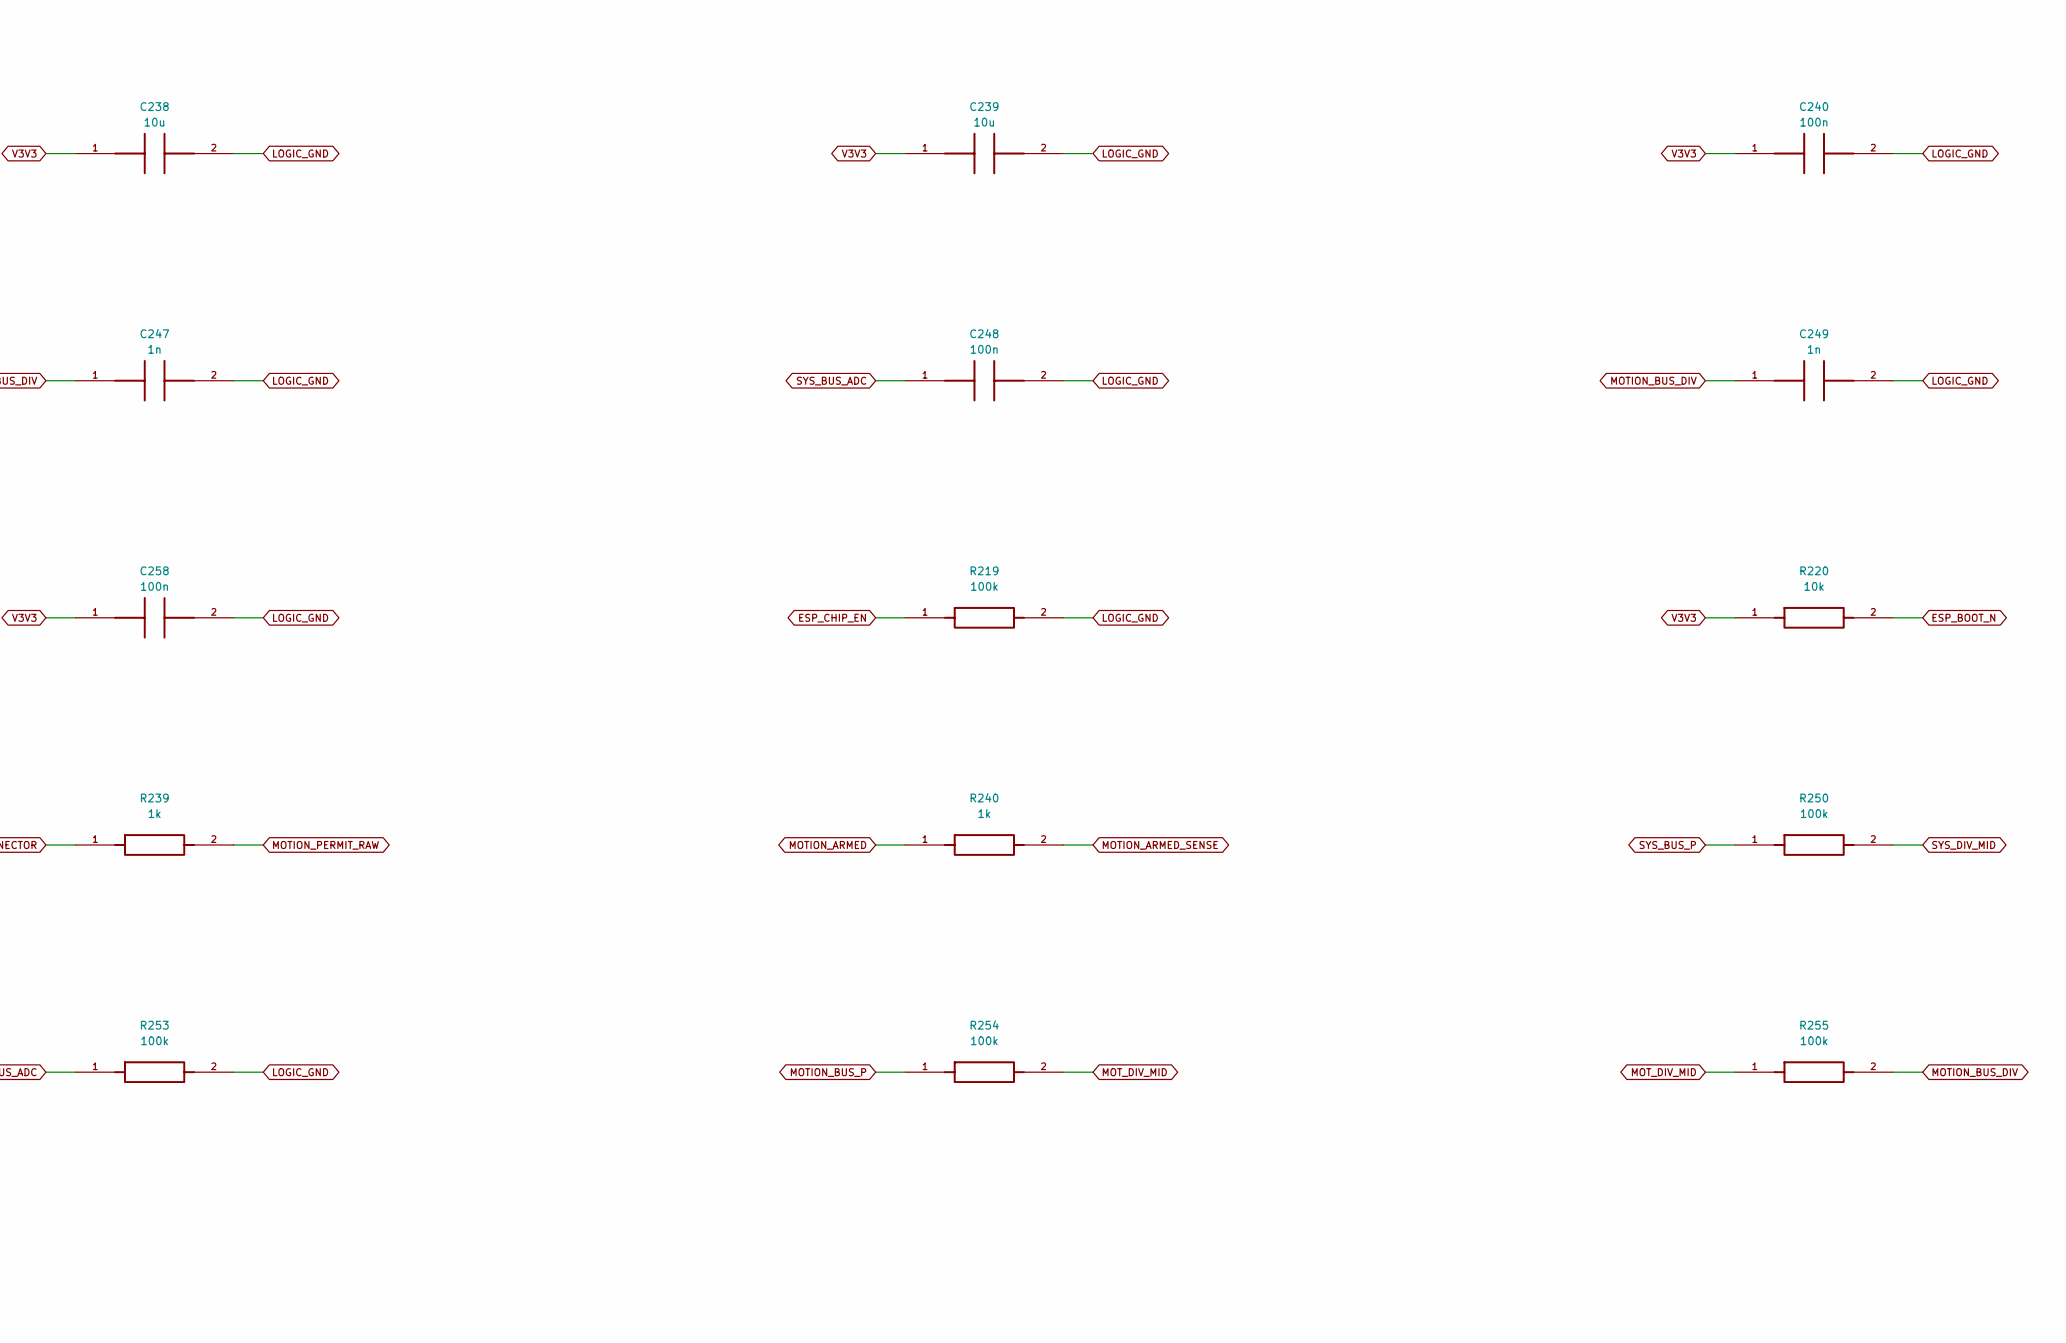
[picture p70: schematic 06c_esp32_p1.kicad_sch, PMU A / ESP32 and logic / 1, part in row 2, column 2]

Parts:
C205, C207, C221, C234, C235, C236, C240, C248, C250, C251, C258: 100n; C_0805_2012Metric; MPN GRM21BR71C104KA01L
C237, C238, C239: 10u; C_0805_2012Metric; MPN GRM21BR61A106KE19L
C243: 10n; C_0805_2012Metric; MPN GRM21BR71H103KA01L
C246: 1000u 10V; CP_Radial_D10.0mm_P5.00mm; MPN EEU-FR1A102
C247, C249: 1n; C_0805_2012Metric; MPN GRM21B5C1H102JA01L
J21: TSW-105-07-G-S; PinHeader_1x05_P2.54mm_Vertical; MPN TSW-105-07-G-S
J22: TSW-103-07-G-S; PinHeader_1x03_P2.54mm_Vertical; MPN TSW-103-07-G-S
R219, R238, R250, R251, R253, R254, R255, R257: 100k; R_0805_2012Metric; MPN RC0805FR-07100KL
R220, R221, R252, R256: 10k; R_0805_2012Metric; MPN RC0805FR-0710KL
R239, R240: 1k; R_0805_2012Metric; MPN RC0805FR-071KL
U10: ESP32-S3-WROOM-1-N8; ESP32-S3-WROOM-1; MPN ESP32-S3-WROOM-1-N8
U12: TLV1117LV33DCYR; SOT-223-3_TabPin2; MPN TLV1117LV33DCYR
U26: TPS3839G33DBZR; SOT-23; MPN TPS3839G33DBZR
U60, U65: TMUX1511PWR; TSSOP-14_4.4x5mm_P0.65mm; MPN TMUX1511PWR
U61: SN74LVC1G17DBVR; SOT-23-5; MPN SN74LVC1G17DBVR

Connections:
BUTTON_INT_N: R221.2, U10.23 (IO21); also elsewhere on the board
CAN_RX: U10.9 (IO16); also elsewhere on the board
CAN_STB: U10.34 (IO41); also elsewhere on the board
CAN_TX: U10.10 (IO17); also elsewhere on the board
CHOP_ACTIVE_N: U10.32 (IO39); also elsewhere on the board
CHOP_FAULT_N: U10.31 (IO38); also elsewhere on the board
CHOP_TEMP_ADC: U10.4 (IO4); also elsewhere on the board
ESP_BOOT_N: J21.4 (ESP_BOOT_N), R220.2, U10.27 (IO0_BOOT)
ESP_CHIP_EN: J21.5 (ESP_CHIP_EN), R219.1, U10.3 (EN); also elsewhere on the board
ESP_MAIN_HOLD: U10.22 (IO14); also elsewhere on the board
ESP_MOTION_REQUEST: U10.19 (IO11); also elsewhere on the board
ESP_MOTION_RESET: U10.20 (IO12); also elsewhere on the board
ESP_UART_RX: U10.36 (RXD0_IO44), U65.3 (D1); also elsewhere on the board
ESP_UART_TX: U10.37 (TXD0_IO43), U65.6 (D2); also elsewhere on the board
ESP_WDI: U10.21 (IO13); also elsewhere on the board
I2C_SCL: U10.18 (IO10); also elsewhere on the board
I2C_SDA: U10.17 (IO9); also elsewhere on the board
INA_ALERT_N: U10.33 (IO40); also elsewhere on the board
LED_DATA_3V3: U10.11 (IO18); also elsewhere on the board
LOGIC_5V_N: C246.2; also elsewhere on the board
LOGIC_GND: C205.2, C207.2, C221.2, C234.2, C235.2, C236.2, C237.2, C238.2, C239.2, C240.2, C243.2, C247.2, C248.2, C249.2, C250.2, C251.2, C258.2, J21.1 (LOGIC_GND), J22.3 (LOGIC_GND), R219.2, R238.2, R252.2, R253.2, R256.2, R257.2, U10.1 (GND), U10.40 (GND), U10.41 (EP_GND), U12.1 (GND), U26.1 (GND), U60.7 (GND), U61.3 (GND), U65.7 (GND), U65.10 (SEL3), U65.13 (SEL4); also elsewhere on the board
MAIN_FAULT_GPIO_N: U10.28 (IO35), U60.11 (D4); also elsewhere on the board
MAIN_FAULT_N: U60.12 (S4); also elsewhere on the board
MOTION_ARMED: R240.1; also elsewhere on the board
MOTION_ARMED_SENSE: R240.2, U10.35 (IO42)
MOTION_BUS_ADC: C250.1, R257.1, U10.6 (IO6), U60.6 (D2)
MOTION_BUS_DIV: C249.1, R255.2, R256.1, U60.5 (S2)
MOTION_BUS_P: R254.1; also elsewhere on the board
MOTION_FLT_N: U10.29 (IO36); also elsewhere on the board
MOTION_IMON_ADC: C251.1, U10.5 (IO5), U60.8 (D3); also elsewhere on the board
MOTION_IMON_INPUT: U60.9 (S3); also elsewhere on the board
MOTION_PERMIT: U61.4 (Y); also elsewhere on the board
MOTION_PERMIT_CONNECTOR: J22.2 (MOTION_PERMIT_CONNECTOR), R239.1
MOTION_PERMIT_RAW: C243.1, R238.1, R239.2, U61.2 (A)
MOTION_TEMP_FLT_N: U10.30 (IO37); also elsewhere on the board
MOT_DIV_MID: R254.2, R255.1
SW_RESET_N: U26.2 (RESET_N), U60.1 (SEL1), U60.4 (SEL2), U60.10 (SEL3), U60.13 (SEL4), U65.1 (SEL1), U65.4 (SEL2); also elsewhere on the board
SYS_BUS_ADC: C248.1, R253.1, U10.7 (IO7), U60.3 (D1)
SYS_BUS_DIV: C247.1, R251.2, R252.1, U60.2 (S1)
SYS_BUS_P: R250.1; also elsewhere on the board
SYS_DIV_MID: R250.2, R251.1
TEMP_MAIN_ADC: U10.39 (IO1); also elsewhere on the board
TEMP_MOTION_ADC: U10.38 (IO2); also elsewhere on the board
UART_RX_CONNECTOR: J21.2 (ESP_UART_RX), U65.2 (S1)
UART_TX_CONNECTOR: J21.3 (ESP_UART_TX), U65.5 (S2)
V3V3: C205.1, C221.1, C234.1, C235.1, C238.1, C239.1, C240.1, C258.1, J22.1 (V3V3), R220.1, R221.1, U10.2 (3V3), U12.2 (OUT_TAB), U26.3 (VDD), U60.14 (VDD), U61.5 (VCC), U65.14 (VDD); also elsewhere on the board
V5V: C207.1, C236.1, C237.1, C246.1, U12.3 (IN); also elsewhere on the board

Notes on the sheet:
06c esp32 p1

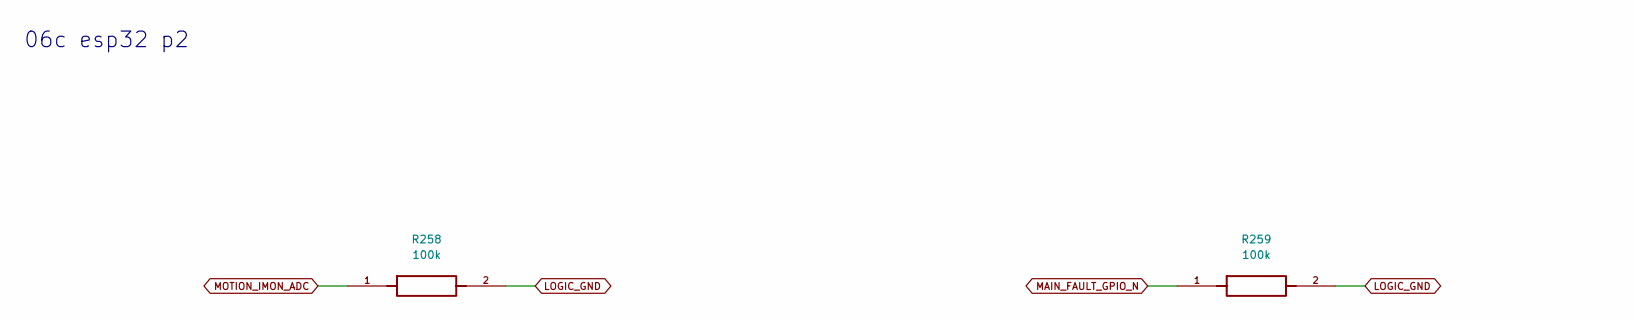
[picture p71: schematic 06c_esp32_p2.kicad_sch, PMU A / ESP32 and logic / 2, part in row 1, column 1]

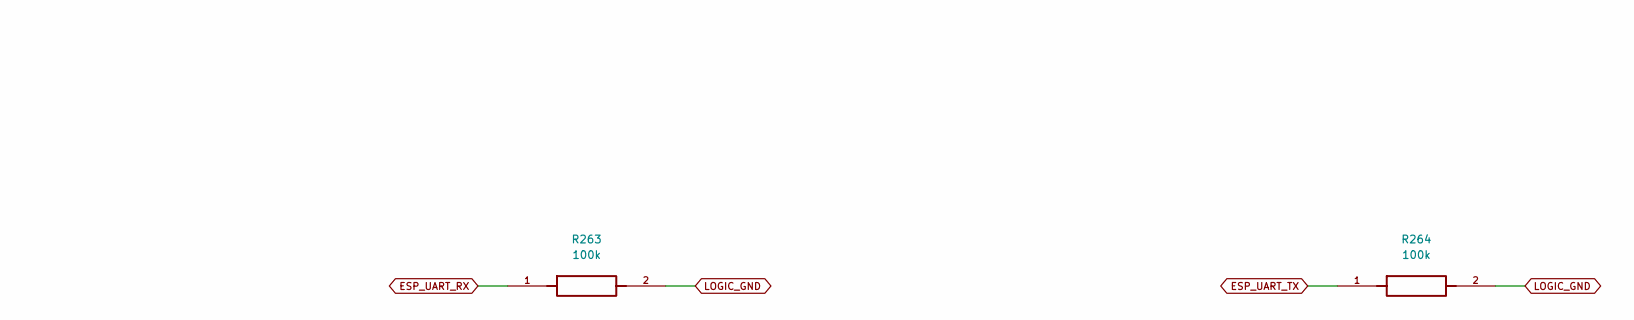
[picture p72: schematic 06c_esp32_p2.kicad_sch, PMU A / ESP32 and logic / 2, part in row 1, column 2]

Parts:
R258, R259, R263, R264: 100k; R_0805_2012Metric; MPN RC0805FR-07100KL

Connections:
ESP_UART_RX: R263.1; also elsewhere on the board
ESP_UART_TX: R264.1; also elsewhere on the board
LOGIC_GND: R258.2, R259.2, R263.2, R264.2; also elsewhere on the board
MAIN_FAULT_GPIO_N: R259.1; also elsewhere on the board
MOTION_IMON_ADC: R258.1; also elsewhere on the board

Notes on the sheet:
06c esp32 p2

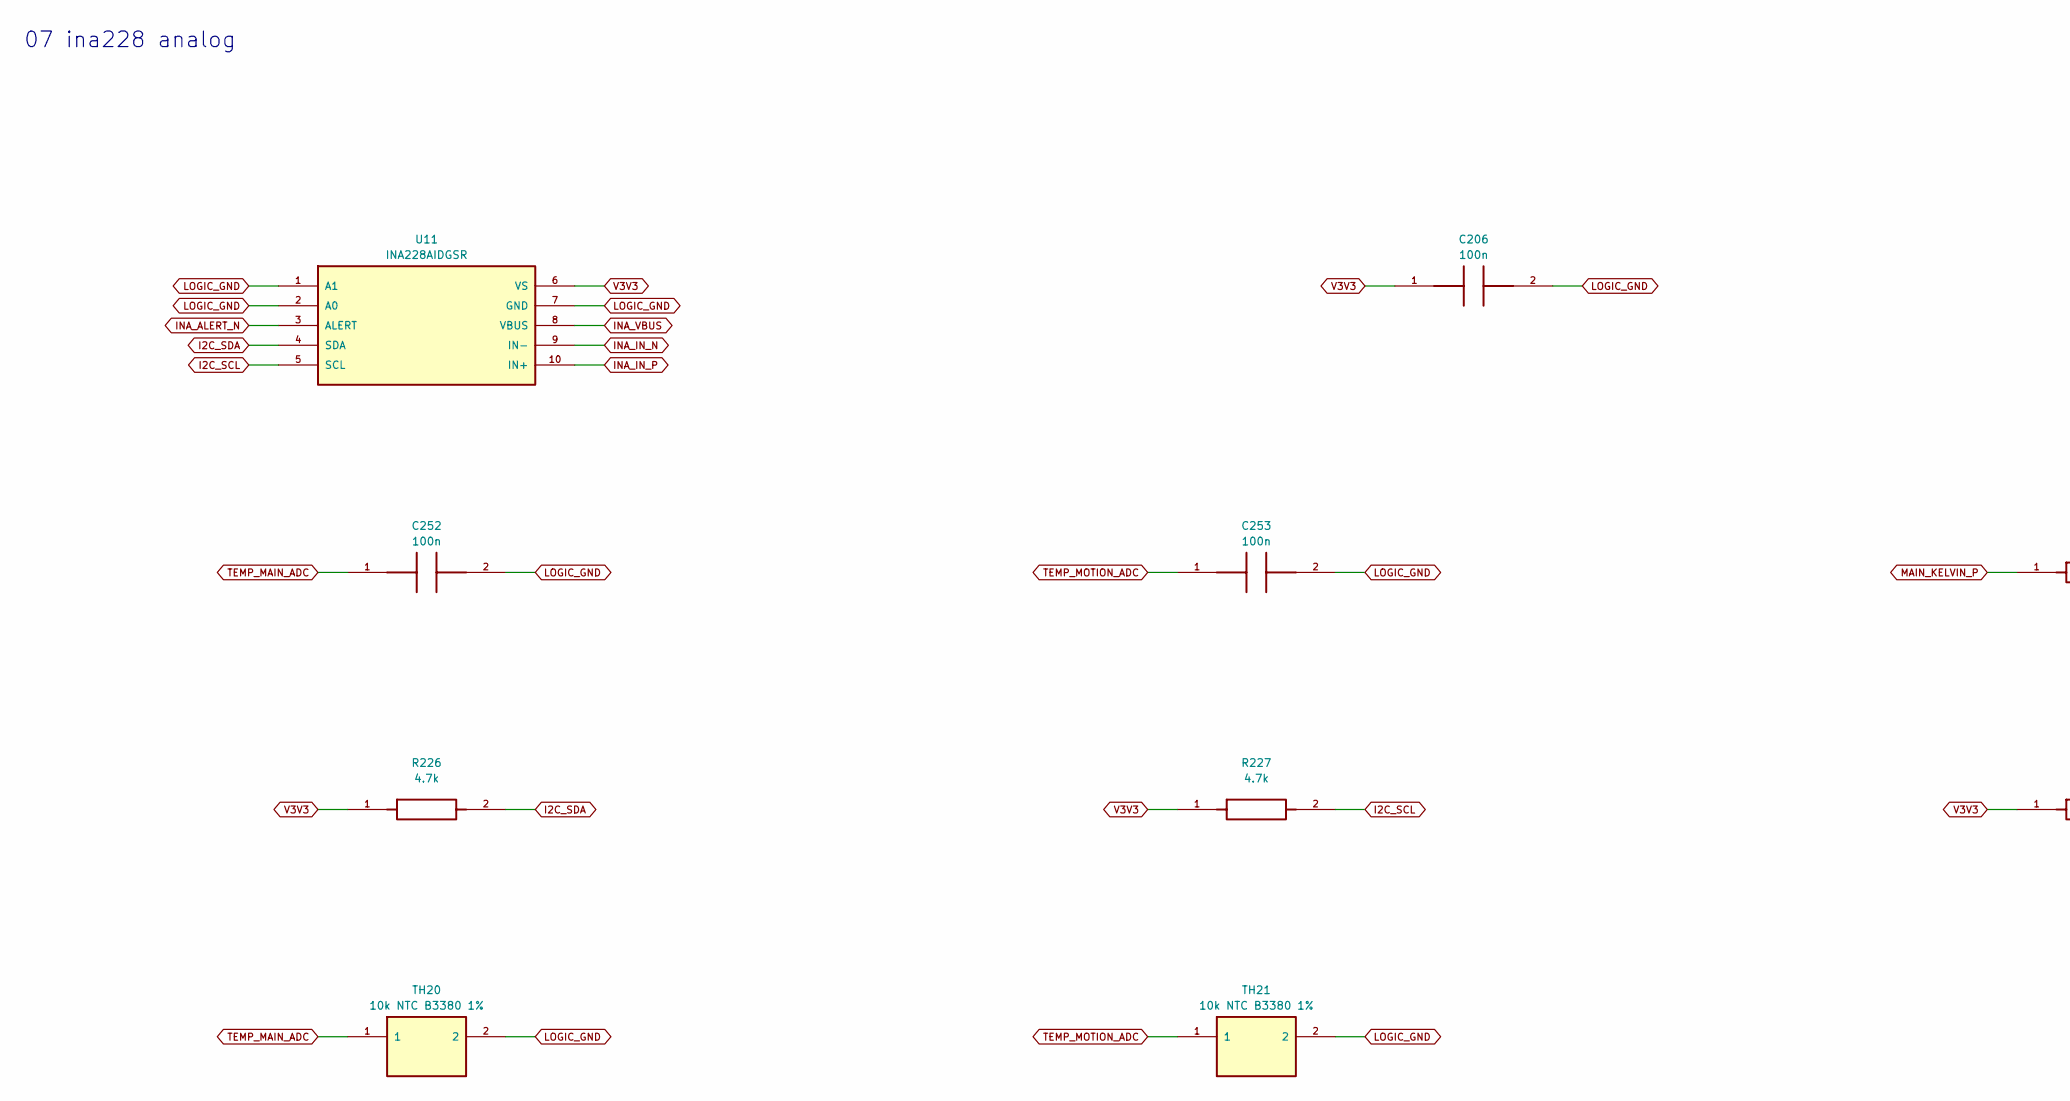
[picture p73: schematic 07_ina228_analog.kicad_sch, PMU A / INA228 and analog, part in row 1, column 1]

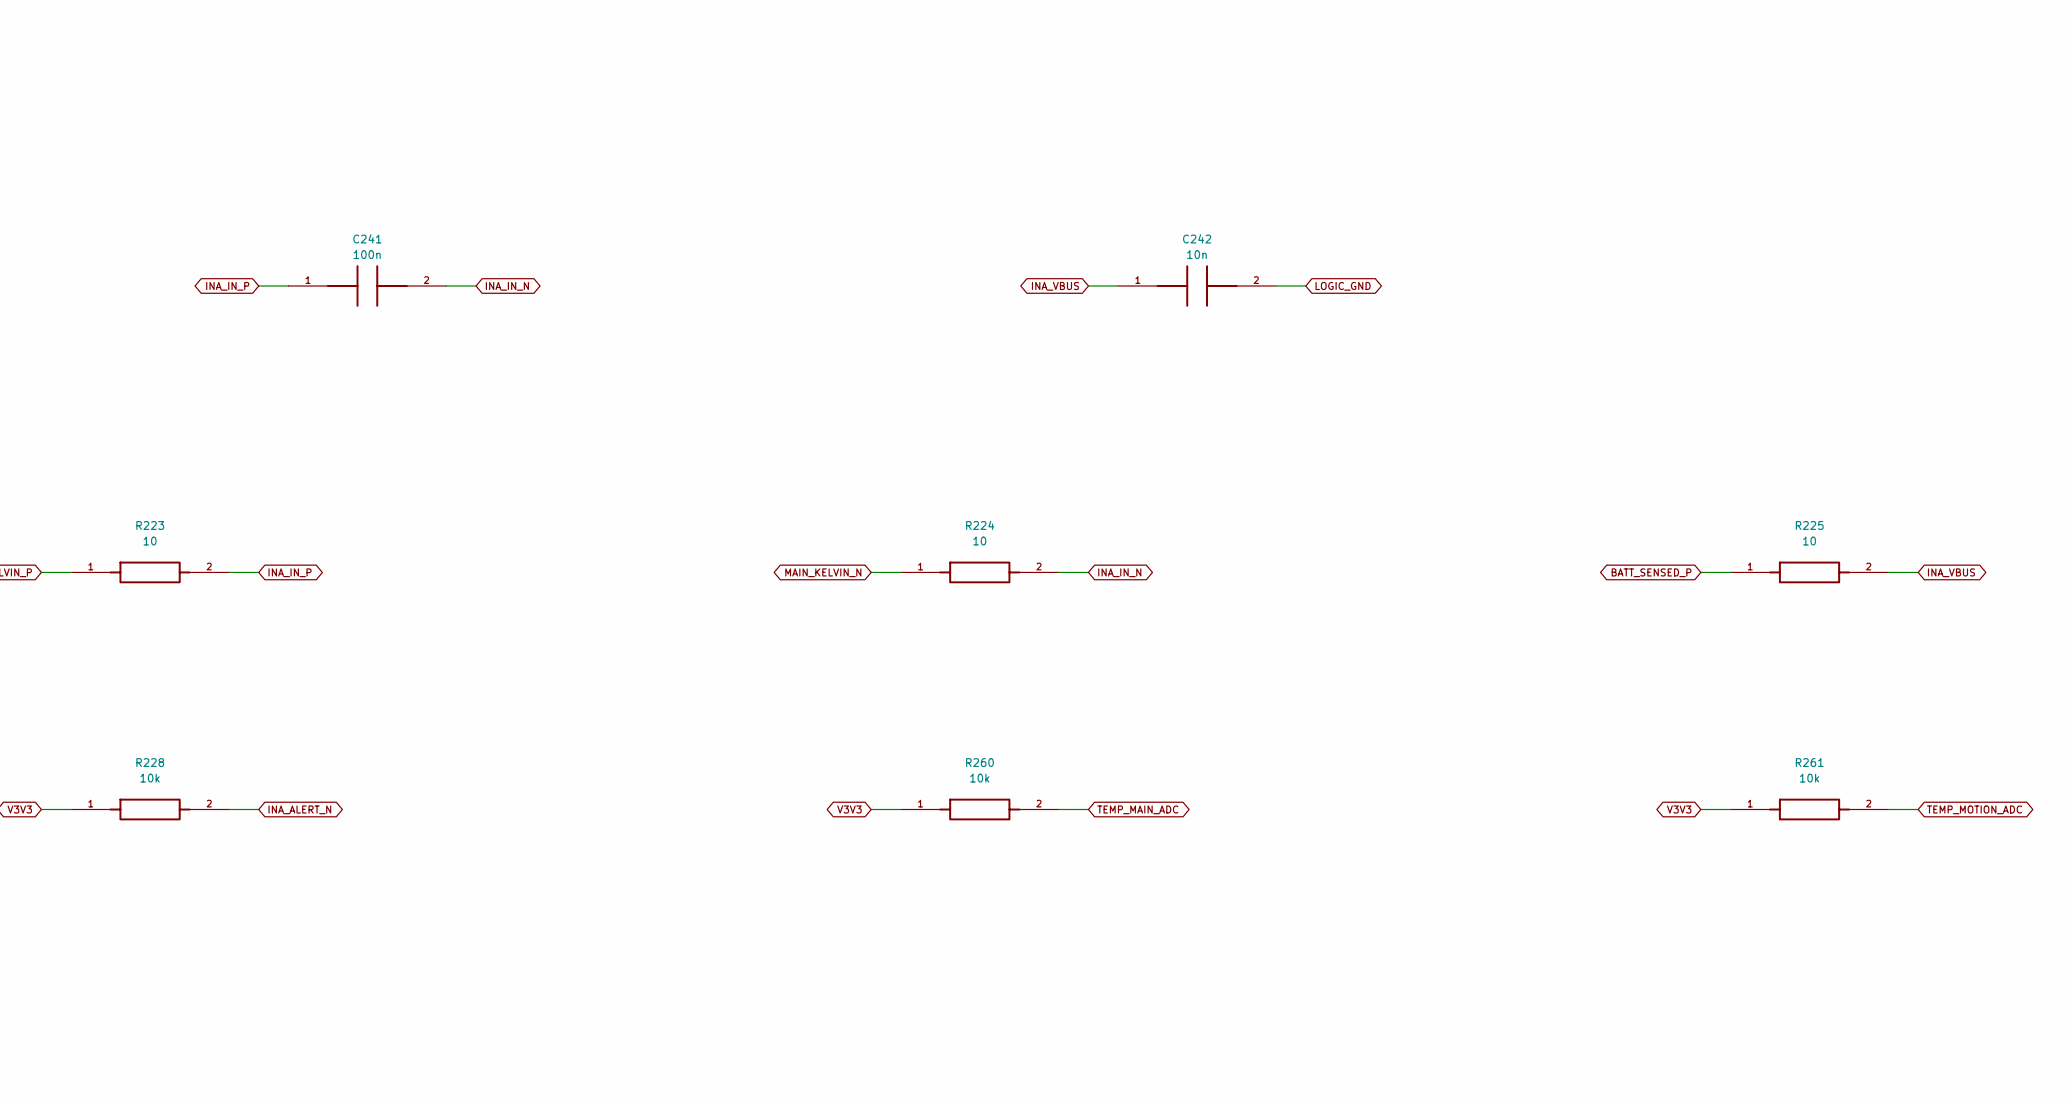
[picture p74: schematic 07_ina228_analog.kicad_sch, PMU A / INA228 and analog, part in row 1, column 2]

Parts:
C206, C252, C253: 100n; C_0805_2012Metric; MPN GRM21BR71C104KA01L
C241: 100n; C_0805_2012Metric; MPN GRM21BR72A104KA01L
C242: 10n; C_0805_2012Metric; MPN GRM21BR72A103KA01L
R223, R224, R225: 10; R_0805_2012Metric; MPN RC0805FR-0710RL
R226, R227: 4.7k; R_0805_2012Metric; MPN RC0805FR-074K7L
R228, R260, R261: 10k; R_0805_2012Metric; MPN RC0805FR-0710KL
TH20, TH21: 10k NTC B3380 1%; R_0603_1608Metric; MPN NCP18XH103F03RB
U11: INA228AIDGSR; MSOP-10_3x3mm_P0.5mm; MPN INA228AIDGSR

Connections:
BATT_SENSED_P: R225.1; also elsewhere on the board
I2C_SCL: R227.2, U11.5 (SCL); also elsewhere on the board
I2C_SDA: R226.2, U11.4 (SDA); also elsewhere on the board
INA_ALERT_N: R228.2, U11.3 (ALERT); also elsewhere on the board
INA_IN_N: C241.2, R224.2, U11.9 (IN-)
INA_IN_P: C241.1, R223.2, U11.10 (IN+)
INA_VBUS: C242.1, R225.2, U11.8 (VBUS)
LOGIC_GND: C206.2, C242.2, C252.2, C253.2, TH20.2, TH21.2, U11.1 (A1), U11.2 (A0), U11.7 (GND); also elsewhere on the board
MAIN_KELVIN_N: R224.1; also elsewhere on the board
MAIN_KELVIN_P: R223.1; also elsewhere on the board
TEMP_MAIN_ADC: C252.1, R260.2, TH20.1; also elsewhere on the board
TEMP_MOTION_ADC: C253.1, R261.2, TH21.1; also elsewhere on the board
V3V3: C206.1, R226.1, R227.1, R228.1, R260.1, R261.1, U11.6 (VS); also elsewhere on the board

Notes on the sheet:
07 ina228 analog
