chris01-byte/HomeMy/hardware/power-management-unit/rev-a2-layout-280x260/kicad/HomeMy_PMU_RevA.kicad_pcb

## KiCad design hardware/power-management-unit/rev-a2-layout-280x260/kicad/HomeMy_PMU_RevA.kicad_pcb (continued)

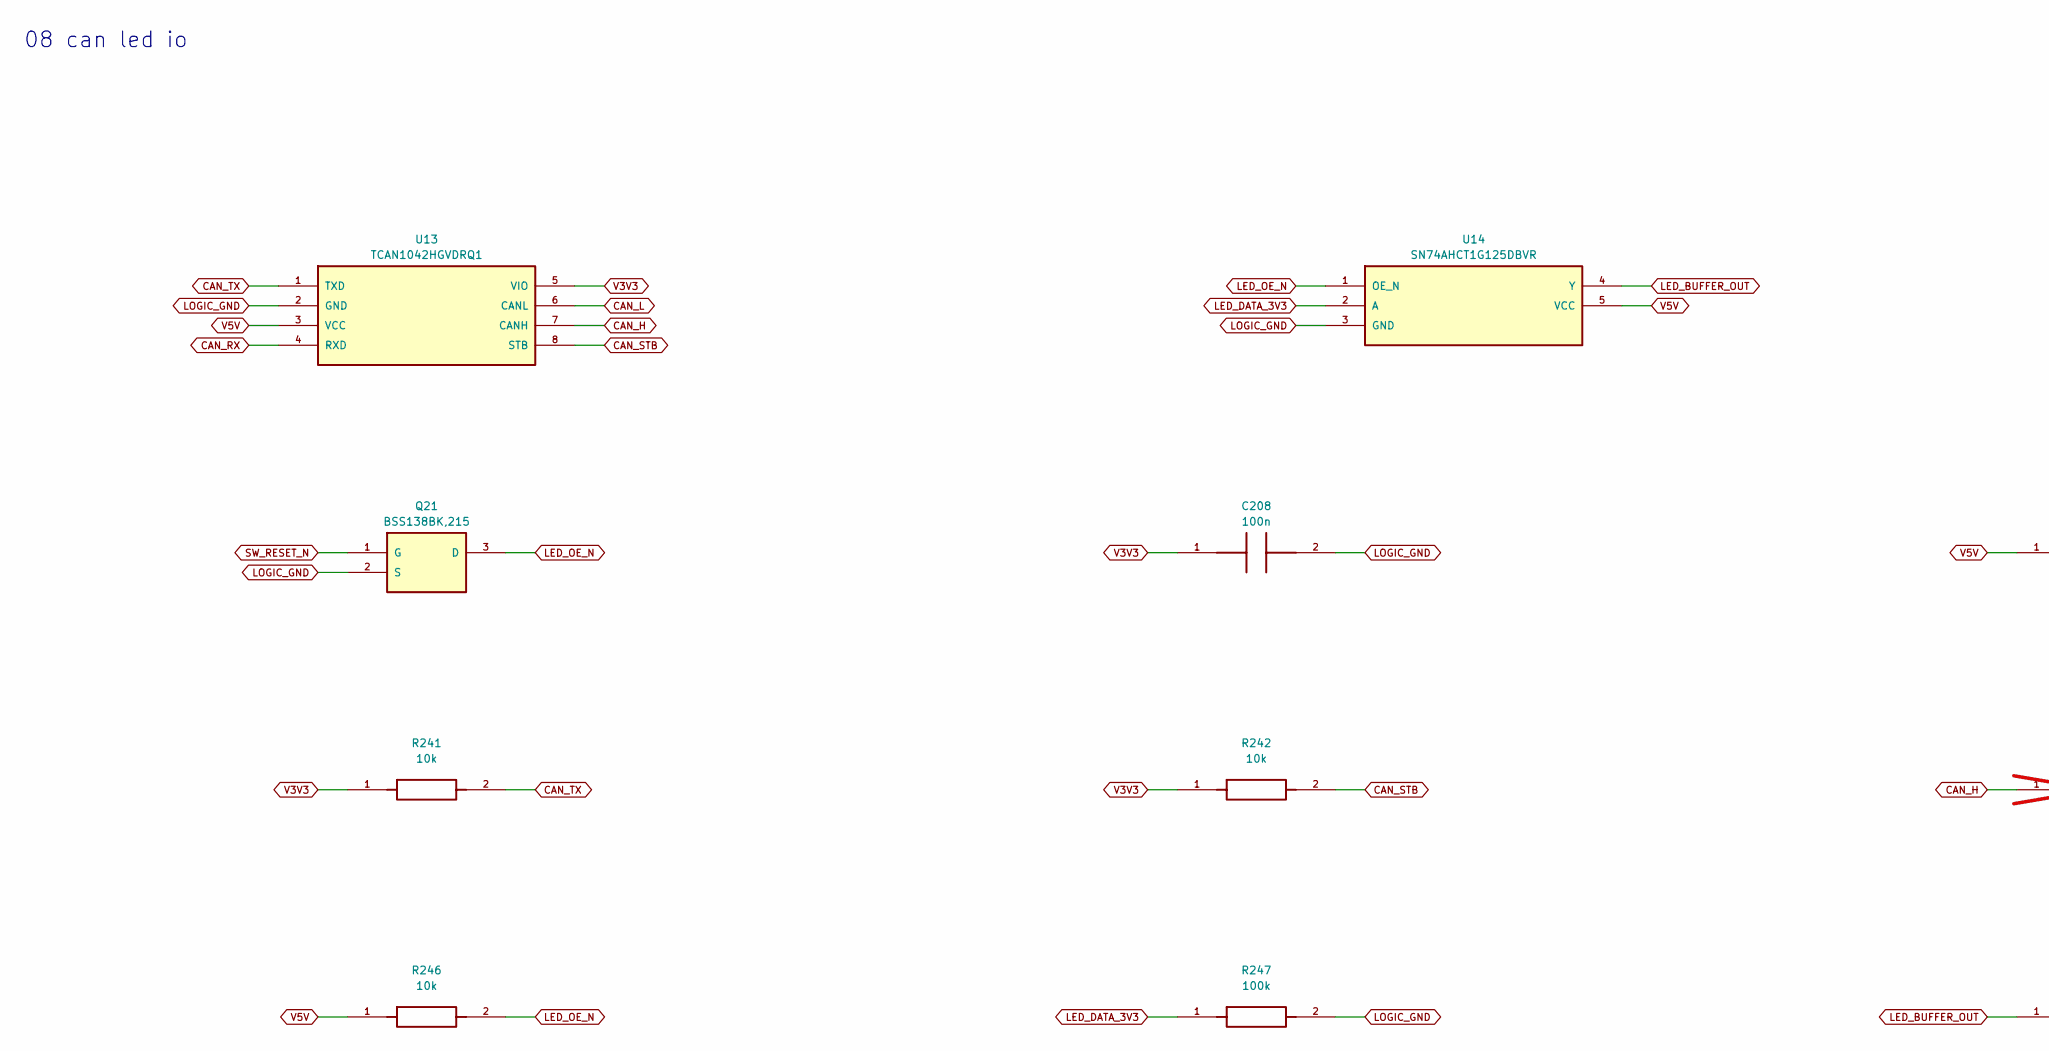
[picture p75: schematic 08_can_led_io.kicad_sch, PMU A / CAN and LED, part in row 1, column 1]

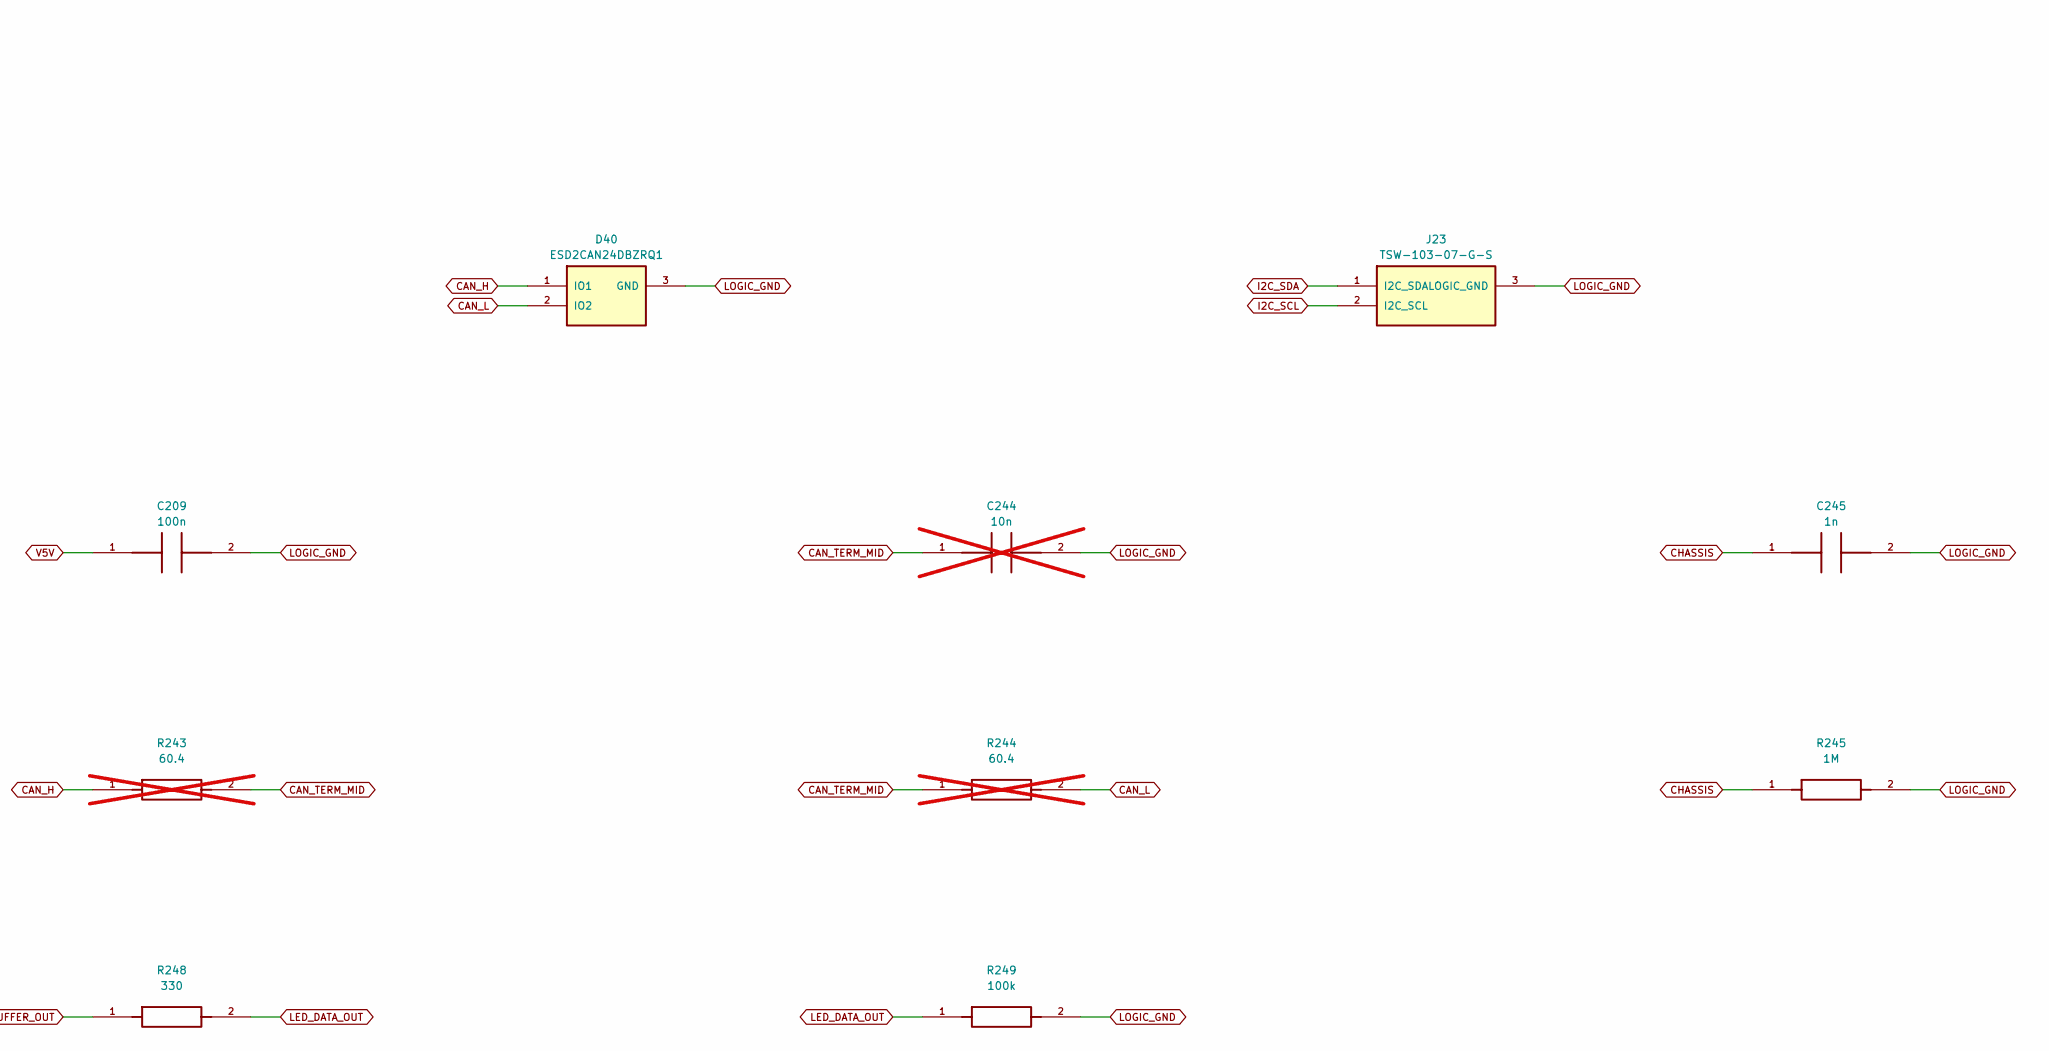
[picture p76: schematic 08_can_led_io.kicad_sch, PMU A / CAN and LED, part in row 1, column 2]

Parts:
C208, C209: 100n; C_0805_2012Metric; MPN GRM21BR71C104KA01L
C244: 10n; C_0805_2012Metric; MPN GRM21BR71H103KA01L; not fitted
C245: 1n; C_1206_3216Metric; MPN GRM31A5C3A102JW01D
D40: ESD2CAN24DBZRQ1; SOT-23; MPN ESD2CAN24DBZRQ1
J23: TSW-103-07-G-S; PinHeader_1x03_P2.54mm_Vertical; MPN TSW-103-07-G-S
Q21: BSS138BK,215; SOT-23; MPN BSS138BK,215
R241, R242, R246: 10k; R_0805_2012Metric; MPN RC0805FR-0710KL
R243, R244: 60.4; R_1206_3216Metric; MPN RC1206FR-0760R4L; not fitted
R245: 1M; R_0805_2012Metric; MPN RC0805FR-071ML
R247, R249: 100k; R_0805_2012Metric; MPN RC0805FR-07100KL
R248: 330; R_0805_2012Metric; MPN RC0805FR-07330RL
U13: TCAN1042HGVDRQ1; SOIC-8_3.9x4.9mm_P1.27mm; MPN TCAN1042HGVDRQ1
U14: SN74AHCT1G125DBVR; SOT-23-5; MPN SN74AHCT1G125DBVR

Connections:
CAN_H: D40.1 (IO1), R243.1, U13.7 (CANH); also elsewhere on the board
CAN_L: D40.2 (IO2), R244.2, U13.6 (CANL); also elsewhere on the board
CAN_RX: U13.4 (RXD); also elsewhere on the board
CAN_STB: R242.2, U13.8 (STB); also elsewhere on the board
CAN_TERM_MID: C244.1, R243.2, R244.1
CAN_TX: R241.2, U13.1 (TXD); also elsewhere on the board
CHASSIS: C245.1, R245.1; also elsewhere on the board
I2C_SCL: J23.2 (I2C_SCL); also elsewhere on the board
I2C_SDA: J23.1 (I2C_SDA); also elsewhere on the board
LED_BUFFER_OUT: R248.1, U14.4 (Y)
LED_DATA_3V3: R247.1, U14.2 (A); also elsewhere on the board
LED_DATA_OUT: R248.2, R249.1; also elsewhere on the board
LED_OE_N: Q21.3 (D), R246.2, U14.1 (OE_N)
LOGIC_GND: C208.2, C209.2, C244.2, C245.2, D40.3 (GND), J23.3 (LOGIC_GND), Q21.2 (S), R245.2, R247.2, R249.2, U13.2 (GND), U14.3 (GND); also elsewhere on the board
SW_RESET_N: Q21.1 (G); also elsewhere on the board
V3V3: C208.1, R241.1, R242.1, U13.5 (VIO); also elsewhere on the board
V5V: C209.1, R246.1, U13.3 (VCC), U14.5 (VCC); also elsewhere on the board

Notes on the sheet:
08 can led io

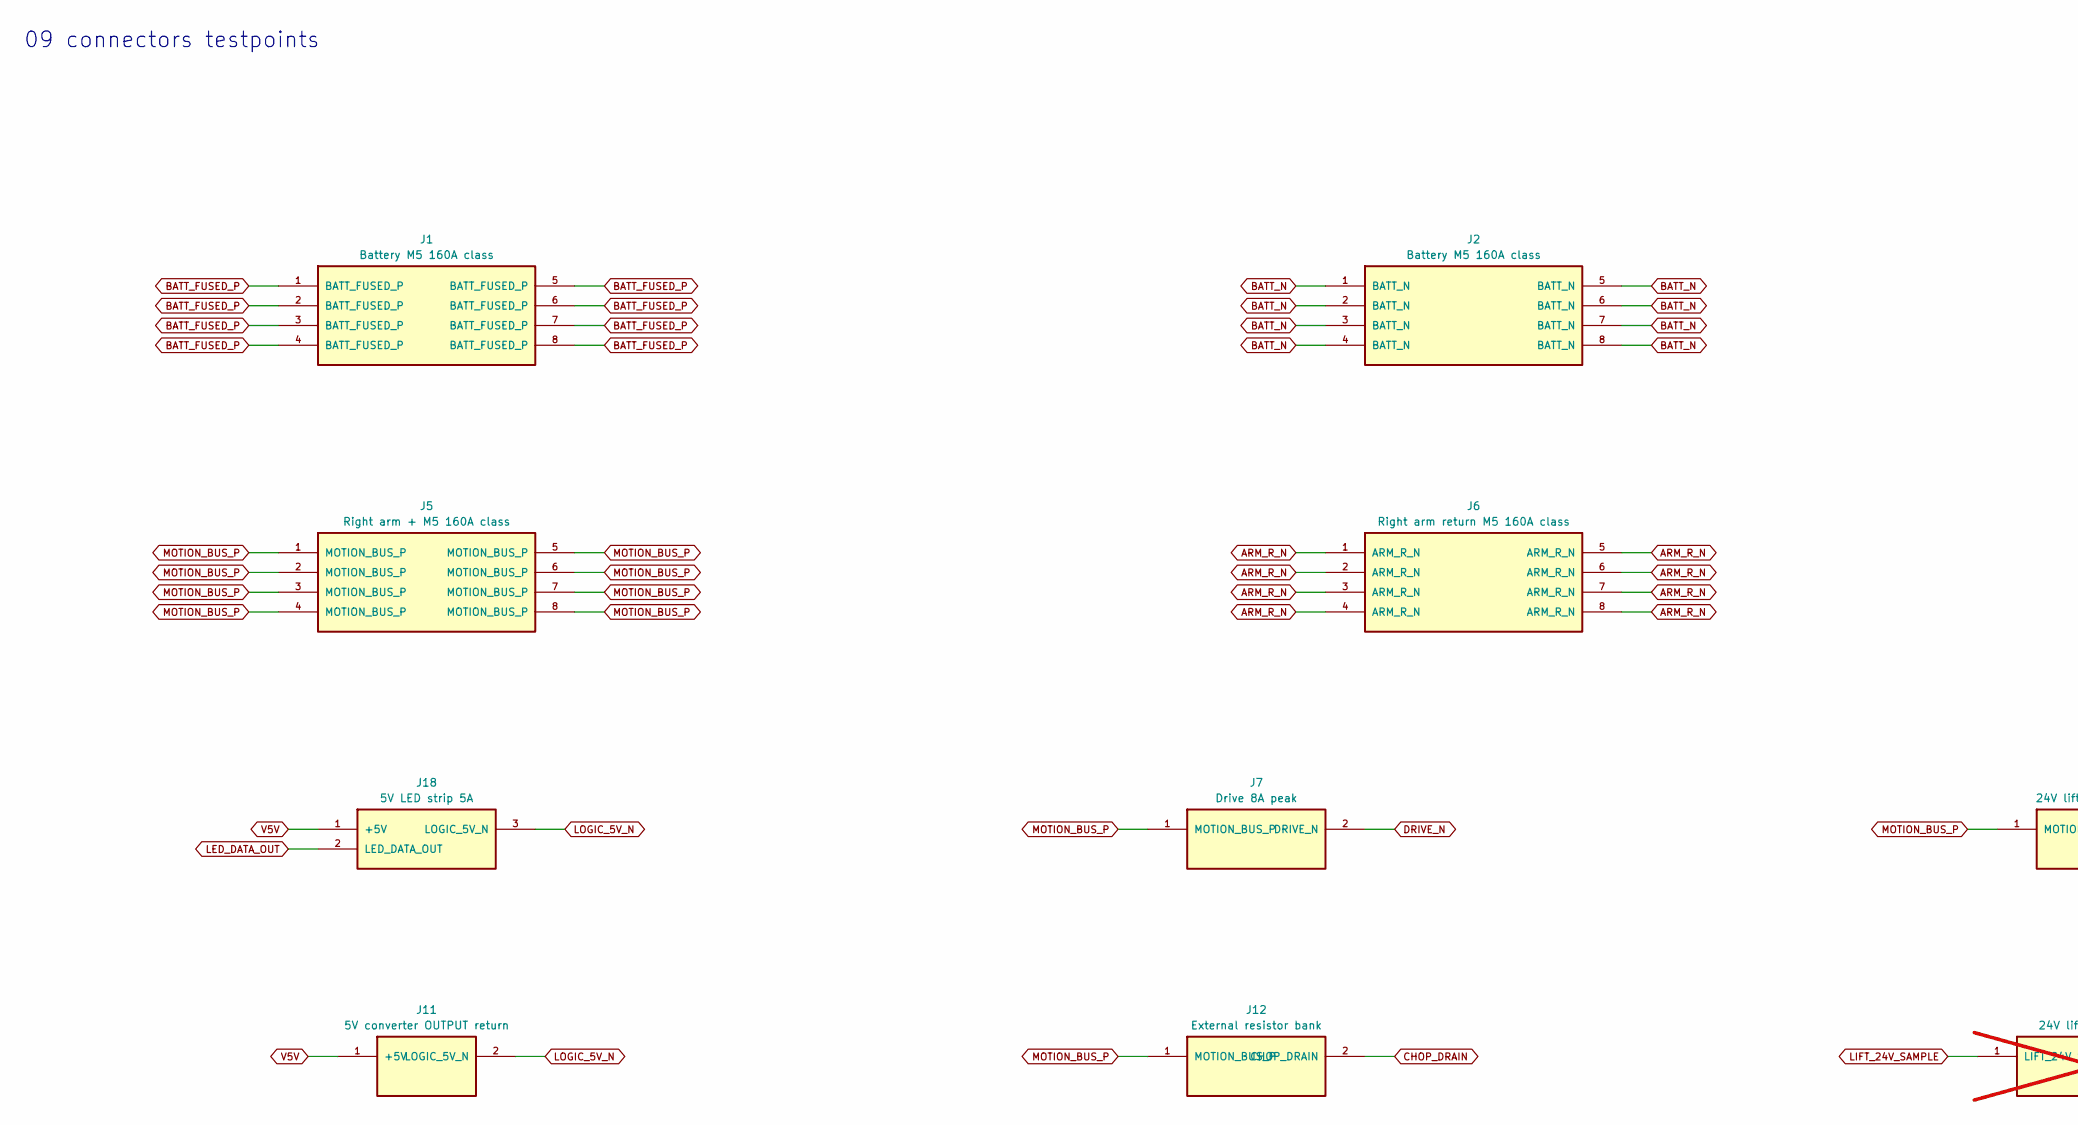
[picture p77: schematic 09_connectors_testpoints.kicad_sch, PMU A / Connectors, part in row 1, column 1]

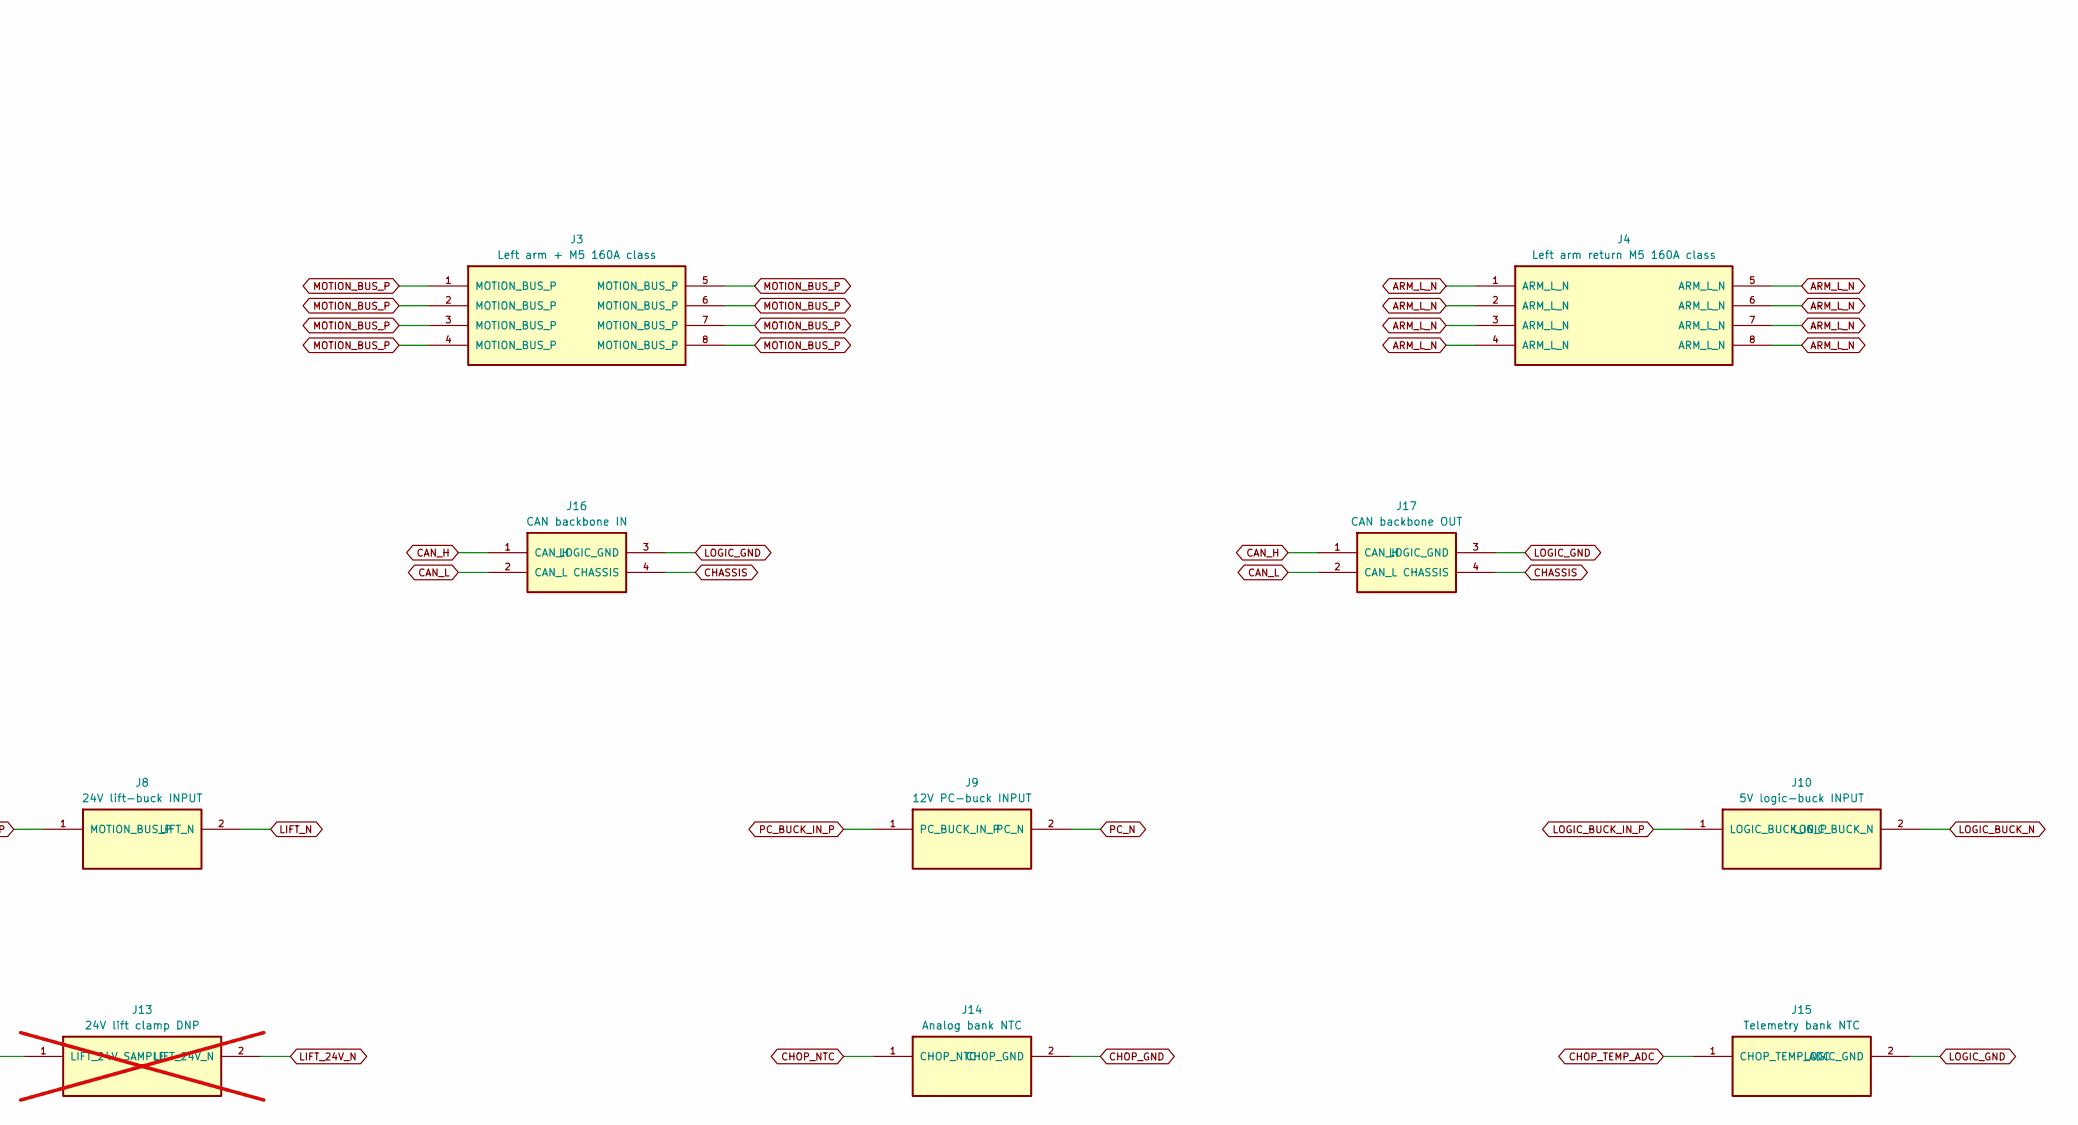
[picture p78: schematic 09_connectors_testpoints.kicad_sch, PMU A / Connectors, part in row 1, column 2]

Parts:
J1, J2: Battery M5 160A class; Wurth_7461103; MPN 7461103
J3: Left arm + M5 160A class; Wurth_7461103; MPN 7461103
J4: Left arm return M5 160A class; Wurth_7461103; MPN 7461103
J5: Right arm + M5 160A class; Wurth_7461103; MPN 7461103
J6: Right arm return M5 160A class; Wurth_7461103; MPN 7461103
J7: Drive 8A peak; PhoenixContact_MSTB_2,5_2-GF-5,08_1x02_P5.08mm_Horizontal_T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; MPN 1776508
J8: 24V lift-buck INPUT; PhoenixContact_MSTB_2,5_2-GF-5,08_1x02_P5.08mm_Horizontal_T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; MPN 1776508
J9: 12V PC-buck INPUT; PhoenixContact_MSTB_2,5_2-GF-5,08_1x02_P5.08mm_Horizontal_T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; MPN 1776508
J10: 5V logic-buck INPUT; PhoenixContact_MSTB_2,5_2-GF-5,08_1x02_P5.08mm_Horizontal_T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; MPN 1776508
J11: 5V converter OUTPUT return; PhoenixContact_MSTB_2,5_2-GF-5,08_1x02_P5.08mm_Horizontal_T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; MPN 1776508
J12: External resistor bank; PhoenixContact_MSTB_2,5_2-GF-5,08_1x02_P5.08mm_Horizontal_T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; MPN 1776508
J13: 24V lift clamp DNP; PhoenixContact_MSTB_2,5_2-GF-5,08_1x02_P5.08mm_Horizontal_T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; MPN 1776508; not fitted
J14: Analog bank NTC; PhoenixContact_MSTB_2,5_2-GF-5,08_1x02_P5.08mm_Horizontal_T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; MPN 1776508
J15: Telemetry bank NTC; PhoenixContact_MSTB_2,5_2-GF-5,08_1x02_P5.08mm_Horizontal_T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; MPN 1776508
J16: CAN backbone IN; JST_GH_BM04B-GHS-TBT_1x04-1MP_P1.25mm_Vertical; MPN BM04B-GHS-TBT(LF)(SN)
J17: CAN backbone OUT; JST_GH_BM04B-GHS-TBT_1x04-1MP_P1.25mm_Vertical; MPN BM04B-GHS-TBT(LF)(SN)
J18: 5V LED strip 5A; PhoenixContact_MSTB_2,5_3-GF-5,08_1x03_P5.08mm_Horizontal_T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; MPN 1776511

Connections:
ARM_L_N: J4.1, J4.2, J4.3, J4.4, J4.5, J4.6, J4.7, J4.8; also elsewhere on the board
ARM_R_N: J6.1, J6.2, J6.3, J6.4, J6.5, J6.6, J6.7, J6.8; also elsewhere on the board
BATT_FUSED_P: J1.1, J1.2, J1.3, J1.4, J1.5, J1.6, J1.7, J1.8; also elsewhere on the board
BATT_N: J2.1, J2.2, J2.3, J2.4, J2.5, J2.6, J2.7, J2.8; also elsewhere on the board
CAN_H: J16.1 (CAN_H), J17.1 (CAN_H); also elsewhere on the board
CAN_L: J16.2 (CAN_L), J17.2 (CAN_L); also elsewhere on the board
CHASSIS: J16.4 (CHASSIS), J17.4 (CHASSIS); also elsewhere on the board
CHOP_DRAIN: J12.2 (CHOP_DRAIN); also elsewhere on the board
CHOP_GND: J14.2 (CHOP_GND); also elsewhere on the board
CHOP_NTC: J14.1 (CHOP_NTC); also elsewhere on the board
CHOP_TEMP_ADC: J15.1 (CHOP_TEMP_ADC); also elsewhere on the board
DRIVE_N: J7.2 (DRIVE_N); also elsewhere on the board
LED_DATA_OUT: J18.2 (LED_DATA_OUT); also elsewhere on the board
LIFT_24V_N: J13.2 (LIFT_24V_N); also elsewhere on the board
LIFT_24V_SAMPLE: J13.1 (LIFT_24V_SAMPLE); also elsewhere on the board
LIFT_N: J8.2 (LIFT_N); also elsewhere on the board
LOGIC_5V_N: J11.2 (LOGIC_5V_N), J18.3 (LOGIC_5V_N); also elsewhere on the board
LOGIC_BUCK_IN_P: J10.1 (LOGIC_BUCK_IN_P); also elsewhere on the board
LOGIC_BUCK_N: J10.2 (LOGIC_BUCK_N); also elsewhere on the board
LOGIC_GND: J15.2 (LOGIC_GND), J16.3 (LOGIC_GND), J17.3 (LOGIC_GND); also elsewhere on the board
MOTION_BUS_P: J3.1, J3.2, J3.3, J3.4, J3.5, J3.6, J3.7, J3.8, J5.1, J5.2, J5.3, J5.4, J5.5, J5.6, J5.7, J5.8, J7.1 (MOTION_BUS_P), J8.1 (MOTION_BUS_P), J12.1 (MOTION_BUS_P); also elsewhere on the board
PC_BUCK_IN_P: J9.1 (PC_BUCK_IN_P); also elsewhere on the board
PC_N: J9.2 (PC_N); also elsewhere on the board
V5V: J11.1 (+5V), J18.1 (+5V); also elsewhere on the board

Notes on the sheet:
09 connectors testpoints

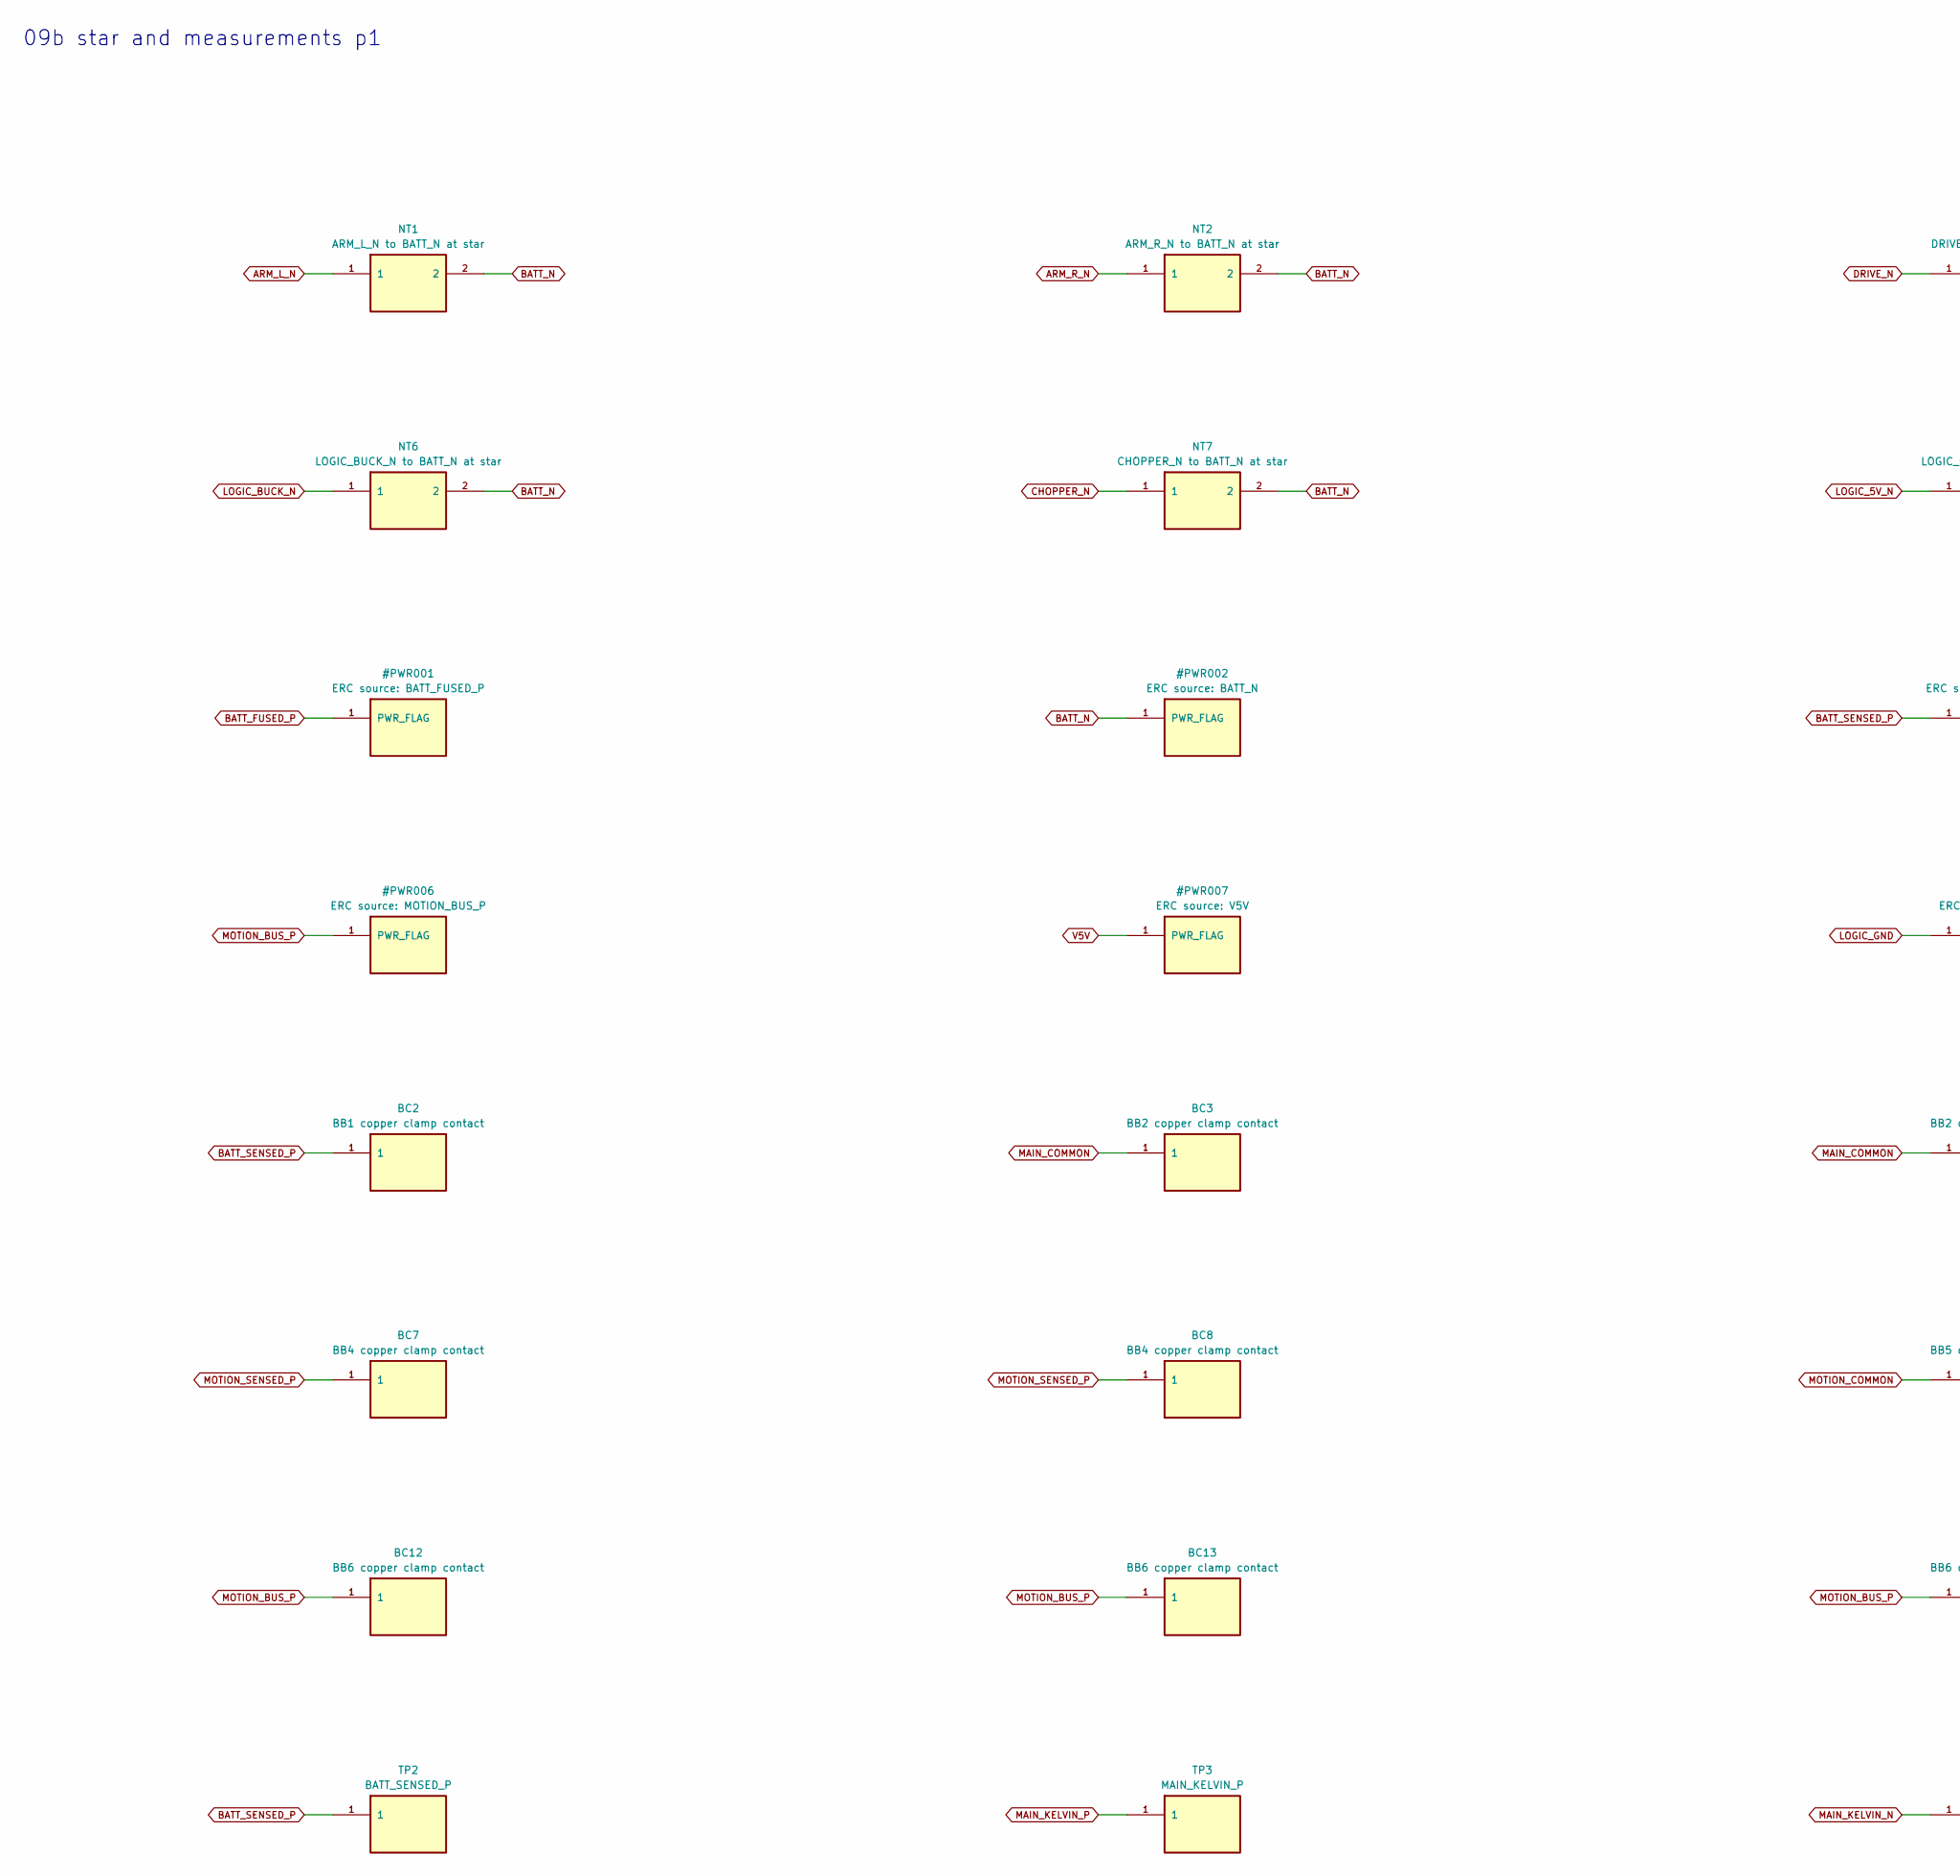
[picture p79: schematic 09b_star_and_measurements_p1.kicad_sch, PMU A / Star and test points / 1, part in row 1, column 1]

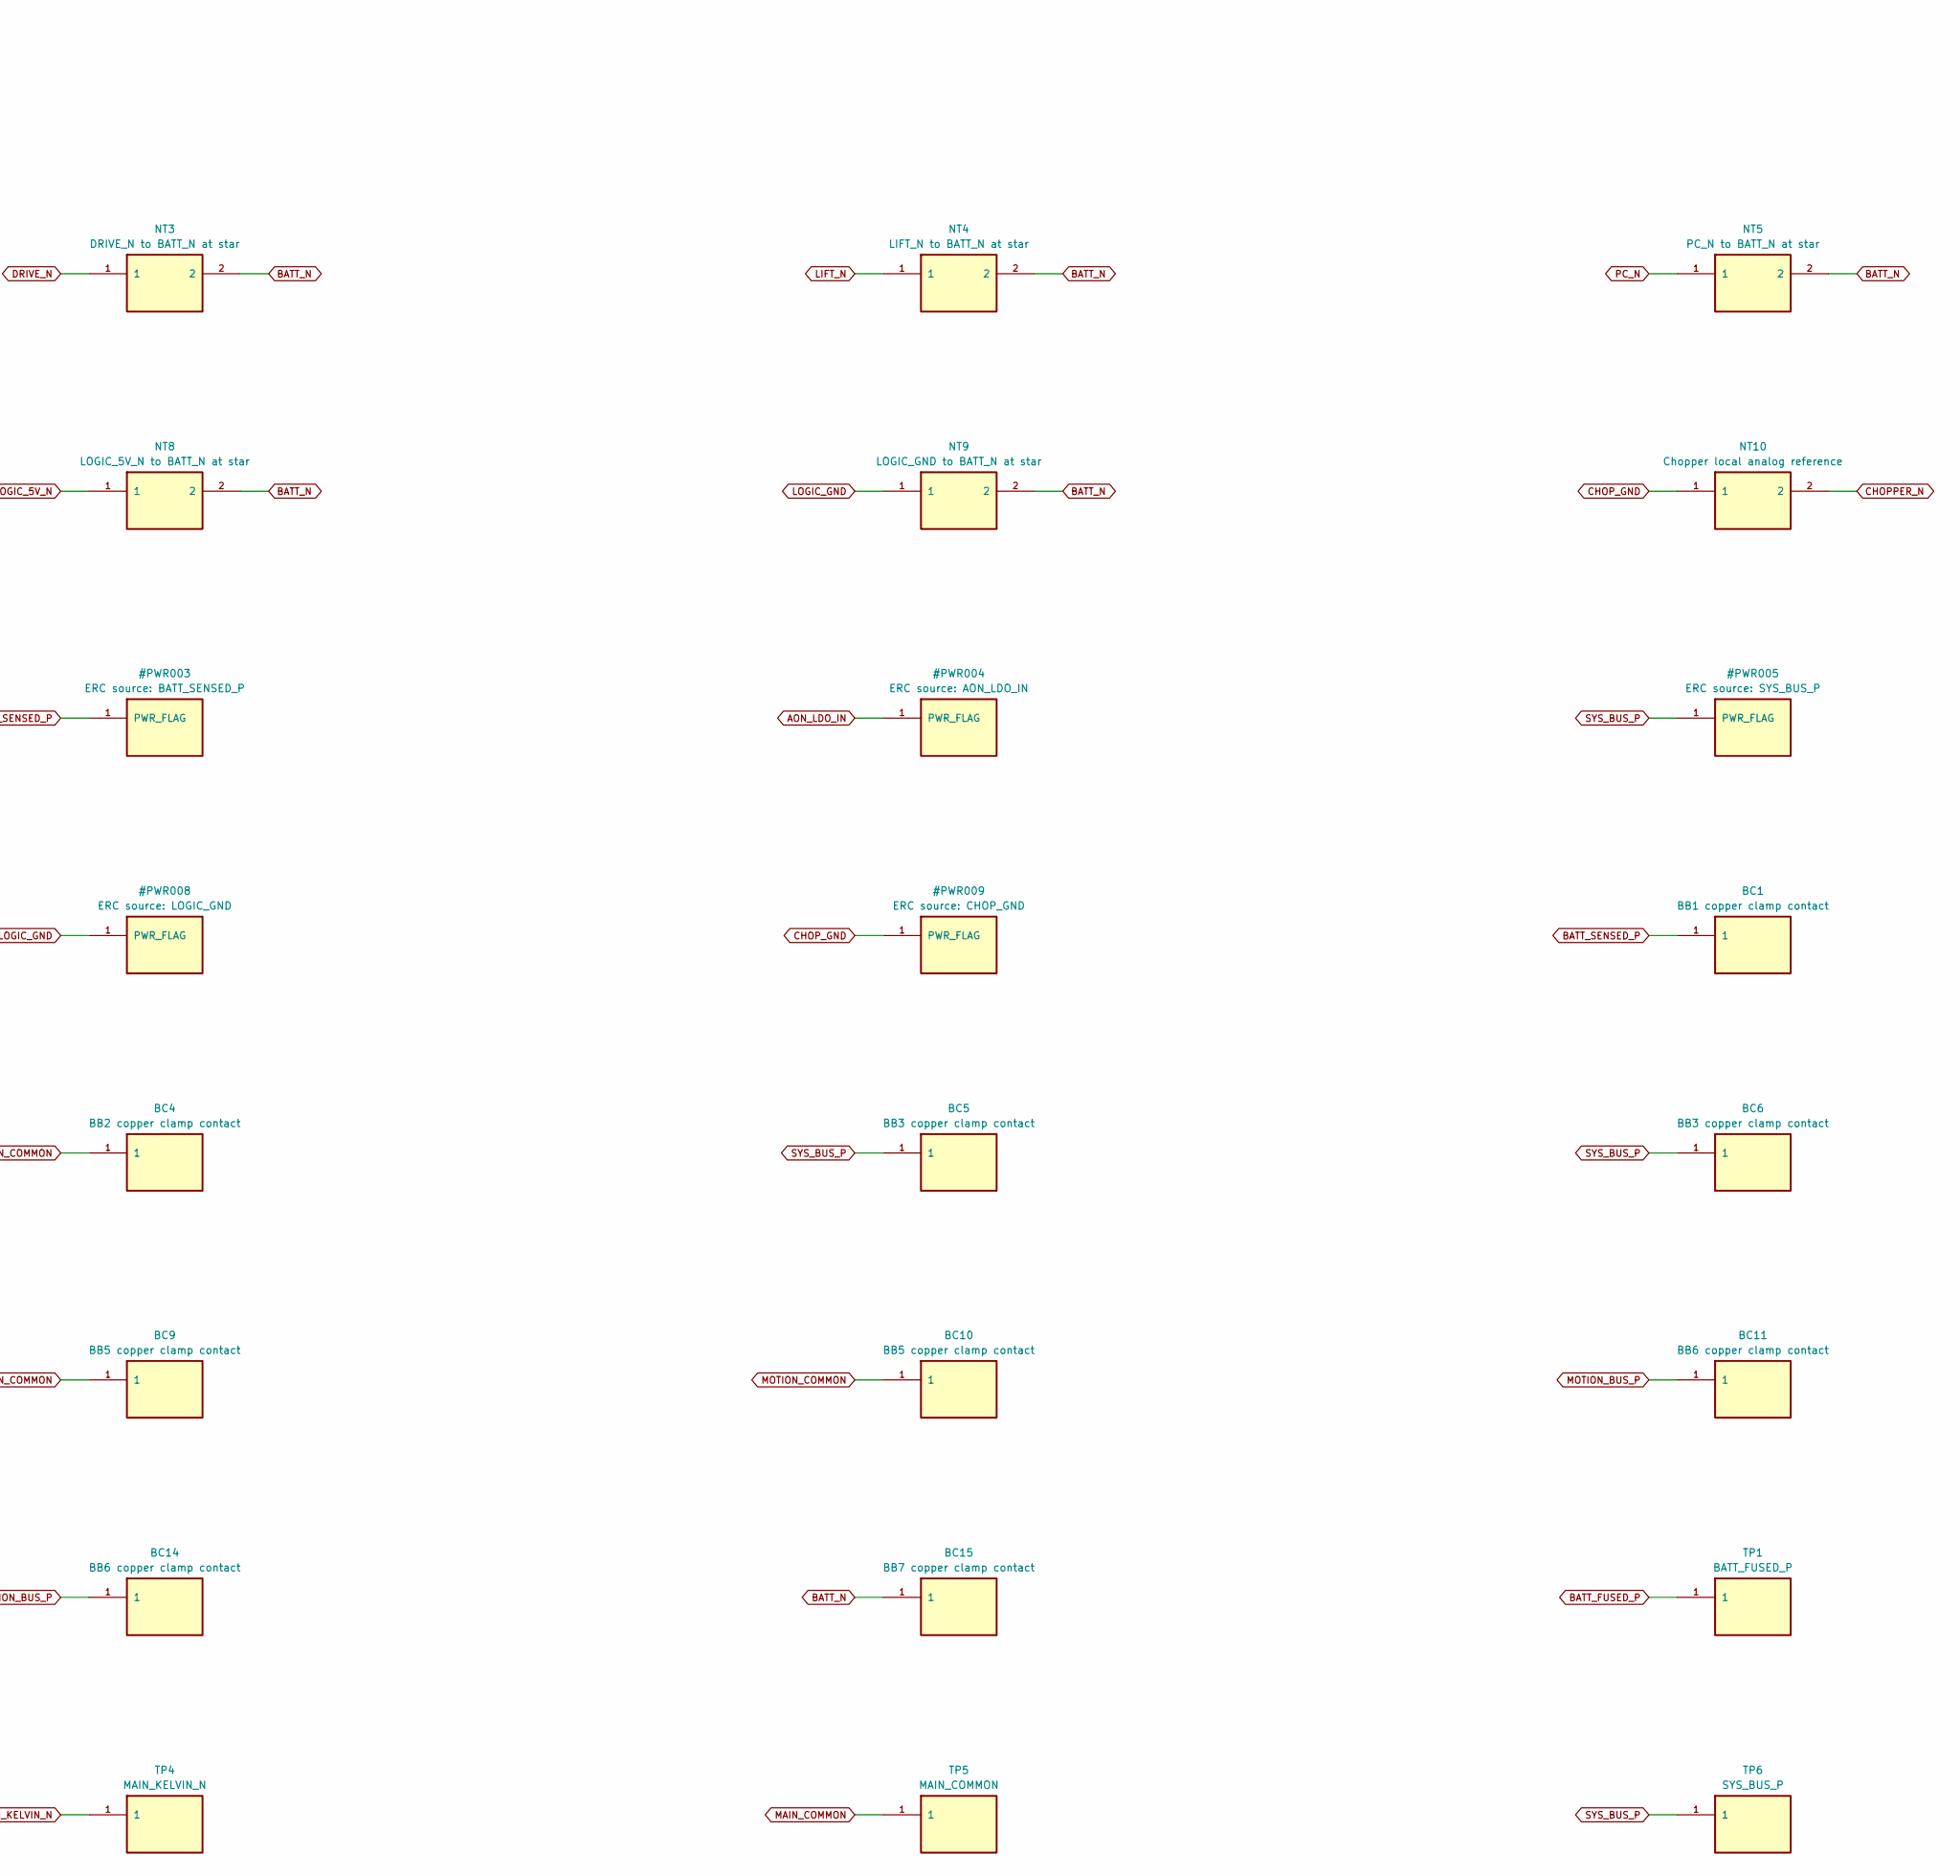
[picture p80: schematic 09b_star_and_measurements_p1.kicad_sch, PMU A / Star and test points / 1, part in row 1, column 2]

Parts:
BC1, BC2: BB1 copper clamp contact; Busbar_Contact_M3_D8
BC3, BC4: BB2 copper clamp contact; Busbar_Contact_M3_D8
BC5, BC6: BB3 copper clamp contact; Busbar_Contact_M3_D8
BC7, BC8: BB4 copper clamp contact; Busbar_Contact_M3_D8
BC9, BC10: BB5 copper clamp contact; Busbar_Contact_M3_D8
BC11, BC12, BC13, BC14: BB6 copper clamp contact; Busbar_Contact_M3_D8
BC15: BB7 copper clamp contact; Busbar_Contact_M3_D8
NT1: ARM_L_N to BATT_N at star; NetTie_Power_2
NT2: ARM_R_N to BATT_N at star; NetTie_Power_2
NT3: DRIVE_N to BATT_N at star; NetTie_Power_2
NT4: LIFT_N to BATT_N at star; NetTie_Power_2
NT5: PC_N to BATT_N at star; NetTie_Power_2
NT6: LOGIC_BUCK_N to BATT_N at star; NetTie_Power_2
NT7: CHOPPER_N to BATT_N at star; NetTie_Power_2
NT8: LOGIC_5V_N to BATT_N at star; NetTie_Power_2
NT9: LOGIC_GND to BATT_N at star; NetTie_Logic_2
NT10: Chopper local analog reference; NetTie_Logic_2
TP1: BATT_FUSED_P; TestPoint_Pad_D2.0mm
TP2: BATT_SENSED_P; TestPoint_Pad_D2.0mm
TP3: MAIN_KELVIN_P; TestPoint_Pad_D2.0mm
TP4: MAIN_KELVIN_N; TestPoint_Pad_D2.0mm
TP5: MAIN_COMMON; TestPoint_Pad_D2.0mm
TP6: SYS_BUS_P; TestPoint_Pad_D2.0mm

Connections:
ARM_L_N: NT1.1; also elsewhere on the board
ARM_R_N: NT2.1; also elsewhere on the board
BATT_FUSED_P: TP1.1; also elsewhere on the board
BATT_N: BC15.1, NT1.2, NT2.2, NT3.2, NT4.2, NT5.2, NT6.2, NT7.2, NT8.2, NT9.2; also elsewhere on the board
BATT_SENSED_P: BC1.1, BC2.1, TP2.1; also elsewhere on the board
CHOPPER_N: NT7.1, NT10.2; also elsewhere on the board
CHOP_GND: NT10.1; also elsewhere on the board
DRIVE_N: NT3.1; also elsewhere on the board
LIFT_N: NT4.1; also elsewhere on the board
LOGIC_5V_N: NT8.1; also elsewhere on the board
LOGIC_BUCK_N: NT6.1; also elsewhere on the board
LOGIC_GND: NT9.1; also elsewhere on the board
MAIN_COMMON: BC3.1, BC4.1, TP5.1; also elsewhere on the board
MAIN_KELVIN_N: TP4.1; also elsewhere on the board
MAIN_KELVIN_P: TP3.1; also elsewhere on the board
MOTION_BUS_P: BC11.1, BC12.1, BC13.1, BC14.1; also elsewhere on the board
MOTION_COMMON: BC9.1, BC10.1; also elsewhere on the board
MOTION_SENSED_P: BC7.1, BC8.1; also elsewhere on the board
PC_N: NT5.1; also elsewhere on the board
SYS_BUS_P: BC5.1, BC6.1, TP6.1; also elsewhere on the board

Notes on the sheet:
09b star and measurements p1
