chris01-byte/HomeMy/hardware/power-management-unit/rev-a2-layout-280x260/kicad/HomeMy_PMU_RevA.kicad_pcb

## KiCad design hardware/power-management-unit/rev-a2-layout-280x260/kicad/HomeMy_PMU_RevA.kicad_pcb (continued)

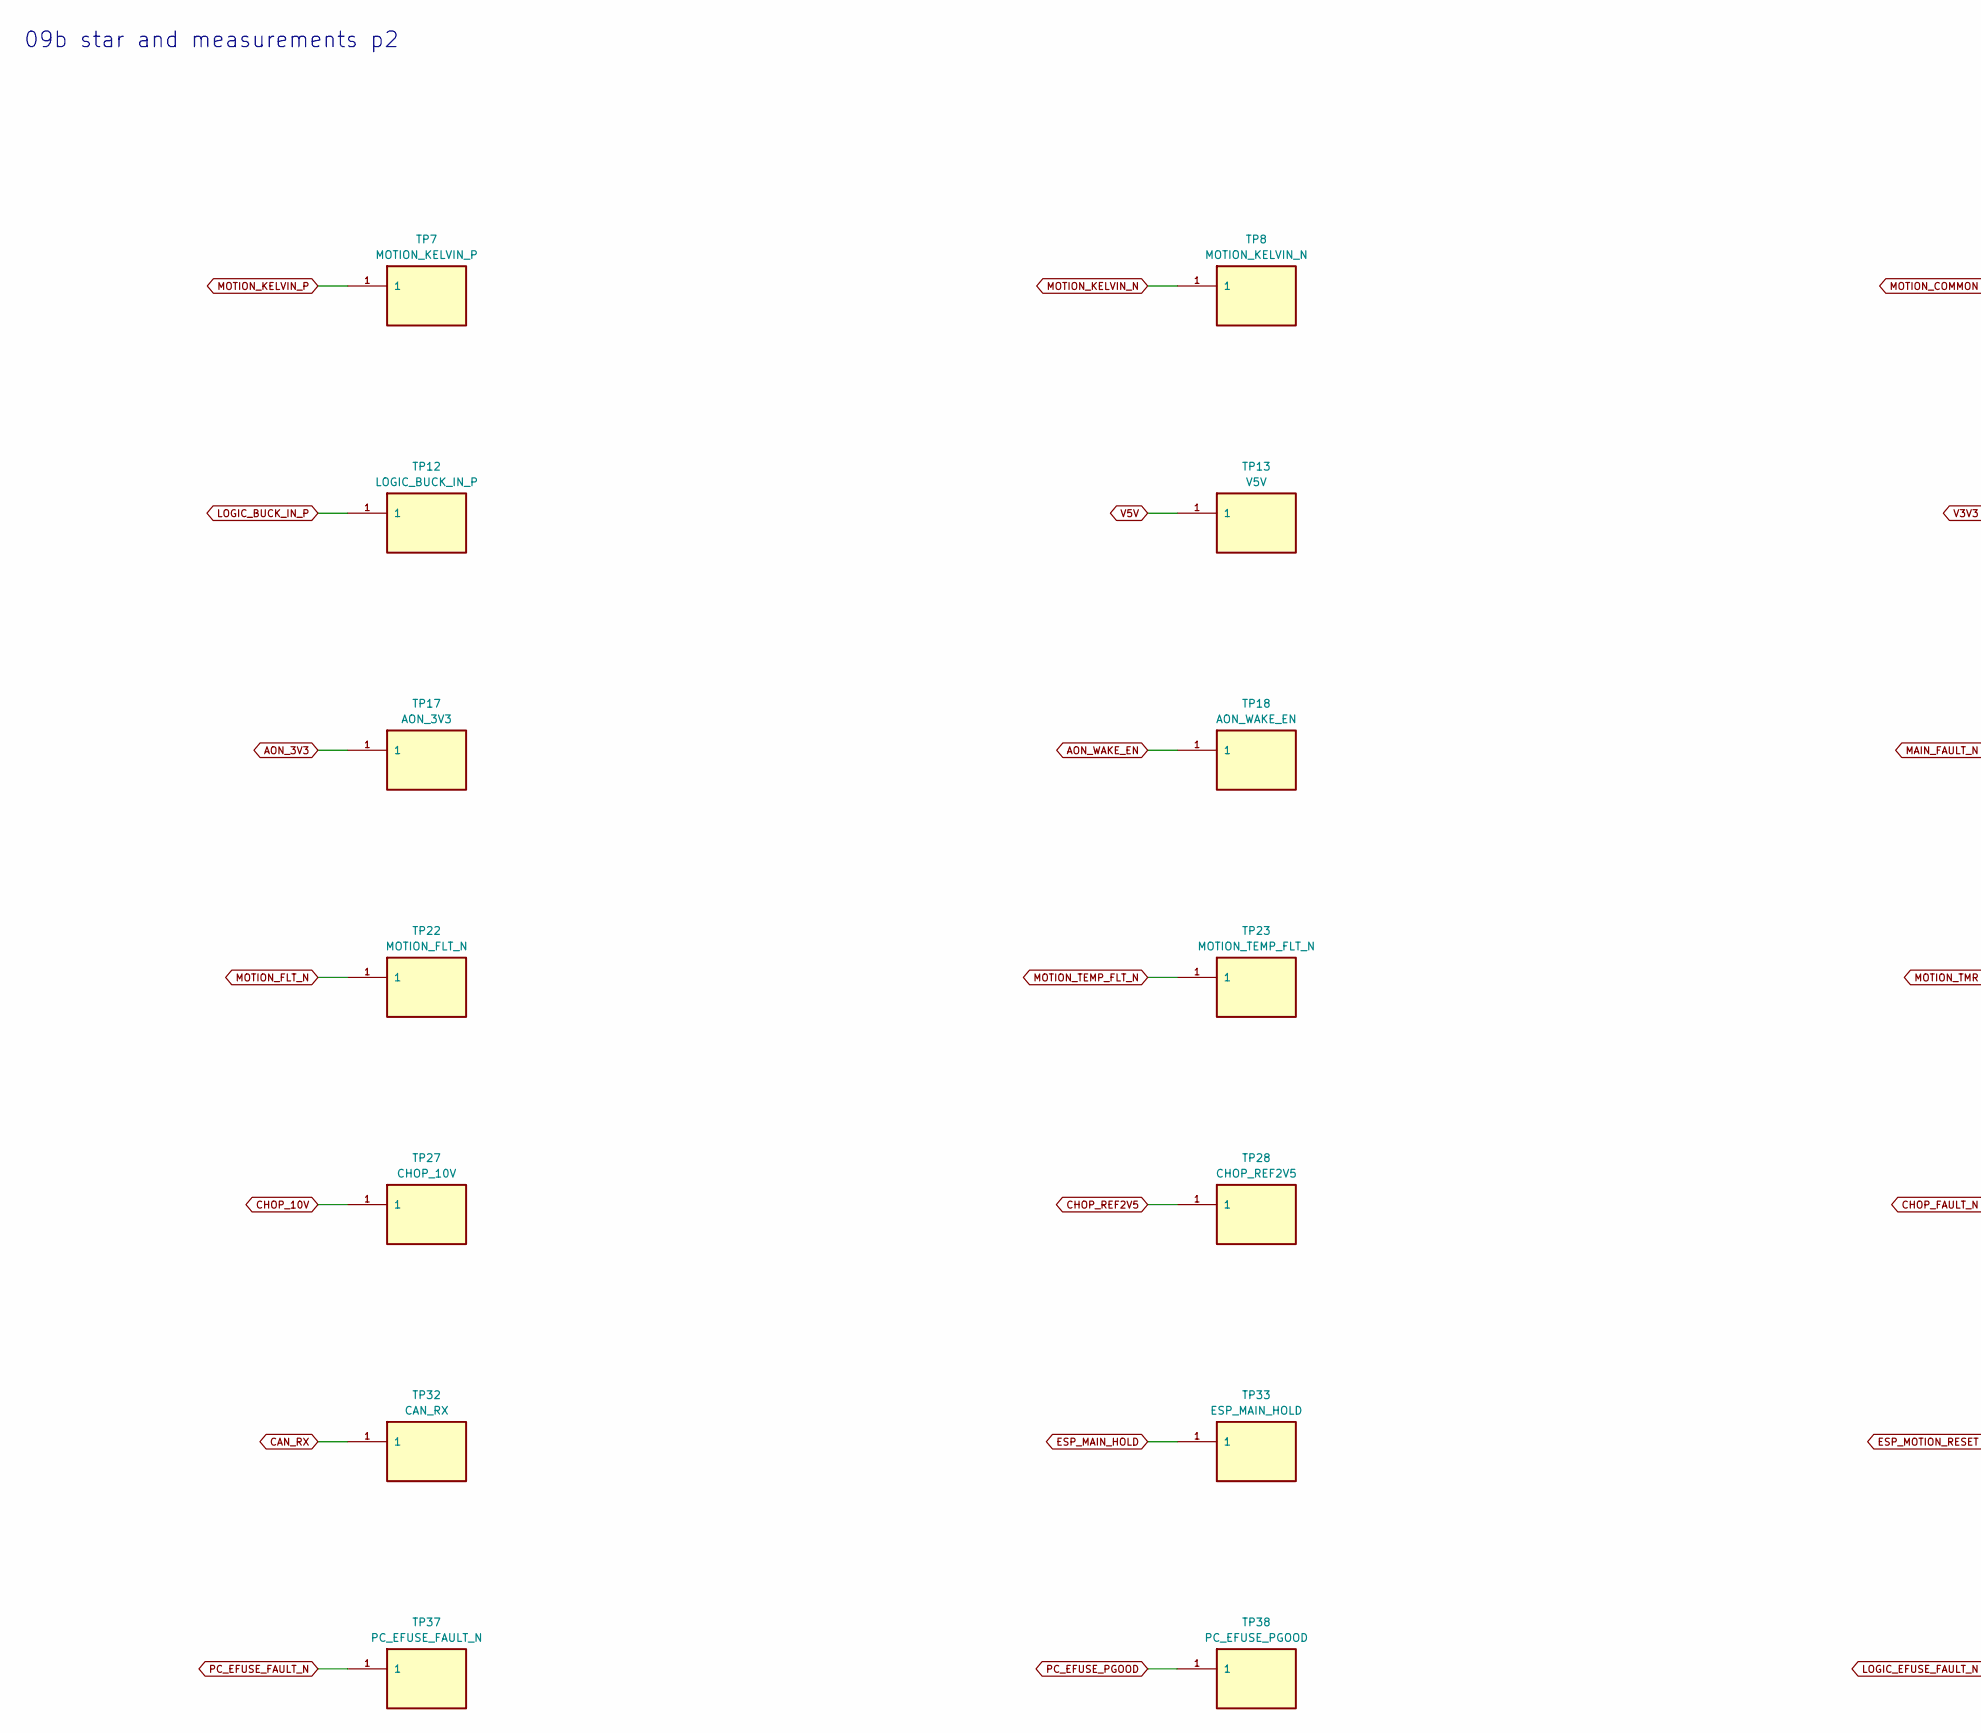
[picture p81: schematic 09b_star_and_measurements_p2.kicad_sch, PMU A / Star and test points / 2, part in row 1, column 1]

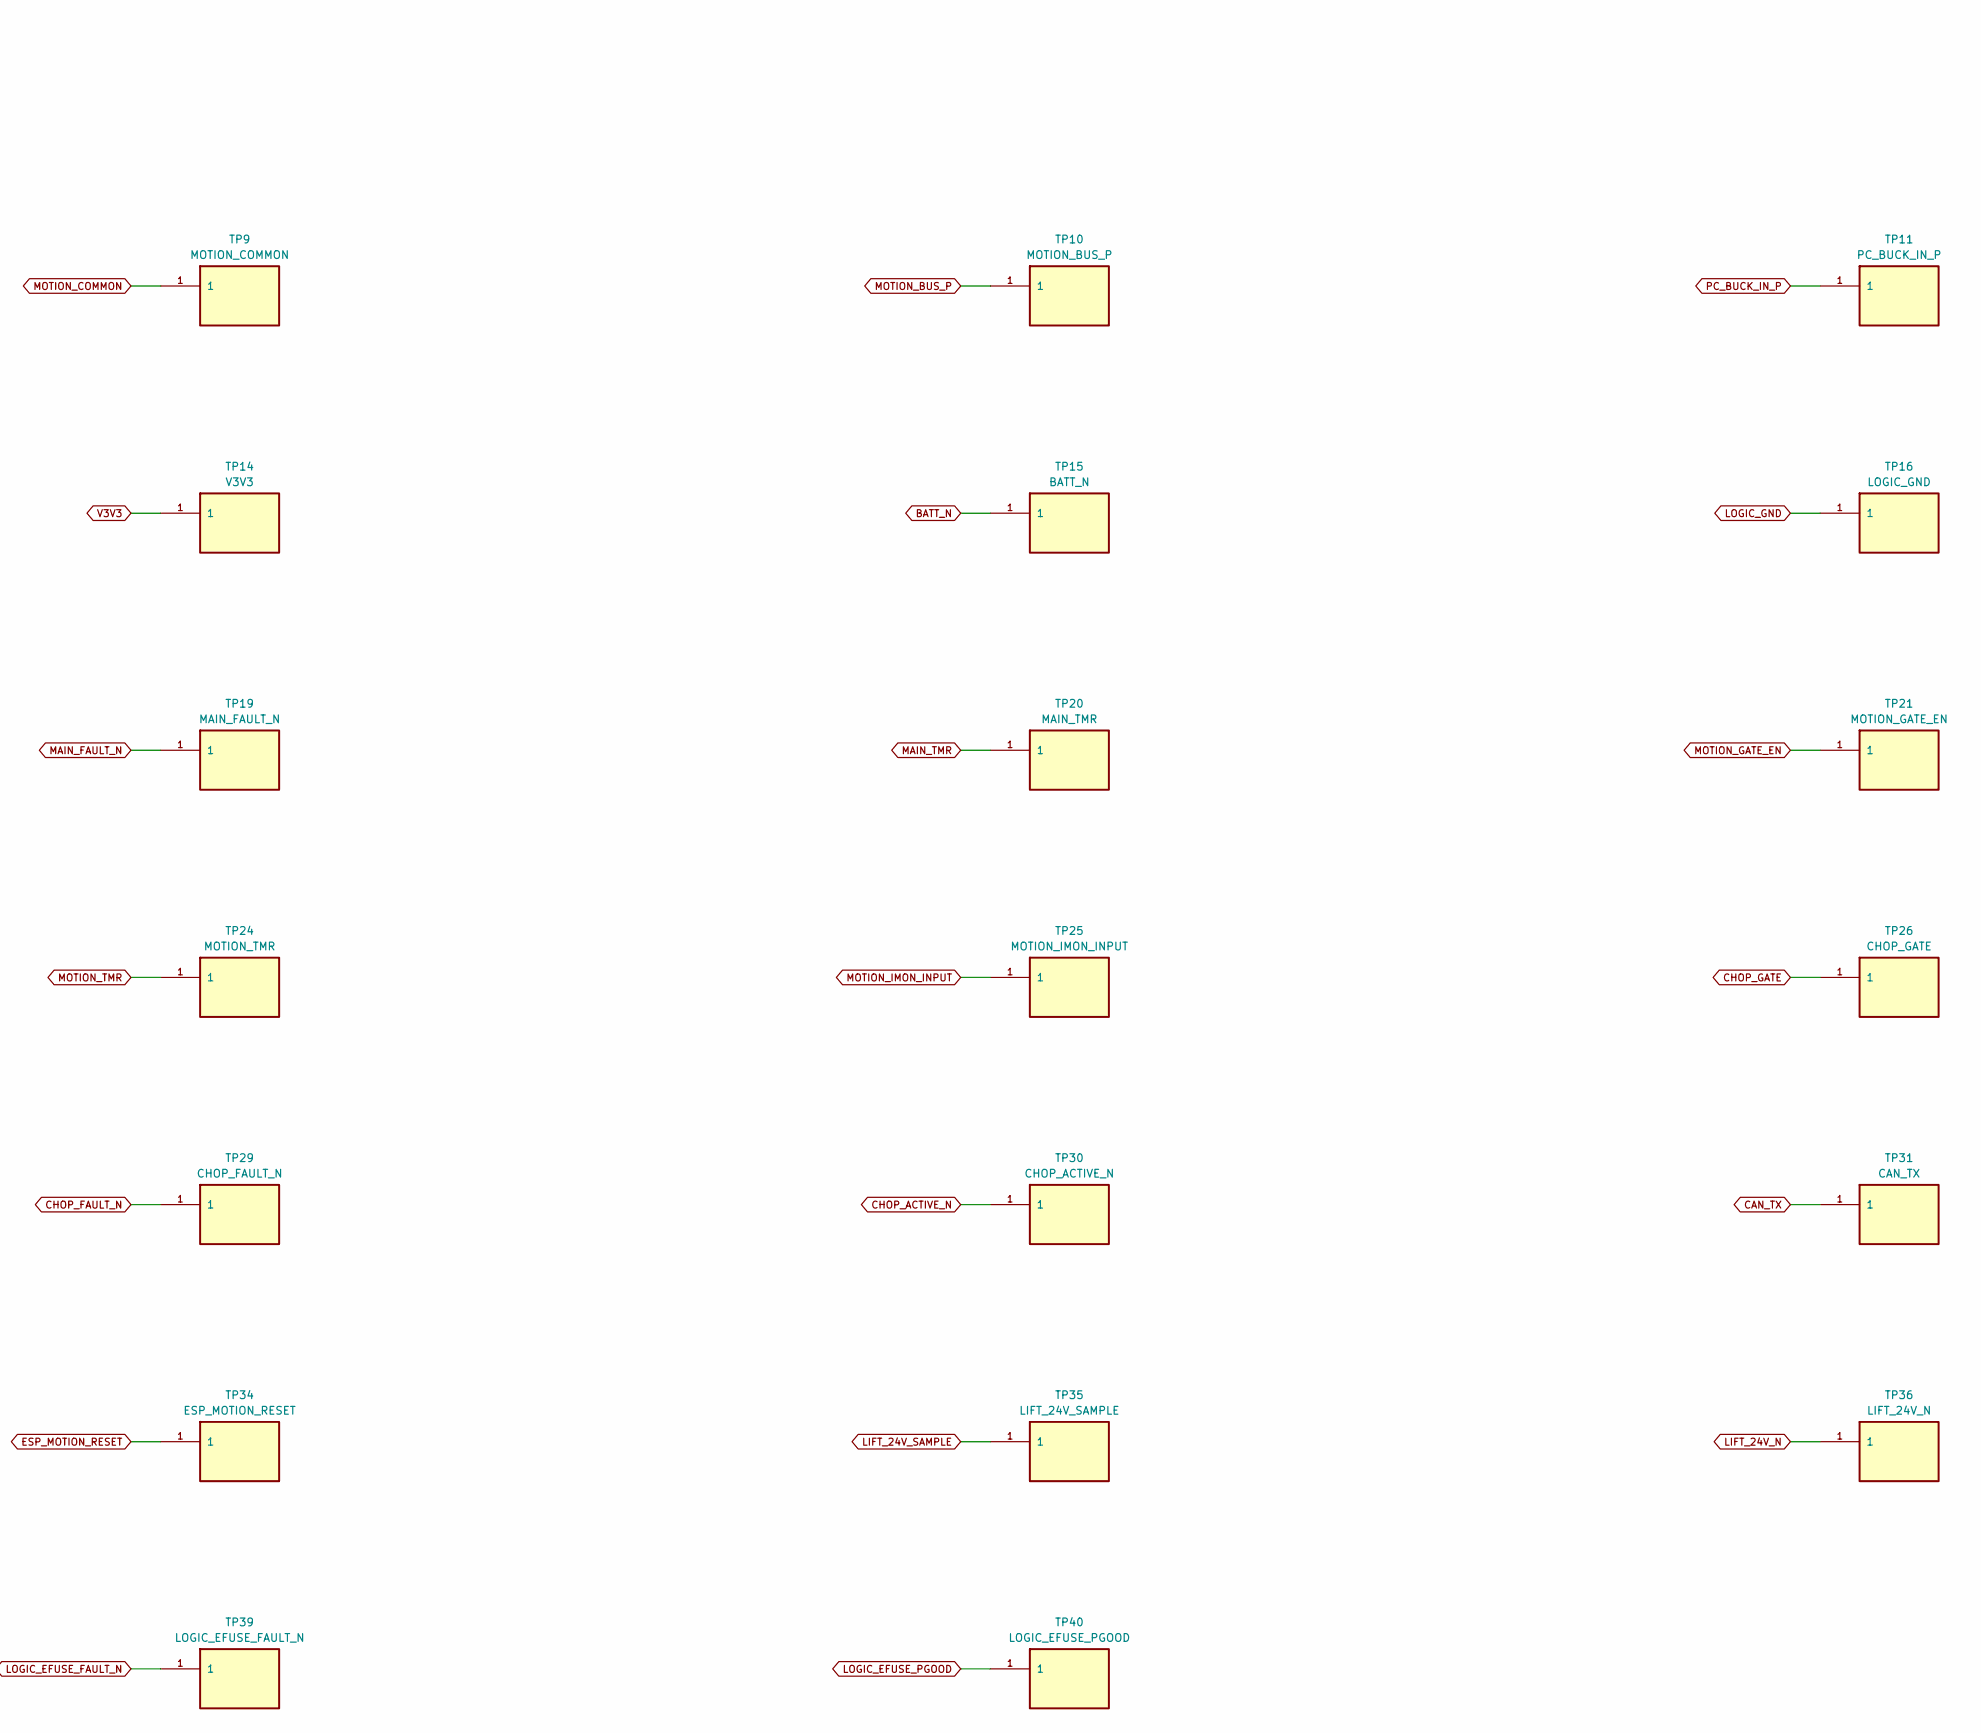
[picture p82: schematic 09b_star_and_measurements_p2.kicad_sch, PMU A / Star and test points / 2, part in row 1, column 2]

Parts:
TP7: MOTION_KELVIN_P; TestPoint_Pad_D2.0mm
TP8: MOTION_KELVIN_N; TestPoint_Pad_D2.0mm
TP9: MOTION_COMMON; TestPoint_Pad_D2.0mm
TP10: MOTION_BUS_P; TestPoint_Pad_D2.0mm
TP11: PC_BUCK_IN_P; TestPoint_Pad_D2.0mm
TP12: LOGIC_BUCK_IN_P; TestPoint_Pad_D2.0mm
TP13: V5V; TestPoint_Pad_D2.0mm
TP14: V3V3; TestPoint_Pad_D2.0mm
TP15: BATT_N; TestPoint_Pad_D2.0mm
TP16: LOGIC_GND; TestPoint_Pad_D2.0mm
TP17: AON_3V3; TestPoint_Pad_D2.0mm
TP18: AON_WAKE_EN; TestPoint_Pad_D2.0mm
TP19: MAIN_FAULT_N; TestPoint_Pad_D2.0mm
TP20: MAIN_TMR; TestPoint_Pad_D2.0mm
TP21: MOTION_GATE_EN; TestPoint_Pad_D2.0mm
TP22: MOTION_FLT_N; TestPoint_Pad_D2.0mm
TP23: MOTION_TEMP_FLT_N; TestPoint_Pad_D2.0mm
TP24: MOTION_TMR; TestPoint_Pad_D2.0mm
TP25: MOTION_IMON_INPUT; TestPoint_Pad_D2.0mm
TP26: CHOP_GATE; TestPoint_Pad_D2.0mm
TP27: CHOP_10V; TestPoint_Pad_D2.0mm
TP28: CHOP_REF2V5; TestPoint_Pad_D2.0mm
TP29: CHOP_FAULT_N; TestPoint_Pad_D2.0mm
TP30: CHOP_ACTIVE_N; TestPoint_Pad_D2.0mm
TP31: CAN_TX; TestPoint_Pad_D2.0mm
TP32: CAN_RX; TestPoint_Pad_D2.0mm
TP33: ESP_MAIN_HOLD; TestPoint_Pad_D2.0mm
TP34: ESP_MOTION_RESET; TestPoint_Pad_D2.0mm
TP35: LIFT_24V_SAMPLE; TestPoint_Pad_D2.0mm
TP36: LIFT_24V_N; TestPoint_Pad_D2.0mm
TP37: PC_EFUSE_FAULT_N; TestPoint_Pad_D2.0mm
TP38: PC_EFUSE_PGOOD; TestPoint_Pad_D2.0mm
TP39: LOGIC_EFUSE_FAULT_N; TestPoint_Pad_D2.0mm
TP40: LOGIC_EFUSE_PGOOD; TestPoint_Pad_D2.0mm

Connections:
AON_3V3: TP17.1; also elsewhere on the board
AON_WAKE_EN: TP18.1; also elsewhere on the board
BATT_N: TP15.1; also elsewhere on the board
CAN_RX: TP32.1; also elsewhere on the board
CAN_TX: TP31.1; also elsewhere on the board
CHOP_10V: TP27.1; also elsewhere on the board
CHOP_ACTIVE_N: TP30.1; also elsewhere on the board
CHOP_FAULT_N: TP29.1; also elsewhere on the board
CHOP_GATE: TP26.1; also elsewhere on the board
CHOP_REF2V5: TP28.1; also elsewhere on the board
ESP_MAIN_HOLD: TP33.1; also elsewhere on the board
ESP_MOTION_RESET: TP34.1; also elsewhere on the board
LIFT_24V_N: TP36.1; also elsewhere on the board
LIFT_24V_SAMPLE: TP35.1; also elsewhere on the board
LOGIC_BUCK_IN_P: TP12.1; also elsewhere on the board
LOGIC_EFUSE_FAULT_N: TP39.1; also elsewhere on the board
LOGIC_EFUSE_PGOOD: TP40.1; also elsewhere on the board
LOGIC_GND: TP16.1; also elsewhere on the board
MAIN_FAULT_N: TP19.1; also elsewhere on the board
MAIN_TMR: TP20.1; also elsewhere on the board
MOTION_BUS_P: TP10.1; also elsewhere on the board
MOTION_COMMON: TP9.1; also elsewhere on the board
MOTION_FLT_N: TP22.1; also elsewhere on the board
MOTION_GATE_EN: TP21.1; also elsewhere on the board
MOTION_IMON_INPUT: TP25.1; also elsewhere on the board
MOTION_KELVIN_N: TP8.1; also elsewhere on the board
MOTION_KELVIN_P: TP7.1; also elsewhere on the board
MOTION_TEMP_FLT_N: TP23.1; also elsewhere on the board
MOTION_TMR: TP24.1; also elsewhere on the board
PC_BUCK_IN_P: TP11.1; also elsewhere on the board
PC_EFUSE_FAULT_N: TP37.1; also elsewhere on the board
PC_EFUSE_PGOOD: TP38.1; also elsewhere on the board
V3V3: TP14.1; also elsewhere on the board
V5V: TP13.1; also elsewhere on the board

Notes on the sheet:
09b star and measurements p2

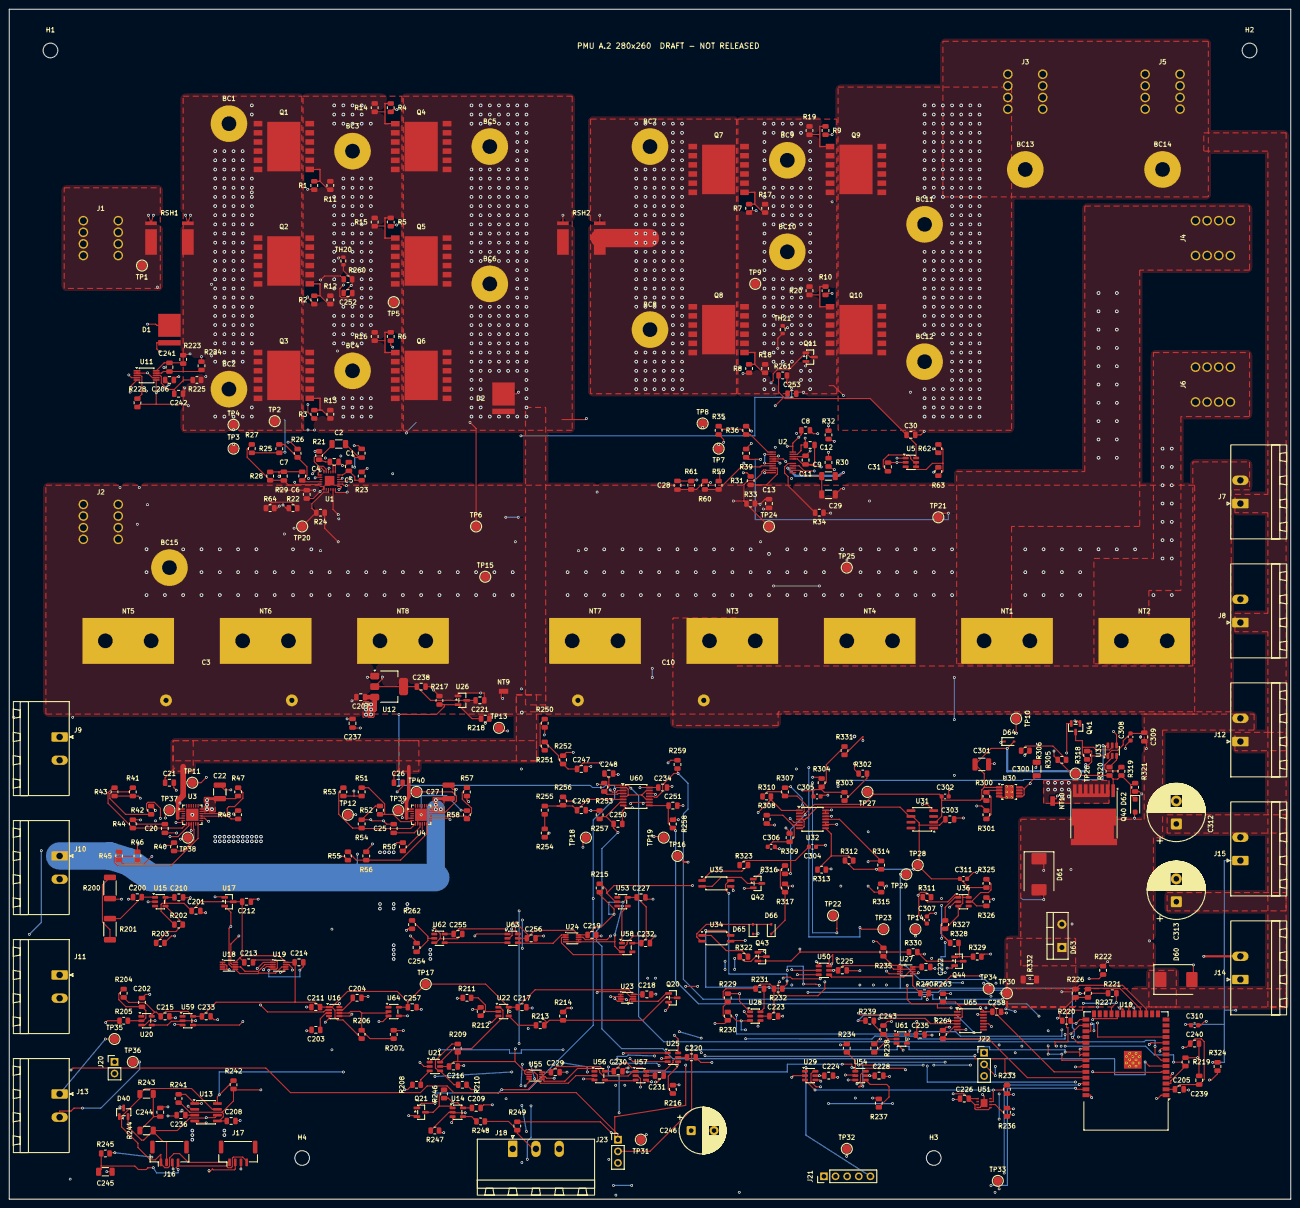
[picture p83: board HomeMy_PMU_RevA.kicad_pcb from above]

Board: 4 copper layers, 280.0 x 260.0 mm, 425 parts (0 on the bottom side), 194 nets.

Other parts of the board:
H1, H2, H3, H4: MountingHole_3.2mm_M3
