chris01-byte/HomeMy/hardware/power-management-unit/requirements.yaml

schema_version: 2
project: HomeMy
artifact: power_management_unit
revision: "0.2-rev-a"
date: "2026-09-10"
handoff_state: complete_rev_a_prototype_authorized

release_state:
  rev_a_engineering_prototype:
    schematic_and_layout_required: true
    fabrication_package_generation_allowed: true
    fabrication_order_requires_human_review: true
    production_use_allowed: false
  rev_b_production:
    release: false
    requires_rev_a_measurement_evidence: true

status_vocabulary:
  LOCKED: implement_as_written
  PROVISIONAL: implement_configurably_and_validate
  REV_A_DESIGN: astra_selects_calculates_and_documents_for_the_prototype
  REV_A_ASSUMPTION: use_a_conservative_configurable_prototype_choice_and_record_it
  REV_A_ENERGIZATION_GATE: does_not_block_pcb_design_but_must_be_closed_before_battery_power_is_applied
  REV_B_VALIDATION: measure_with_rev_a_and_close_before_production_release

source_precedence:
  - hardware/power-management-unit/requirements.yaml
  - hardware/power-management-unit/ASTRA_PCB_HANDOFF.md
  - hardware/power-management-unit/interfaces-and-layout.md
  - docs/decisions/2026-09-10-battery-monitor-and-power-architecture.md
  - contracts/hardware/customer-power-on.md
  - contracts/ros/system-lifecycle.md

battery:
  BAT-001:
    status: LOCKED
    chemistry: lithium_ion_10s7p
    nominal_voltage_v: 36.0
    maximum_voltage_v: 42.0
    bms_cutoff_voltage_v: 27.5
    capacity_ah: 17.5
    energy_wh: 630
  BAT-002:
    status: LOCKED
    maximum_continuous_discharge_a: 50
    advertised_peak_a: 150
    advertised_peak_duration_s: [1, 3]
    note: peak_is_not_a_normal_operating_target
  BAT-003:
    status: LOCKED
    regenerative_current_into_battery_allowed: false
    separate_charge_and_discharge_ports: true
  BAT-004:
    status: REV_A_ENERGIZATION_GATE
    external_main_fuse_nominal_a: 60
    minimum_dc_voltage_rating_v: 42
    preferred_dc_voltage_rating_v: 60
    required_evidence: exact_part_and_time_current_curve

topology:
  TOP-001:
    status: LOCKED
    positive_path:
      - external_60a_fuse
      - main_0p5_milliohm_shunt
      - lm74930_q1_back_to_back_switch
      - system_bus
  TOP-002:
    status: LOCKED
    system_bus_branches:
      - pc_tps26631
      - logic_5v_tps26631
      - tps48110_q1_motion_gate
  TOP-003:
    status: LOCKED
    motion_bus_branches:
      - left_arm_passive_output
      - right_arm_passive_output
      - two_ess23_drive_output
      - external_24v_lift_buck_input
      - independent_analog_brake_chopper
  TOP-004:
    status: LOCKED
    populated_precharge: false
    required_test: main_path_inrush
  TOP-005:
    status: LOCKED
    branch_melting_fuses: false
    only_melting_fuse: external_battery_60a
  TOP-006:
    status: LOCKED
    power_topology: star
    can_topology: linear_backbone
    high_current_return_through_logic_ground: false

main_monitor:
  MON-001:
    status: LOCKED
    device: INA228
    placement: high_side_after_main_fuse
    supply_voltage_v: 3.3
  MON-002:
    status: REV_A_DESIGN
    shunt_resistance_ohm: 0.0005
    connection: four_terminal_kelvin
    minimum_continuous_power_w: 10
    minimum_documented_pulse_energy_j: 34
    open_item: exact_part_and_footprint
  MON-003:
    status: PROVISIONAL
    shunt_range_mv: 163.84
    calculated_full_scale_a: 327.68
  MON-004:
    status: REV_A_DESIGN
    share_shunt_with_lm74930: candidate
    acceptance:
      - common_mode_valid
      - polarity_valid
      - filter_interaction_valid
      - trip_thresholds_valid
      - kelvin_routing_valid
      - fault_independence_valid

main_switch:
  MAIN-001:
    status: LOCKED
    controller: LM74930-Q1
    arrangement: back_to_back_nmos
    mosfets_per_bank: 3
    mosfet_voltage_rating_v: 100
    reverse_current_blocking: true
    fault_retry: deliberate_power_button_only
  MAIN-002:
    status: REV_A_DESIGN
    mosfet_exact_part: null
    target_rds_on_25c_milliohm_max: 1.5
    target_rds_on_hot_milliohm_max: 2.5
    required_proofs:
      - hot_resistance
      - soa
      - transient_thermal_impedance
      - gate_drive
      - turnoff_stress
      - availability
  MAIN-003:
    status: PROVISIONAL
    hardware_uv_trip_v: 29.0
    hardware_uv_delay_s: 0.5
    restart_recovery_voltage_v: 32.0
    input_ov_trip_range_v: [44.0, 45.0]
    overcurrent_trip_a: 65
    overcurrent_delay_s: 0.5
    short_circuit_trip_a: 120

motion_switch:
  MOT-001:
    status: LOCKED
    controller: TPS48110-Q1
    arrangement: back_to_back_nmos
    mosfets_per_bank: 2
    mosfet_voltage_rating_v: 100
    default_state: off
    hard_fault_retry: explicit_esp32_reset_only
  MOT-002:
    status: REV_A_DESIGN
    mosfet_exact_part: null
    target_rds_on_hot_milliohm_range: [2.0, 2.5]
    required_proofs:
      - hot_resistance
      - soa
      - transient_thermal_impedance
      - gate_drive
  MOT-003:
    status: REV_A_DESIGN
    shunt_resistance_ohm: 0.0005
    connection: four_terminal_kelvin
    minimum_continuous_power_w: 5
    open_item: exact_part_and_footprint
  MOT-004:
    status: REV_A_DESIGN
    overcurrent_trip_a: 60
    requested_delay_s: 0.5
    short_circuit_trip_a: 100
    rev_a_instruction: choose_a_reliable_configurable_hardware_delay_and_document_worst_case_tolerance
    rev_b_validation: coordinate_measured_motor_transients_with_fuse_bms_and_main_trip
  MOT-005:
    status: LOCKED
    per_arm_efuse: false
    per_arm_mosfet: false
    per_arm_shunt: false
    passive_outputs_after_common_gate: true

software_supervision:
  SW-001:
    status: PROVISIONAL
    current_actions:
      normal_max_a: 45
      warn_above_a: 45
      warn_delay_s: 1
      stop_above_a: 50
      stop_delay_s: 2
  SW-002:
    status: PROVISIONAL
    voltage_actions:
      warning_below_v: 33.0
      warning_delay_s: 10
      reject_tasks_below_v: 31.5
      reject_tasks_delay_s: 5
      shutdown_below_v: 30.5
      shutdown_delay_s: 5
  SW-003:
    status: LOCKED
    automatic_motion_after_restart: false
    automatic_restart_after_fault: false

brake_chopper:
  CHOP-001:
    status: PROVISIONAL
    location: across_motion_bus_on_motor_side_of_motion_switch
    control: independent_analog
    depends_on_esp32_firmware: false
    populated_branch_fuse: false
  CHOP-002:
    status: REV_A_ASSUMPTION
    resistor_configuration: two_10_ohm_100w_in_parallel
    effective_resistance_ohm: 5.0
    target_documented_bank_pulse_energy_j_min: 500
    current_at_43v_a: 8.6
    instantaneous_power_at_43v_w: 369.8
    mounting: external_metal_chassis_heat_spreader
    rev_b_required_evidence:
      - measured_regenerative_energy
      - resistor_pulse_curve
      - repetition_rate
      - chassis_thermal_test
  CHOP-003:
    status: REV_A_DESIGN
    mosfet_voltage_rating_v: 100
    mosfet_exact_part: null
    comparator_reference_driver_exact_parts: null
    ntc_exact_part: null
  CHOP-004:
    status: PROVISIONAL
    off_below_v: 42.4
    on_at_v: 43.0
    warning_at_v: 43.5
    controlled_stop_at_v: 45.0
    hardware_motion_off_at_v: 46.0
  CHOP-005:
    status: PROVISIONAL
    local_24v_lift_clamp_populated: false
    provide_dnp_connector_or_testpoint: true
    required_test: measure_24v_bus_during_lowering_and_deceleration

computer_branch:
  PC-001:
    status: LOCKED
    efuse: TPS26631
    external_buck_claimed_input_range_v: [8, 55]
    planned_output_voltage_v: 12
    dedicated_current_sensor: false
  PC-002:
    status: LOCKED
    battery_side_power_budget_w: 65
    enforcement: linux_bios_cpu_power_configuration
    basic_measured_battery_side_power_w: 25
    measured_condition: ubuntu_only_no_ros_no_discrete_gpu
  PC-003:
    status: PROVISIONAL
    allowed_input_current_near_low_battery_a: 3.0
    note: efuse_protects_harness_not_precision_65w_limit
  PC-004:
    status: REV_B_VALIDATION
    required_module_tests:
      - startup_inrush
      - current_limit
      - efficiency
      - thermal
      - low_battery
      - transient

logic_5v_branch:
  LOGIC-001:
    status: LOCKED
    efuse: TPS26631
    converter: external
    output_voltage_v: 5.0
    minimum_continuous_output_current_a: 5.0
    software_current_limit_required: false
  LOGIC-002:
    status: REV_A_ASSUMPTION
    exact_converter_and_pinout: null
    required_module_tests:
      - startup_inrush
      - current_limit
      - efficiency
      - thermal
      - low_battery
      - transient
  LOGIC-003:
    status: PROVISIONAL
    led_family: [WS2812B, SK6812]
    level_shifter_class: 74AHCT125
    data_series_resistor_ohm_range: [220, 330]
    local_bulk_capacitance_uf: 1000
    bulk_capacitor_minimum_voltage_v: 10

lift_24v_branch:
  LIFT-001:
    status: LOCKED
    converter: external
    input_voltage_preferred_v: [20, 60]
    output_voltage_v: 24.0
    purchased_label_target_a: 10
    planned_continuous_use_a_range: [4, 5]
    simultaneous_ess17_count: 2
  LIFT-002:
    status: LOCKED
    branch_efuse: false
    protection: converter_internal_ocp_plus_common_motion_gate
  LIFT-003:
    status: REV_A_ASSUMPTION
    exact_converter_and_pinout: null

controller_and_io:
  CTRL-001:
    status: REV_A_DESIGN
    controller_family: ESP32-S3-WROOM-1
    exact_flash_psram_antenna_variant: null
    approach: module_not_bare_rf
  CTRL-002:
    status: LOCKED
    off_state_powered:
      - battery_bms
      - lm74930_shutdown_domain
      - low_iq_hardware_wake_latch
    off_state_unpowered:
      - esp32
      - led_strip
      - linux_pc
      - regular_5v_converter
  CTRL-003:
    status: REV_A_DESIGN
    wake_self_hold_circuit_exact_parts: null
    required_behaviors:
      - momentary_press_starts
      - esp32_takes_self_hold
      - short_press_requests_controlled_shutdown
      - long_press_forces_shutdown
      - no_automatic_restart
      - motion_remains_off_during_transitions
  CTRL-004:
    status: LOCKED
    permanent_external_display: false
    customer_indicator: addressable_led_strip
    development_display: hdmi_to_linux_pc
  CTRL-005:
    status: LOCKED
    hardware_motion_inhibit_input: required
    open_or_unpowered_state: motion_off
    customer_facing_master_switch: false
    final_product_stop_architecture: REV_B_VALIDATION

communications:
  COM-001:
    status: LOCKED
    bus: classical_can
    bitrate_bps: 1000000
    participants:
      robstride_joints: 12
      power_controller: 1
    planned_joint_rate_hz: 100
    measured_bus_load_target_percent_max: 50
  COM-002:
    status: LOCKED
    topology: linear_backbone
    termination_ohm: 120
    termination_count: 2
    usb_can_adapter: external_isolated
  COM-003:
    status: REV_A_DESIGN
    can_transceiver_exact_part: null
    esd_and_shield_strategy: null
  COM-004:
    status: LOCKED
    onboard_rs485_transceivers: false
    external_isolated_usb_rs485_buses:
      drive_ess23_bus: 1
      lift_ess17_bus: 1

mechanical_and_layout:
  PCB-001:
    status: PROVISIONAL
    layers: 4
    outer_copper_oz: 2
    inner_copper_oz: 1
  PCB-002:
    status: LOCKED
    high_current_strategy:
      - broad_outer_layer_pours
      - dense_via_arrays
      - calculated_copper_strip_or_busbar
    ordinary_trace_only_for_45_to_60a: false
  PCB-003:
    status: LOCKED
    high_current_terminals_minimum_design_current_a: 70
    battery_wire_mm2: 6.0
    arm_wire_mm2: 4.0
    xt_series_final_product_connector: false
  PCB-004:
    status: REV_A_ASSUMPTION
    rev_a_instruction: choose_a_generous_bench_prototype_outline_and_document_all_provisional_dimensions
    rev_b_inputs:
      - board_outline
      - mounting_holes
      - maximum_component_height
      - connector_exit_directions
      - enclosure_airflow
      - busbar_geometry
      - chassis_heat_spreader_interface
      - service_access
  PCB-005:
    status: REV_A_DESIGN
    arm_connector_candidate: Molex_Mega-Fit_2pin
    target_continuous_current_per_arm_a_max: 25
    rev_a_required_evidence:
      - exact_contact_housing
      - wire_gauge_derating
      - ambient_derating
      - conservative_25a_design_basis_or_higher_current_connector
    rev_b_validation: measured_or_enforced_arm_current_and_temperature
  PCB-006:
    status: REV_A_DESIGN
    chopper_connector_candidate: Molex_Micro-Fit_3.0_2pin
    pulse_current_a: 8.6
    rev_a_required_evidence: exact_contact_wire_and_datasheet_pulse_derating
    rev_b_validation: measured_connector_temperature_at_approved_pulse_pattern

rev_a_design_completion_requirements:
  - MON-002
  - MON-004
  - MAIN-002
  - MOT-002
  - MOT-003
  - MOT-004
  - CHOP-003
  - CTRL-001
  - CTRL-003
  - COM-003
  - PCB-005
  - PCB-006
  - exact_tps26631_limits_and_retry_modes
  - tvs_transient_coordination
  - CTRL-005
  - conservative_external_converter_connector_pinout_assumptions
  - documented_provisional_board_mechanics

rev_a_energization_gates:
  - BAT-004
  - external_current_limited_bench_supply_for_initial_bringup
  - reachable_service_disconnect_before_actuator_testing

rev_b_production_validation_gates:
  - measured_main_inrush_and_no_precharge_confirmation
  - measured_regenerative_energy_and_chopper_thermal_margin
  - measured_24v_lift_bus_regeneration
  - measured_pc_5v_and_24v_converter_behavior
  - measured_per_arm_current_and_connector_temperature
  - measured_fuse_bms_main_and_motion_selectivity
  - final_enclosure_board_outline_mounting_airflow_and_heat_spreader
  - final_harness_and_connector_derating
  - final_emergency_stop_and_motion_safety_architecture
