chris01-byte/HomeMy/(commit log)

2026-08-28 docs: define lidar commissioning contract
2026-08-28 chore: route drivebase and lidar context
2026-08-28 docs: record OAK 4D obstacle decision
    Updated the Current State document to include local obstacle protection details and refined the scope of various components.
2026-08-28 docs: record local OAK transfer boundary
    Added documentation for the local OAK 4D obstacle-protection boundary and updated the description of the Local OAK camera foundation.
2026-08-28 docs: define OAK 4D transfer limits
    Updated the document to reflect changes in the hardware foundation candidates, including the addition of 4D depth obstacle protection for the OAK camera and clarifications on the HomeMy navigation and safety commissioning contract.
2026-09-10 docs: record battery monitor and power architecture
2026-09-10 docs: prepare Astra power PCB handoff
2026-09-10 docs: rename power subsystem to PMU
2026-09-10 docs: enable PMU Rev A prototype handoff
2026-09-10 Specify PMU Rev A circuits and calculation evidence
    [schematic-readability-review.json]
2026-09-10 Implement routed four-layer PMU Rev A KiCad design
    [02_main_switch_lm74930.kicad_sch, 03_motion_gate_tps48110.kicad_sch, 04_brake_chopper_p1.kicad_sch, 04_brake_chopper_p2.kicad_sch, 05_pc_and_5v_efuses.kicad_sch, 06a_aon_wake_p1.kicad_sch, 06a_aon_wake_p2.kicad_sch, 06b_motion_latches.kicad_sch]
2026-09-10 Record PMU Rev A manufacturing outputs and final validation
    [HomeMy_PMU_RevA-B_Cu.gbr, HomeMy_PMU_RevA-B_Mask.gbr, HomeMy_PMU_RevA-B_Paste.gbr, HomeMy_PMU_RevA-B_SilkS.gbr, HomeMy_PMU_RevA-Edge_Cuts.gbr, HomeMy_PMU_RevA-F_Cu.gbr, HomeMy_PMU_RevA-F_Mask.gbr, HomeMy_PMU_RevA-F_Paste.gbr]
2026-09-10 Ignore local KiCad history repository
2026-09-10 Release PMU Rev A-P1 prototype package with enforced power rules
    [CONNECTOR_PINOUT.csv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]
2026-09-10 Make prototype package references usable outside the repository
2026-09-11 Record bounded PMU Rev A.1 shrink attempt and failed size gates
    [02_main_switch_lm74930.kicad_sch, 03_motion_gate_tps48110.kicad_sch, 04_brake_chopper_p1.kicad_sch, 04_brake_chopper_p2.kicad_sch, 05_pc_and_5v_efuses.kicad_sch, 06a_aon_wake_p1.kicad_sch, 06a_aon_wake_p2.kicad_sch, 06b_motion_latches.kicad_sch]
2026-09-11 Preserve bounded 280x220 PMU WIP with completed critical paths
    [HomeMy_PMU_RevA_280x220.kicad_pcb, HomeMy_PMU_RevA_280x220.kicad_sch]
2026-09-11 Save bounded 280x220 PMU rebuild as unorderable WIP
    Preserve the original Rev-A topology and frozen power rules in a separate new layout. Close the six-cycle attempt with 293 open connections, 247/247 required power pairs and 46/46 critical paths. Record native checks, unresolved width variability, mechanical limits and the aborted digital-router run. All releases remain false.
    [02_main_switch_lm74930.kicad_sch, 03_motion_gate_tps48110.kicad_sch, 04_brake_chopper_p1.kicad_sch, 04_brake_chopper_p2.kicad_sch, 05_pc_and_5v_efuses.kicad_sch, 06a_aon_wake_p1.kicad_sch, 06a_aon_wake_p2.kicad_sch, 06b_motion_latches.kicad_sch]
2026-09-12 Add bounded Astra completion plan for 280x220 PMU rebuild
    Authorize one finite finishing pass from the validated rebuild checkpoint. Freeze the board size and accepted power/critical paths, prioritize remaining routing and DRC closure, require deterministic native checks, and define hard time, cycle, router, regression, release and reporting limits.
2026-09-13 Clean PMU workspace and define canonical 300x280 layout
    [02_main_switch_lm74930.kicad_sch, 03_motion_gate_tps48110.kicad_sch, 04_brake_chopper_p1.kicad_sch, 04_brake_chopper_p2.kicad_sch, 05_pc_and_5v_efuses.kicad_sch, 06a_aon_wake_p1.kicad_sch, 06a_aon_wake_p2.kicad_sch, 06b_motion_latches.kicad_sch]
2026-09-13 Add PMU 300x280 A1 layout WIP and verified stop report
    [02_main_switch_lm74930.kicad_sch, 03_motion_gate_tps48110.kicad_sch, 04_brake_chopper_p1.kicad_sch, 04_brake_chopper_p2.kicad_sch, 05_pc_and_5v_efuses.kicad_sch, 06a_aon_wake_p1.kicad_sch, 06a_aon_wake_p2.kicad_sch, 06b_motion_latches.kicad_sch]
2026-09-13 Add PMU Rev A2 280x260 checked WIP layout and final evidence
    [02_main_switch_lm74930.kicad_sch, 03_motion_gate_tps48110.kicad_sch, 04_brake_chopper_p1.kicad_sch, 04_brake_chopper_p2.kicad_sch, 05_pc_and_5v_efuses.kicad_sch, 06a_aon_wake_p1.kicad_sch, 06a_aon_wake_p2.kicad_sch, 06b_motion_latches.kicad_sch]
2026-09-13 hardware: advance PMU A2 routing and verify remaining WIP
    [HomeMy_PMU_RevA.kicad_pcb, REV_A_BOM.csv, REV_A_EXTERNAL_BOM.csv]
2026-09-13 Close remaining PMU A2 280x260 nets and pass native CAD checks
    Preserve source topology, placement and rules. Record two identical clean native suites with 247 power pairs and 46 critical paths, and add a clearly unreleased manufacturing draft. Keep all release flags false: locked Mac blocks final graphical reopen verification, and physical production qualification is still open.
    [DRAFT_SMD_positions.csv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]
